GET-RAHS/2022-2024_Sockeye/Solar Car 2022-2024/New Suspension/Rear Suspension/PerformanceLog.txt

Number of Contacts: 0
Number of contact data: 0
