GET-RAHS/2022-2024_Sockeye/Solar Car 2022-2024/Wheels/Nomura hubs.pdf

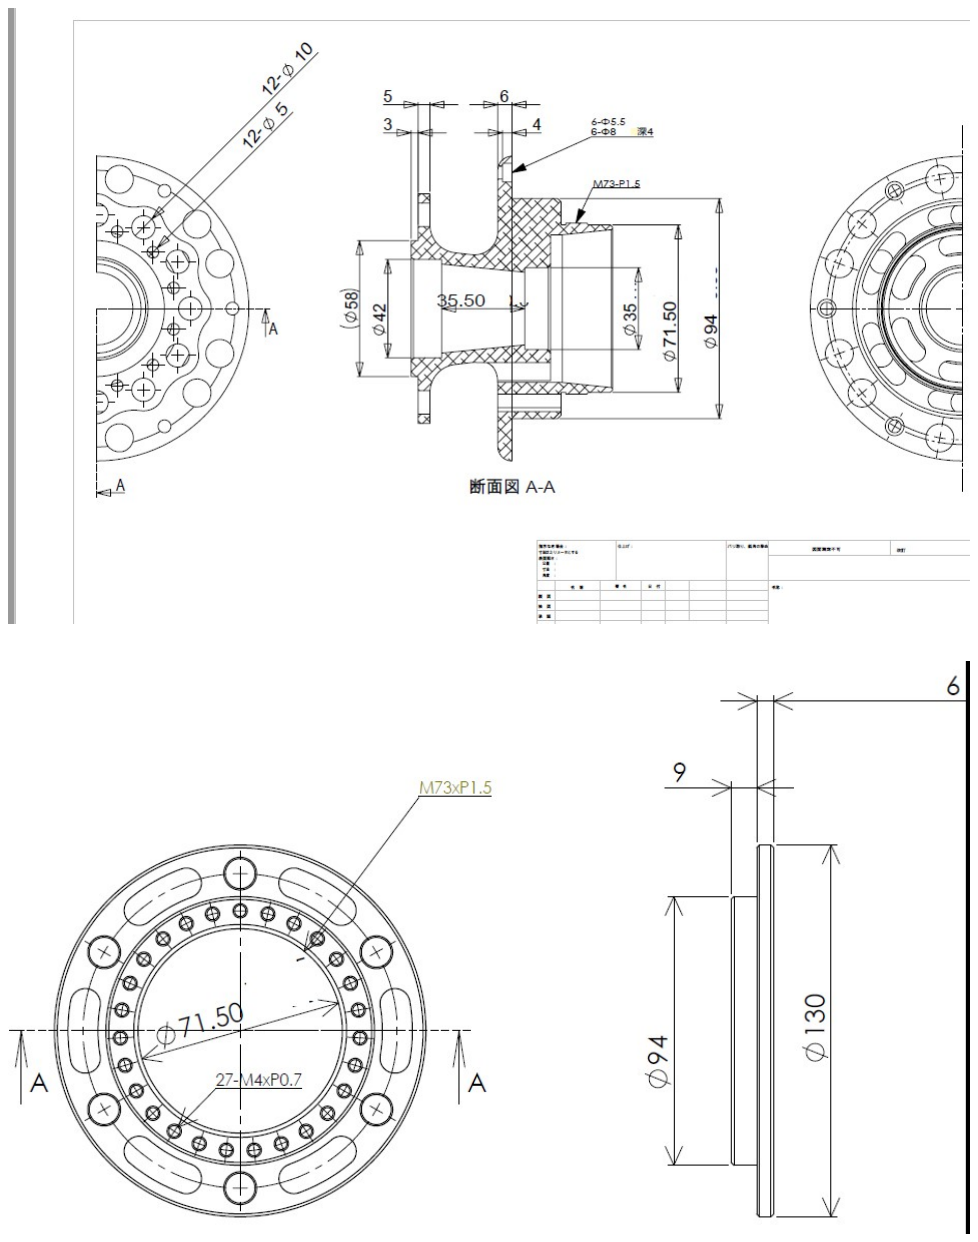
[picture p3: page 1]

standard spindle
Using bearing : outer side is 6003ZZ / inner side is 6004ZZ

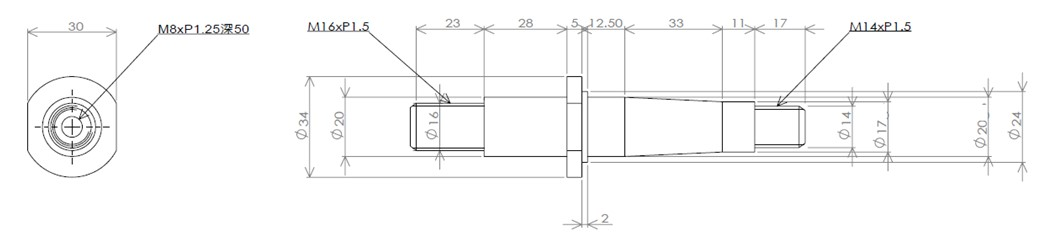
[picture p4: figure]

bigger type spindle
Using bearing : outer side is 6003ZZ / inner side is 6905ZZ

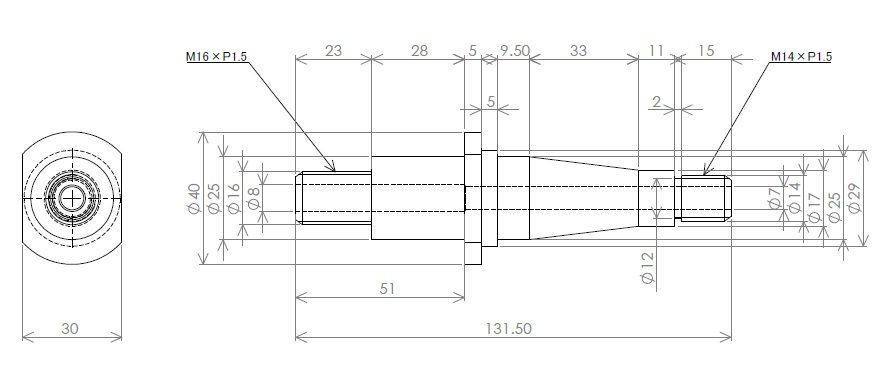
[picture p5: figure]
