GET-RAHS/2022-2024_Sockeye/Solar Car 2022-2024/SolarPanels/tape holes.pdf

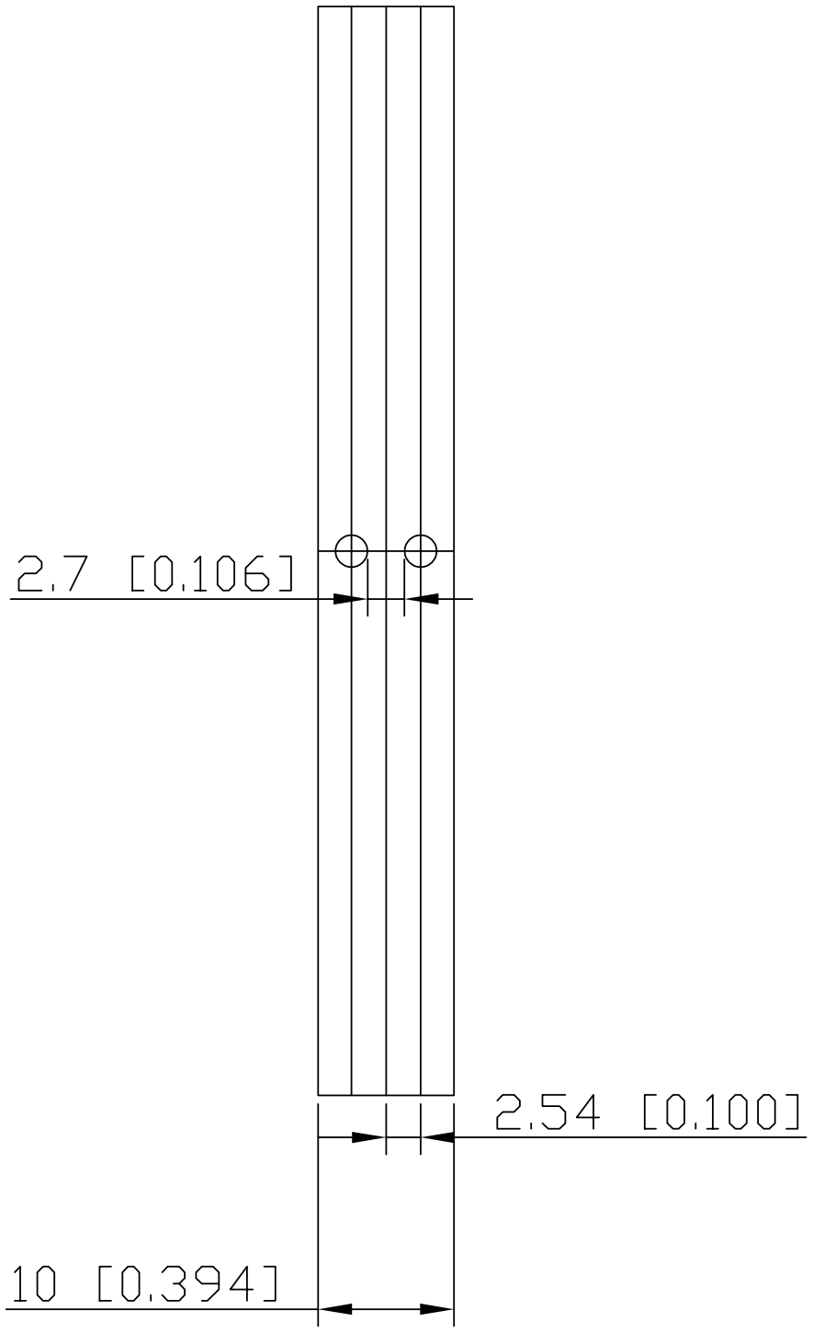
[picture p6: figure]
