GET-RAHS/2022-2024_Sockeye/Solar Car 2022-2024/Frame/carbon angles.pdf

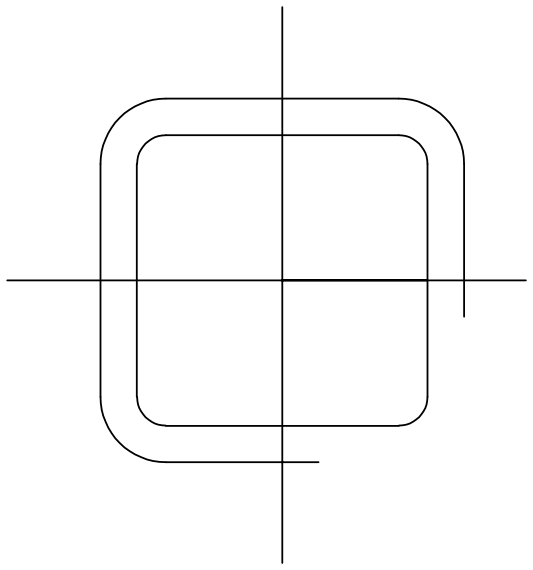
[picture p7: figure]
