GET-RAHS/2022-2024_Sockeye/Solar Car 2022-2024/Stay Hinge/mid.pdf

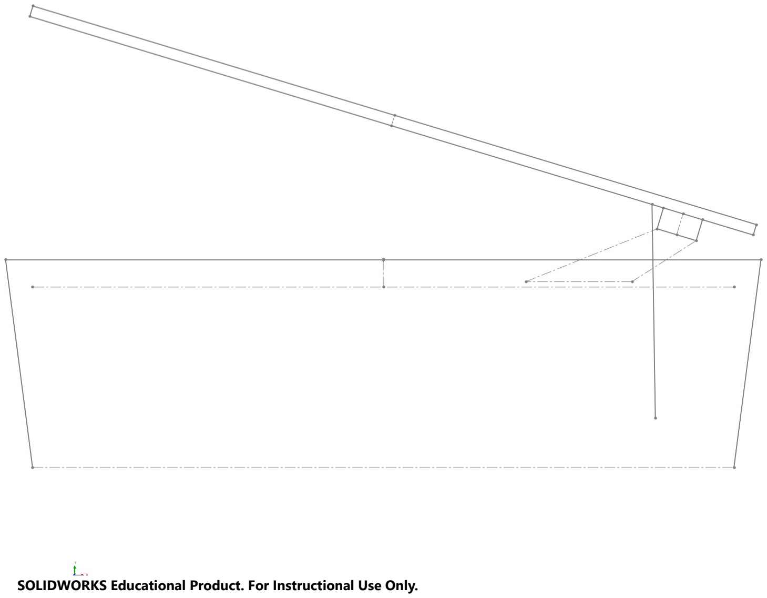
[picture p9: page 1]

SOLIDWORKS Educational Product. For Instructional Use Only.
