GET-RAHS/2022-2024_Sockeye/Solar Car 2022-2024/Stay Hinge/open nd.pdf

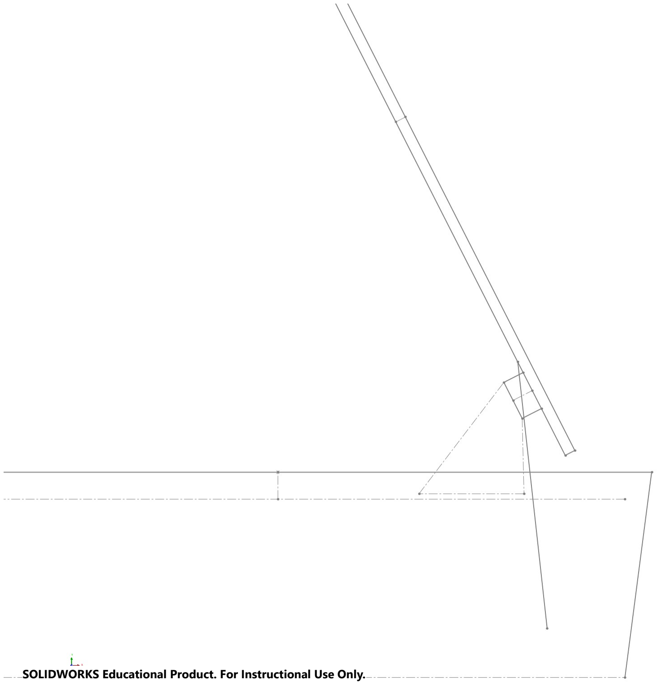
[picture p10: page 1]

SOLIDWORKS Educational Product. For Instructional Use Only.
