GET-RAHS/2022-2024_Sockeye/Solar Car 2022-2024/Wheels/Wheels2023/Rim 13.2 image.pdf

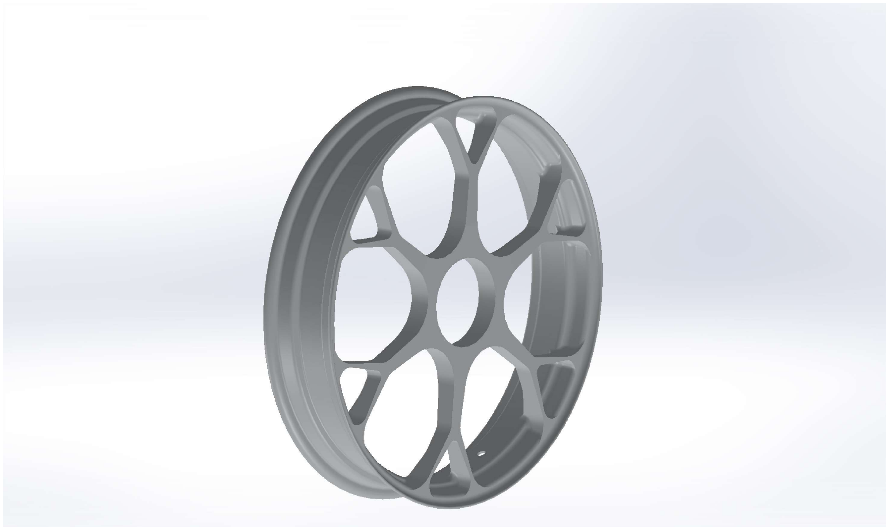
[picture p12: page 1]
