GET-RAHS/2022-2024_Sockeye/Solar Car 2022-2024/New Suspension/Front Suspension/Assy7/Assy dimensions.pdf

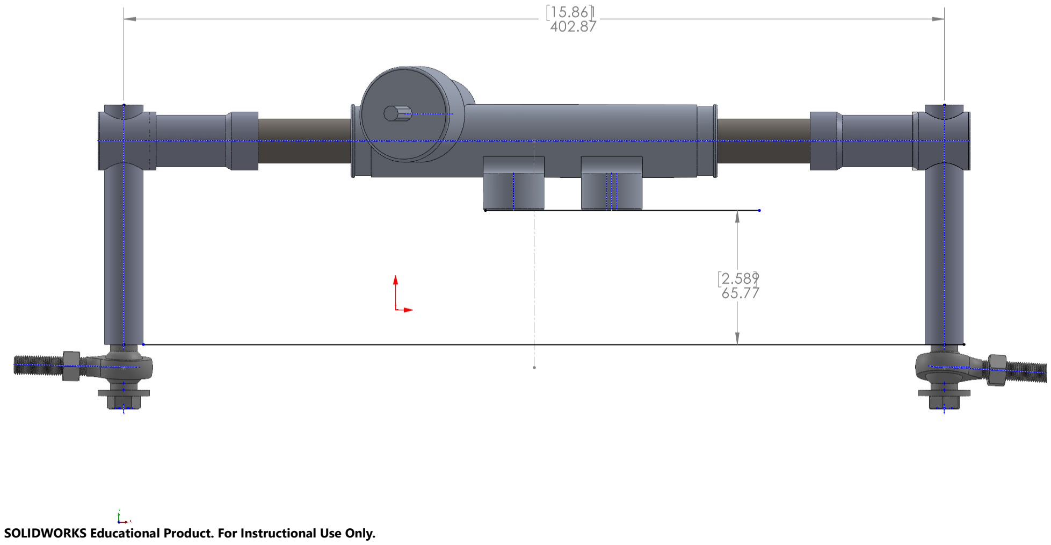
[picture p13: page 1]

SOLIDWORKS Educational Product. For Instructional Use Only.
