GET-RAHS/2022-2024_Sockeye/Solar Car 2022-2024/Pictures/FrontSuspAS1.JPG

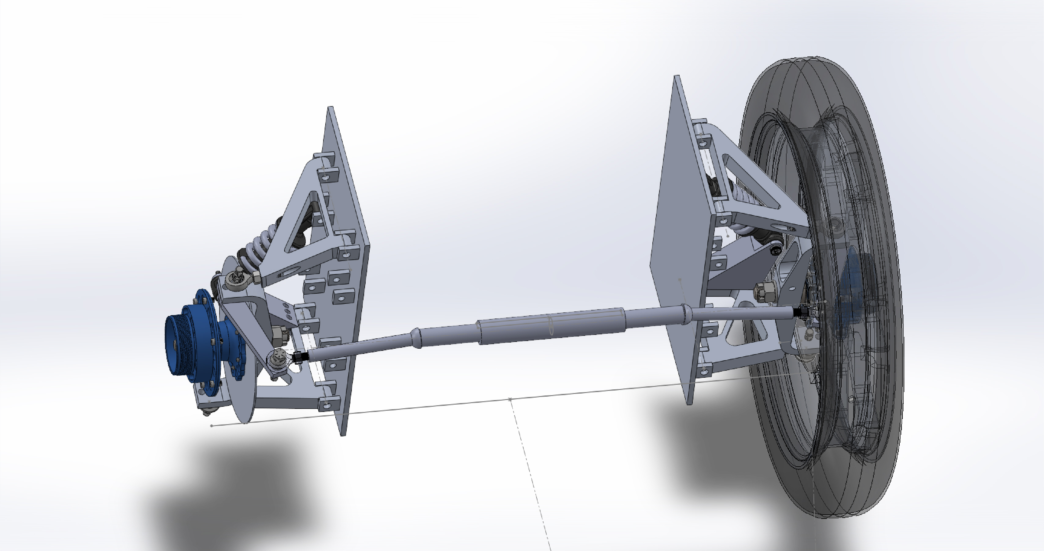
Solar Car 2022-2024/Pictures/FrontSuspAS1.JPG
