GET-RAHS/2022-2024_Sockeye/Solar Car 2022-2024/Pictures/Solar.JPG

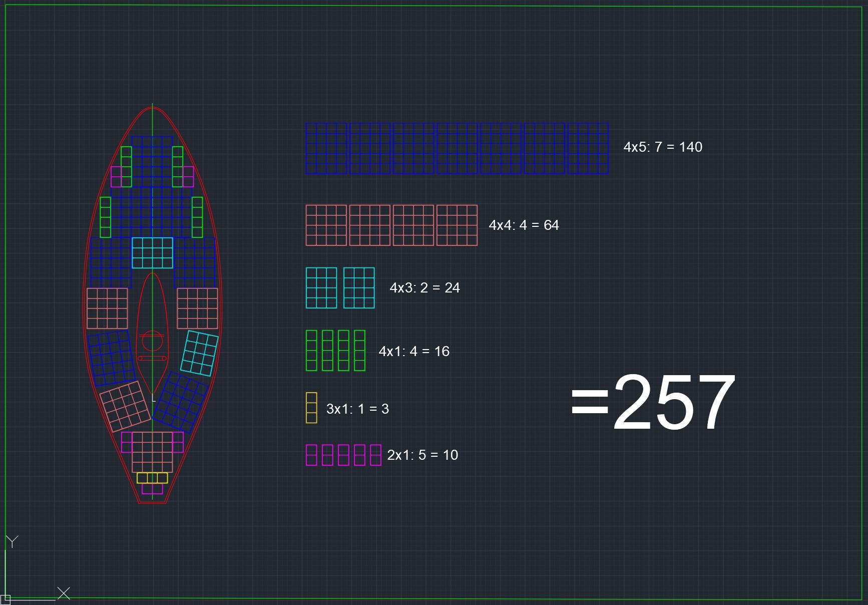
Solar Car 2022-2024/Pictures/Solar.JPG
