GET-RAHS/2022-2024_Sockeye/Solar Car 2022-2024/Progressive steering/Alain Model (Concept)/progressive steering-2/messages_0.jpeg

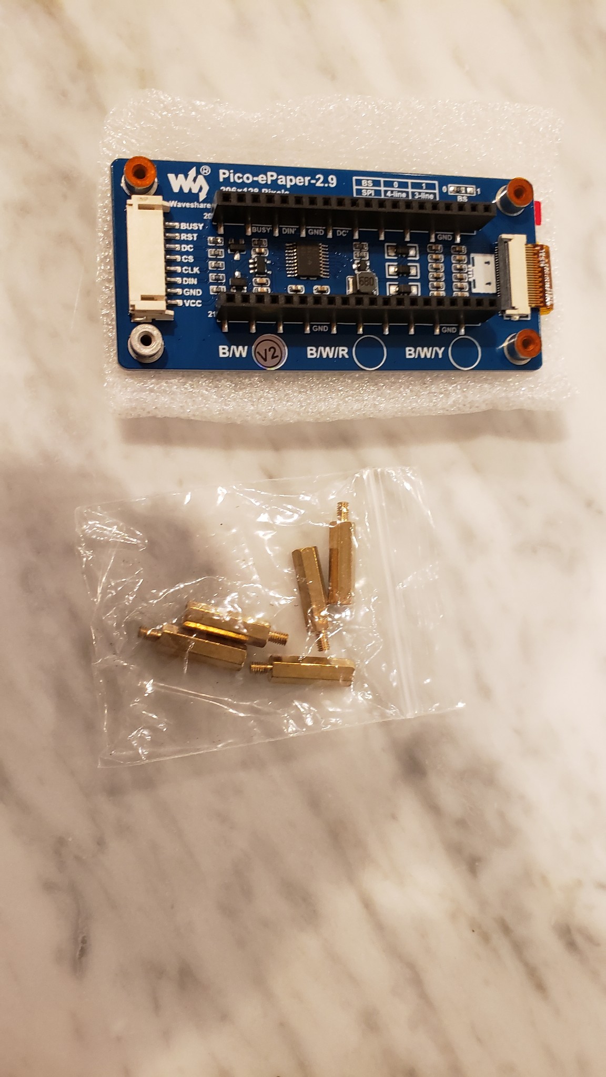
Solar Car 2022-2024/Progressive steering/Alain Model (Concept)/progressive steering-2/messages_0.jpeg
