GET-RAHS/2022-2024_Sockeye/Solar Car 2022-2024/Wheels/mitsuba.jpg

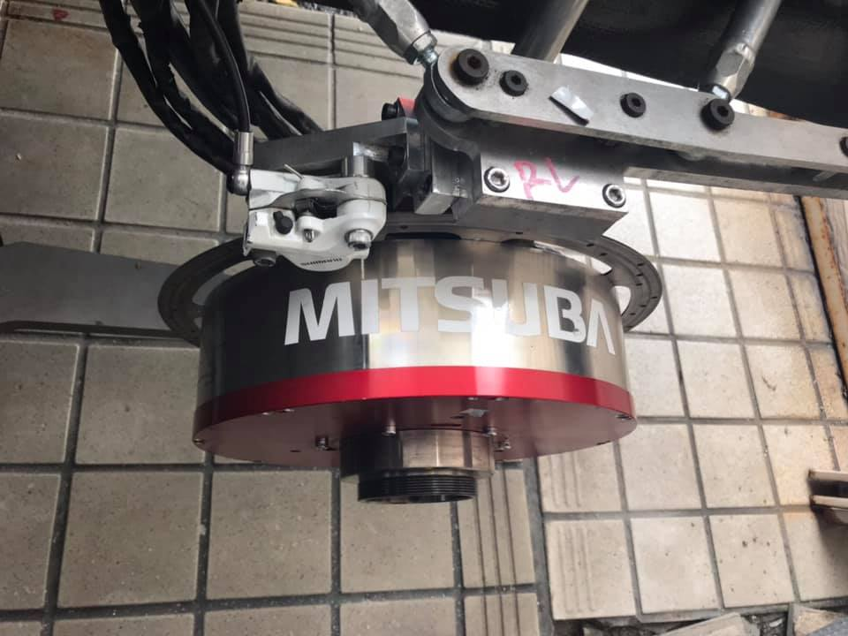
Solar Car 2022-2024/Wheels/mitsuba.jpg
