GET-RAHS/2022-2024_Sockeye/Solar Car 2022-2024/Wheels/Nomura Hubs Replications Hagen/Nomura hubs-images/0002.jpg

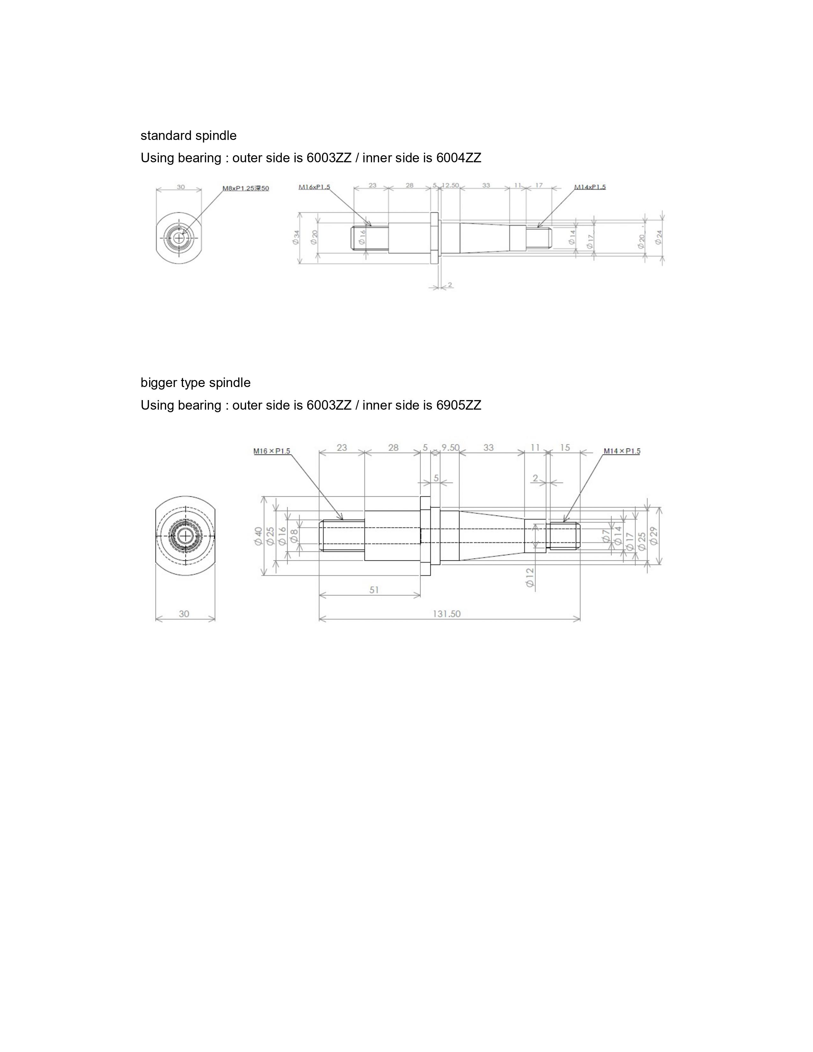
Solar Car 2022-2024/Wheels/Nomura Hubs Replications Hagen/Nomura hubs-images/0002.jpg
