GET-RAHS/2022-2024_Sockeye/Solar Car 2022-2024/Wheels/TwenteWheel.png

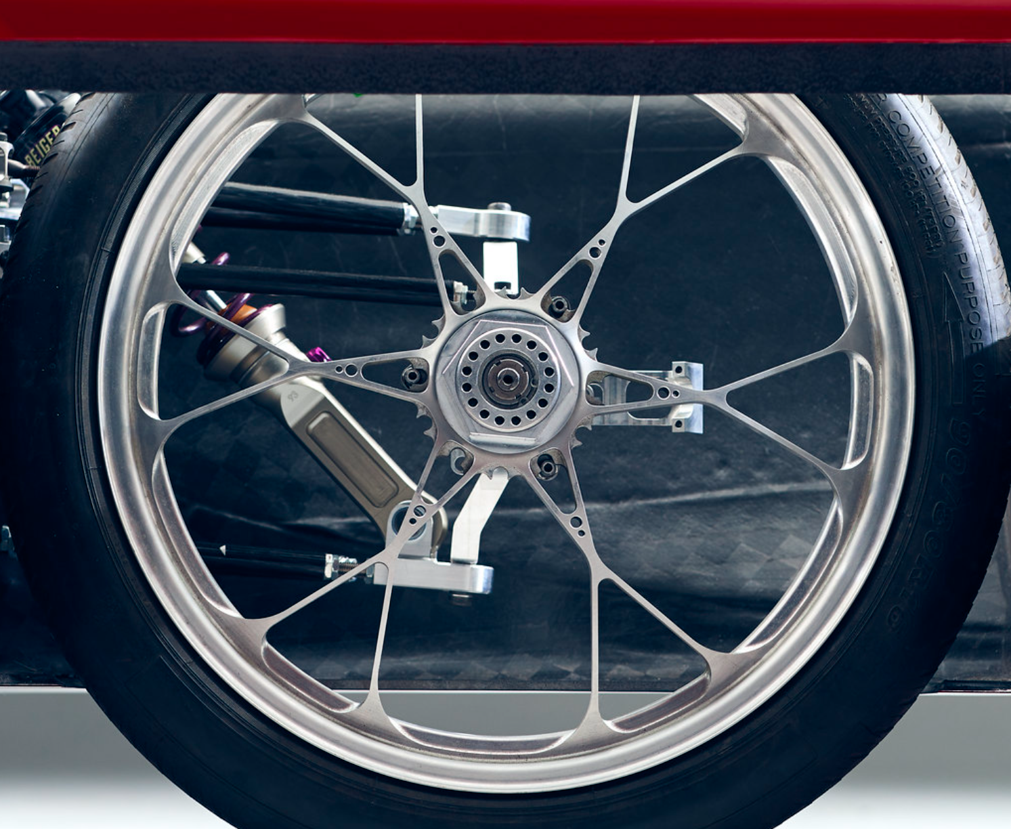
Solar Car 2022-2024/Wheels/TwenteWheel.png
