GET-RAHS/2022-2024_Sockeye/Solar Car 2022-2024/Parts To Be Machined/Order #1/Drawings/topview.pdf

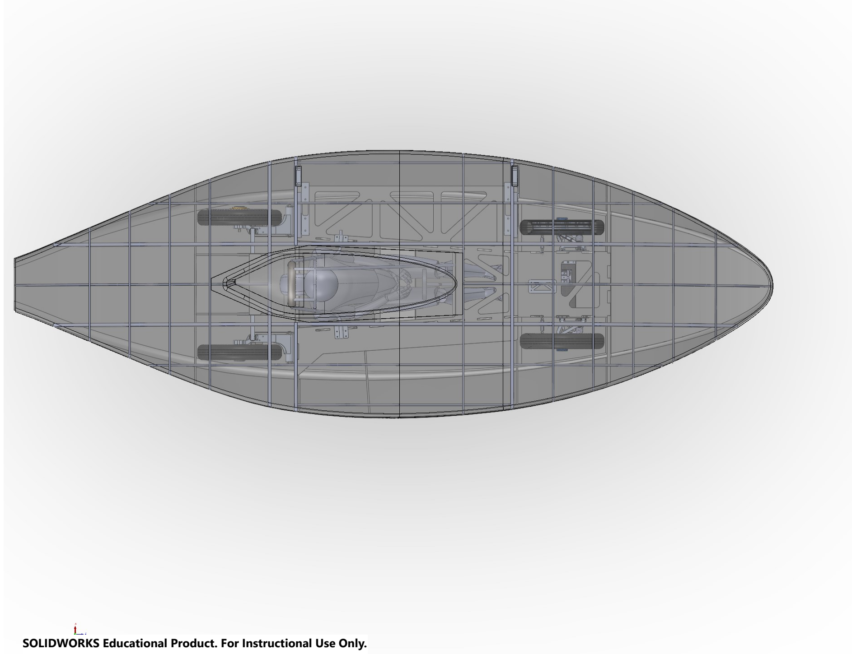
[picture p28: page 1]

SOLIDWORKS Educational Product. For Instructional Use Only.
