GET-RAHS/2022-2024_Sockeye/Solar Car 2022-2024/Parts To Be Machined/Carbon Board Cut/20230208_160809.jpg

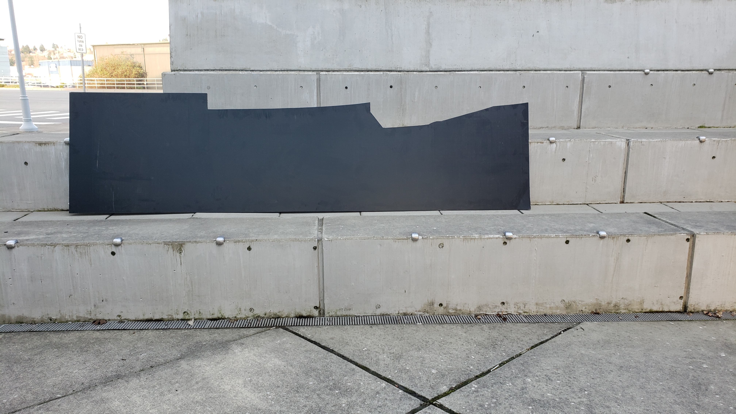
Solar Car 2022-2024/Parts To Be Machined/Carbon Board Cut/20230208_160809.jpg
