GET-RAHS/2022-2024_Sockeye/Solar Car 2022-2024/Parts To Be Machined/Order #1/Drawings/PDF Images/topviewf58c80f2.png

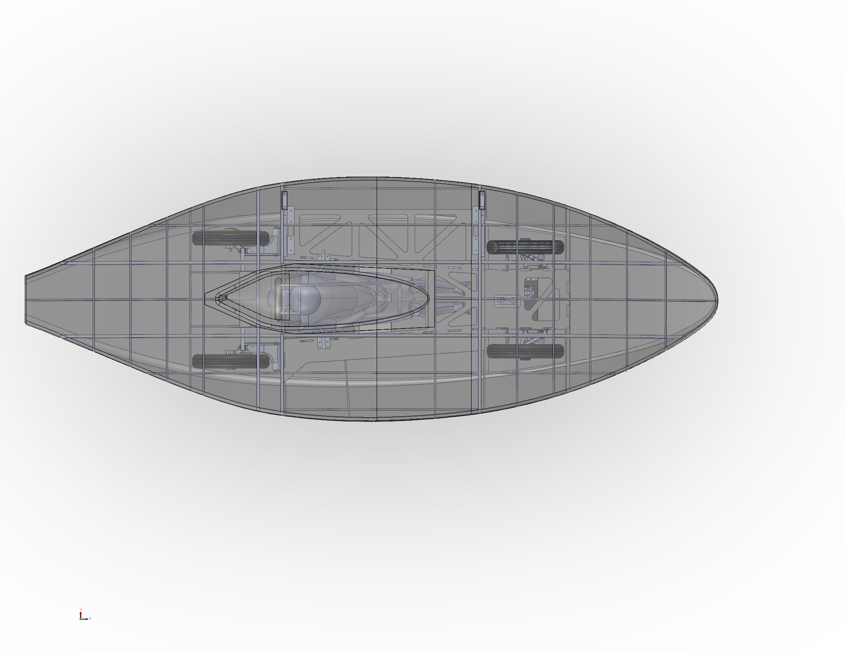
Solar Car 2022-2024/Parts To Be Machined/Order #1/Drawings/PDF Images/topviewf58c80f2.png
