GET-RAHS/2022-2024_Sockeye/Solar Car 2022-2024/Aerodynamic Models/Aero Model Final/ArrayRibsASSY.SLDASM

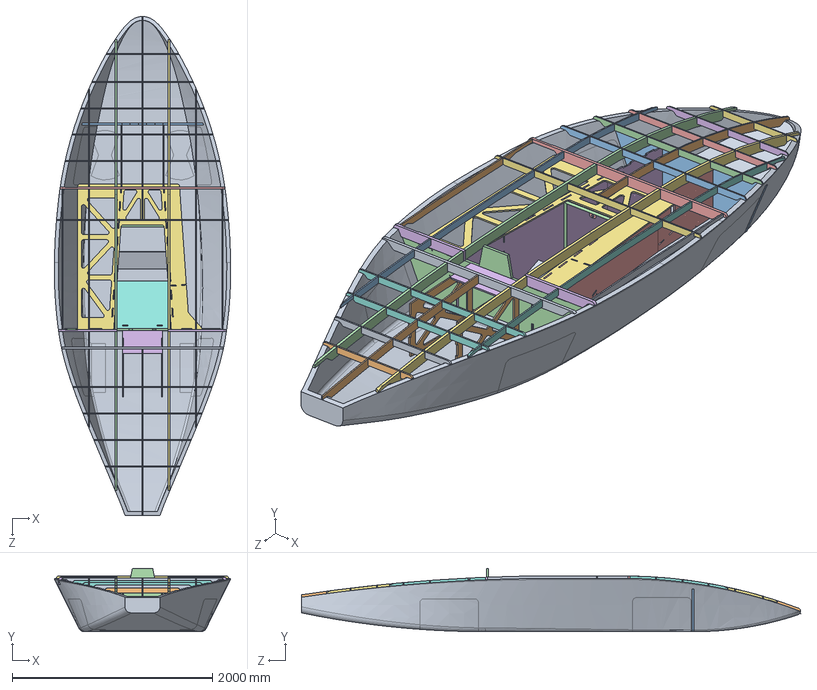
[picture p31: CAD file, 2023-08-19]
Solar Car 2022-2024/Aerodynamic Models/Aero Model Final/ArrayRibsASSY.SLDASM
1764.1 x 634.3 x 4989.8 mm
V4 Bottom Mold Array Layup
Floor Panel
Front Bulkhead
Rearward Bulkhead
MirrorPart11
Battery Side Holder x 2
Battery Tray
Part5^Interior Frame
Part6^Interior Frame
Part1^Interior Frame
Part2^Array Layout
Part3^Array Layout
Part4^Array Layout
MirrorPart4^Array Layout
MirrorPart3^Array Layout
MirrorPart2^Array Layout
Part9^Array Layout
Part10^Array Layout
Part11^Array Layout
Part12^Array Layout
Part5^Array Layout
Part1^Array Layout
Part6^Array Layout
Part7^Array Layout
Part8^Array Layout
Part13^Array Layout
Part14^Array Layout
Part15^Array Layout
Part16^Array Layout
Part17^Array Layout
