GET-RAHS/2022-2024_Sockeye/Solar Car 2022-2024/Array Components/Array Locking Mechanism/OutsideHandle/arrayunlockhandle.SLDASM

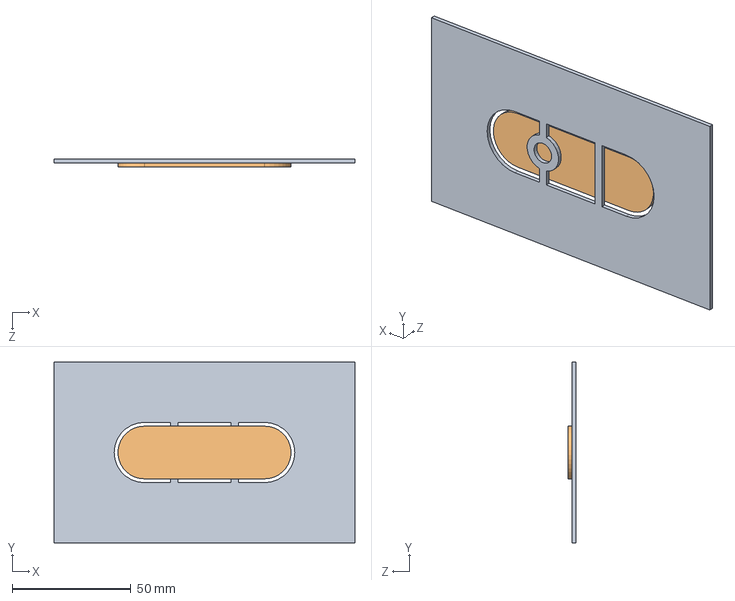
[picture p32: CAD file, 2023-08-19]
Solar Car 2022-2024/Array Components/Array Locking Mechanism/OutsideHandle/arrayunlockhandle.SLDASM
127.0 x 76.2 x 3.17 mm
InnerPlate
OuterPlate
