GET-RAHS/2022-2024_Sockeye/Solar Car 2022-2024/BallDrive/WTF1530_3ZZ_90LC7T_000.sldasm

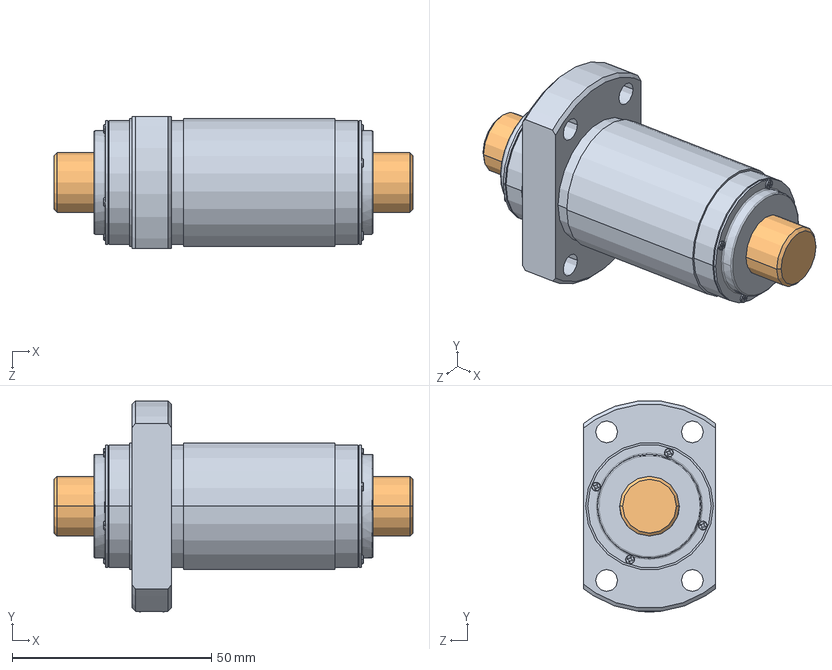
[picture p33: CAD file, 2023-08-19]
Solar Car 2022-2024/BallDrive/WTF1530_3ZZ_90LC7T_000.sldasm
90.0 x 52.8 x 33.0 mm
WTF1530_3ZZ_90LC7T_000_3
WTF1530_3ZZ_90LC7T_000_5
