GET-RAHS/2022-2024_Sockeye/Solar Car 2022-2024/dashboard/Dashboard.SLDASM

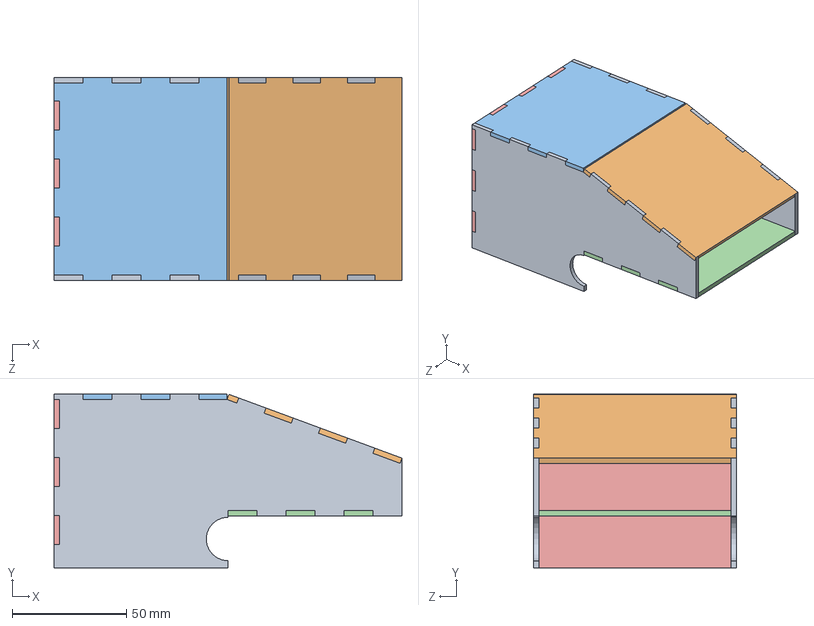
[picture p34: CAD file, 2023-08-19]
Solar Car 2022-2024/dashboard/Dashboard.SLDASM
152.4 x 76.2 x 88.9 mm
side x 2
Part3^Dashboard
Part4^Dashboard
Part5^Dashboard
Part6^Dashboard
