GET-RAHS/2022-2024_Sockeye/Solar Car 2022-2024/Destructive Testing/Supported Pullthrough Test/Supported Pullthrough Test.SLDASM

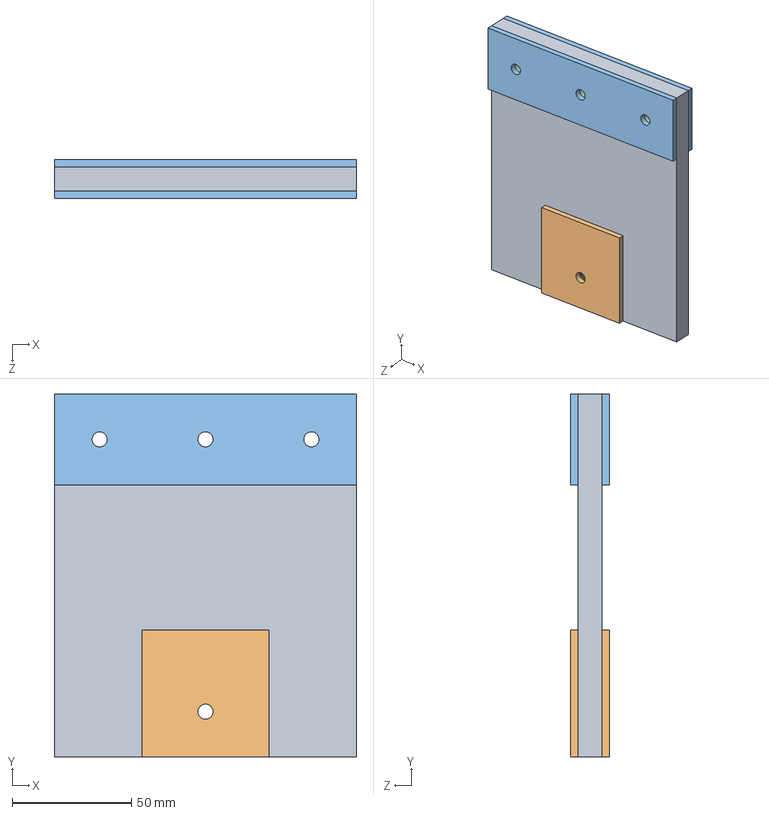
[picture p35: CAD file, 2023-08-19]
Solar Car 2022-2024/Destructive Testing/Supported Pullthrough Test/Supported Pullthrough Test.SLDASM
127.0 x 152.4 x 16.5 mm
Carbon Coupon
Part20^Supported Pullthrough Test x 2
Tie down Bracket x 2
Insert x 4
