GET-RAHS/2022-2024_Sockeye/Solar Car 2022-2024/Destructive Testing/Unsupported Pullthrough Test/Unsupported Pullthrough Test.SLDASM

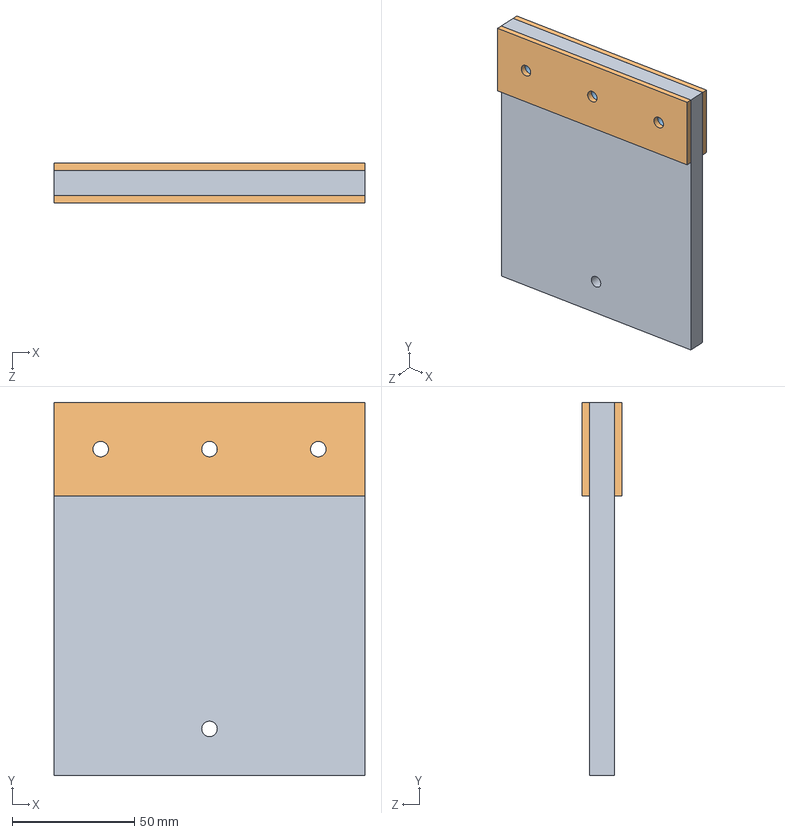
[picture p36: CAD file, 2023-08-19]
Solar Car 2022-2024/Destructive Testing/Unsupported Pullthrough Test/Unsupported Pullthrough Test.SLDASM
127.0 x 152.4 x 16.5 mm
Carbon Coupon
Part21^Unsupported Pullthrough Test x 2
Insert x 3
