GET-RAHS/2022-2024_Sockeye/Solar Car 2022-2024/Mock Parts/Gas Pedal/Gas Pedal Assembly.SLDASM

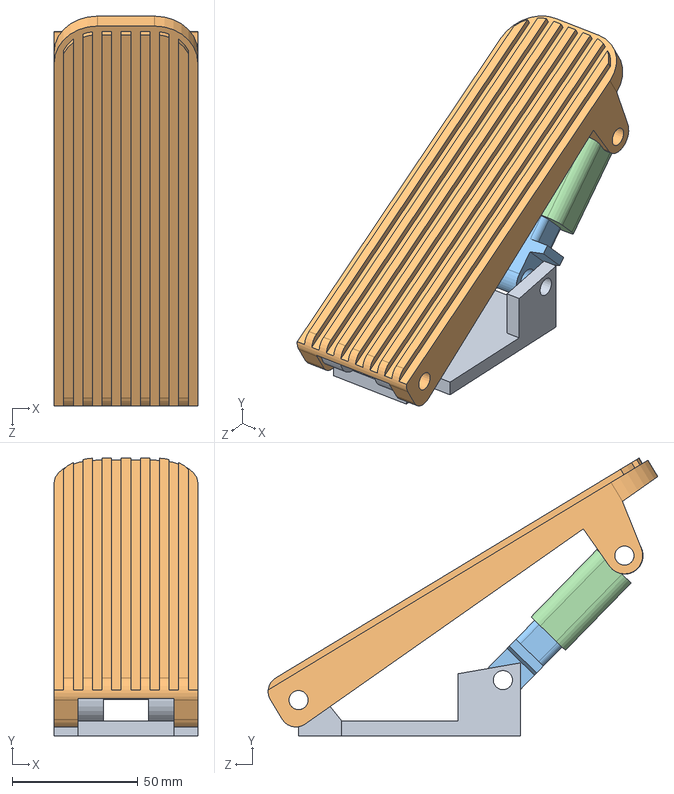
[picture p37: CAD file, 2023-08-19]
Solar Car 2022-2024/Mock Parts/Gas Pedal/Gas Pedal Assembly.SLDASM
57.1 x 110.6 x 155.0 mm
Pedal Mount Bracket
Pedal Face
Sensor Bottm
Sensor Top
