GET-RAHS/2022-2024_Sockeye/Solar Car 2022-2024/New Suspension/Brakes/Caliper Assembly.SLDASM

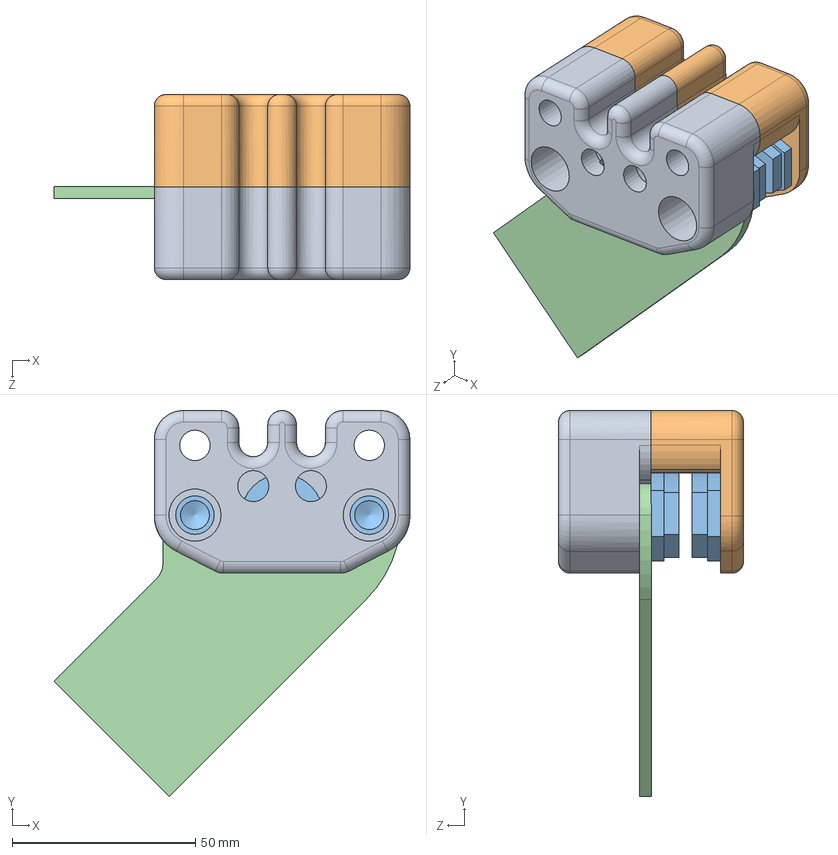
[picture p38: CAD file, 2023-08-19]
Solar Car 2022-2024/New Suspension/Brakes/Caliper Assembly.SLDASM
97.2 x 105.5 x 50.5 mm
Caliper A v2.ipt
Caliper B v9.ipt
MCP 554 Pads v5.ipt x 2
MCP FWB caliper mounting bracket v1.ipt
