GET-RAHS/2022-2024_Sockeye/Solar Car 2022-2024/New Suspension/Front Suspension/Assembly1/Shock.SLDASM

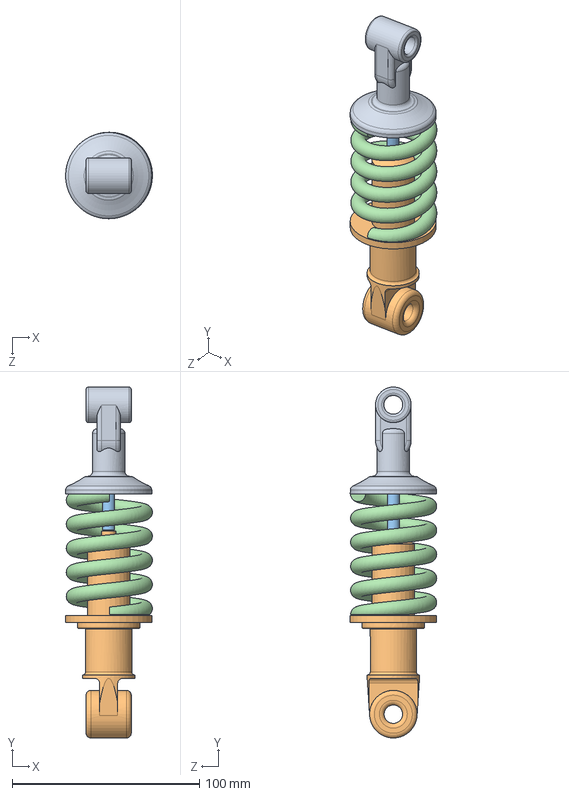
[picture p39: CAD file, 2023-08-19]
Solar Car 2022-2024/New Suspension/Front Suspension/Assembly1/Shock.SLDASM
46.3 x 187.2 x 46.2 mm
Shock Anchor_11
Shock Tube 1_11
Shock Absorber Rod_11
Shock Spring_11
