GET-RAHS/2022-2024_Sockeye/Solar Car 2022-2024/New Suspension/Rear Suspension/Rear Tube Round Suspension/Assembly/Rear Round Tube Assembly.SLDASM

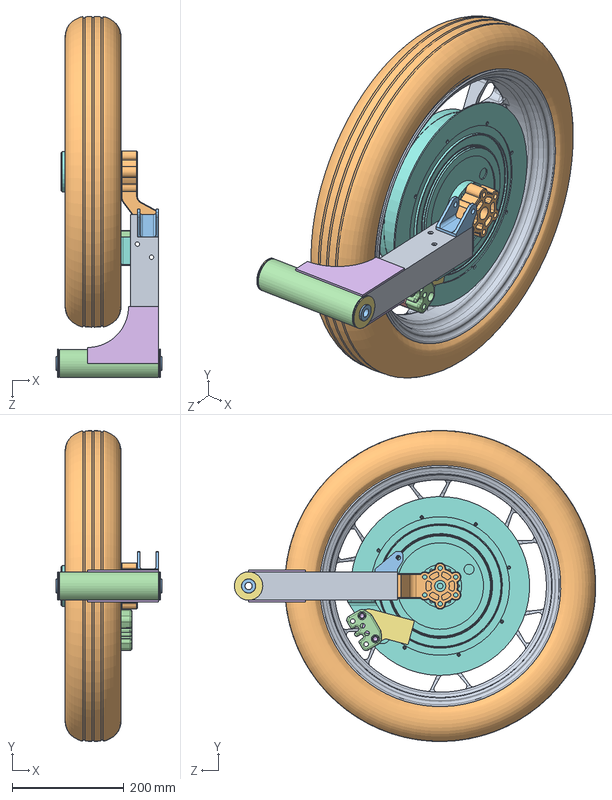
[picture p40: CAD file, 2023-08-19]
Solar Car 2022-2024/New Suspension/Rear Suspension/Rear Tube Round Suspension/Assembly/Rear Round Tube Assembly.SLDASM
190.5 x 556.5 x 646.4 mm
Rear Torque Tube
Rear Cap insert
Rear Brake Bracket
Rear Round Tube
Half Moon Bracket
Rear Gusset x 2
Rear End Cap x 2
Motor Mitsuba M2096 D-III
6338K423_Oil-Embedded Flanged Sleeve Bearing (1) x 2
Caliper A v2.ipt
Caliper B v9.ipt
MCP 554 Pads v5.ipt x 2
Right Rear Brake Bracket
