GET-RAHS/2022-2024_Sockeye/Solar Car 2022-2024/New Suspension/Rear Suspension/Rear Tube Round Suspension/Parts/SKF_6004-2Z.stp.SLDASM

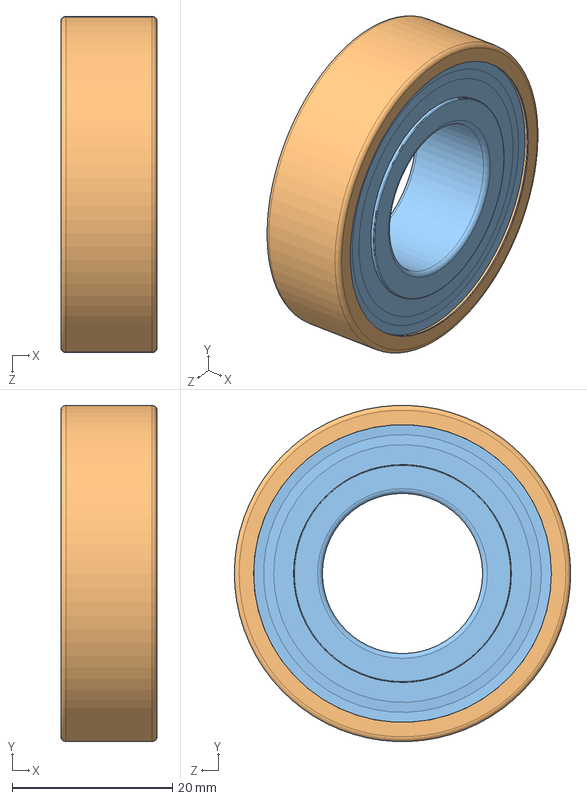
[picture p41: CAD file, 2023-08-19]
Solar Car 2022-2024/New Suspension/Rear Suspension/Rear Tube Round Suspension/Parts/SKF_6004-2Z.stp.SLDASM
12.0 x 42.0 x 42.0 mm
SKF_6004-2Z_PART3.stp x 9
SKF_6004-2Z_PART2.stp
SKF_6004-2Z_PART1.stp
