GET-RAHS/2022-2024_Sockeye/Solar Car 2022-2024/New Suspension/Rear Suspension/Rear Tube Suspension/Assembly/Rear Motor Arm Assembly.SLDASM

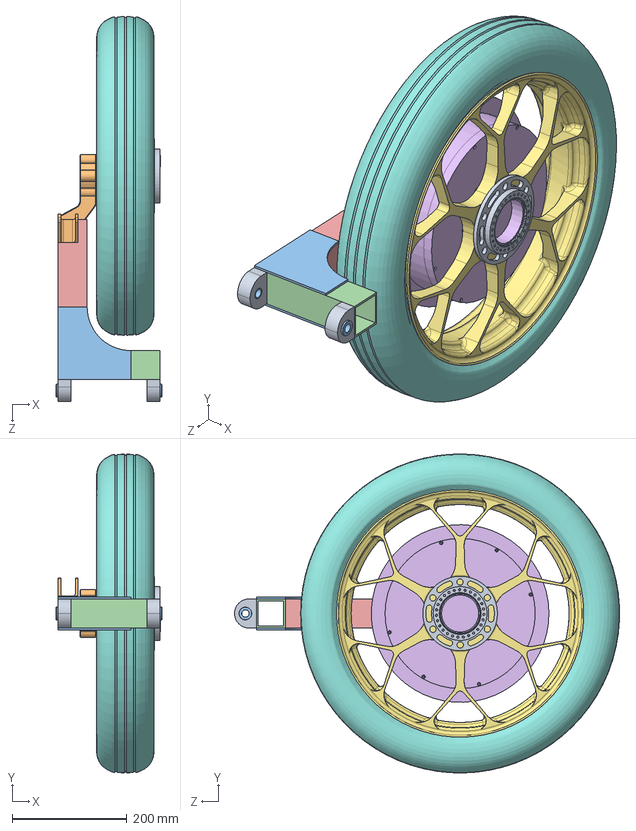
[picture p42: CAD file, 2023-08-19]
Solar Car 2022-2024/New Suspension/Rear Suspension/Rear Tube Suspension/Assembly/Rear Motor Arm Assembly.SLDASM
184.1 x 556.5 x 671.8 mm
Hinge x 2
Cap insert
Bracket Plate x 2
Rear Tube
Torque Tube
Motor Mitsuba M2096 D-III
rimmachined13
Michelin Tire
Nut
Brake Bracket
6338K421_Oil-Embedded Flanged Sleeve Bearing x 2
