GET-RAHS/2022-2024_Sockeye/Solar Car 2022-2024/New Suspension/Rear Suspension/rigid axle/rearsusptest.SLDASM

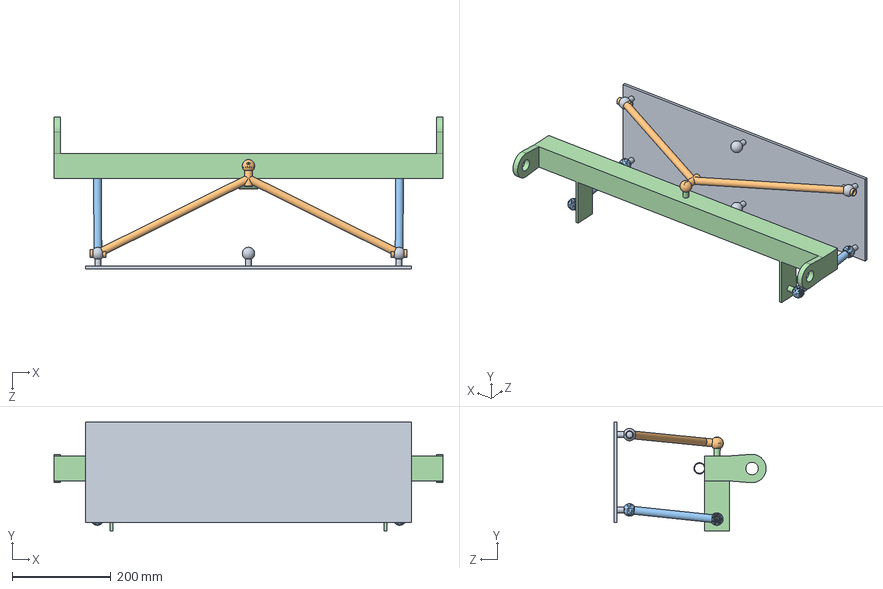
[picture p43: CAD file, 2023-08-19]
Solar Car 2022-2024/New Suspension/Rear Suspension/rigid axle/rearsusptest.SLDASM
787.4 x 220.3 x 308.3 mm
rearsuspplate
rearsusptriangle
rearsusplink x 2
rearsuspbar
