GET-RAHS/2022-2024_Sockeye/Solar Car 2022-2024/Progressive steering/3d printed model, curved rack/progressive steering.SLDASM

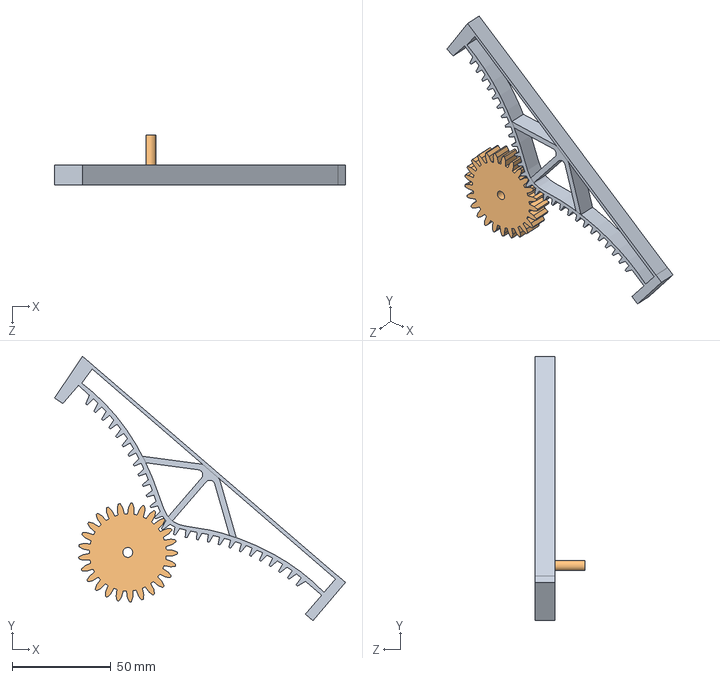
[picture p44: CAD file, 2023-08-19]
Solar Car 2022-2024/Progressive steering/3d printed model, curved rack/progressive steering.SLDASM
147.1 x 133.7 x 25.2 mm
progressive steering rack
elipsed gear
