GET-RAHS/2022-2024_Sockeye/Solar Car 2022-2024/Progressive steering/normal rack model/v2/ProgressiveSteering.SLDASM

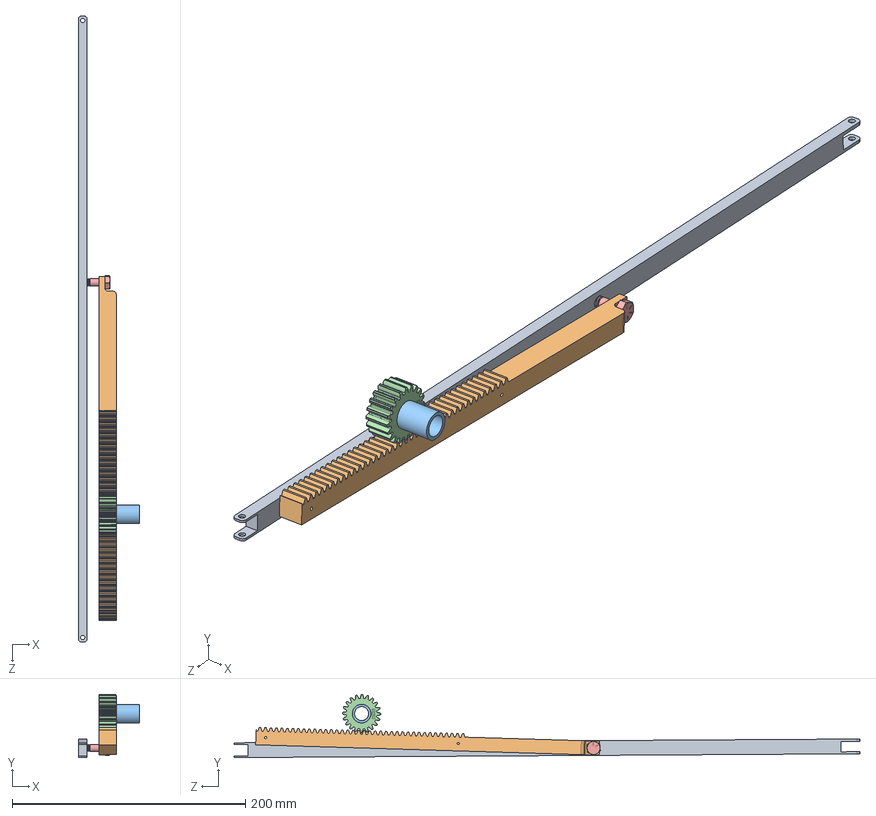
[picture p45: CAD file, 2023-08-19]
Solar Car 2022-2024/Progressive steering/normal rack model/v2/ProgressiveSteering.SLDASM
52.6 x 54.3 x 537.3 mm
steering bar
KHK-US_SRAF1_5-1000.stp
6995N126_Iron-Copper High-Load Oil-Embedded Sleeve Bearing
KHK-US_SSA1_5-20J12.stp
92620A540_Zinc Yellow-Chromate Plated Hex Head Screw
