GET-RAHS/2022-2024_Sockeye/Solar Car 2022-2024/Solar/eggcrate.SLDASM

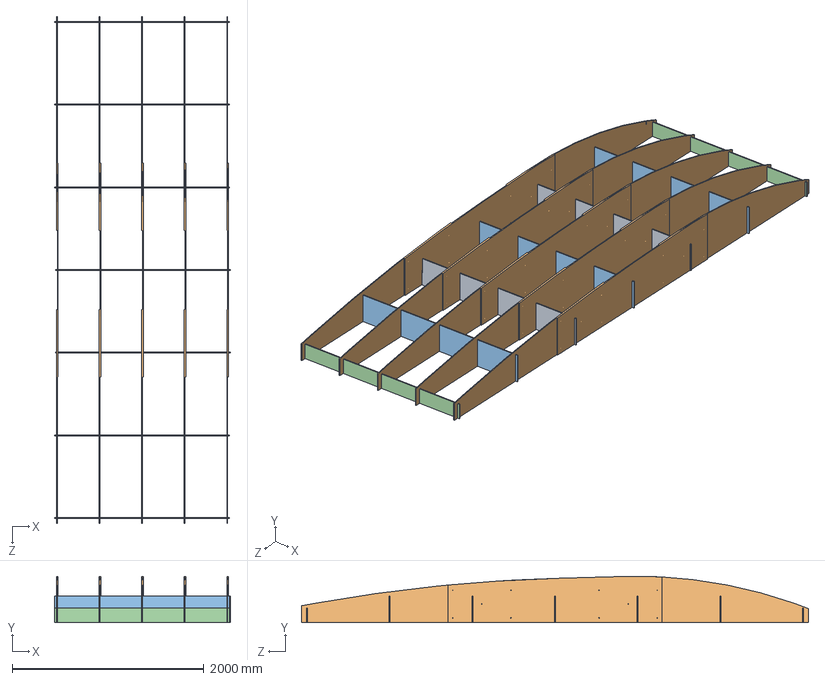
[picture p46: CAD file, 2023-08-19]
Solar Car 2022-2024/Solar/eggcrate.SLDASM
1838.2 x 483.6 x 5291.3 mm
11indouble x 2
thetop(lid x 5
11inrib x 3
3inrib x 2
