GET-RAHS/2022-2024_Sockeye/Solar Car 2022-2024/Wheels/Dismissed/mitsubastanford.SLDASM

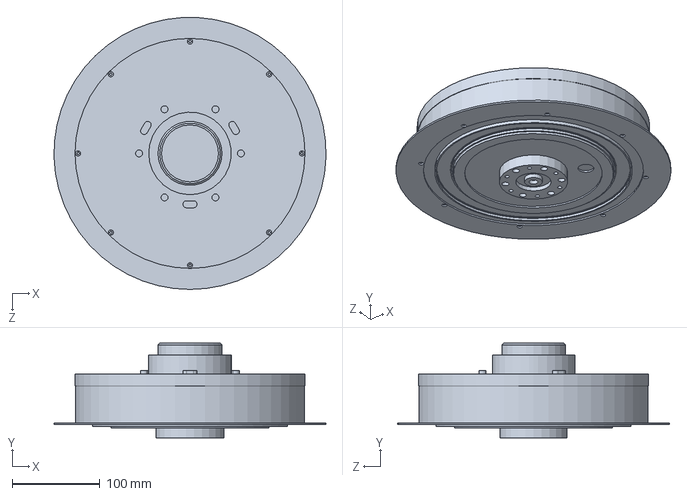
[picture p47: CAD file, 2023-08-19]
Solar Car 2022-2024/Wheels/Dismissed/mitsubastanford.SLDASM
309.9 x 108.0 x 309.7 mm
