GET-RAHS/2022-2024_Sockeye/Solar Car 2022-2024/Pedals/full pedal setup/UpdatedPedalAssembly.SLDASM

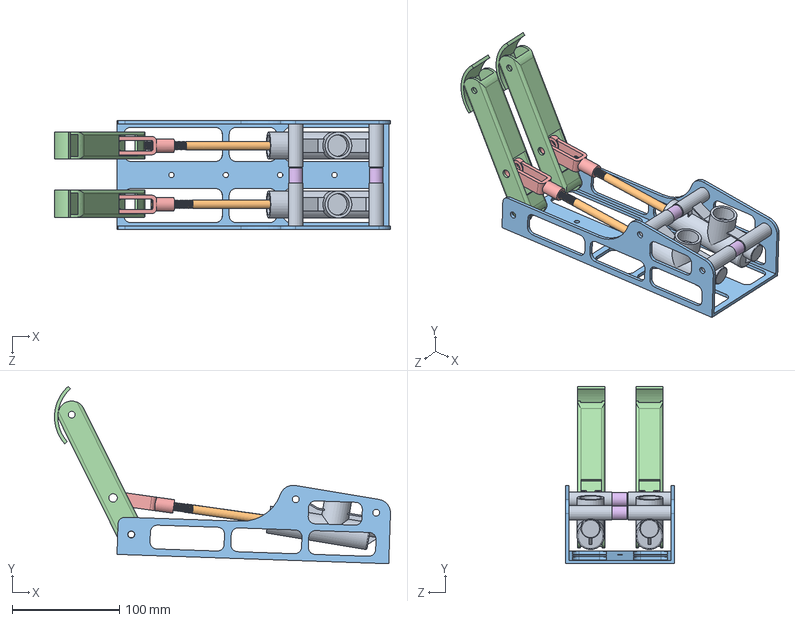
[picture p48: CAD file, 2023-08-19]
Solar Car 2022-2024/Pedals/full pedal setup/UpdatedPedalAssembly.SLDASM
313.8 x 165.7 x 101.6 mm
NewWilwoodMasterCylinder x 2
MCpushrod x 2
Pedal Attatchment Member
brake pedal arm x 2
1583K13_Carbon Steel Corrosion-Resistant Clevis Rod End x 2
BrakePedalSpacer x 2
