GET-RAHS/2022-2024_Sockeye/Solar Car 2022-2024/Progressive steering/Alain Model (Refined)/Assem1.SLDASM

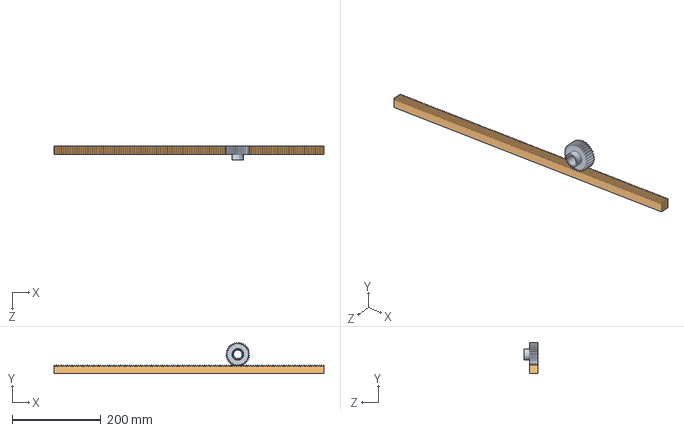
[picture p49: CAD file, 2023-08-19]
Solar Car 2022-2024/Progressive steering/Alain Model (Refined)/Assem1.SLDASM
609.6 x 70.2 x 31.8 mm
5172T23_Metal Gear - 20 Degree Pressure Angle
5174T2_Metal Gear Rack - 20 Degree Pressure Angle
