GET-RAHS/2022-2024_Sockeye/Solar Car 2022-2024/Progressive steering/progressive steering Atticus/v2.1/Assem1.SLDASM

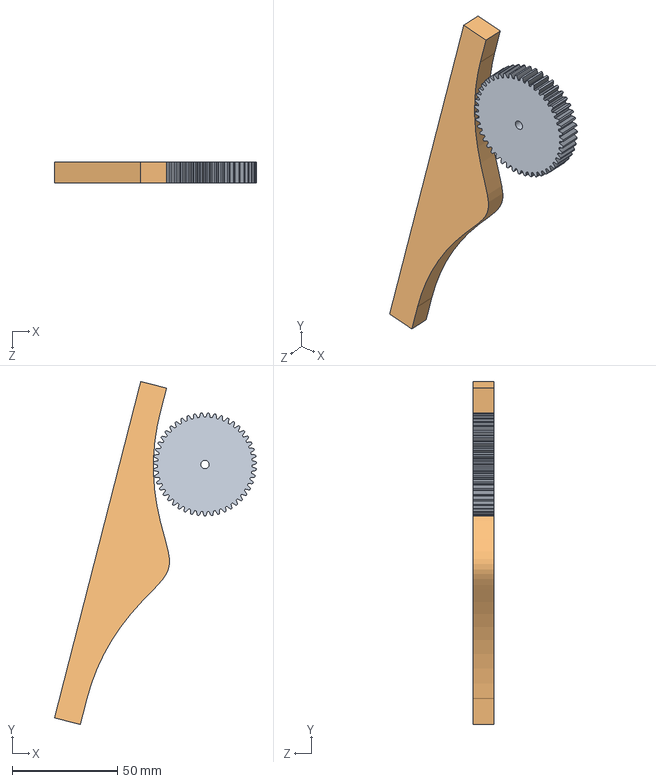
[picture p50: CAD file, 2023-08-19]
Solar Car 2022-2024/Progressive steering/progressive steering Atticus/v2.1/Assem1.SLDASM
96.0 x 163.0 x 10.2 mm
progressive steering gear v2.1
progressive steering rack v2.1
