GET-RAHS/2022-2024_Sockeye/Solar Car 2022-2024/Array Components/Array Locking Mechanism/V4/ArrayLockV4.SLDASM

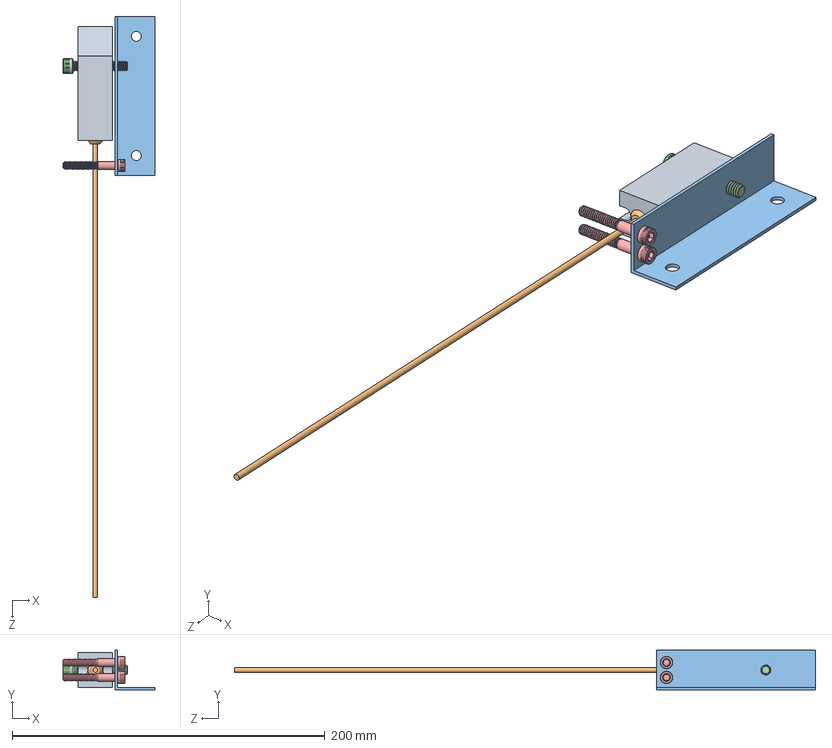
[picture p51: CAD file, 2023-08-19]
Solar Car 2022-2024/Array Components/Array Locking Mechanism/V4/ArrayLockV4.SLDASM
58.7 x 25.4 x 371.4 mm
Delrin
fake string
anglebracket
91251A543_Black-Oxide Alloy Steel Socket Head Screw
91251A250_Black-Oxide Alloy Steel Socket Head Screw x 2
