GET-RAHS/2022-2024_Sockeye/Solar Car 2022-2024/Destructive Testing/Crush Test/Crush Test.SLDASM

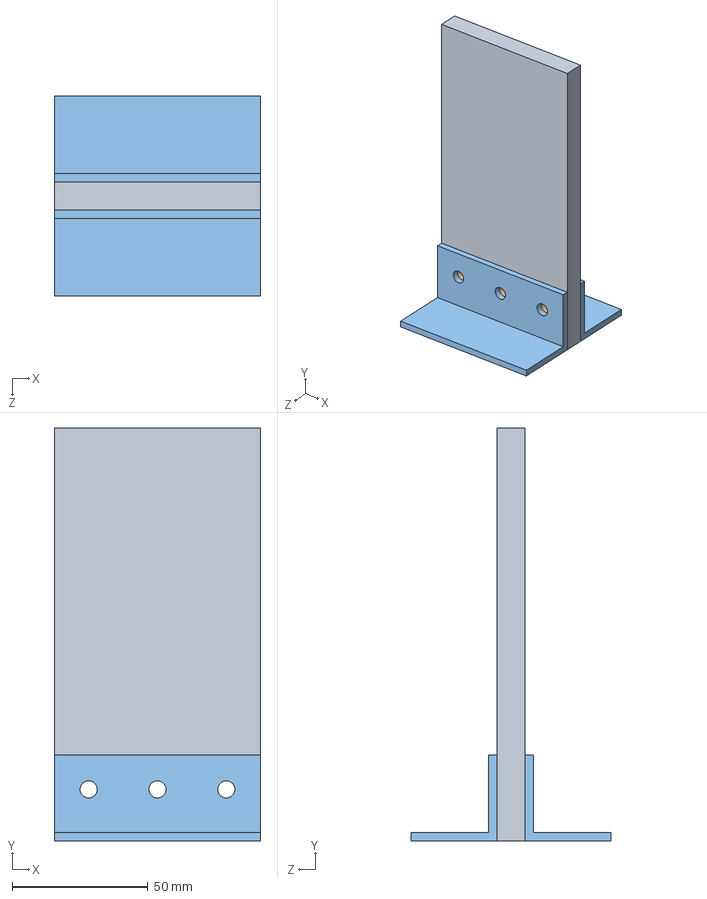
[picture p52: CAD file, 2023-08-19]
Solar Car 2022-2024/Destructive Testing/Crush Test/Crush Test.SLDASM
76.2 x 152.4 x 73.7 mm
Flat Carbon Coupon
Insert x 3
L Bracket x 2
