GET-RAHS/2022-2024_Sockeye/Solar Car 2022-2024/New Suspension/Shock AssemblyMotion.SLDASM

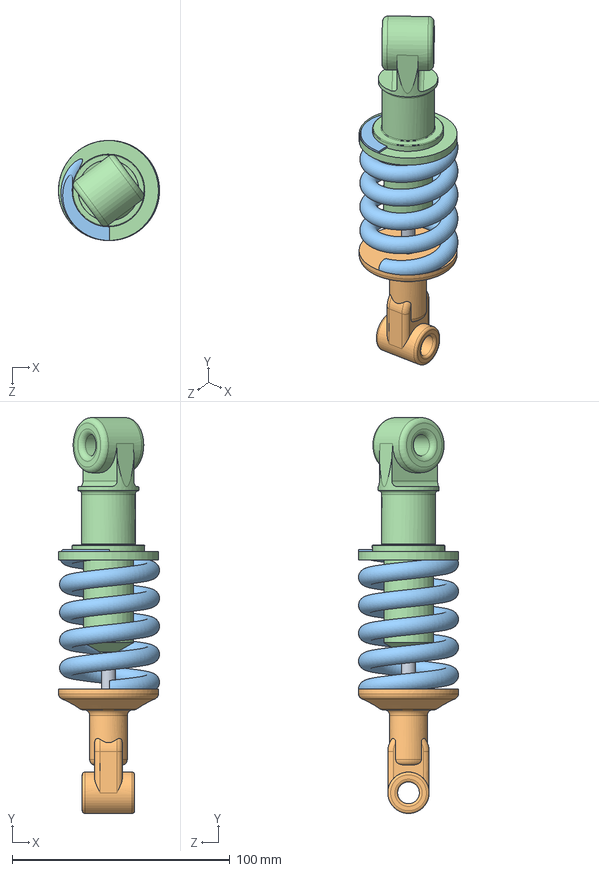
[picture p53: CAD file, 2023-08-19]
Solar Car 2022-2024/New Suspension/Shock AssemblyMotion.SLDASM
46.5 x 182.0 x 46.0 mm
Shock Absorber Rod_11
Shock Anchor_11
Shock Spring_11
Shock Tube 1_11
