GET-RAHS/2022-2024_Sockeye/Solar Car 2022-2024/Pedal Units/Assembly/Full Pedal Assembly.SLDASM

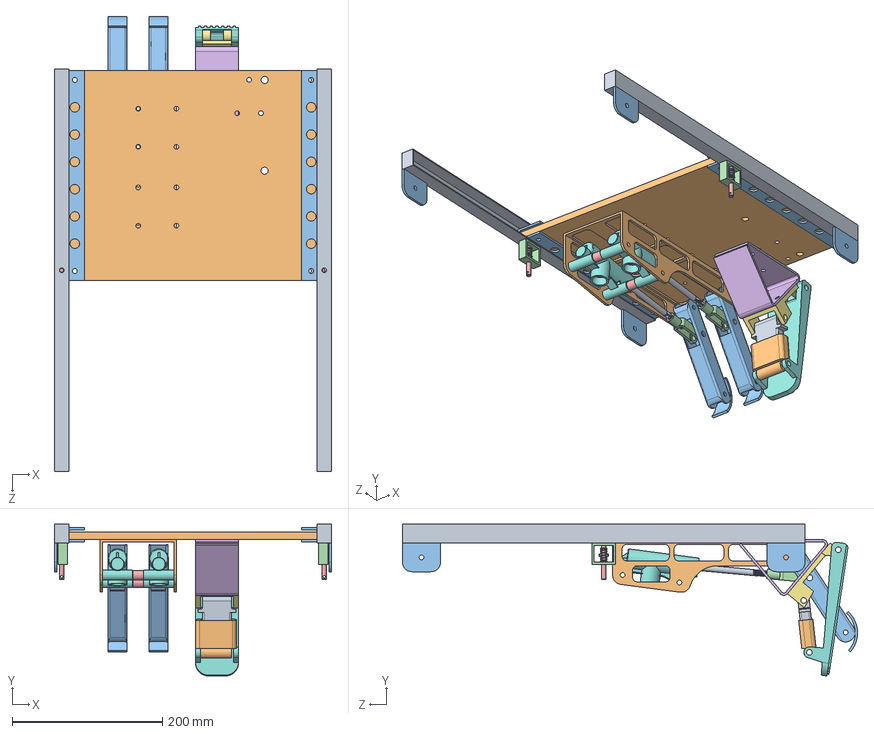
[picture p54: CAD file, 2023-08-19]
Solar Car 2022-2024/Pedal Units/Assembly/Full Pedal Assembly.SLDASM
368.3 x 202.1 x 605.2 mm
Steel Rail x 2
Pedal Holder
Aluminum Support x 2
Spring Capture x 2
Main Pin x 2
Mini Pin x 2
9657K288_Compression Spring x 2
NewWilwoodMasterCylinder x 2
MCpushrod x 2
Pedal Attatchment Member
brake pedal arm x 2
1583K13_Carbon Steel Corrosion-Resistant Clevis Rod End x 2
BrakePedalSpacer x 2
ThrottlePedalMount
Pedal Mount Bracket
Pedal Face
Sensor Bottm
Sensor Top
BrakeSideBracket x 4
