GET-RAHS/2022-2024_Sockeye/Solar Car 2022-2024/Pedal Units/Spring Pin/Pin capture Assembly.SLDASM

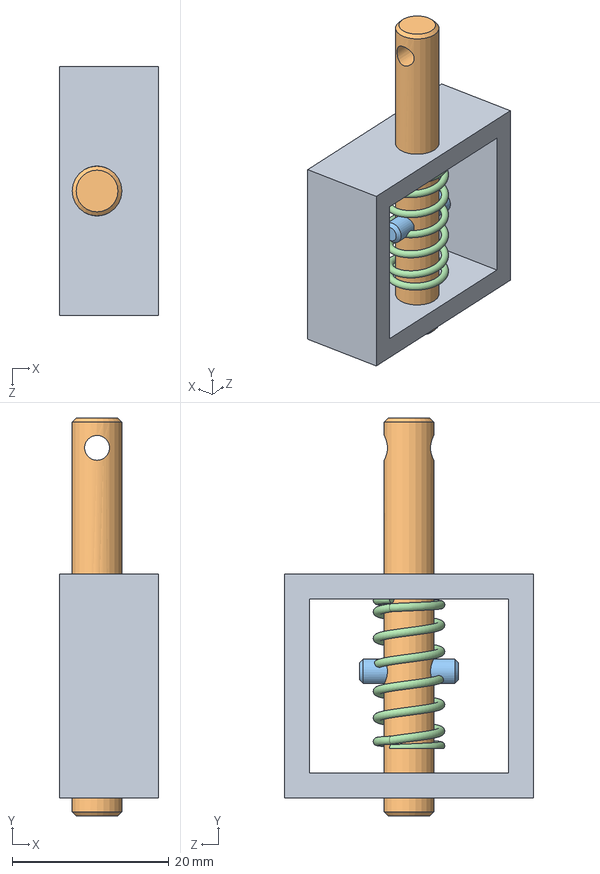
[picture p55: CAD file, 2023-08-19]
Solar Car 2022-2024/Pedal Units/Spring Pin/Pin capture Assembly.SLDASM
12.7 x 50.8 x 31.8 mm
Spring Capture
Main Pin
Mini Pin
9657K288_Compression Spring
