GET-RAHS/2022-2024_Sockeye/Solar Car 2022-2024/Progressive steering/Alain Model (Concept)/progressive steering-2/SKF-NK-5-15/SKF_NK_5_12_TN.sldasm

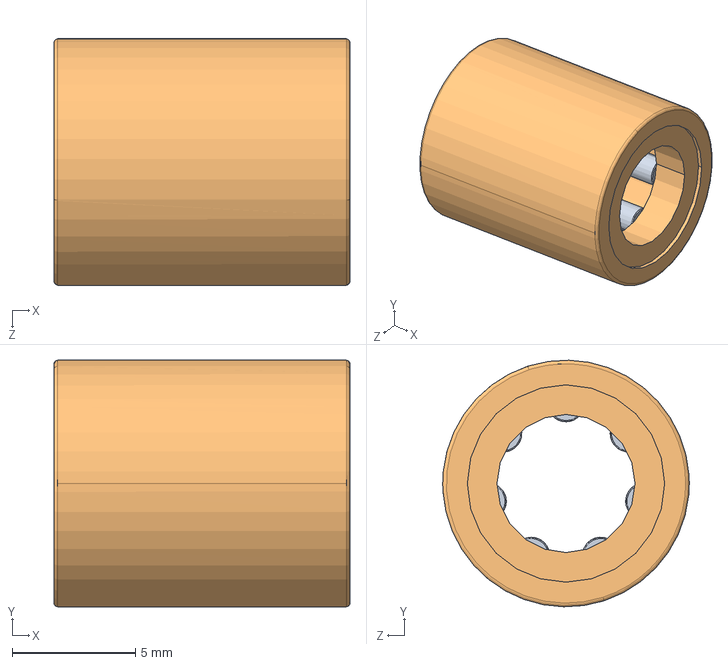
[picture p56: CAD file, 2023-08-19]
Solar Car 2022-2024/Progressive steering/Alain Model (Concept)/progressive steering-2/SKF-NK-5-15/SKF_NK_5_12_TN.sldasm
12.0 x 10.00 x 10.0 mm
SKF_NK_5_12_TN_11 x 7
SKF_NK_5_12_TN_19
