GET-RAHS/2022-2024_Sockeye/Solar Car 2022-2024/Wheels/Dismissed/Spun1+2.SLDASM

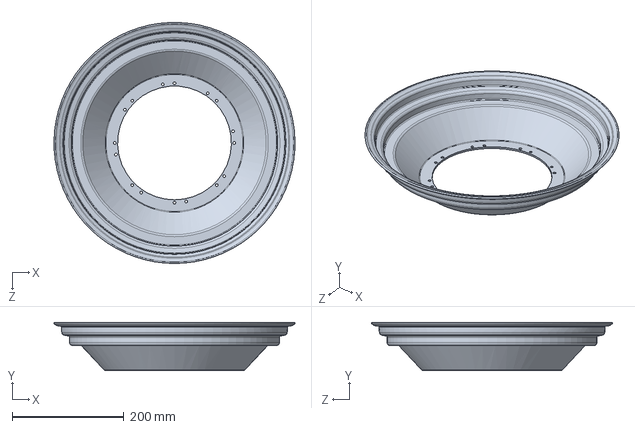
[picture p57: CAD file, 2023-08-19]
Solar Car 2022-2024/Wheels/Dismissed/Spun1+2.SLDASM
432.0 x 86.6 x 431.9 mm
