GET-RAHS/2022-2024_Sockeye/Solar Car 2022-2024/Battery Box/Battery Box.SLDASM

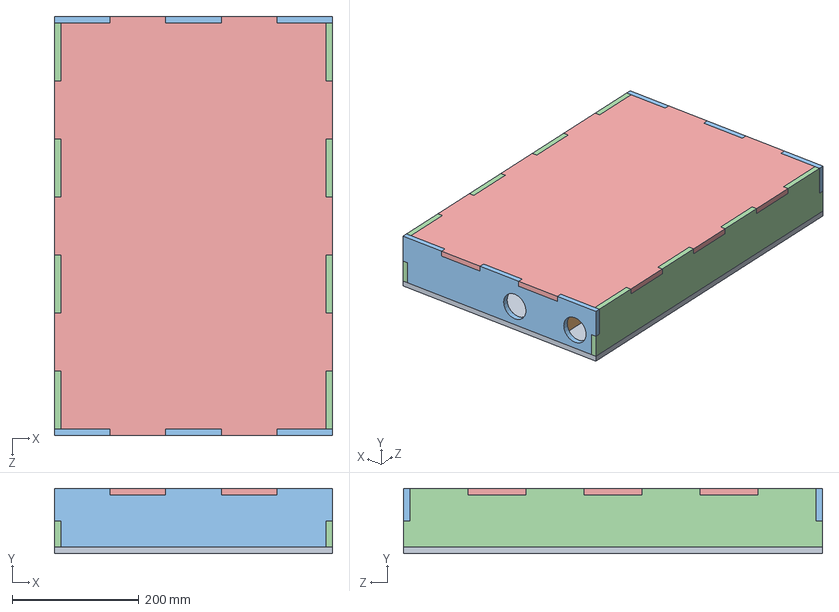
[picture p58: CAD file, 2023-08-19]
Solar Car 2022-2024/Battery Box/Battery Box.SLDASM
438.1 x 102.9 x 660.4 mm
Battery Box Bottom
Part4^Battery Box
Battery Box End Cap x 2
Battery Box Wall x 2
Part10^Battery Box
