GET-RAHS/2022-2024_Sockeye/Solar Car 2022-2024/Canopy/Assem9.SLDASM

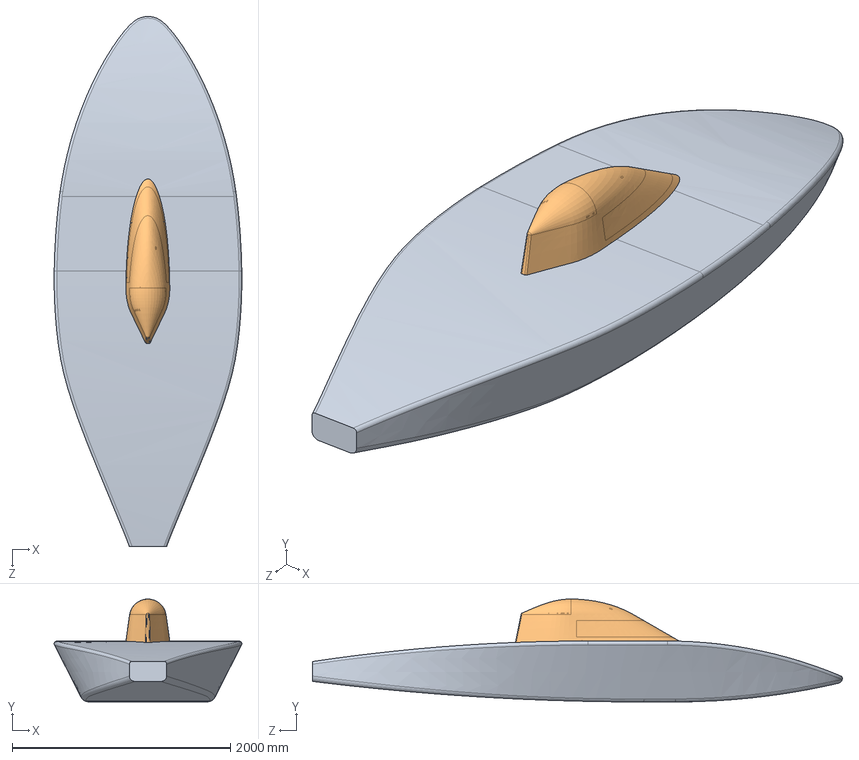
[picture p59: CAD file, 2023-08-19]
Solar Car 2022-2024/Canopy/Assem9.SLDASM
1720.8 x 943.6 x 4858.4 mm
Alain Wide Body (Double Naca Low nose)
windshileld4
