GET-RAHS/2022-2024_Sockeye/Solar Car 2022-2024/New Suspension/Front Suspension/rack and pinion assembly/prebuilt rack and pinion/steering assembly0.SLDASM

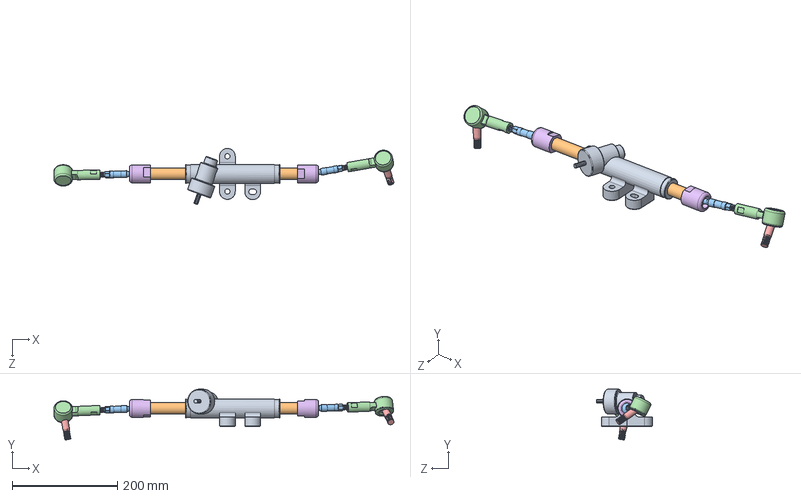
[picture p60: CAD file, 2023-08-19]
Solar Car 2022-2024/New Suspension/Front Suspension/rack and pinion assembly/prebuilt rack and pinion/steering assembly0.SLDASM
646.6 x 96.3 x 106.9 mm
prebuilt housing
prebuilt rack
prebuilt ball joint x 2
prebuilt ball joint end x 2
ball end joint conection piece x 2
rackBallEnd x 2
