GET-RAHS/2022-2024_Sockeye/Solar Car 2022-2024/New Suspension/Lovie-Rear/Rear Suspension/Suspension set 2.SLDASM

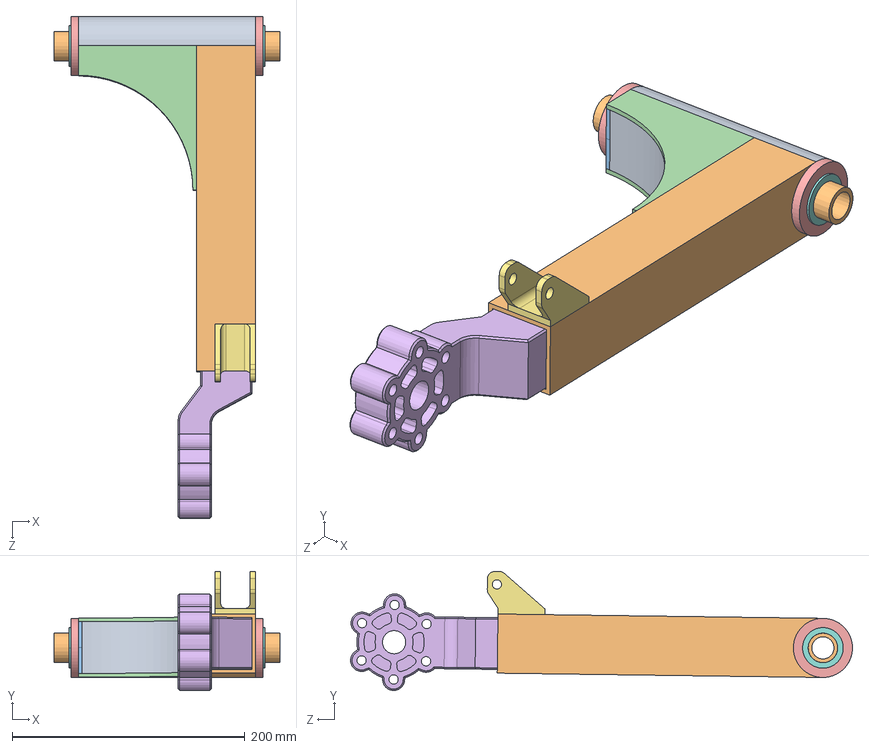
[picture p61: CAD file, 2023-08-19]
Solar Car 2022-2024/New Suspension/Lovie-Rear/Rear Suspension/Suspension set 2.SLDASM
193.7 x 102.3 x 431.1 mm
SR 1 (2 inch)
SR (square tube)
Part3^Suspension set 2
Gusset Rear Suspension set 2 x 2
SR (Cap) x 2
Cap insert
Brake Bracket
JFI-1618-12 x 2
Part5^Suspension set 2
SR (axel)
