GET-RAHS/2022-2024_Sockeye/Solar Car 2022-2024/New Suspension/Rear Suspension/Rear Tube Suspension/Rear Suspension Assembly.SLDASM

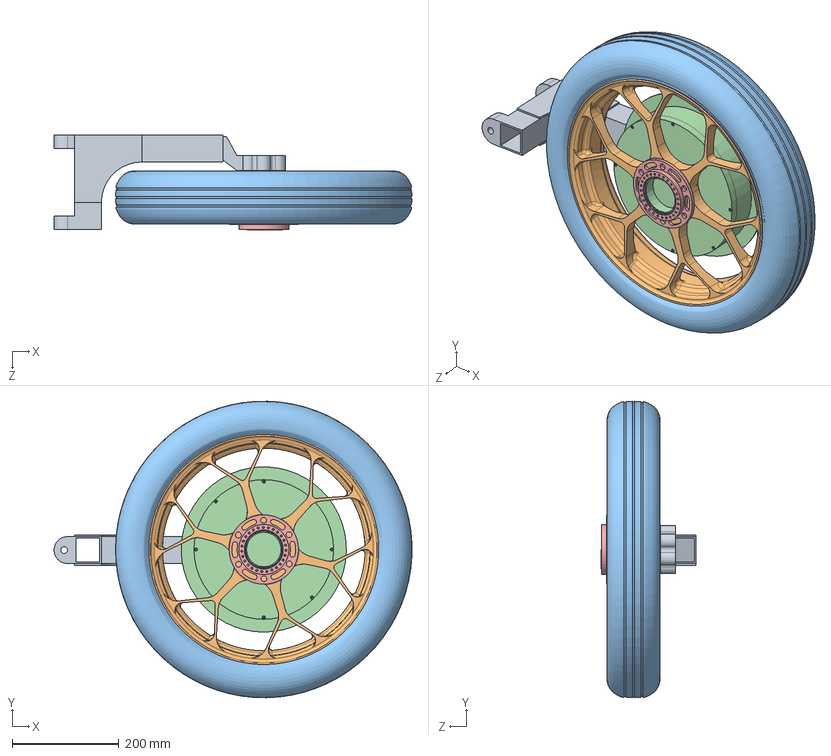
[picture p62: CAD file, 2023-08-19]
Solar Car 2022-2024/New Suspension/Rear Suspension/Rear Tube Suspension/Rear Suspension Assembly.SLDASM
671.8 x 556.5 x 178.6 mm
Rear Fork V2
rimmachined13
Michelin Tire
Motor Mitsuba M2096 D-III
Nut
