GET-RAHS/2022-2024_Sockeye/Solar Car 2022-2024/Pedals/full pedal setup/braking system/full braking system.SLDASM

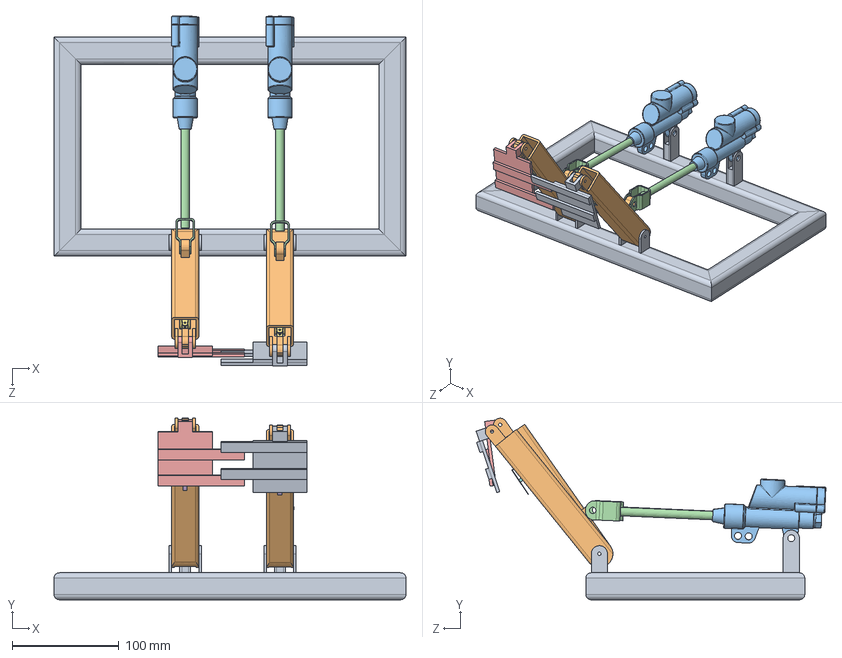
[picture p63: CAD file, 2023-08-19]
Solar Car 2022-2024/Pedals/full pedal setup/braking system/full braking system.SLDASM
330.2 x 170.4 x 328.2 mm
brake system base
brake pedal arm x 2
brake cylinder body x 2
brake cylinder arm x 2
foot pedal
palanca switch x 2
switch x 2
boton x 2
foot pedal 2
