GET-RAHS/2022-2024_Sockeye/Solar Car 2022-2024/Stay Hinge/Array Panel Support.SLDASM

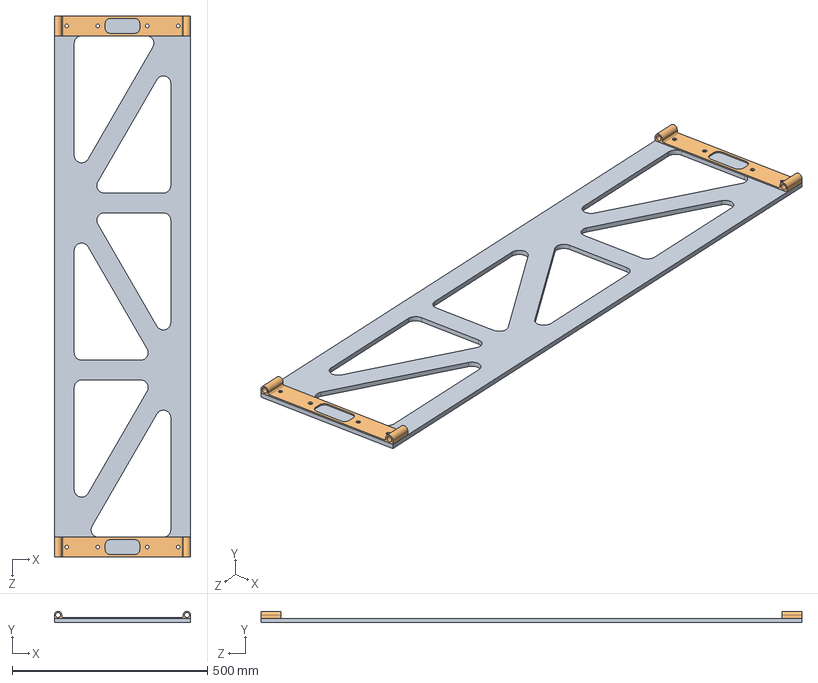
[picture p64: CAD file, 2023-08-19]
Solar Car 2022-2024/Stay Hinge/Array Panel Support.SLDASM
349.2 x 29.2 x 1386.9 mm
Solar Support
Pin Attatchment Bracket x 2
