GET-RAHS/2022-2024_Sockeye/Solar Car 2022-2024/Steering wheel/SteeringWheelAssem.SLDASM

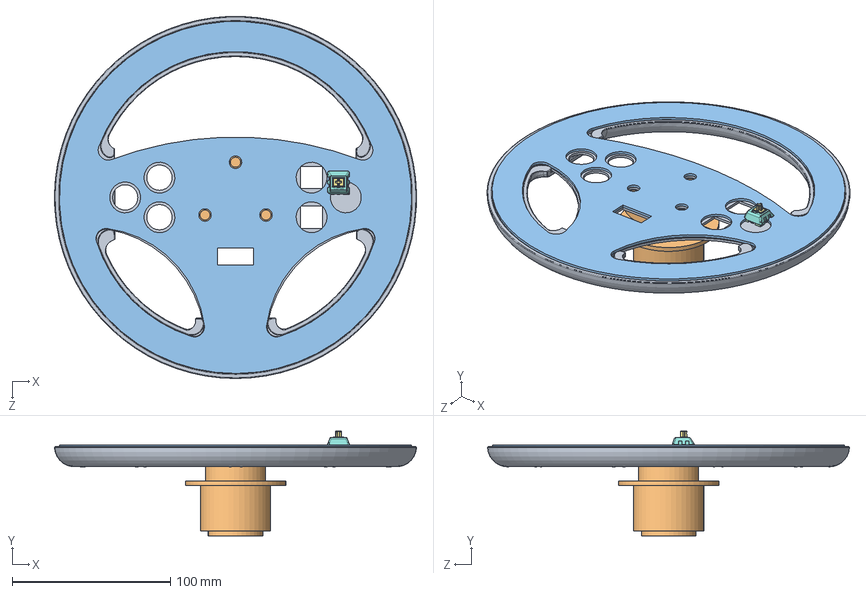
[picture p65: CAD file, 2023-08-19]
Solar Car 2022-2024/Steering wheel/SteeringWheelAssem.SLDASM
228.5 x 66.2 x 228.5 mm
CF1
Quick Release (Non-Functional)
CF2
BackTPU
