GET-RAHS/2022-2024_Sockeye/Solar Car 2022-2024/Wheels/Dismissed/buck-spun.SLDASM

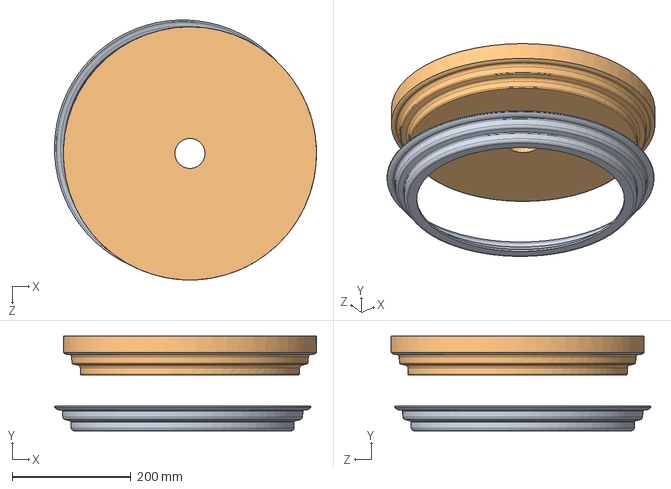
[picture p66: CAD file, 2023-08-19]
Solar Car 2022-2024/Wheels/Dismissed/buck-spun.SLDASM
441.5 x 159.6 x 437.8 mm
spun wheel125-2
buck Main^buck-spun
