GET-RAHS/2022-2024_Sockeye/Solar Car 2022-2024/Array Components/Array Locking Mechanism/ArrayLock.SLDASM

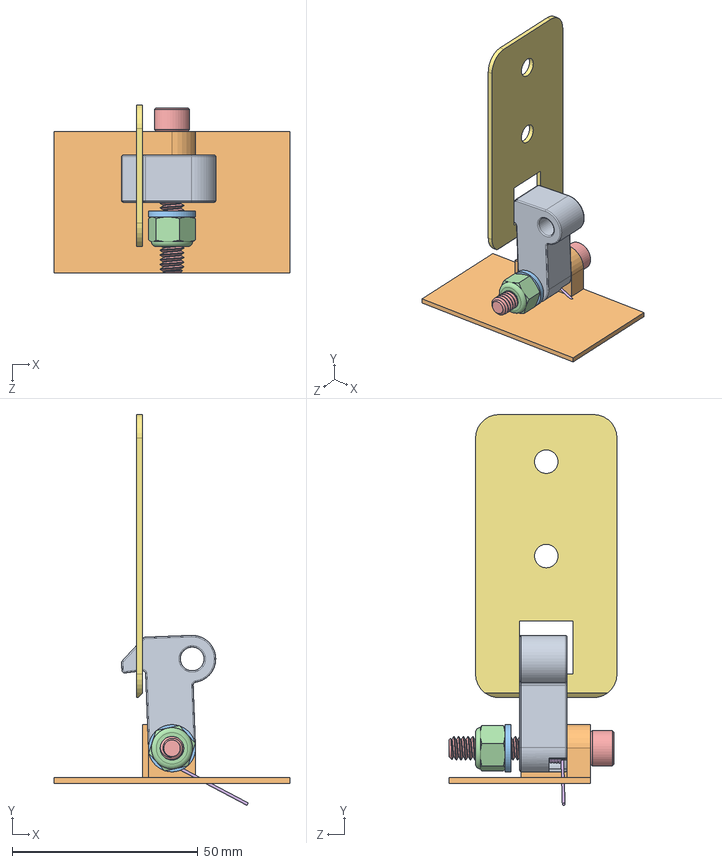
[picture p67: CAD file, 2023-08-19]
Solar Car 2022-2024/Array Components/Array Locking Mechanism/ArrayLock.SLDASM
63.5 x 105.2 x 45.2 mm
ArrayPin(V1)
pinstand
pt25xpt5washer
90630A110_High-Strength Steel Nylon-Insert Locknut
90128A251_Zinc-Plated Alloy Steel Socket Head Screw
9271K274_Torsion Spring
Snapmount
