GET-RAHS/2022-2024_Sockeye/Solar Car 2022-2024/New Suspension/Front Suspension/ASSY4-5III/steering assembly.SLDASM

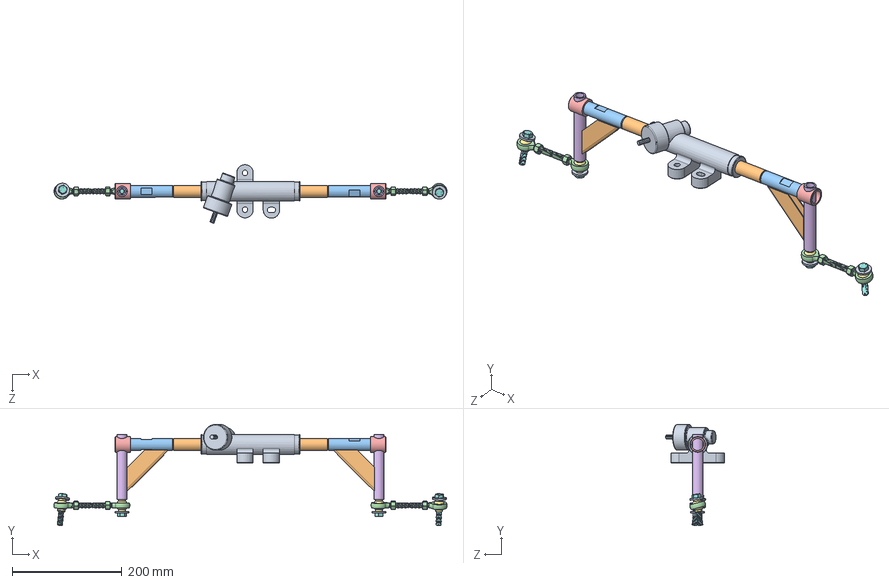
[picture p68: CAD file, 2023-08-19]
Solar Car 2022-2024/New Suspension/Front Suspension/ASSY4-5III/steering assembly.SLDASM
715.4 x 184.4 x 106.9 mm
prebuilt housing
prebuilt rack
extender x 2
3-8-24 swivel x 4
RackVertAdapt x 2
Rackvertical x 2
BallSuper-Swivel Joint Rod End6960T231_ x 4
91257A659_Zinc Yellow-Chromate Plated Hex Head Screw x 4
3-8 98029A046_Black-Oxide Steel Oversized Washer x 4
GussetSteering x 2
