GET-RAHS/2022-2024_Sockeye/Solar Car 2022-2024/New Suspension/Rear Suspension/Rear Tube Suspension/Parts/rear suspension mount separated/full rear suspention mount.SLDASM

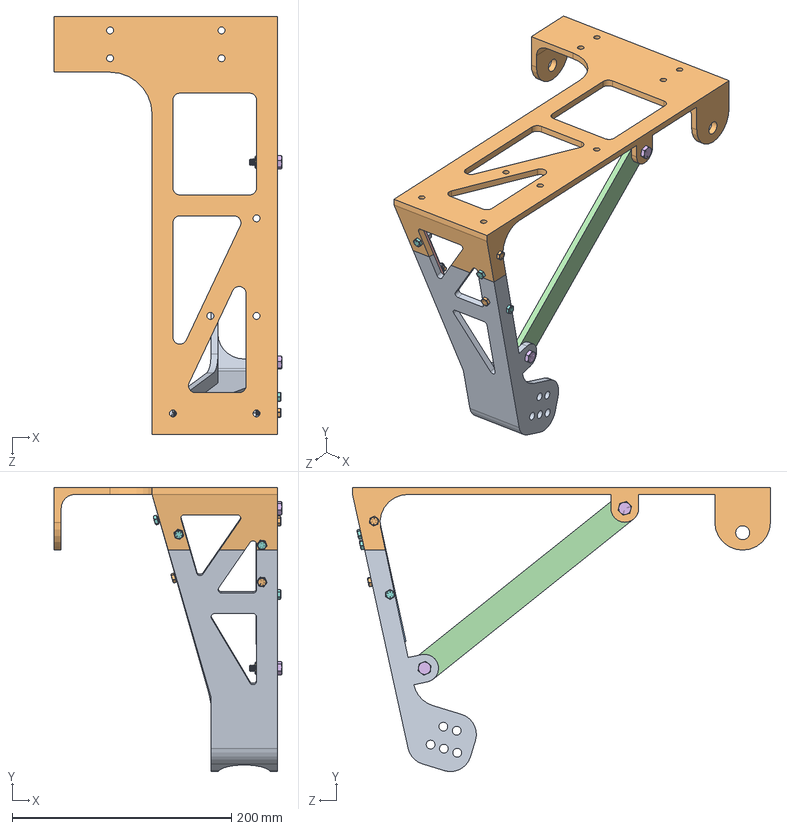
[picture p69: CAD file, 2023-08-19]
Solar Car 2022-2024/New Suspension/Rear Suspension/Rear Tube Suspension/Parts/rear suspension mount separated/full rear suspention mount.SLDASM
207.4 x 259.0 x 381.0 mm
Rear Suspension Mount part 2
Rear Suspension Mount part 1
brace
strut
brace 2
99894A105_Mil. Spec. Medium-Strength Steel Hex Head Screw x 2
95615A120_Medium-Strength Steel Nylon-Insert Locknut x 2
92620A417_Zinc Yellow-Chromate Plated Hex Head Screw(1) x 4
95856A235_Aluminum Nylon-Insert Locknut x 7
92620A417_Zinc Yellow-Chromate Plated Hex Head Screw x 3
