GET-RAHS/2022-2024_Sockeye/Solar Car 2022-2024/Pedal Units/Spring Pin/Main Pin.SLDPRT

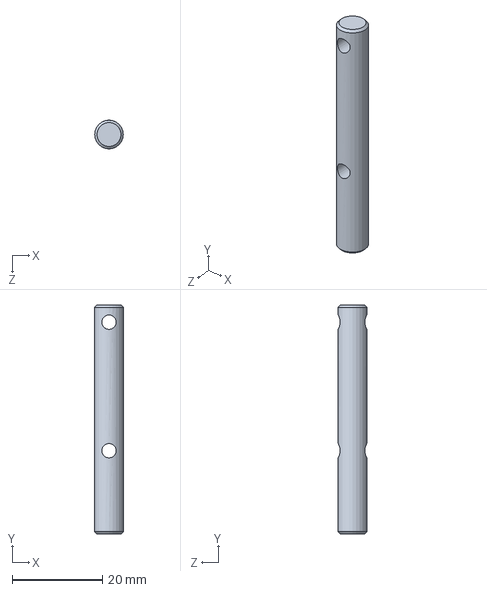
[picture p70: CAD file, 2023-08-19]
Solar Car 2022-2024/Pedal Units/Spring Pin/Main Pin.SLDPRT
6.35 x 50.8 x 6.35 mm
