GET-RAHS/2022-2024_Sockeye/Solar Car 2022-2024/Pedals/full pedal setup/braking system/micro switch.SLDASM

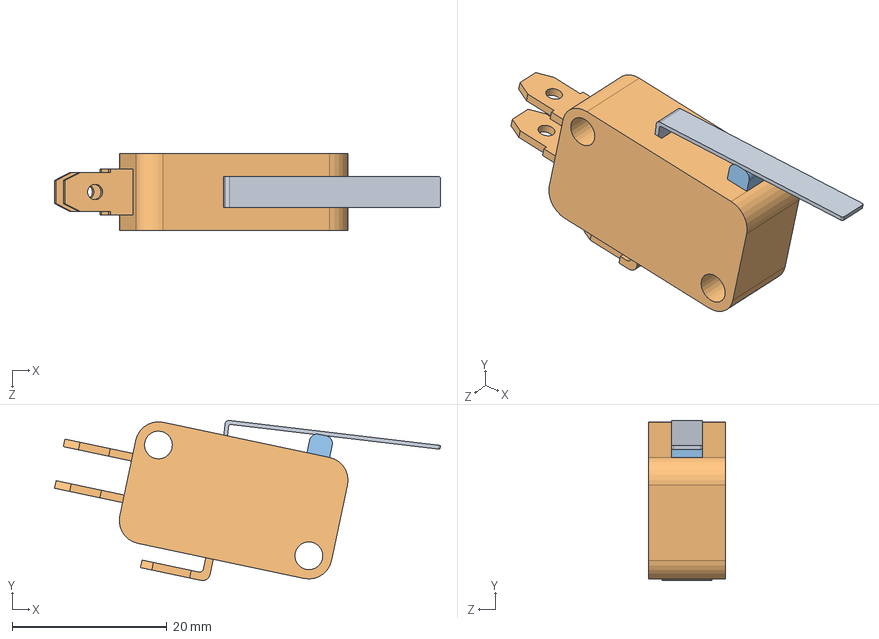
[picture p71: CAD file, 2023-08-19]
Solar Car 2022-2024/Pedals/full pedal setup/braking system/micro switch.SLDASM
49.9 x 20.7 x 10.0 mm
palanca switch
switch
boton
