GET-RAHS/2022-2024_Sockeye/Solar Car 2022-2024/Progressive steering/3D printed concept model/ProgressiveSteering.SLDASM

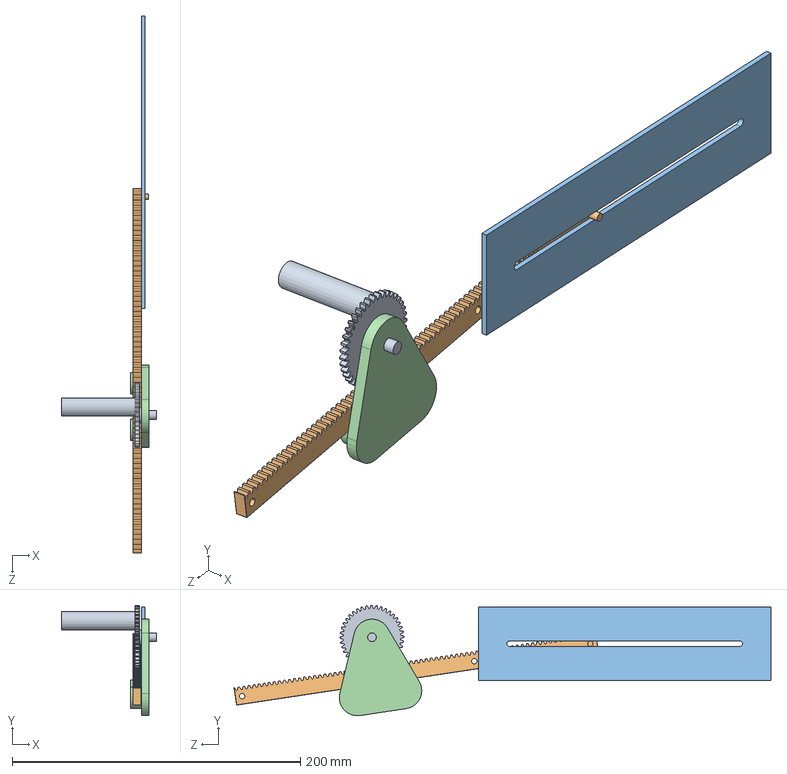
[picture p72: CAD file, 2023-08-19]
Solar Car 2022-2024/Progressive steering/3D printed concept model/ProgressiveSteering.SLDASM
65.8 x 76.7 x 372.9 mm
SI_sdpsi_s1268z-024s040
SI_sdpsi_s1811y-rc-1a
slot
Part1^ProgressiveSteering
