GET-RAHS/2022-2024_Sockeye/Solar Car 2022-2024/Progressive steering/Alain Model (Refined)/v2/Assem1.SLDASM

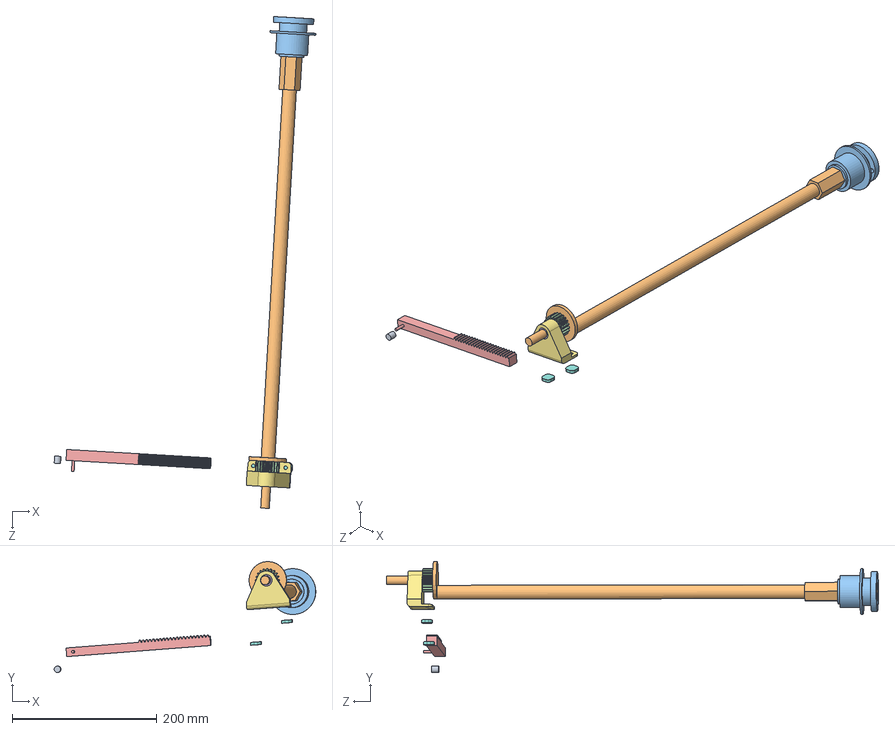
[picture p73: CAD file, 2023-08-19]
Solar Car 2022-2024/Progressive steering/Alain Model (Refined)/v2/Assem1.SLDASM
361.9 x 153.6 x 680.4 mm
Part2^Assem1
adapterplate(unfinished)
Quick Release (Non-Functional)
KHK-US_SSA1_5-20J12.stp
KHK-US_SRAF1_5-1000.stp
6995N126_Iron-Copper High-Load Oil-Embedded Sleeve Bearing
slider
delrinshim x 2
