GET-RAHS/2022-2024_Sockeye/Solar Car 2022-2024/Steering wheel/Folding Steering Wheel/Folding Steering Wheel.SLDASM

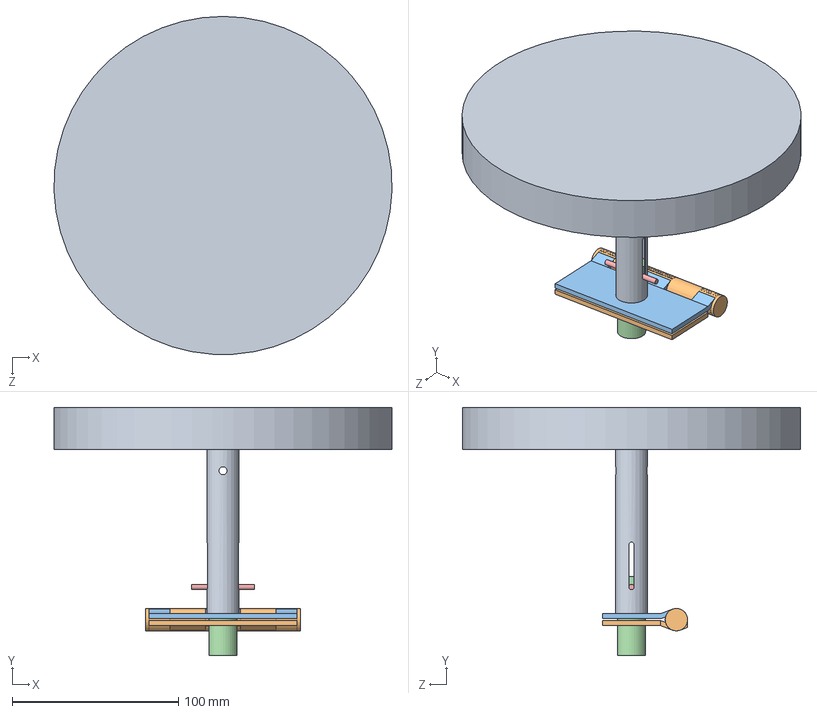
[picture p74: CAD file, 2023-08-19]
Solar Car 2022-2024/Steering wheel/Folding Steering Wheel/Folding Steering Wheel.SLDASM
203.1 x 149.2 x 203.2 mm
Mock Steering Wheel
Door Hinge (2)
Opposite Hinge
Dowel
Pull Pin
