GET-RAHS/2022-2024_Sockeye/Solar Car 2022-2024/Steering wheel/V3/Steering Wheel V3.SLDASM

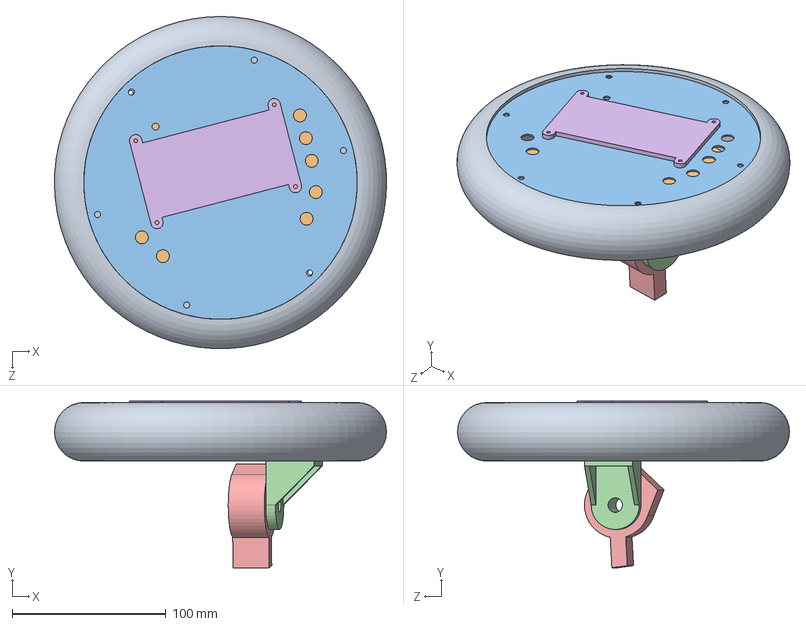
[picture p75: CAD file, 2023-08-19]
Solar Car 2022-2024/Steering wheel/V3/Steering Wheel V3.SLDASM
215.9 x 108.3 x 215.8 mm
Ring
BackPlate
FrontPlate
AnalogueBrakeMountingRod
MockAnalogueBrake
Acrylic Screen Cover
