GET-RAHS/2022-2024_Sockeye/Solar Car 2022-2024/BallDrive/WTF2550_2ZZ_499LC7T_42000.sldasm

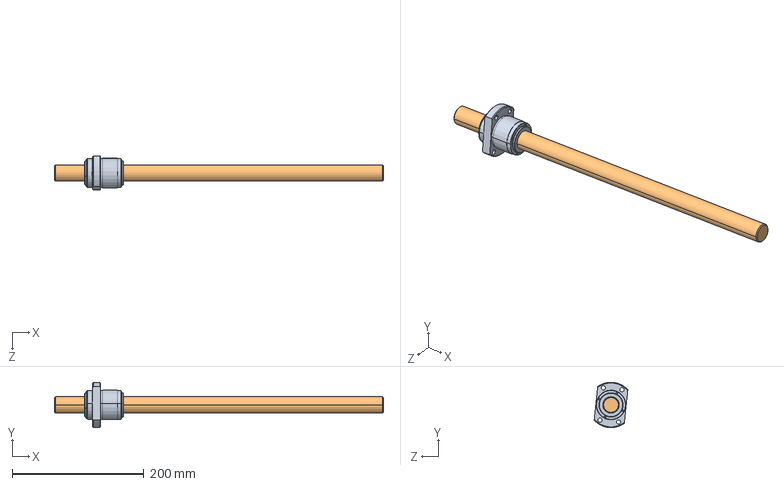
[picture p76: CAD file, 2023-08-19]
Solar Car 2022-2024/BallDrive/WTF2550_2ZZ_499LC7T_42000.sldasm
499.0 x 68.8 x 51.1 mm
WTF2550_2ZZ_499LC7T_42000_3
WTF2550_2ZZ_499LC7T_42000_5
