GET-RAHS/2022-2024_Sockeye/Solar Car 2022-2024/New Suspension/Caliper Assembly.SLDASM

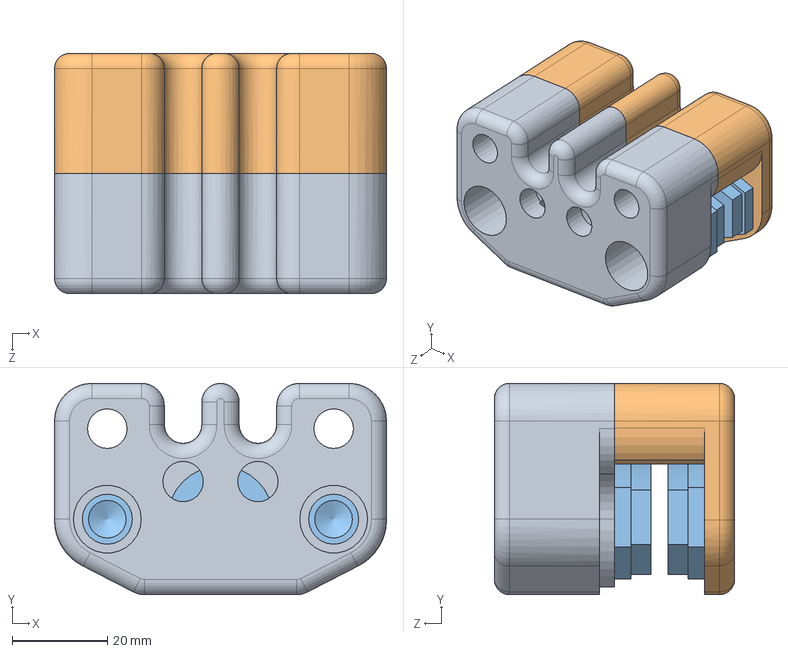
[picture p77: CAD file, 2023-08-19]
Solar Car 2022-2024/New Suspension/Caliper Assembly.SLDASM
69.8 x 44.5 x 50.5 mm
Caliper A v2.ipt
Caliper B v9.ipt
MCP 554 Pads v5.ipt x 2
