GET-RAHS/2022-2024_Sockeye/Solar Car 2022-2024/Pedals/full pedal setup/Custom pedal/Custom pedal/Pedalassem.SLDASM

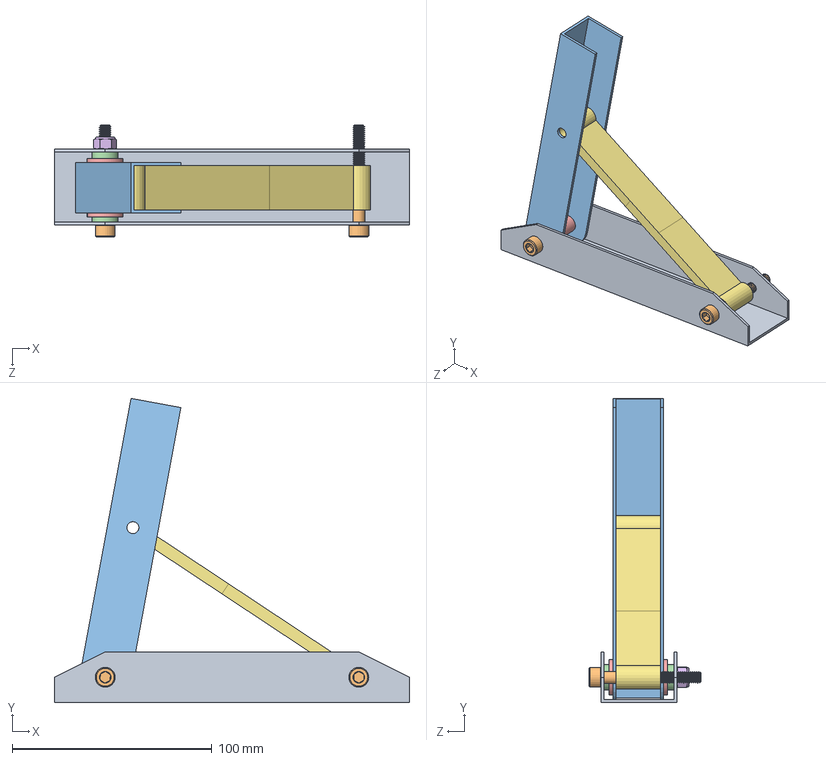
[picture p78: CAD file, 2023-08-19]
Solar Car 2022-2024/Pedals/full pedal setup/Custom pedal/Custom pedal/Pedalassem.SLDASM
177.8 x 152.4 x 56.0 mm
PedalBase
91292A144_18-8 Stainless Steel Socket Head Screw x 2
PedalShaft
92871A198_18-8 Stainless Steel Unthreaded Spacer x 2
Nylonbearing x 2
90576A115_Medium-Strength Steel Nylon-Insert Locknut
demo x 2
