GET-RAHS/2022-2024_Sockeye/Solar Car 2022-2024/Wheels/Misubaand Disk.SLDASM

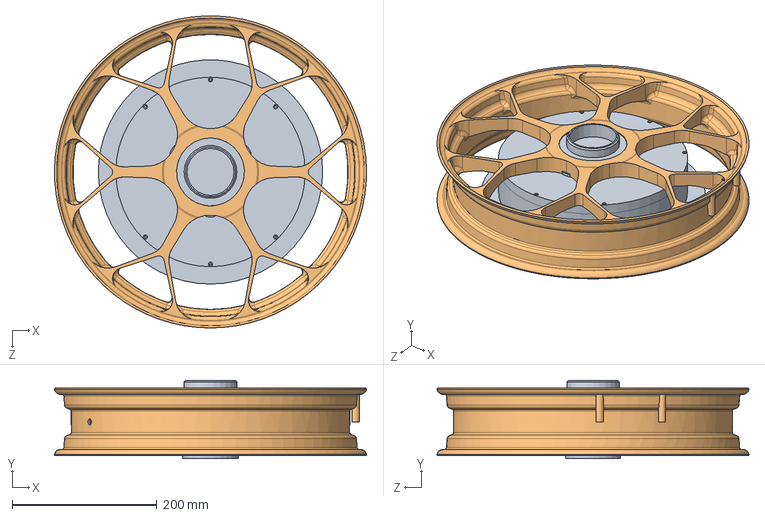
[picture p79: CAD file, 2023-08-19]
Solar Car 2022-2024/Wheels/Misubaand Disk.SLDASM
431.5 x 108.0 x 431.4 mm
Motor Mitsuba M2096 D-III
rimmachined13
