GET-RAHS/2022-2024_Sockeye/Solar Car 2022-2024/Frame/Hagen Body/Hagen Body.SLDASM

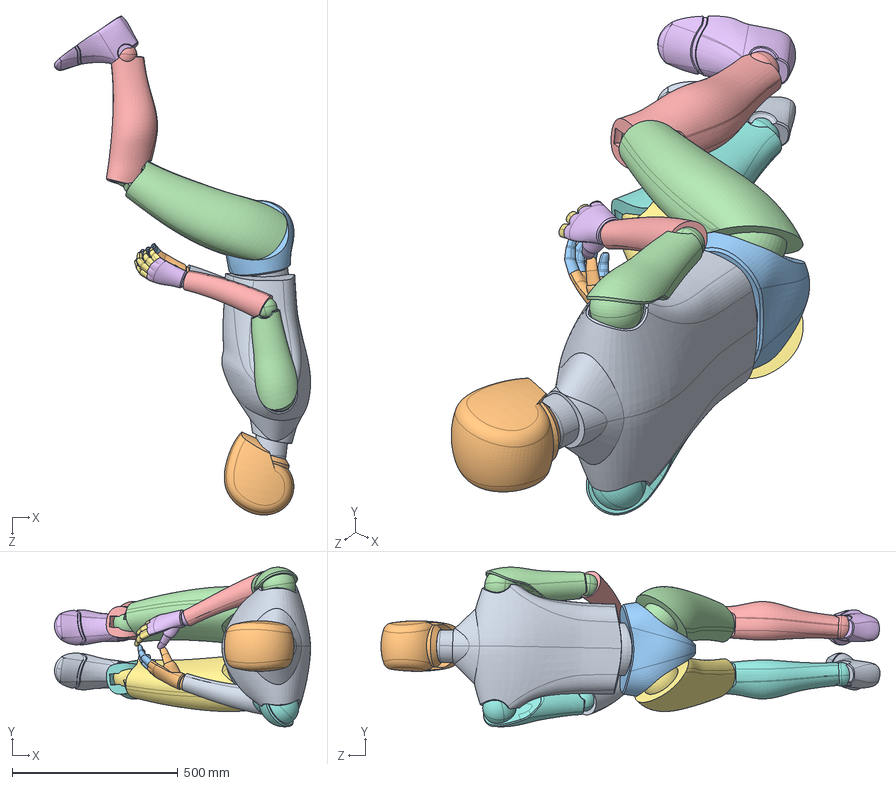
[picture p80: CAD file, 2023-08-19]
Solar Car 2022-2024/Frame/Hagen Body/Hagen Body.SLDASM
772.7 x 481.7 x 1505.5 mm
Torso
Head
Pelvis
UpperArm_R
LowerArm_R
Hand_R
Fingers_R
UpperArm_L
LowerArm_L
Hand_L
Fingers_L
UpperLeg_R
LowerLeg_R
Foot_R
UpperLeg_L
LowerLeg_L
Foot_L
