GET-RAHS/2022-2024_Sockeye/Solar Car 2022-2024/New Suspension/Front Suspension/Assembly1/lower wishbone.SLDASM

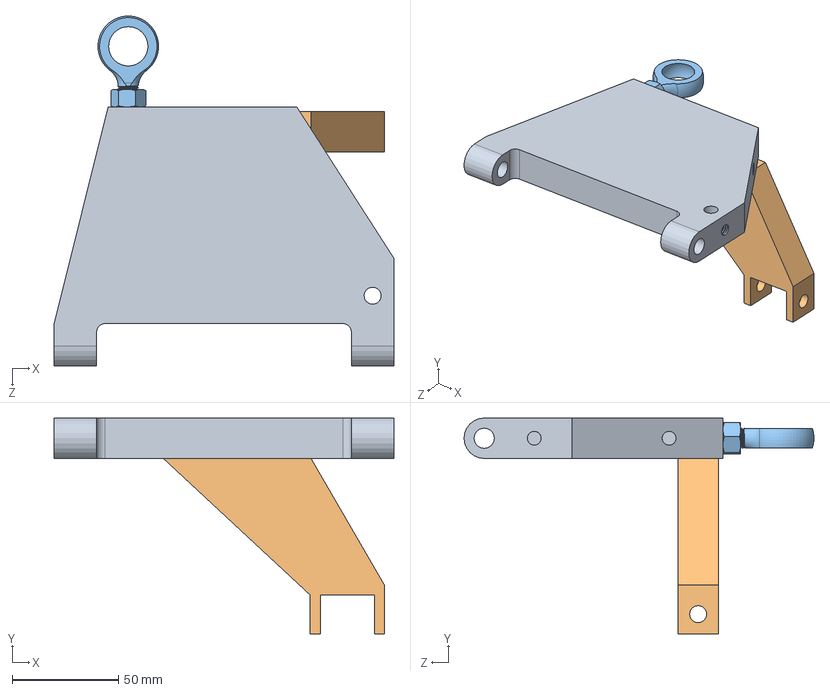
[picture p81: CAD file, 2023-08-19]
Solar Car 2022-2024/New Suspension/Front Suspension/Assembly1/lower wishbone.SLDASM
160.0 x 101.7 x 164.9 mm
BottomWishbone
BottomShock mount
3-8-24 swivel
