GET-RAHS/2022-2024_Sockeye/Solar Car 2022-2024/Wheels/Nomura Hubs Replications Hagen/nomurahubcomplete (1).SLDASM

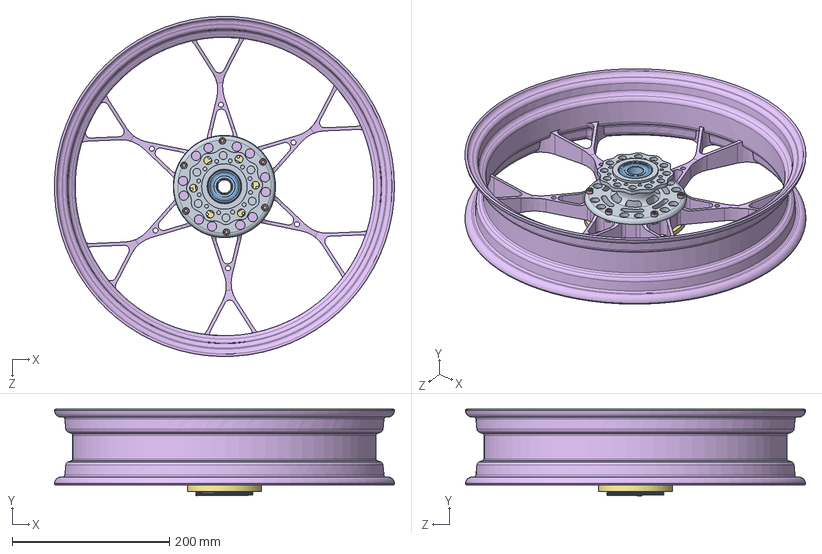
[picture p82: CAD file, 2023-08-19]
Solar Car 2022-2024/Wheels/Nomura Hubs Replications Hagen/nomurahubcomplete (1).SLDASM
432.0 x 110.0 x 432.1 mm
Hub
SKF_6003-2Z.stp
SKF_6004-2Z.stp
Standoff 8mm M5 x 6
91292A124_18-8 Stainless Steel Socket Head Screw x 6
rimmachined3
Nut
