GET-RAHS/2022-2024_Sockeye/Solar Car 2022-2024/Pedal Units/braking system/full braking system.SLDASM

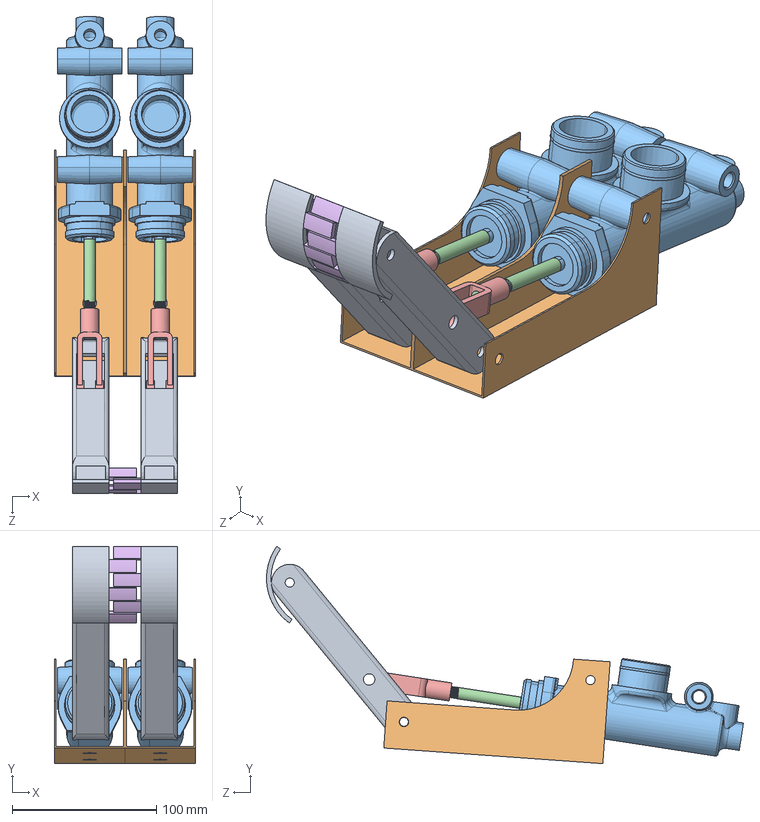
[picture p85: CAD file, 2023-08-19]
Solar Car 2022-2024/Pedal Units/braking system/full braking system.SLDASM
98.0 x 150.7 x 330.9 mm
brake pedal arm x 2
Pedal Attatchment Member x 2
Wilwood MC 260-XXXX.stp x 2
Part2^Wilwood Master Cylinder x 2
1583K13_Carbon Steel Corrosion-Resistant Clevis Rod End x 2
Part4^full braking system
