GET-RAHS/2022-2024_Sockeye/Solar Car 2022-2024/Pedals/full pedal setup/full pedals.SLDASM

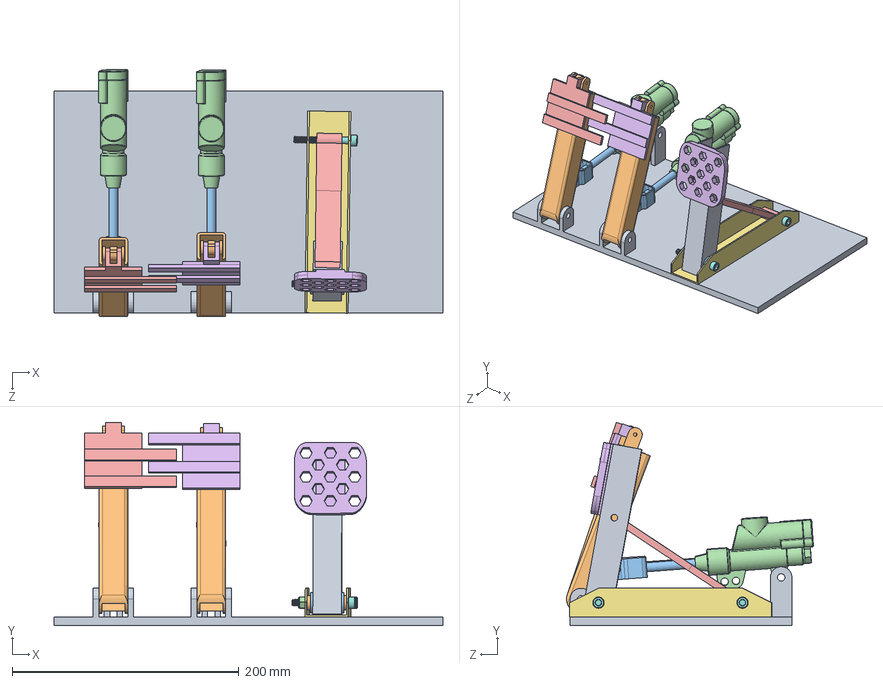
[picture p86: CAD file, 2023-08-19]
Solar Car 2022-2024/Pedals/full pedal setup/full pedals.SLDASM
342.9 x 179.3 x 217.7 mm
pedal test base
brake pedal arm x 2
brake cylinder arm x 2
brake cylinder body x 2
foot pedal
foot pedal 2
PedalBase
91292A144_18-8 Stainless Steel Socket Head Screw x 2
PedalShaft
92871A198_18-8 Stainless Steel Unthreaded Spacer x 2
Nylonbearing x 2
90576A115_Medium-Strength Steel Nylon-Insert Locknut
demo x 2
g29 pedal
