GET-RAHS/2022-2024_Sockeye/Solar Car 2022-2024/Progressive steering/Alain Model (Concept)/ProgressiveSteering0_5.SLDASM

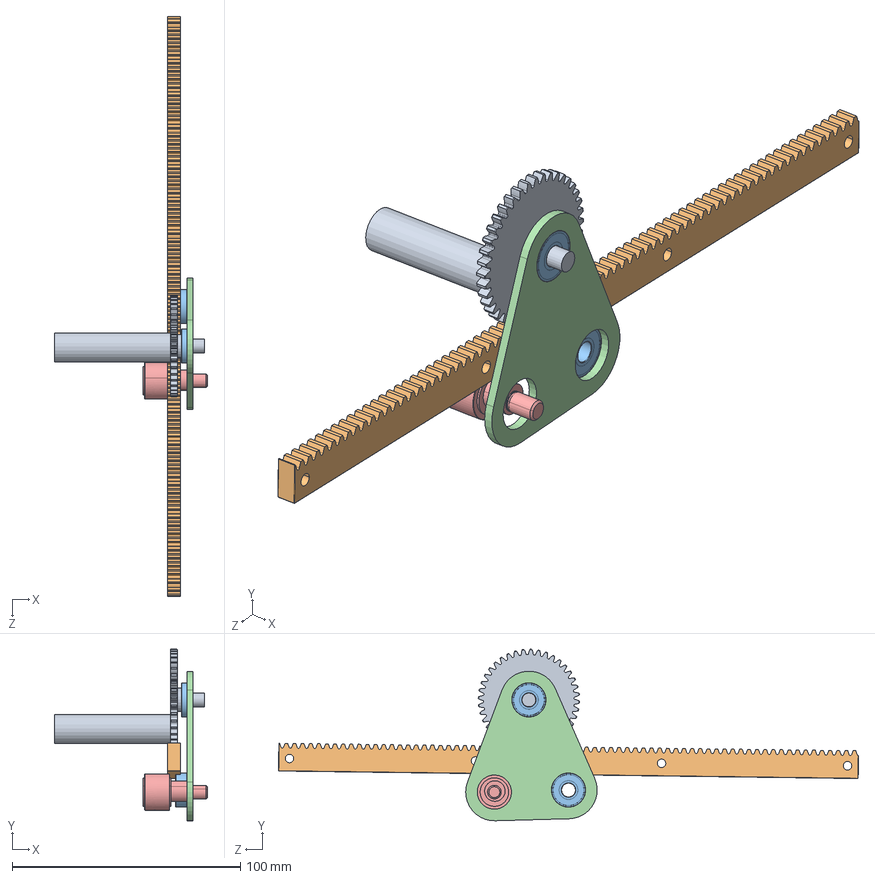
[picture p87: CAD file, 2023-08-19]
Solar Car 2022-2024/Progressive steering/Alain Model (Concept)/ProgressiveSteering0_5.SLDASM
67.1 x 75.2 x 254.1 mm
SI_sdpsi_s1268z-024s040
SI_sdpsi_s1811y-rc-1a
4668K121_Permanently Lubricated Stainless Steel Ball Bearing x 2
Part1^ProgressiveSteering
SKF_KRE_16_PP
