GET-RAHS/2022-2024_Sockeye/Solar Car 2022-2024/Steering wheel/V3/OuterRingPlywoodPieces/2.4mm ply/WoodPlatesAssem.SLDASM

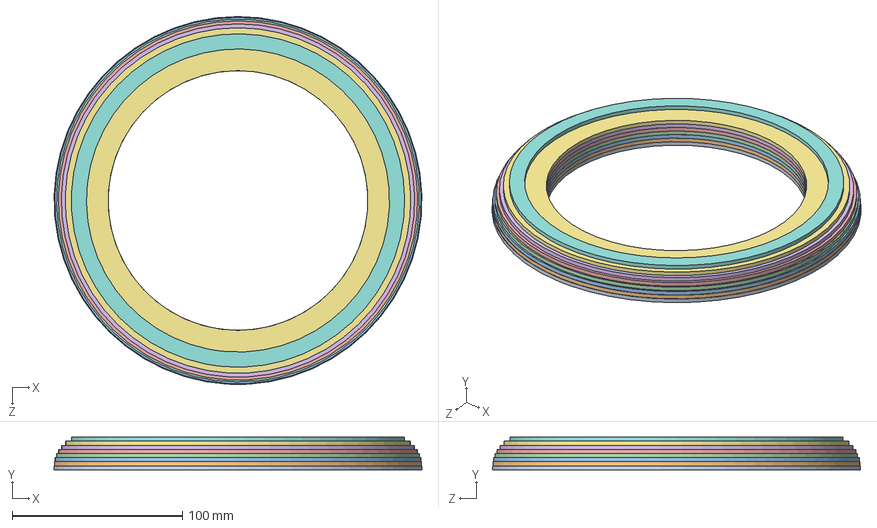
[picture p88: CAD file, 2023-08-19]
Solar Car 2022-2024/Steering wheel/V3/OuterRingPlywoodPieces/2.4mm ply/WoodPlatesAssem.SLDASM
215.8 x 19.2 x 215.9 mm
Ring1
Ring2
Ring3
Ring4
Ring5
Ring6
Ring7
Ring8
