GET-RAHS/2022-2024_Sockeye/Solar Car 2022-2024/New Suspension/Front Suspension/ASSY4-5II/Shock.SLDASM

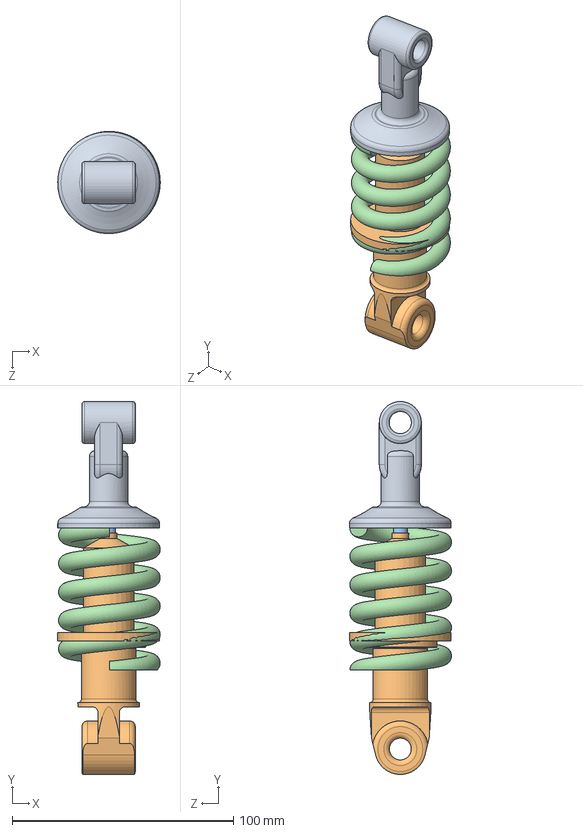
[picture p89: CAD file, 2023-08-19]
Solar Car 2022-2024/New Suspension/Front Suspension/ASSY4-5II/Shock.SLDASM
46.3 x 168.5 x 46.2 mm
Shock Anchor_11
Shock Tube 1_11
Shock Absorber Rod_11
Shock Spring_11
