GET-RAHS/2022-2024_Sockeye/Solar Car 2022-2024/Canopy/Assem14.SLDASM

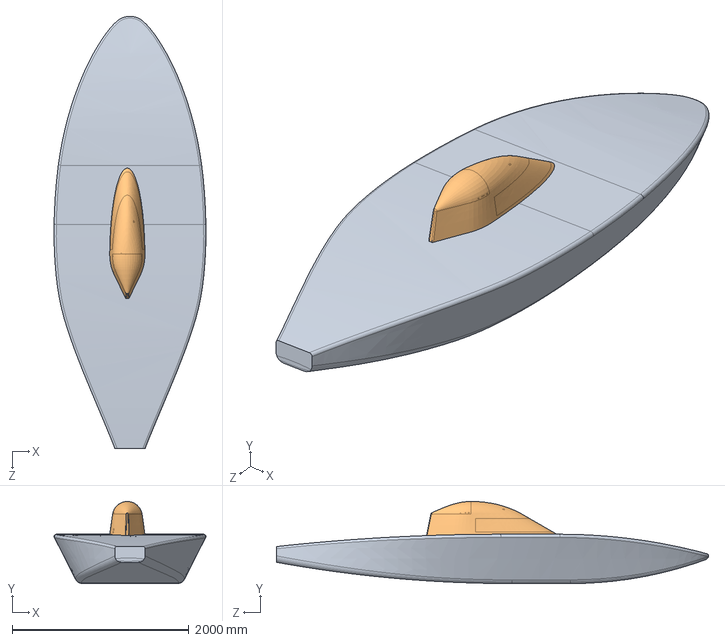
[picture p90: CAD file, 2023-08-19]
Solar Car 2022-2024/Canopy/Assem14.SLDASM
1721.1 x 930.1 x 4893.8 mm
Alain Wide Body (Double Naca, 5 inch high, high nose)
windshileld4
