GET-RAHS/2022-2024_Sockeye/Solar Car 2022-2024/New Suspension/Front Suspension/Assy7/steering assembly.SLDASM

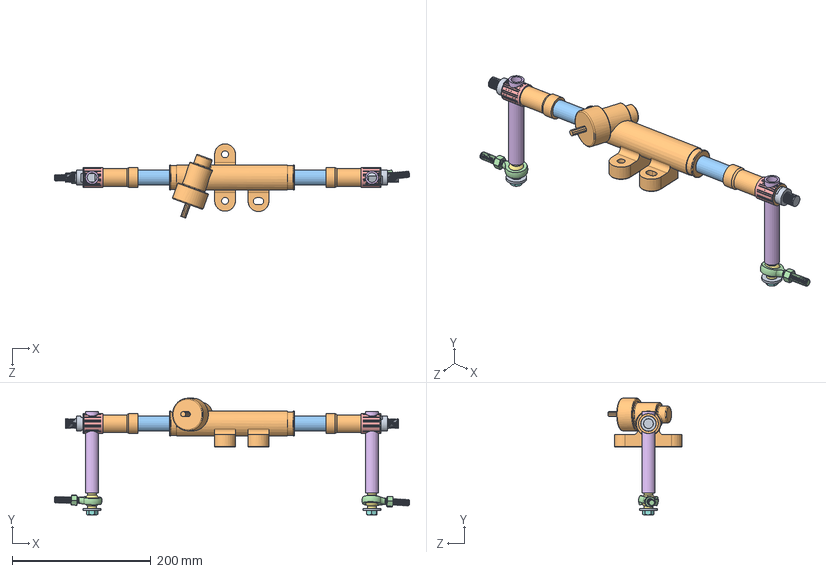
[picture p91: CAD file, 2023-08-19]
Solar Car 2022-2024/New Suspension/Front Suspension/Assy7/steering assembly.SLDASM
511.0 x 167.9 x 106.9 mm
prebuilt housing
prebuilt rack
extender x 2
3-8-24 swivel x 2
RackVertAdapt x 2
Rackvertical x 2
BallSuper-Swivel Joint Rod End6960T231_ x 2
91257A659_Zinc Yellow-Chromate Plated Hex Head Screw x 2
3-8 98029A046_Black-Oxide Steel Oversized Washer x 2
extender2 x 2
