GET-RAHS/2022-2024_Sockeye/Solar Car 2022-2024/Wheels/Dismissed/front hub spun.SLDASM

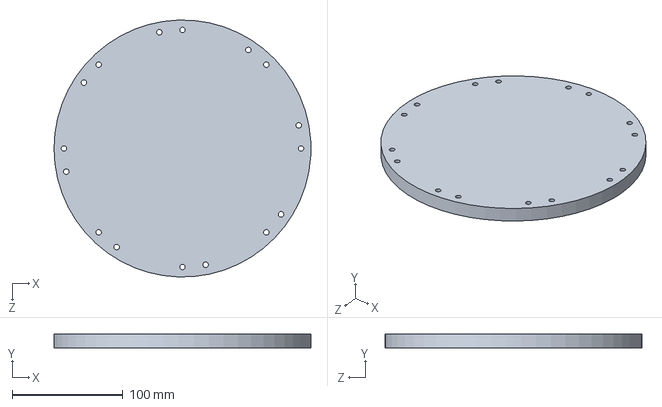
[picture p92: CAD file, 2023-08-19]
Solar Car 2022-2024/Wheels/Dismissed/front hub spun.SLDASM
232.0 x 12.7 x 231.9 mm
