GET-RAHS/2022-2024_Sockeye/Solar Car 2022-2024/Pedal Units/braking system/SideMountWilwoodMC.SLDASM

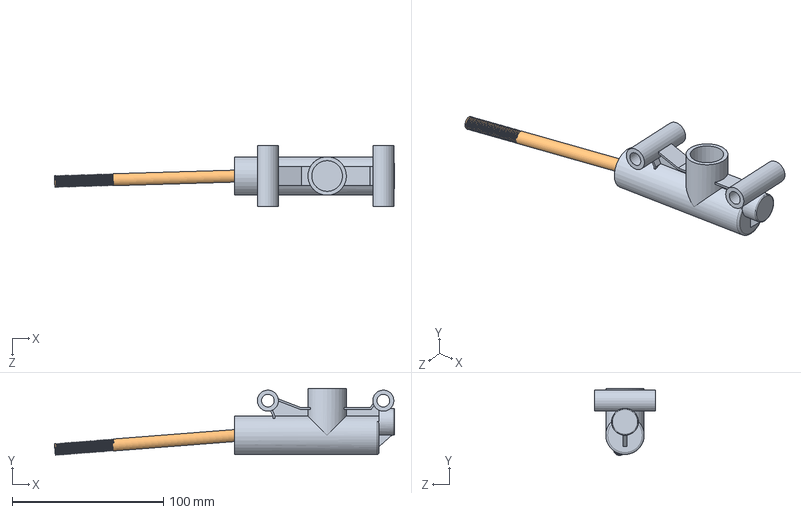
[picture p93: CAD file, 2023-08-19]
Solar Car 2022-2024/Pedal Units/braking system/SideMountWilwoodMC.SLDASM
224.4 x 44.2 x 40.3 mm
NewWilwoodMasterCylinder
MCpushrod
