GET-RAHS/2022-2024_Sockeye/Solar Car 2022-2024/Pedals/full pedal setup/Wilwood Master Cylinder.SLDASM

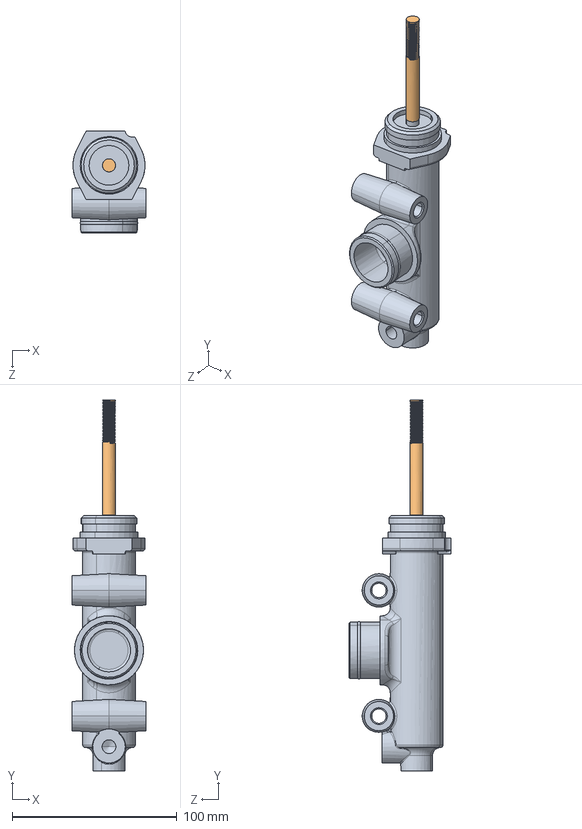
[picture p94: CAD file, 2023-08-19]
Solar Car 2022-2024/Pedals/full pedal setup/Wilwood Master Cylinder.SLDASM
45.0 x 224.9 x 62.1 mm
Wilwood MC 260-XXXX.stp
Part2^Wilwood Master Cylinder
