GET-RAHS/2022-2024_Sockeye/Solar Car 2022-2024/Progressive steering/Alain Model (Concept)/progressive steering-2/ProgressiveSteering-2.SLDASM

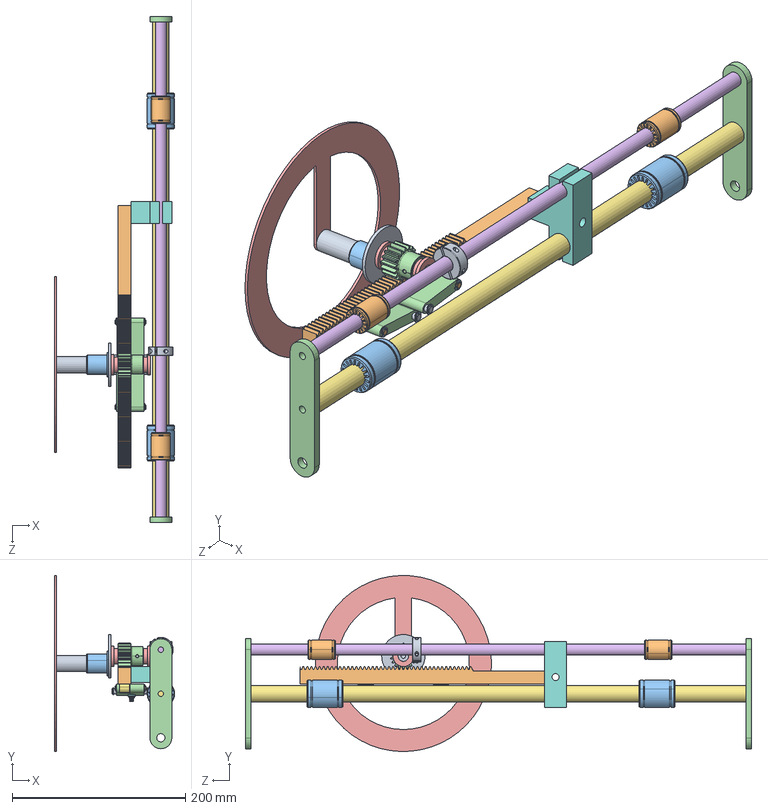
[picture p95: CAD file, 2023-08-19]
Solar Car 2022-2024/Progressive steering/Alain Model (Concept)/progressive steering-2/ProgressiveSteering-2.SLDASM
138.8 x 203.1 x 584.2 mm
eccentricAxle
SR1_5_300_On
igus-75
SSG1_5_18J12_On
2938T773_High-Load Oil-Embedded 863 Bronze Sleeve Bearing x 2
SKF_NK_5_12_TN_11 x 14
SKF_NK_5_12_TN_19 x 2
96439A560_18-8 Stainless Steel Press-Fit Nut for Sheet Metal x 2
6mm x 2
5mm x 2
98543A112_Side-Mount External Retaining Rings x 8
track follower x 2
94355A335_18-8 Stainless Steel Flat-Tip Set Screws x 2
anchor
6436K71_Clamping Two-Piece Shaft Collar
-5linearRJI-01-08 x 2
-75linearRJI-01-12 x 2
ends x 2
SteeringWheel
