GET-RAHS/2022-2024_Sockeye/Solar Car 2022-2024/Canopy/Canopy4and4-2.SLDASM

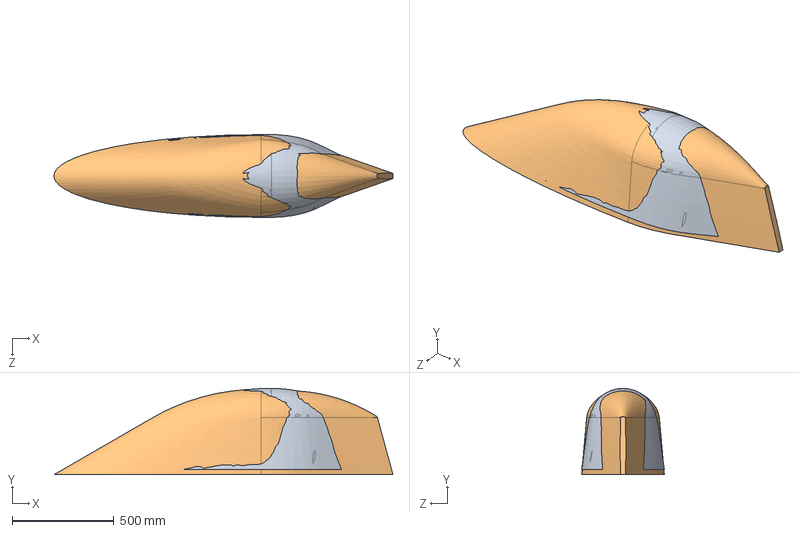
[picture p96: CAD file, 2023-08-19]
Solar Car 2022-2024/Canopy/Canopy4and4-2.SLDASM
1663.6 x 423.5 x 406.4 mm
windshileld4
windshileld4-2
