GET-RAHS/2022-2024_Sockeye/Solar Car 2022-2024/Progressive steering/Alain Model (Concept)/ProgressiveSteering-1.SLDASM

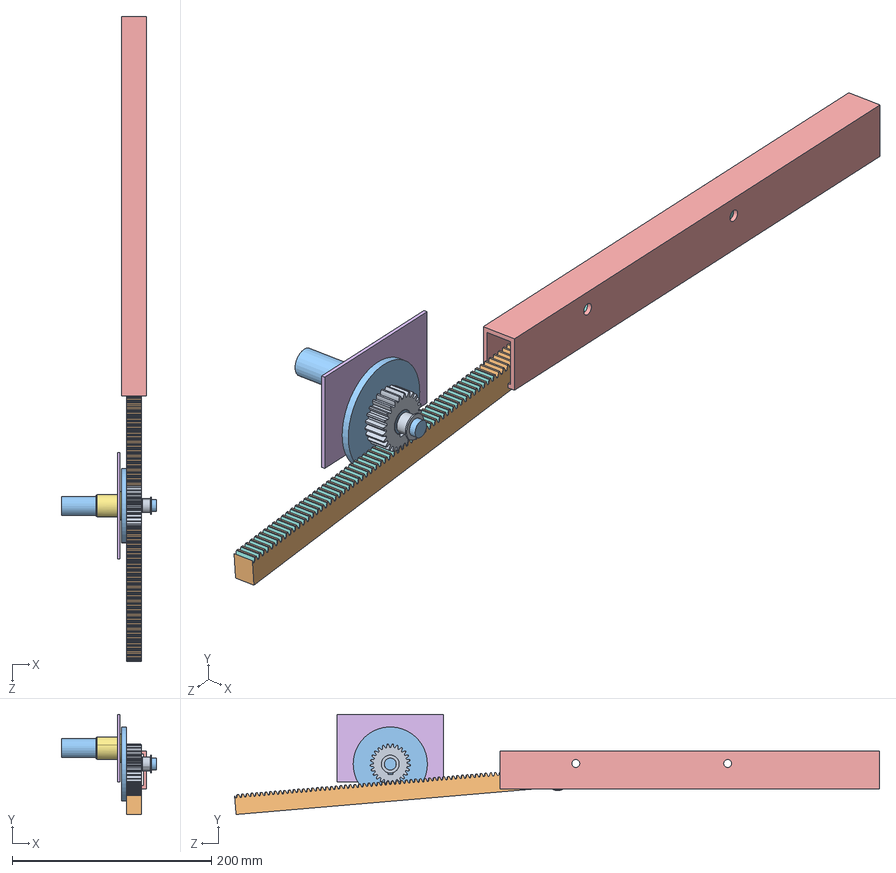
[picture p97: CAD file, 2023-08-19]
Solar Car 2022-2024/Progressive steering/Alain Model (Concept)/ProgressiveSteering-1.SLDASM
95.0 x 100.4 x 647.4 mm
SSA1_5_25J16_On
SR1_5_300_On
eccentricAxle
60645K131_Ball Joint Rod End
ouputshaft
frontPlate
igus-75
SR1_5_500_On
JFM-121418-10
