GET-RAHS/2022-2024_Sockeye/Solar Car 2022-2024/Frame/Hagen Body/Hand_R.SLDASM

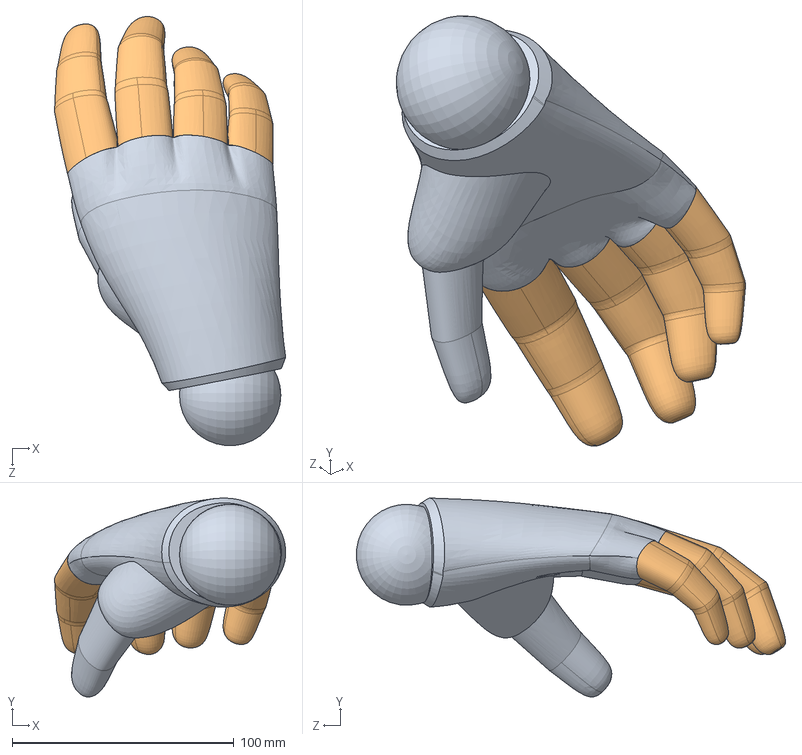
[picture p98: CAD file, 2023-08-19]
Solar Car 2022-2024/Frame/Hagen Body/Hand_R.SLDASM
104.4 x 89.8 x 193.7 mm
Hand_R
Fingers_R
