GET-RAHS/2022-2024_Sockeye/Solar Car 2022-2024/New Suspension/Rear Suspension/Rear Tube Round Suspension/Parts/SKF_6003-2Z.stp.SLDASM

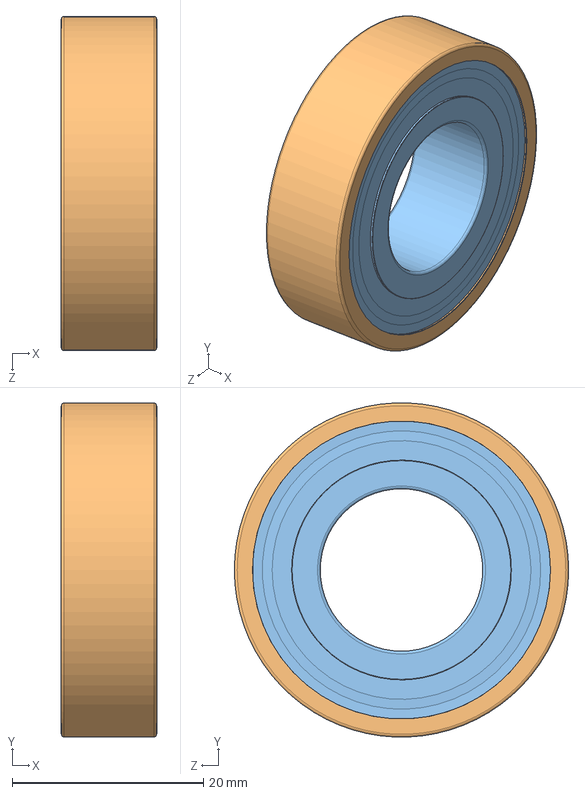
[picture p99: CAD file, 2023-08-19]
Solar Car 2022-2024/New Suspension/Rear Suspension/Rear Tube Round Suspension/Parts/SKF_6003-2Z.stp.SLDASM
10.0 x 35.0 x 35.0 mm
SKF_6003-2Z_PART3.stp x 10
SKF_6003-2Z_PART2.stp
SKF_6003-2Z_PART1.stp
