GET-RAHS/2022-2024_Sockeye/Solar Car 2022-2024/Progressive steering/Alain Model (Concept)/ProgressiveSteering.SLDASM

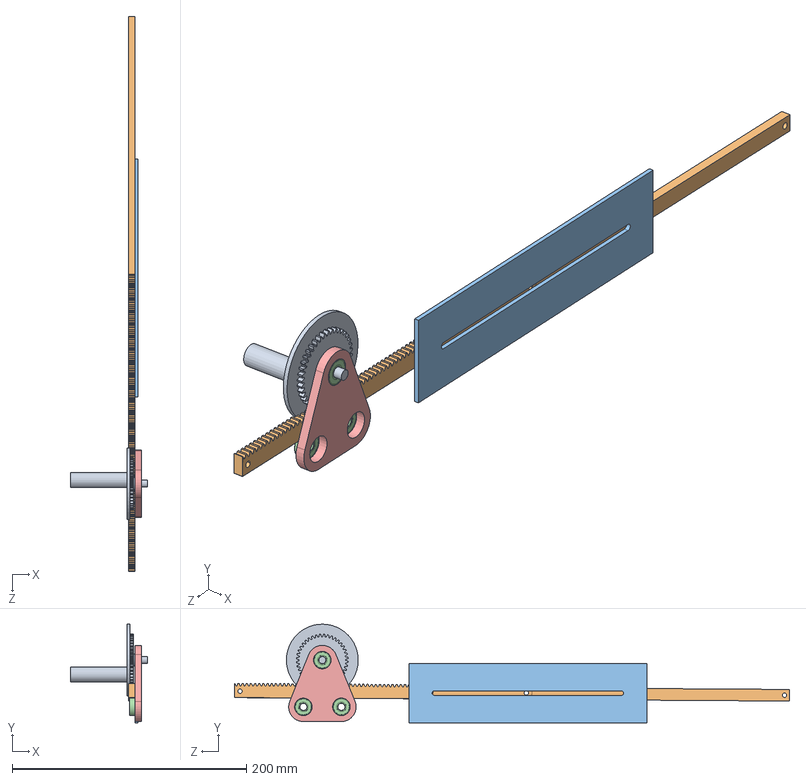
[picture p100: CAD file, 2023-08-19]
Solar Car 2022-2024/Progressive steering/Alain Model (Concept)/ProgressiveSteering.SLDASM
65.8 x 84.3 x 474.1 mm
SI_sdpsi_s1268z-024s040
SI_sdpsi_s1811y-rc-1a
slot
4668K121_Permanently Lubricated Stainless Steel Ball Bearing x 3
Part1^ProgressiveSteering
