GET-RAHS/2022-2024_Sockeye/Solar Car 2022-2024/Wheels/Dismissed/BuckSpunAll.SLDASM

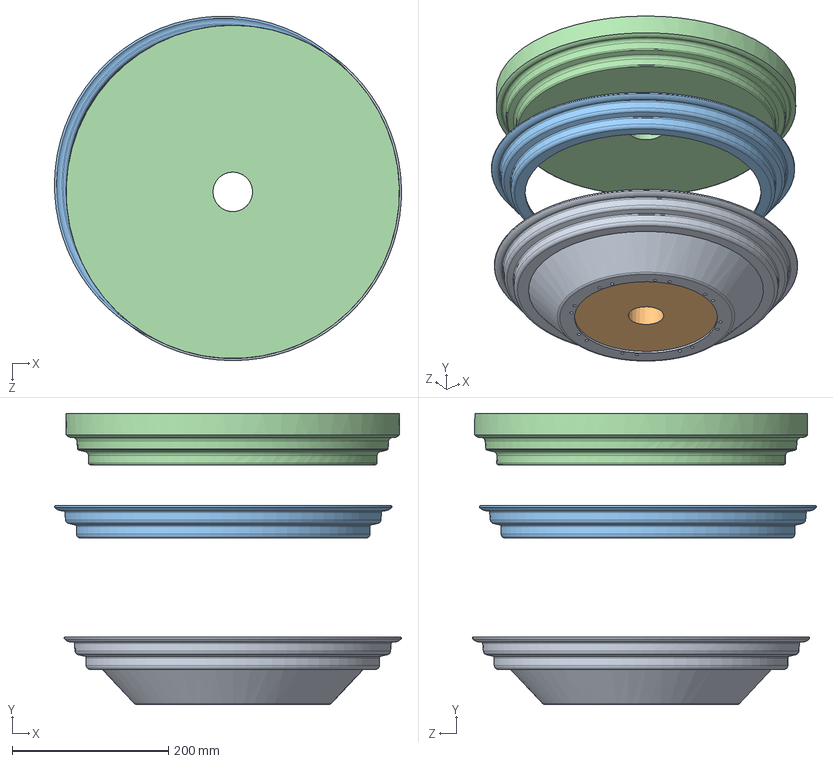
[picture p101: CAD file, 2023-08-19]
Solar Car 2022-2024/Wheels/Dismissed/BuckSpunAll.SLDASM
444.2 x 372.7 x 440.7 mm
spun wheel125-1
buck extension^BuckSpunAll
spun wheel125-2
buck Main^buck-spun
