GET-RAHS/2022-2024_Sockeye/Solar Car 2022-2024/Progressive steering/Alain Model (Concept)/progressive steering-2/SKF_NK_6_12_TN.sldasm

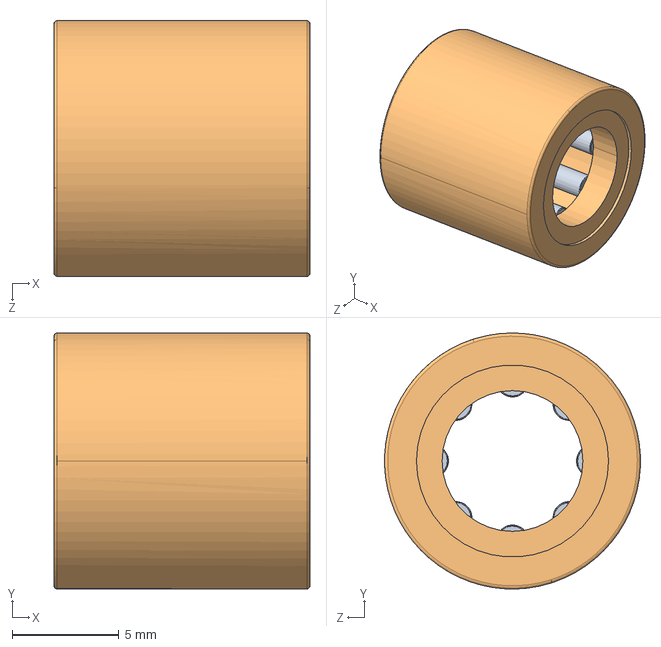
[picture p103: CAD file, 2023-08-19]
Solar Car 2022-2024/Progressive steering/Alain Model (Concept)/progressive steering-2/SKF_NK_6_12_TN.sldasm
12.0 x 12.0 x 12.0 mm
SKF_NK_6_12_TN_12 x 8
SKF_NK_6_12_TN_21
