GET-RAHS/2022-2024_Sockeye/Solar Car 2022-2024/New Suspension/Front Suspension/Assembly1/Sm.SLDASM

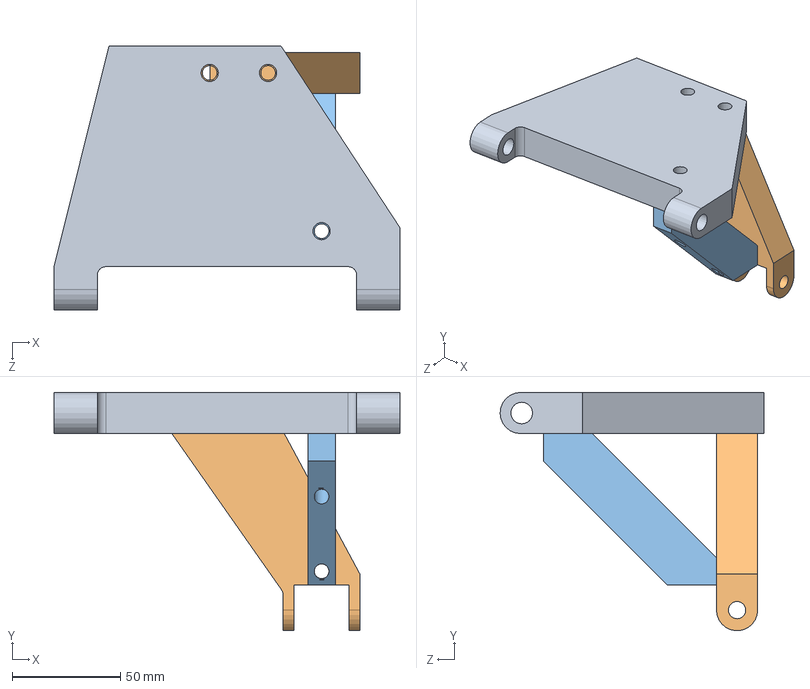
[picture p105: CAD file, 2023-08-19]
Solar Car 2022-2024/New Suspension/Front Suspension/Assembly1/Sm.SLDASM
160.0 x 110.1 x 122.0 mm
BottomWishbone
BottomShock mount
ShockBrace
