GET-RAHS/2022-2024_Sockeye/Solar Car 2022-2024/Wheels/Cup.SLDASM

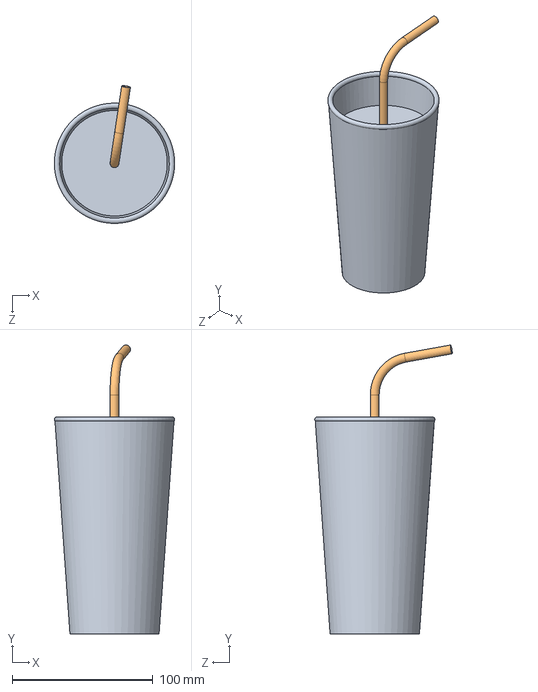
[picture p107: CAD file, 2023-08-19]
Solar Car 2022-2024/Wheels/Cup.SLDASM
85.5 x 205.3 x 97.8 mm
Cup Bottom
Straw
