GET-RAHS/2022-2024_Sockeye/Solar Car 2022-2024/Canopy/Assem1.SLDASM

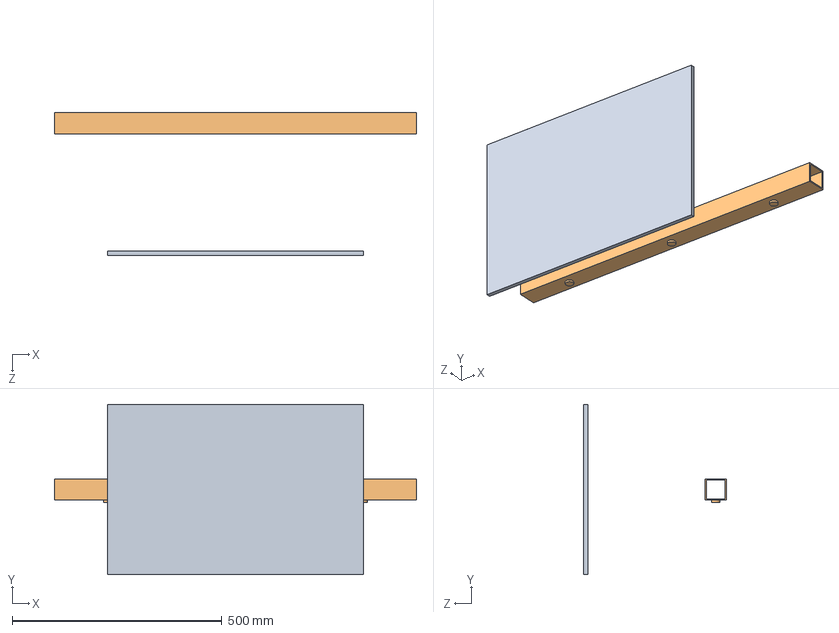
[picture p108: CAD file, 2023-08-19]
Solar Car 2022-2024/Canopy/Assem1.SLDASM
863.6 x 406.4 x 340.4 mm
hinge
Part1^Assem1
