GET-RAHS/2022-2024_Sockeye/Solar Car 2022-2024/New Suspension/Front Suspension/Assembly1/3-8-24 swivel.SLDASM

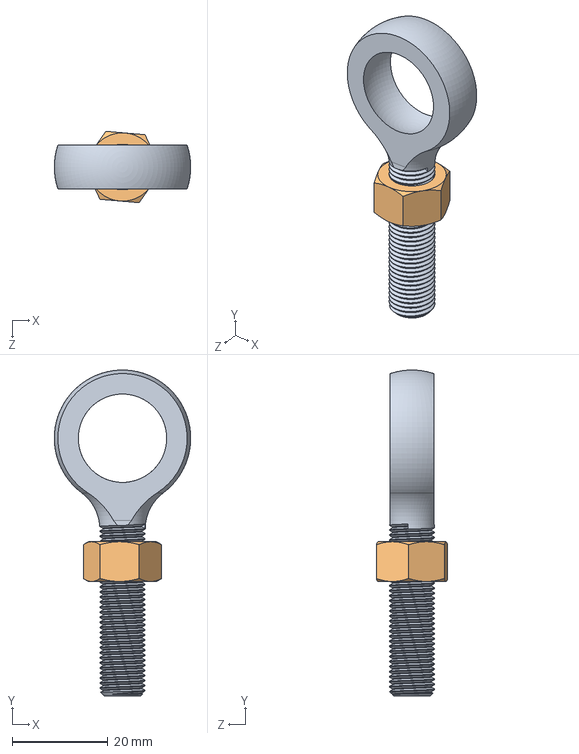
[picture p109: CAD file, 2023-08-19]
Solar Car 2022-2024/New Suspension/Front Suspension/Assembly1/3-8-24 swivel.SLDASM
28.6 x 68.3 x 14.9 mm
3-8-24 6960T231_Super-Swivel Ball Joint Rod End (1)
94895A815_High-Strength Steel Hex Nut
