GET-RAHS/2022-2024_Sockeye/Solar Car 2022-2023/misc/Estop mount-hat v2.STL

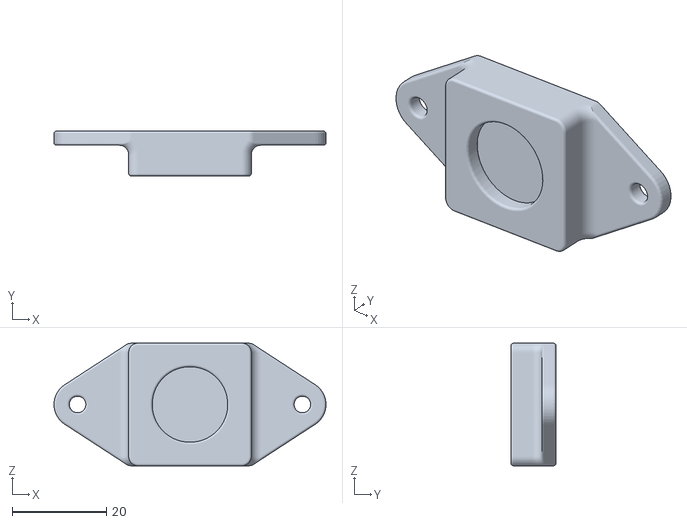
[picture p110: CAD file, 2024-01-16]
Solar Car 2022-2023/misc/Estop mount-hat v2.STL
57.7 x 9.50 x 26.0
