GET-RAHS/2022-2024_Sockeye/Solar Car 2022-2024/Aerodynamic Models/Aero Model Final/Iteration 2/Array Frame.SLDPRT

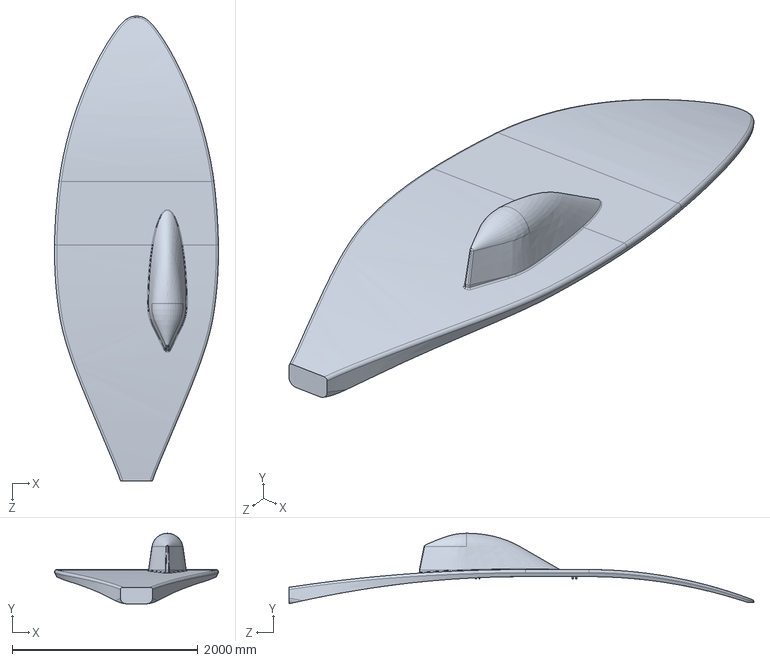
[picture p111: CAD file, 2023-08-19]
Solar Car 2022-2024/Aerodynamic Models/Aero Model Final/Iteration 2/Array Frame.SLDPRT
1763.6 x 759.2 x 4999.8 mm
