GET-RAHS/2022-2024_Sockeye/Solar Car 2022-2024/Aerodynamic Models/Aero Model Final/Iteration 3 Mid Canopy/BatteryAS.SLDPRT

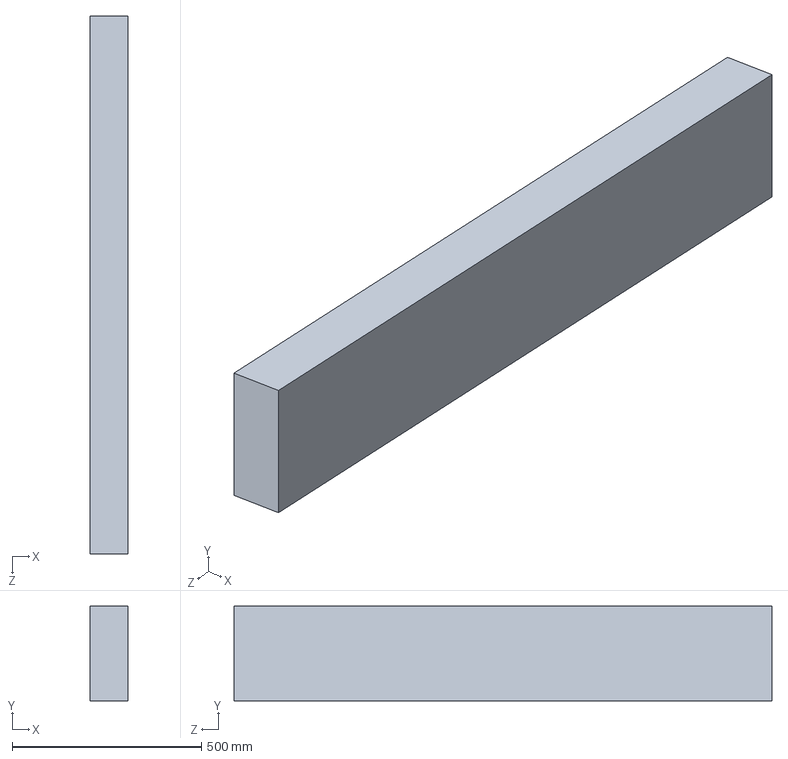
[picture p112: CAD file, 2023-08-19]
Solar Car 2022-2024/Aerodynamic Models/Aero Model Final/Iteration 3 Mid Canopy/BatteryAS.SLDPRT
100.0 x 250.0 x 1420.0 mm
