GET-RAHS/2022-2024_Sockeye/Solar Car 2022-2024/Aerodynamic Models/Aero Model Final/Mold V4/MoldTopFlange.SLDPRT

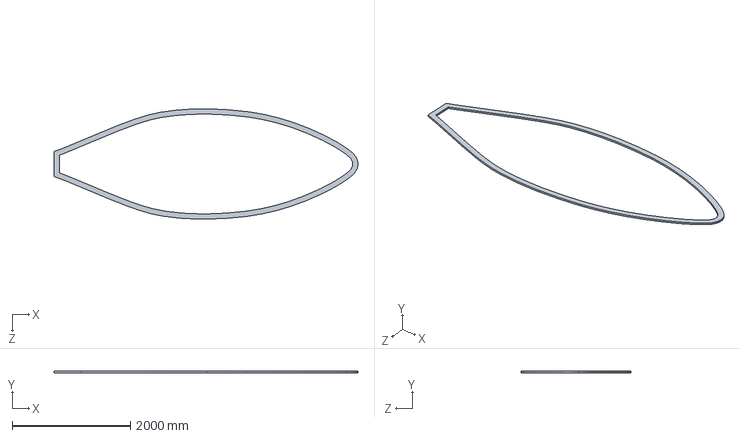
[picture p113: CAD file, 2023-08-19]
Solar Car 2022-2024/Aerodynamic Models/Aero Model Final/Mold V4/MoldTopFlange.SLDPRT
5140.4 x 25.4 x 1865.6 mm
