GET-RAHS/2022-2024_Sockeye/Solar Car 2022-2024/Aerodynamic Models/Aero Model Final/Mold/Left Top.SLDPRT

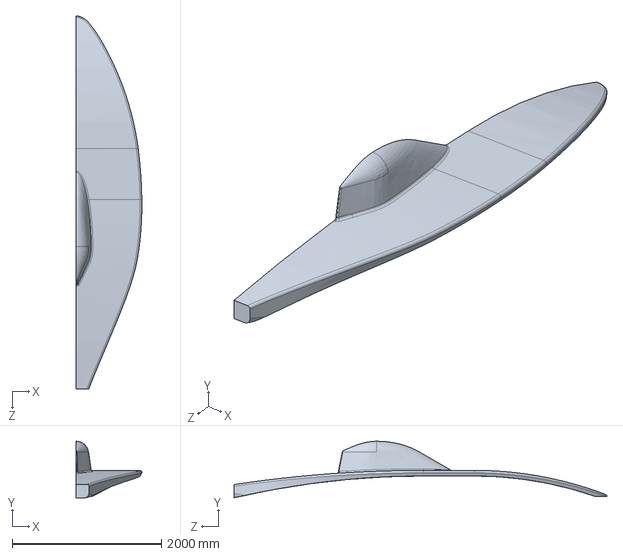
[picture p114: CAD file, 2023-08-19]
Solar Car 2022-2024/Aerodynamic Models/Aero Model Final/Mold/Left Top.SLDPRT
881.8 x 759.2 x 5000.0 mm
