GET-RAHS/2022-2024_Sockeye/Solar Car 2022-2024/Aerodynamic Models/Road.SLDPRT

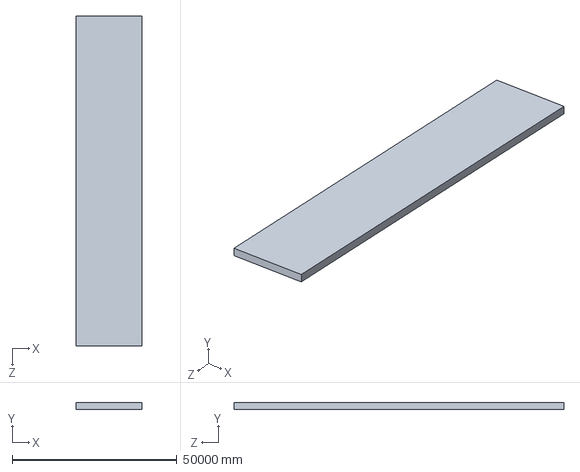
[picture p115: CAD file, 2023-08-19]
Solar Car 2022-2024/Aerodynamic Models/Road.SLDPRT
20000.0 x 2000.0 x 100000.0 mm
