GET-RAHS/2022-2024_Sockeye/Solar Car 2022-2024/Array Components/Array Frame/Top Mold.SLDPRT

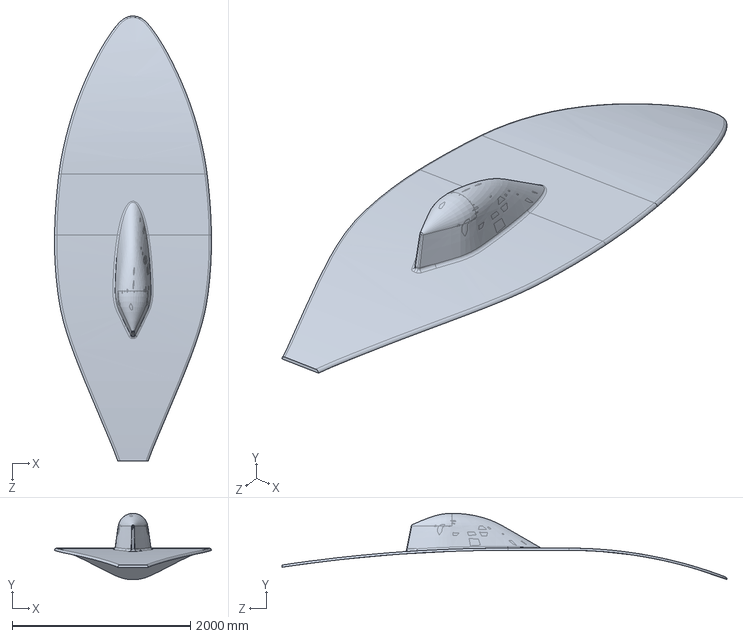
[picture p116: CAD file, 2023-08-19]
Solar Car 2022-2024/Array Components/Array Frame/Top Mold.SLDPRT
1764.1 x 746.4 x 5000.0 mm
