GET-RAHS/2022-2024_Sockeye/Solar Car 2022-2024/Array Components/Array Locking Mechanism/V4/Delrin.SLDPRT

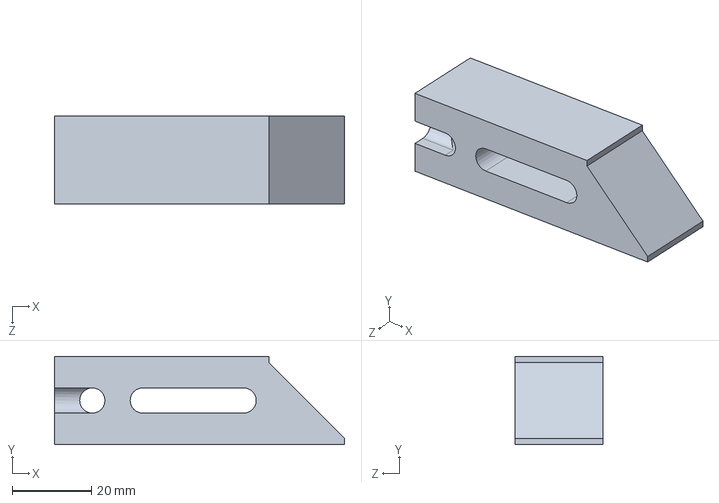
[picture p117: CAD file, 2023-08-19]
Solar Car 2022-2024/Array Components/Array Locking Mechanism/V4/Delrin.SLDPRT
73.0 x 22.2 x 22.2 mm
