GET-RAHS/2022-2024_Sockeye/Solar Car 2022-2024/Battery Box/Battery Box Lid.SLDPRT

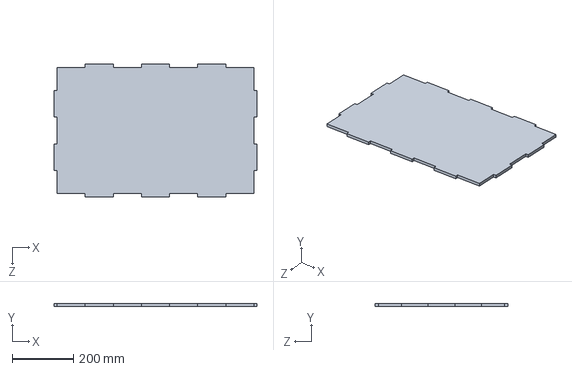
[picture p118: CAD file, 2023-08-19]
Solar Car 2022-2024/Battery Box/Battery Box Lid.SLDPRT
660.4 x 10.2 x 431.8 mm
