GET-RAHS/2022-2024_Sockeye/Solar Car 2022-2024/Canopy/Final Canopy/Windshield.step

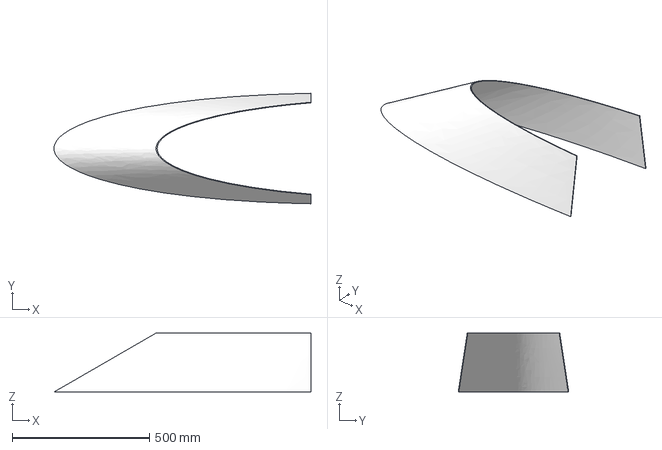
[picture p119: CAD file, 2024-01-16]
Solar Car 2022-2024/Canopy/Final Canopy/Windshield.step
936.6 x 402.9 x 214.8 mm
