GET-RAHS/2022-2024_Sockeye/Solar Car 2022-2024/Canopy/windshileld3.SLDPRT

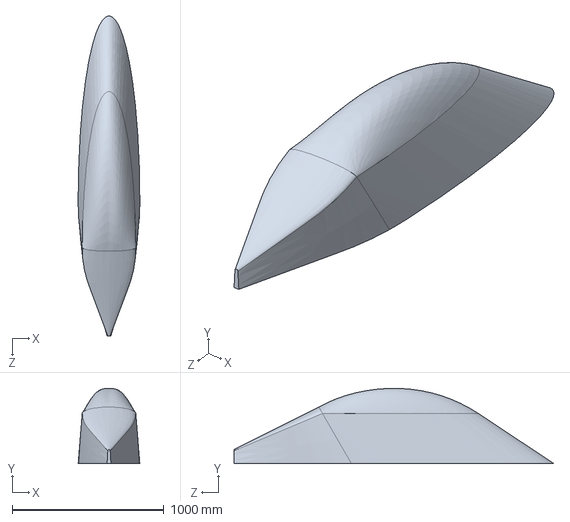
[picture p120: CAD file, 2023-08-19]
Solar Car 2022-2024/Canopy/windshileld3.SLDPRT
406.4 x 495.8 x 2108.2 mm
