GET-RAHS/2022-2024_Sockeye/Solar Car 2022-2024/dashboard/v2/dash.SLDPRT

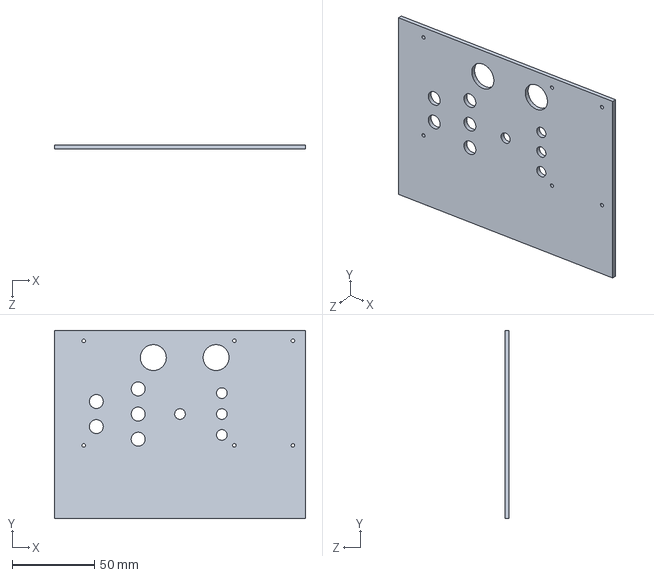
[picture p121: CAD file, 2023-08-19]
Solar Car 2022-2024/dashboard/v2/dash.SLDPRT
152.4 x 114.3 x 2.54 mm
