GET-RAHS/2022-2024_Sockeye/Solar Car 2022-2024/Destructive Testing/Crush Test/Flat Carbon Coupon.SLDPRT

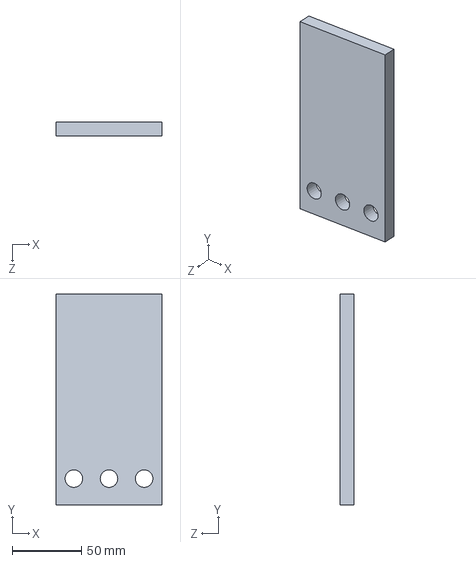
[picture p122: CAD file, 2023-08-19]
Solar Car 2022-2024/Destructive Testing/Crush Test/Flat Carbon Coupon.SLDPRT
76.2 x 152.4 x 10.2 mm
