GET-RAHS/2022-2024_Sockeye/Solar Car 2022-2024/Frame/Four Wheel Single Body Frame.SLDPRT

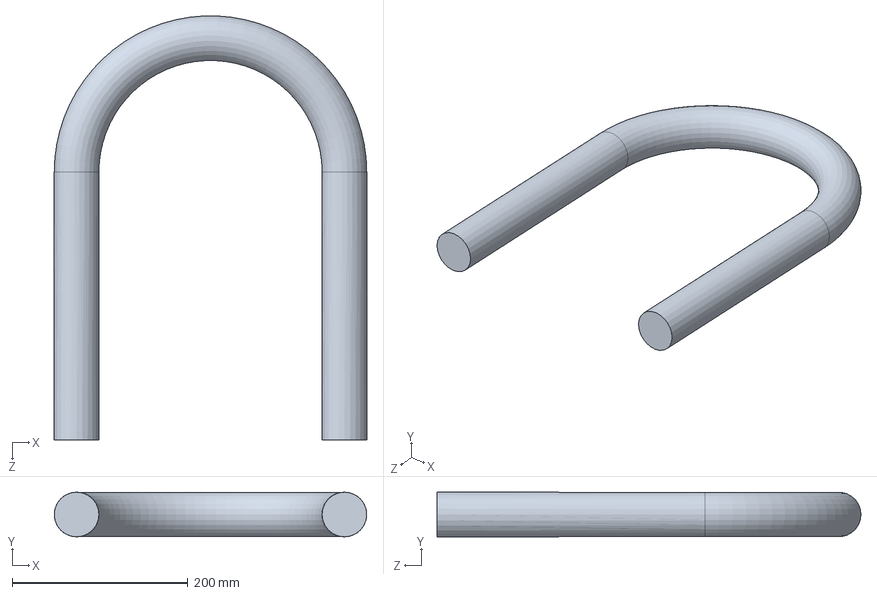
[picture p123: CAD file, 2023-08-19]
Solar Car 2022-2024/Frame/Four Wheel Single Body Frame.SLDPRT
355.6 x 50.8 x 482.4 mm
