GET-RAHS/2022-2024_Sockeye/Solar Car 2022-2024/Frame/Hagen Body/UpperArm_L.SLDPRT

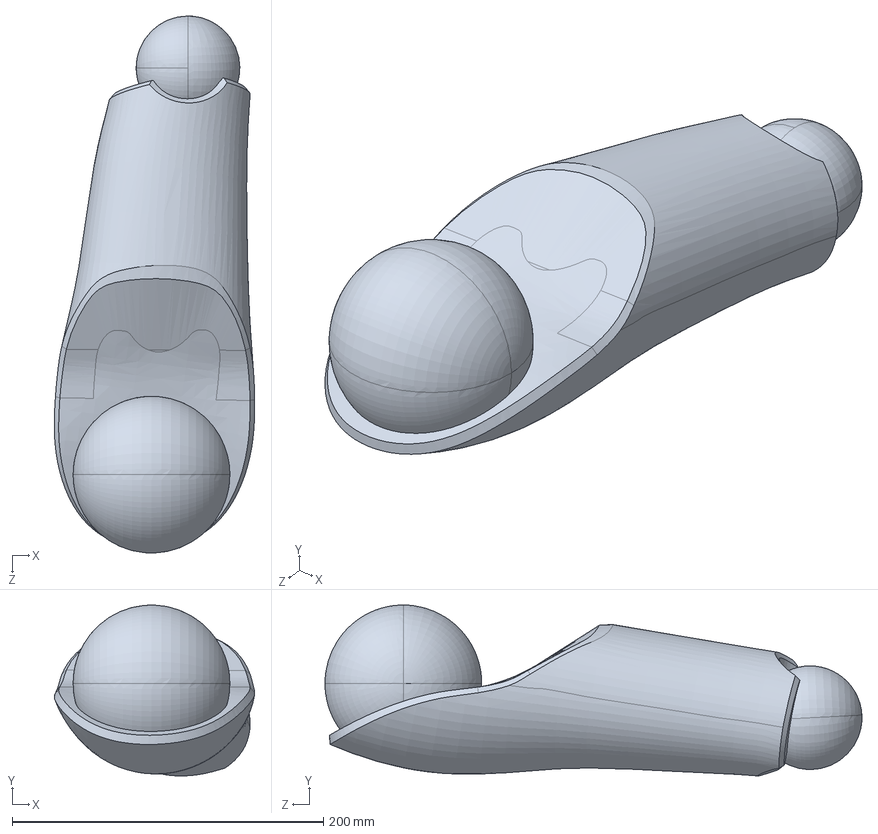
[picture p124: CAD file, 2023-08-19]
Solar Car 2022-2024/Frame/Hagen Body/UpperArm_L.SLDPRT
128.8 x 109.9 x 345.2 mm
