GET-RAHS/2022-2024_Sockeye/Solar Car 2022-2024/Insert/0.25 Insert.SLDPRT

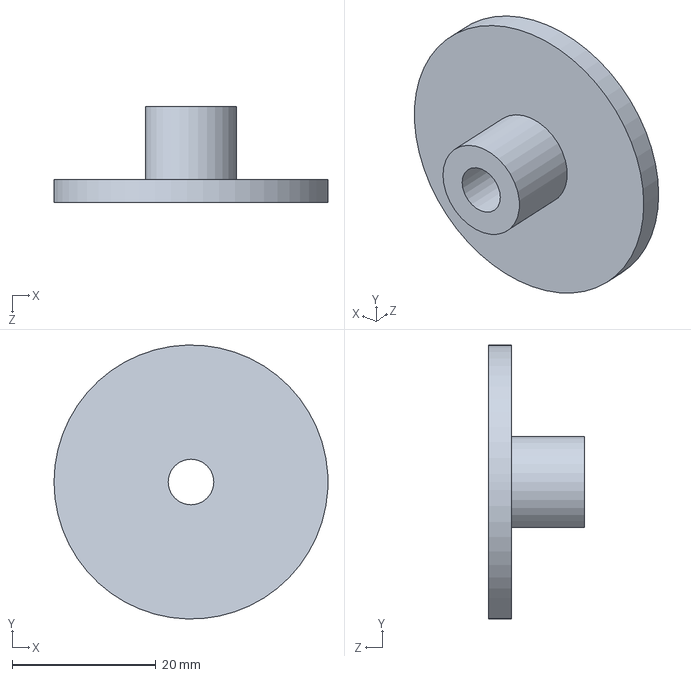
[picture p125: CAD file, 2023-08-19]
Solar Car 2022-2024/Insert/0.25 Insert.SLDPRT
38.1 x 38.1 x 13.3 mm
