GET-RAHS/2022-2024_Sockeye/Solar Car 2022-2024/Mock Battery/New Battery (Model).SLDPRT

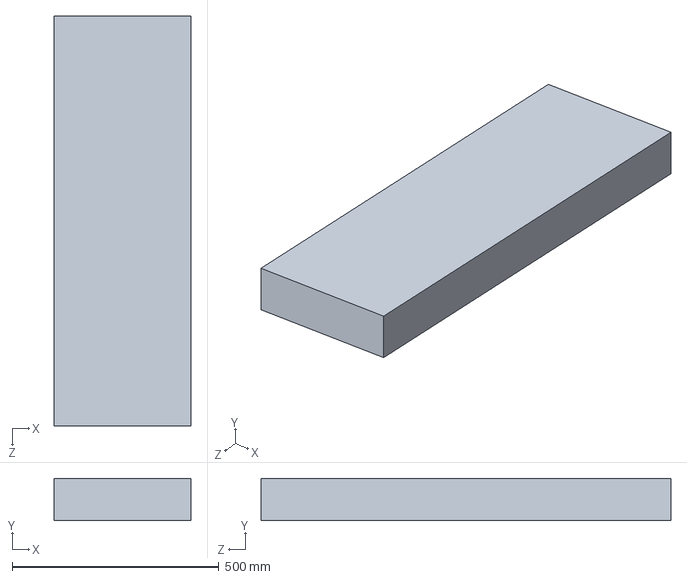
[picture p126: CAD file, 2023-08-19]
Solar Car 2022-2024/Mock Battery/New Battery (Model).SLDPRT
330.2 x 101.6 x 990.6 mm
