GET-RAHS/2022-2024_Sockeye/Solar Car 2022-2024/Mock Parts/Mockpit/Mockpit Laser Cut.dxf

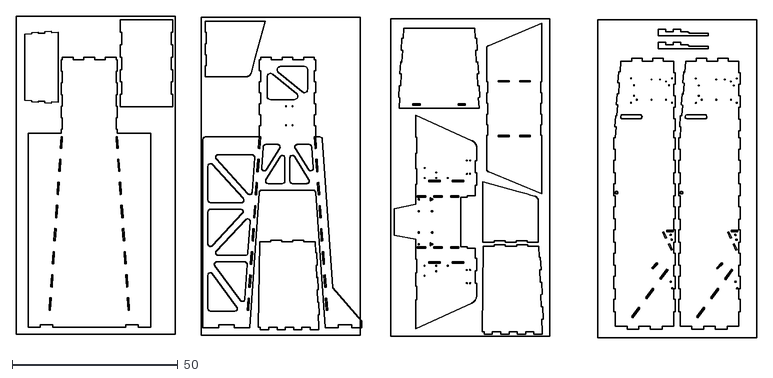
[picture p127: CAD file, 2023-08-19]
Solar Car 2022-2024/Mock Parts/Mockpit/Mockpit Laser Cut.dxf
223.4 x 97.0
