GET-RAHS/2022-2024_Sockeye/Solar Car 2022-2024/Mock Parts/Mockpit/New DXF/Seat Back.DXF

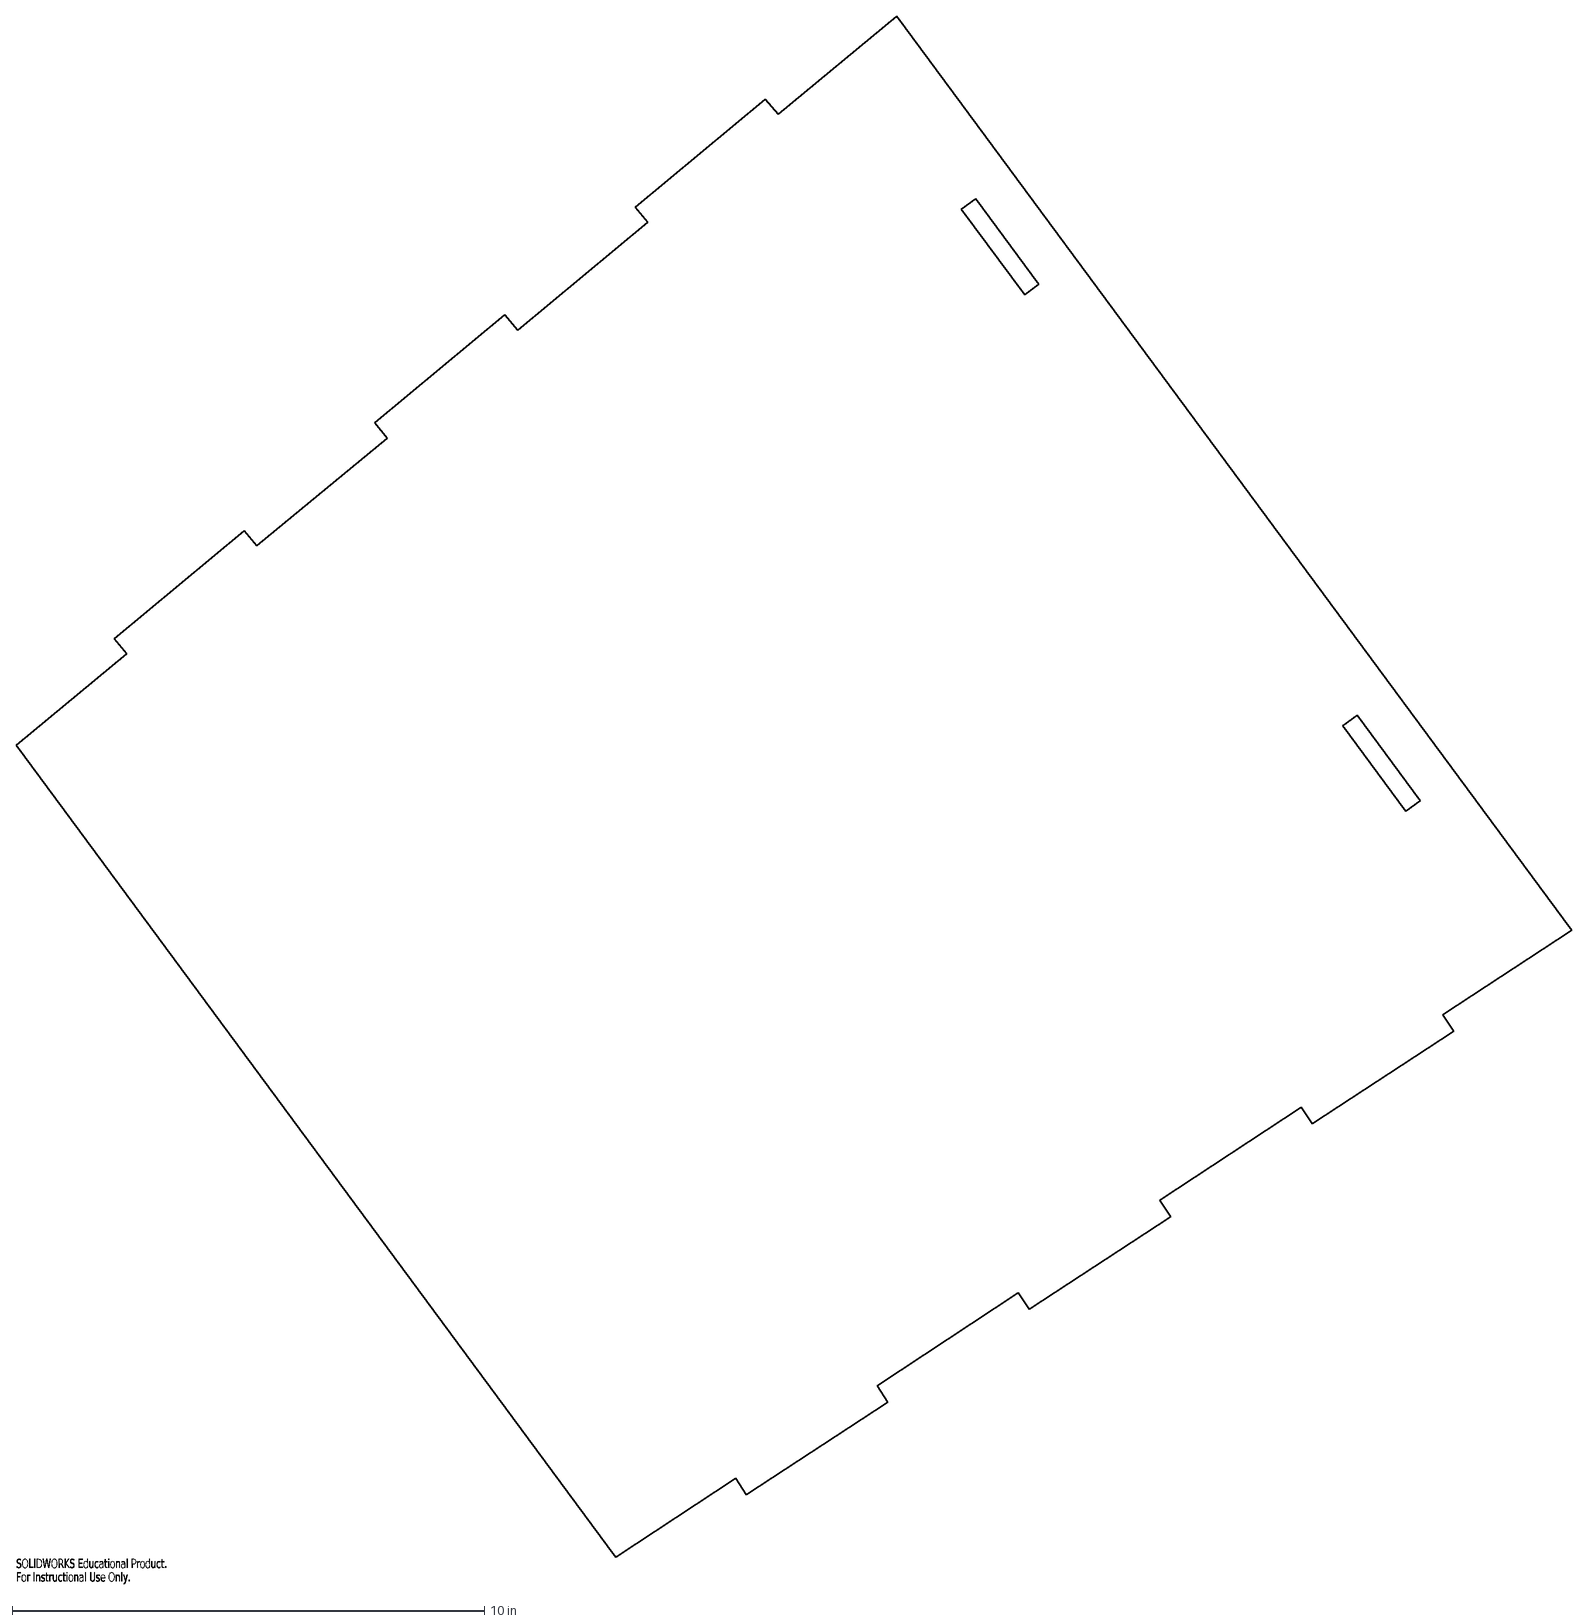
[picture p128: CAD file, 2023-08-19]
Solar Car 2022-2024/Mock Parts/Mockpit/New DXF/Seat Back.DXF
SOLIDWORKS Educational Product.
For Instructional Use Only.
