GET-RAHS/2022-2024_Sockeye/Solar Car 2022-2024/Mock Parts/RearHaloMount.SLDPRT

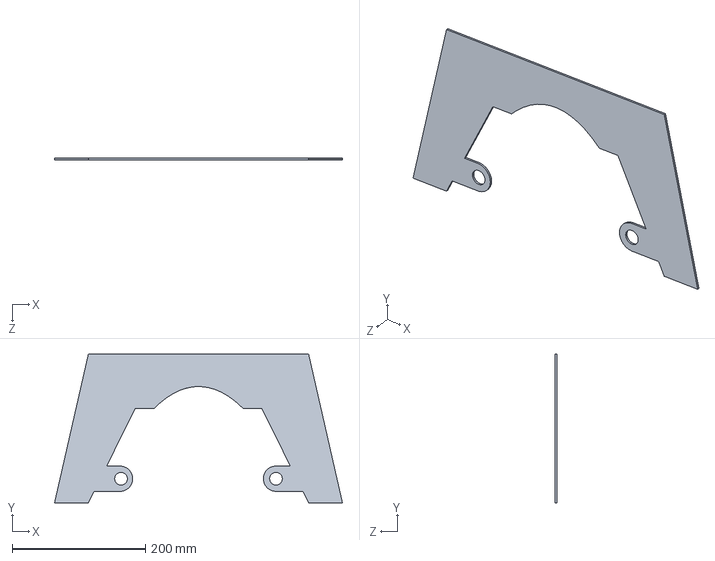
[picture p129: CAD file, 2023-08-19]
Solar Car 2022-2024/Mock Parts/RearHaloMount.SLDPRT
431.9 x 223.2 x 2.54 mm
