GET-RAHS/2022-2024_Sockeye/Solar Car 2022-2024/New Suspension/Front Suspension/Assembly0/0extender.SLDPRT

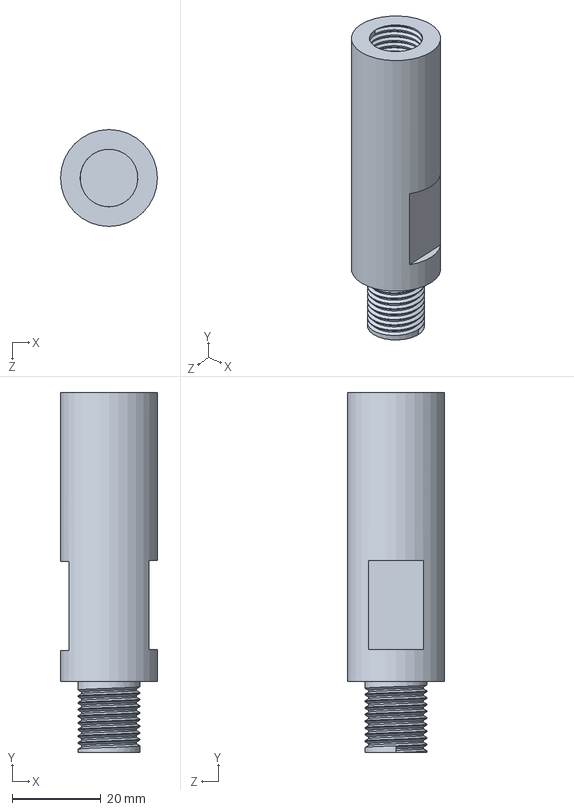
[picture p130: CAD file, 2023-08-19]
Solar Car 2022-2024/New Suspension/Front Suspension/Assembly0/0extender.SLDPRT
21.8 x 81.0 x 21.8 mm
