GET-RAHS/2022-2024_Sockeye/Solar Car 2022-2024/New Suspension/Front Suspension/Assembly4-5/BasicBrakeDisc.SLDPRT

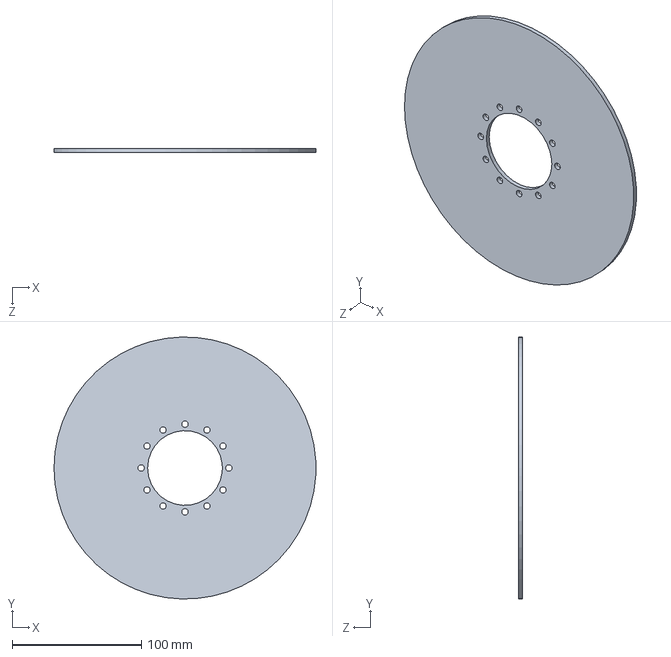
[picture p131: CAD file, 2023-08-19]
Solar Car 2022-2024/New Suspension/Front Suspension/Assembly4-5/BasicBrakeDisc.SLDPRT
203.0 x 202.9 x 3.17 mm
