GET-RAHS/2022-2024_Sockeye/Solar Car 2022-2024/New Suspension/Front Suspension/ASSY4-5II/BottomWishbone.SLDPRT

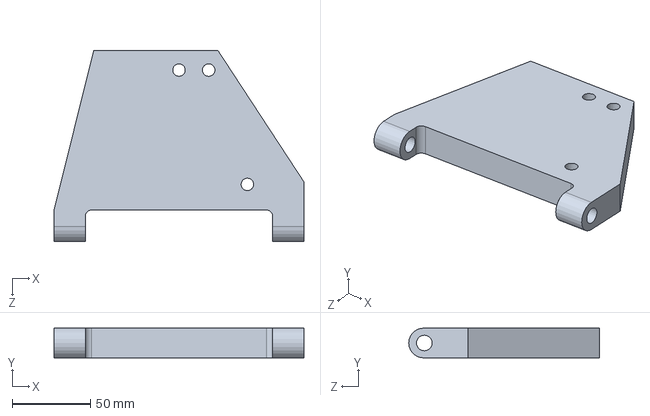
[picture p132: CAD file, 2023-08-19]
Solar Car 2022-2024/New Suspension/Front Suspension/ASSY4-5II/BottomWishbone.SLDPRT
160.0 x 19.1 x 122.0 mm
