GET-RAHS/2022-2024_Sockeye/Solar Car 2022-2024/New Suspension/Front Suspension/ASSY4-5III/Shock Anchor_11.SLDPRT

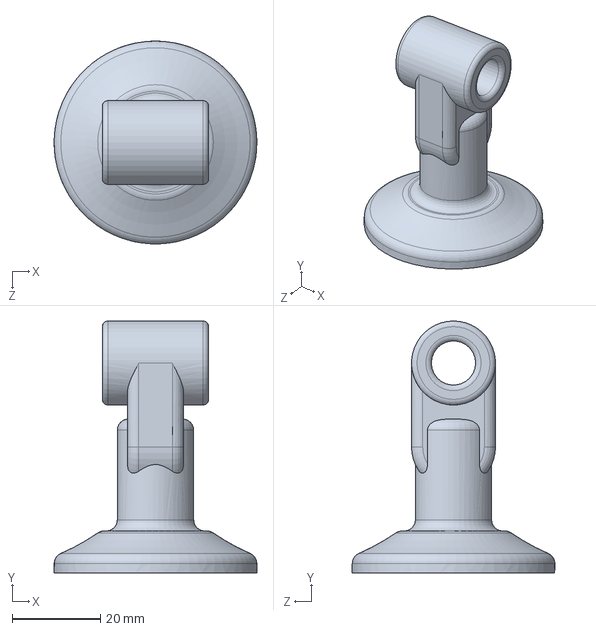
[picture p133: CAD file, 2023-08-19]
Solar Car 2022-2024/New Suspension/Front Suspension/ASSY4-5III/Shock Anchor_11.SLDPRT
46.0 x 57.2 x 46.0 mm
