GET-RAHS/2022-2024_Sockeye/Solar Car 2022-2024/New Suspension/Front Suspension/Assy5/Shock Absorber Rod_11.SLDPRT

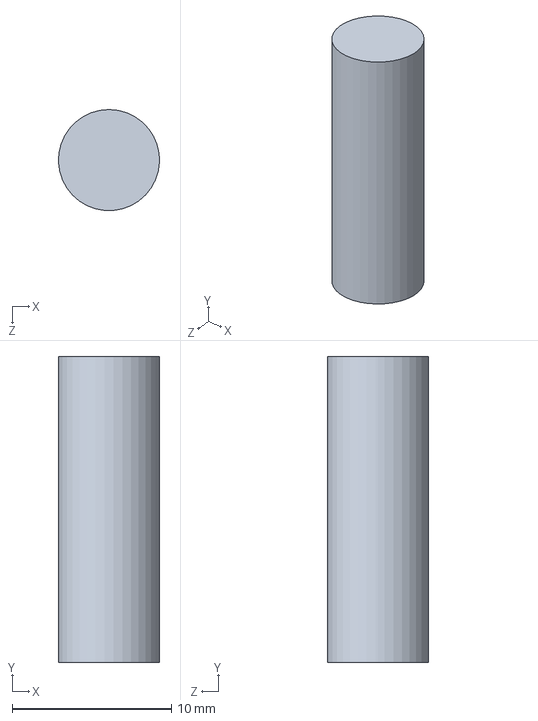
[picture p134: CAD file, 2023-08-19]
Solar Car 2022-2024/New Suspension/Front Suspension/Assy5/Shock Absorber Rod_11.SLDPRT
6.35 x 19.2 x 6.34 mm
