GET-RAHS/2022-2024_Sockeye/Solar Car 2022-2024/New Suspension/Front Suspension/Assy6/TopSteerimgArm17.SLDPRT

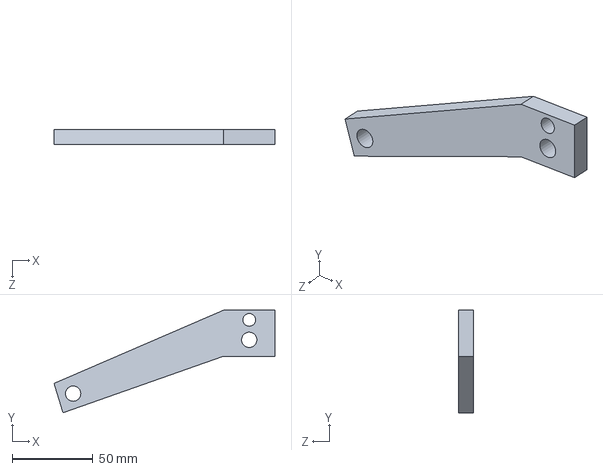
[picture p135: CAD file, 2023-08-19]
Solar Car 2022-2024/New Suspension/Front Suspension/Assy6/TopSteerimgArm17.SLDPRT
137.2 x 63.7 x 9.53 mm
