GET-RAHS/2022-2024_Sockeye/Solar Car 2022-2024/New Suspension/Front Suspension/SteeringArmMount.SLDPRT

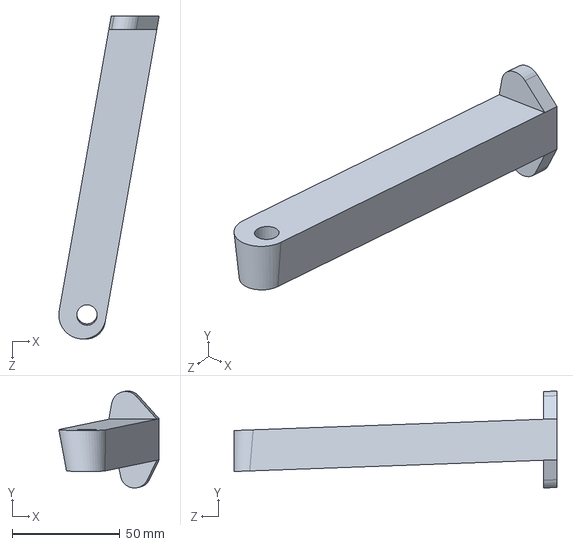
[picture p136: CAD file, 2023-08-19]
Solar Car 2022-2024/New Suspension/Front Suspension/SteeringArmMount.SLDPRT
46.6 x 45.0 x 150.0 mm
