GET-RAHS/2022-2024_Sockeye/Solar Car 2022-2024/New Suspension/Front Suspension/SteeringAssy/GussetSteering.SLDPRT

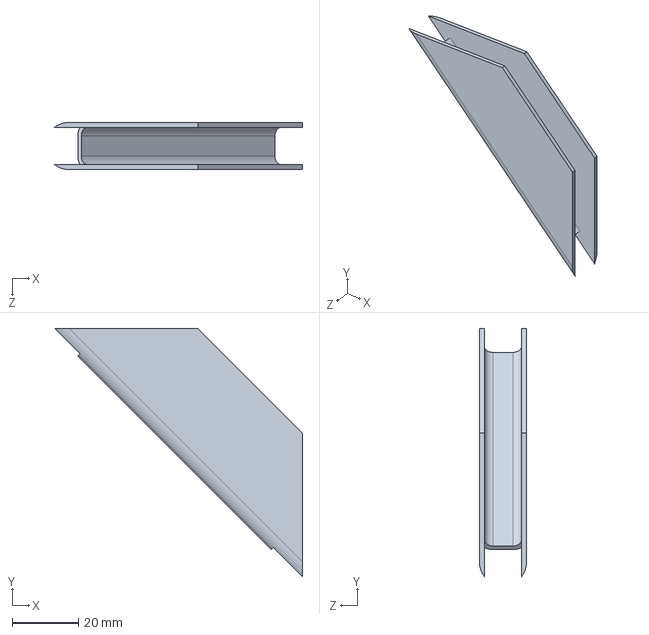
[picture p137: CAD file, 2023-08-19]
Solar Car 2022-2024/New Suspension/Front Suspension/SteeringAssy/GussetSteering.SLDPRT
74.8 x 74.8 x 14.2 mm
