GET-RAHS/2022-2024_Sockeye/Solar Car 2022-2024/New Suspension/Lovie-Rear/Rear Suspension/SR (axel).SLDPRT

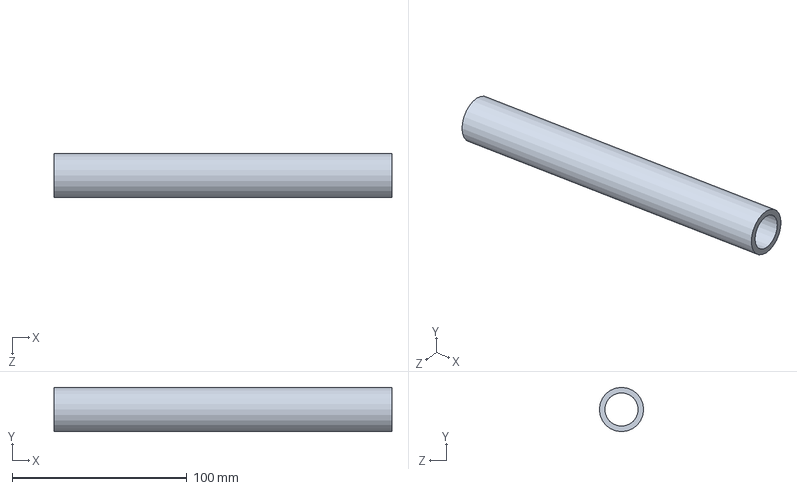
[picture p138: CAD file, 2023-08-19]
Solar Car 2022-2024/New Suspension/Lovie-Rear/Rear Suspension/SR (axel).SLDPRT
193.7 x 25.4 x 25.4 mm
