GET-RAHS/2022-2024_Sockeye/Solar Car 2022-2024/New Suspension/Rear Suspension/Rear Free Spinning Wheel/Brake Standoff.SLDPRT

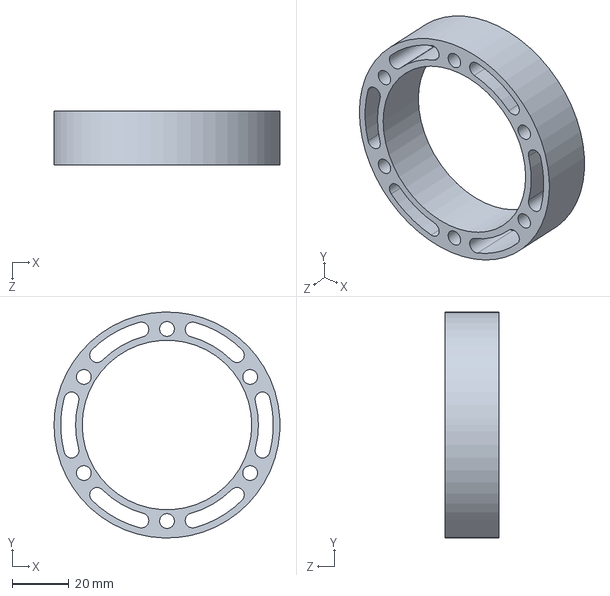
[picture p139: CAD file, 2023-08-19]
Solar Car 2022-2024/New Suspension/Rear Suspension/Rear Free Spinning Wheel/Brake Standoff.SLDPRT
80.0 x 80.0 x 19.0 mm
