GET-RAHS/2022-2024_Sockeye/Solar Car 2022-2024/New Suspension/Rear Suspension/Rear Tube Suspension/Parts/Rear Suspension Mount V2/Rear Suspension Low Mount V2.SLDPRT

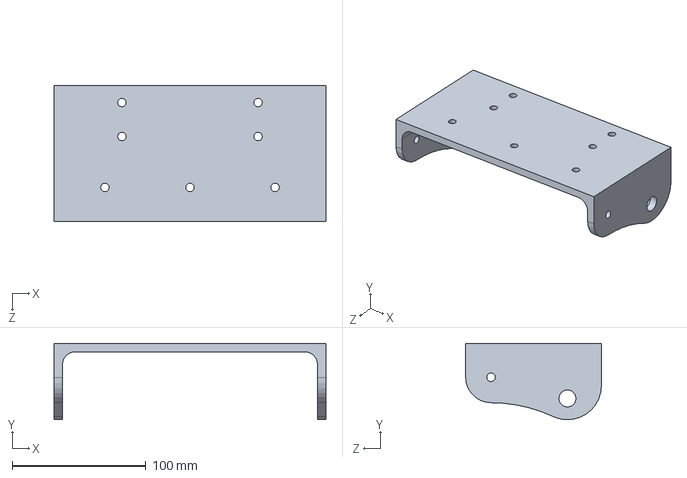
[picture p140: CAD file, 2023-08-19]
Solar Car 2022-2024/New Suspension/Rear Suspension/Rear Tube Suspension/Parts/Rear Suspension Mount V2/Rear Suspension Low Mount V2.SLDPRT
203.5 x 57.1 x 101.6 mm
