GET-RAHS/2022-2024_Sockeye/Solar Car 2022-2024/New Suspension/Rear Suspension/Strut Suspension/Rear Suspension Mount.SLDPRT

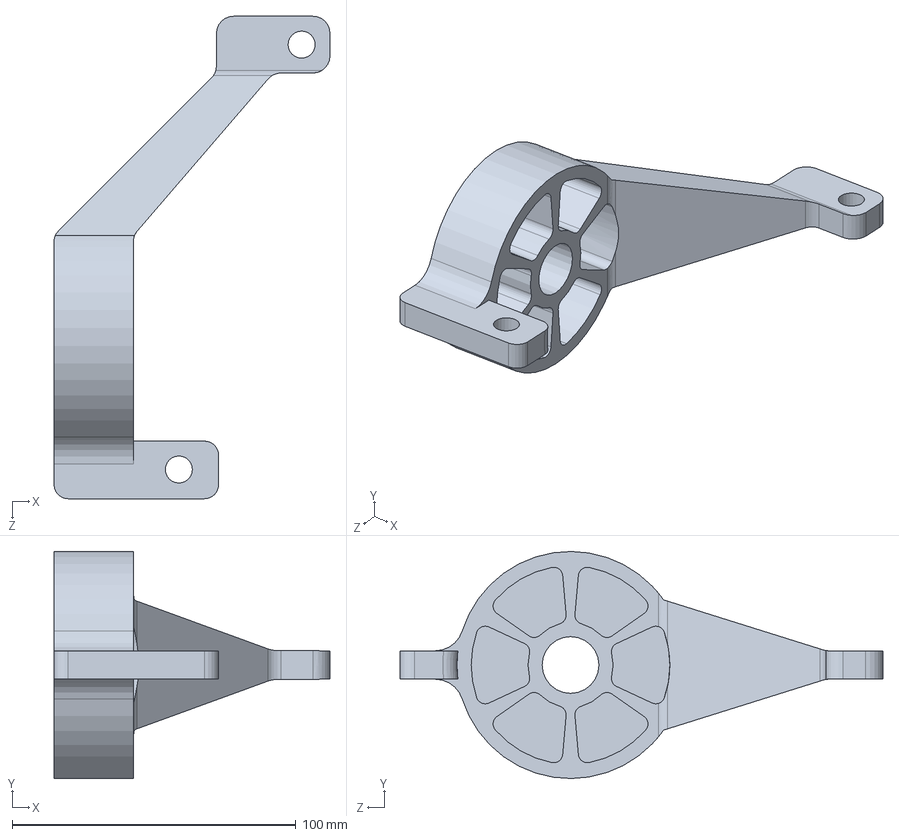
[picture p141: CAD file, 2023-08-19]
Solar Car 2022-2024/New Suspension/Rear Suspension/Strut Suspension/Rear Suspension Mount.SLDPRT
97.2 x 80.0 x 170.0 mm
