GET-RAHS/2022-2024_Sockeye/Solar Car 2022-2024/New Suspension/Front Suspension/Assembly0/0Shock.SLDASM

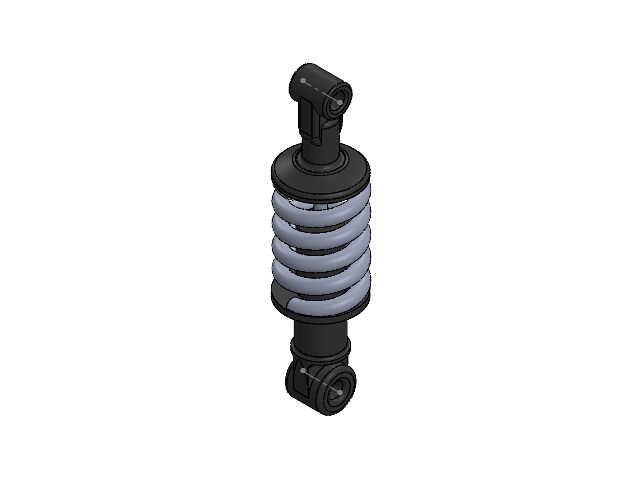
[picture p142: CAD file, 2023-08-19]
Solar Car 2022-2024/New Suspension/Front Suspension/Assembly0/0Shock.SLDASM
0Shock Anchor_11
0Shock Tube 1_11
0Shock Absorber Rod_11
0Shock Spring_11
