GET-RAHS/2022-2024_Sockeye/Solar Car 2022-2024/New Suspension/Front Suspension/Assembly0/0steering assembly.SLDASM

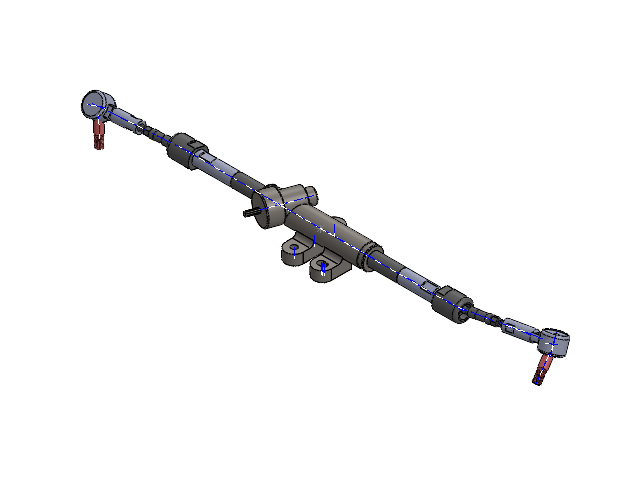
[picture p143: CAD file, 2023-08-19]
Solar Car 2022-2024/New Suspension/Front Suspension/Assembly0/0steering assembly.SLDASM
0prebuilt housing
0prebuilt rack
0prebuilt ball joint x 2
0prebuilt ball joint end x 2
0ball end joint conection piece x 2
0rackBallEnd x 2
