GET-RAHS/2022-2024_Sockeye/(list of files, cad)

Other CAD files:
Solar Car 2022-2024/Frame/Hagen Body/Unit/Articulated_Dummy.SLDASM
Solar Car 2022-2024/New Suspension/Rear Suspension/Rear Tube Suspension/MirrorRear Suspension Assembly.SLDASM
Solar Car 2022-2024/Steering wheel/Kailh Polia_1.step.SLDASM
Solar Car 2022-2024/New Suspension/Rear Suspension/Rear Tube Suspension/Assembly/MirrorRear Motor Arm Assembly.SLDASM
Solar Car 2022-2024/Roll Bar/Main Roll Bar.SLDPRT
Solar Car 2022-2024/New Suspension/Rear Suspension/Rear Tube Suspension/MirrorRear Suspension Assembly1.SLDASM
Solar Car 2022-2024/Parts To Be Machined/Carbon Fabric Cut/Full Carbon Fabric Cut.dwg
Solar Car 2022-2024/Wheels/SKF_CAD_MODEL_SKF_6003-2Z/SOLIDWORKS/SKF_6003_2Z.sldasm
Solar Car 2022-2024/New Suspension/Front Suspension/Assy5/Shock.SLDASM
Solar Car 2022-2024/New Suspension/Front Suspension/Assy6/Shock.SLDASM
Solar Car 2022-2024/Wheels/MisubaDiskWheel.SLDASM
Solar Car 2022-2024/New Suspension/Front Suspension/ASSY4-5III/Shock.SLDASM
Solar Car 2022-2024/New Suspension/Front Suspension/SteeringAssy/steering assembly.SLDASM
Solar Car 2022-2024/New Suspension/Front Suspension/ASSY4-5II/steering assembly.SLDASM
Solar Car 2022-2024/New Suspension/Rear Suspension/Rear Tube Round Suspension/Parts/Shock Assembly.stp
Solar Car 2022-2024/Wheels/Nomura Hubs Replications Hagen/nomurahub.SLDASM
Solar Car 2022-2024/Pedal Units/braking system/micro switch.SLDASM
Solar Car 2022-2024/New Suspension/Front Suspension/Assy7/Shock.SLDASM
Solar Car 2022-2024/Frame/Hagen Body/Hand_L.SLDASM
Solar Car 2022-2024/New Suspension/Rear Suspension/Rear Tube Suspension/Parts/Shock Assembly.stp
Solar Car 2022-2024/Canopy/Assem13.SLDASM
Solar Car 2022-2024/New Suspension/Front Suspension/MirrorNewShockWheeland Suspension.SLDASM
Solar Car 2022-2024/New Suspension/Front Suspension/Assembly4-5/Shock.SLDASM
Solar Car 2022-2024/New Suspension/Front Suspension/Assembly4-5/steering assembly.SLDASM
Solar Car 2022-2024/New Suspension/Front Suspension/Shock.SLDASM
Solar Car 2022-2024/New Suspension/Front Suspension/MirrorWheel and Suspension1.SLDASM
Solar Car 2022-2024/New Suspension/Front Suspension/MirrorWheel and Suspension.SLDASM
Solar Car 2022-2024/New Suspension/Front Suspension/ShockFlip.SLDASM
Solar Car 2022-2024/New Suspension/Front Suspension/MirrorNewShockWheeland Suspension1.SLDASM
Solar Car 2022-2024/New Suspension/Front Suspension/3-8-24 swivel.SLDASM
Solar Car 2022-2024/Electrical/Interconnecting Board Layout.dwg
Solar Car 2022-2024/Master Diagram 2022-23.dwg
Solar Car 2022-2024/Mock Parts/Mockpit/DWG/Top Cover.dwg
Solar Car 2022-2024/New Suspension/Front Suspension/rack and pinion assembly/prebuilt rack and pinion/extender.SLDPRT
Solar Car 2022-2024/New Suspension/Rear Suspension/Rear Suspension Fork/MirrorRear Fork V2.SLDPRT
Solar Car 2022-2024/New Suspension/Rear Suspension/Rear Tube Suspension/Parts/MirrorBrake Bracket.SLDPRT
Solar Car 2022-2023/misc/Estop mount-hat.SLDPRT
Solar Car 2022-2023/misc/Estop mount-hat.STL
Solar Car 2022-2023/misc/air filter mount.SLDPRT
Solar Car 2022-2023/misc/magnet mountn for wheel covers.SLDPRT
Solar Car 2022-2023/misc/magnet mountn for wheel covers.STL
Solar Car 2022-2024/Aerodynamic Models/Aero Model Final/Iteration 1 Mid Canopy/Car Body.SLDPRT
Solar Car 2022-2024/Aerodynamic Models/Aero Model Final/Iteration 1 Mid Canopy/Panel Body.SLDPRT
Solar Car 2022-2024/Aerodynamic Models/Aero Model Final/Iteration 1/2022 - 2023 Aero-Shell.SLDPRT
Solar Car 2022-2024/Aerodynamic Models/Aero Model Final/Iteration 1/2022 - 2023 Aero.SLDPRT
Solar Car 2022-2024/Aerodynamic Models/Aero Model Final/Iteration 1/Array Structure.SLDPRT
Solar Car 2022-2024/Aerodynamic Models/Aero Model Final/Iteration 1/Car Body.SLDPRT
Solar Car 2022-2024/Aerodynamic Models/Aero Model Final/Iteration 2 Mid Canopy/Body Frame.SLDPRT
Solar Car 2022-2024/Aerodynamic Models/Aero Model Final/Iteration 2 Mid Canopy/Canopy.SLDPRT
Solar Car 2022-2024/Aerodynamic Models/Aero Model Final/Iteration 2 Mid Canopy/Interior Frame V2/Array Support Backing Plate.SLDPRT
Solar Car 2022-2024/Aerodynamic Models/Aero Model Final/Iteration 2 Mid Canopy/Interior Frame V2/Battery Side Holder.SLDPRT
Solar Car 2022-2024/Aerodynamic Models/Aero Model Final/Iteration 2 Mid Canopy/Interior Frame V2/Battery Tray.SLDPRT
Solar Car 2022-2024/Aerodynamic Models/Aero Model Final/Iteration 2 Mid Canopy/Interior Frame V2/Bottom Seatbelt Holder.SLDPRT
Solar Car 2022-2024/Aerodynamic Models/Aero Model Final/Iteration 2 Mid Canopy/Interior Frame V2/Floor Panel.SLDPRT
Solar Car 2022-2024/Aerodynamic Models/Aero Model Final/Iteration 2 Mid Canopy/Interior Frame V2/Front Bulkhead.DXF
Solar Car 2022-2024/Aerodynamic Models/Aero Model Final/Iteration 2 Mid Canopy/Interior Frame V2/Front Bulkhead.SLDPRT
Solar Car 2022-2024/Aerodynamic Models/Aero Model Final/Iteration 2 Mid Canopy/Interior Frame V2/Interior Frame.SLDASM
Solar Car 2022-2024/Aerodynamic Models/Aero Model Final/Iteration 2 Mid Canopy/Interior Frame V2/MirrorPart11.SLDPRT
Solar Car 2022-2024/Aerodynamic Models/Aero Model Final/Iteration 2 Mid Canopy/Interior Frame V2/Part11.SLDPRT
Solar Car 2022-2024/Aerodynamic Models/Aero Model Final/Iteration 2 Mid Canopy/Interior Frame V2/Part12.SLDPRT
Solar Car 2022-2024/Aerodynamic Models/Aero Model Final/Iteration 2 Mid Canopy/Interior Frame V2/Part13.SLDPRT
Solar Car 2022-2024/Aerodynamic Models/Aero Model Final/Iteration 2 Mid Canopy/Interior Frame V2/Part14.SLDPRT
Solar Car 2022-2024/Aerodynamic Models/Aero Model Final/Iteration 2 Mid Canopy/Interior Frame V2/Part15.SLDPRT
Solar Car 2022-2024/Aerodynamic Models/Aero Model Final/Iteration 2 Mid Canopy/Interior Frame V2/Part19.SLDPRT
Solar Car 2022-2024/Aerodynamic Models/Aero Model Final/Iteration 2 Mid Canopy/Interior Frame V2/Rear Suspension Lower Backing Plate.SLDPRT
Solar Car 2022-2024/Aerodynamic Models/Aero Model Final/Iteration 2 Mid Canopy/Interior Frame V2/Rear Wing.SLDPRT
Solar Car 2022-2024/Aerodynamic Models/Aero Model Final/Iteration 2 Mid Canopy/Interior Frame V2/RearSuspensionBracketInside.SLDPRT
Solar Car 2022-2024/Aerodynamic Models/Aero Model Final/Iteration 2 Mid Canopy/Interior Frame V2/RearSuspensionBracketOutside.SLDPRT
Solar Car 2022-2024/Aerodynamic Models/Aero Model Final/Iteration 2 Mid Canopy/Interior Frame V2/Rearward Bulkhead.SLDPRT
Solar Car 2022-2024/Aerodynamic Models/Aero Model Final/Iteration 2 Mid Canopy/Interior Frame V2/RollBarBackingPlate.SLDPRT
Solar Car 2022-2024/Aerodynamic Models/Aero Model Final/Iteration 2 Mid Canopy/Interior Frame V2/Shock Side Holder.SLDPRT
Solar Car 2022-2024/Aerodynamic Models/Aero Model Final/Iteration 2 Mid Canopy/Interior Frame V2/SteeringMountBracket.SLDPRT
Solar Car 2022-2024/Aerodynamic Models/Aero Model Final/Iteration 2 Mid Canopy/Interior Frame V2/Waist Seatbelt Bracket Inside.SLDPRT
Solar Car 2022-2024/Aerodynamic Models/Aero Model Final/Iteration 2 Mid Canopy/Interior Frame V2/Waist Seatbelt Bracket Outside.SLDPRT
Solar Car 2022-2024/Aerodynamic Models/Aero Model Final/Iteration 2 Mid Canopy/Interior Frame/Interior Frame Assembly.SLDASM
Solar Car 2022-2024/Aerodynamic Models/Aero Model Final/Iteration 2 Mid Canopy/Interior Frame/MirrorSide Wall Right.SLDPRT
Solar Car 2022-2024/Aerodynamic Models/Aero Model Final/Iteration 2 Mid Canopy/Interior Frame/Part6.SLDPRT
Solar Car 2022-2024/Aerodynamic Models/Aero Model Final/Iteration 2 Mid Canopy/Interior Frame/Rear Bulkhead.SLDPRT
Solar Car 2022-2024/Aerodynamic Models/Aero Model Final/Iteration 2 Mid Canopy/Interior Frame/Roll Cage Floor Panel.SLDPRT
Solar Car 2022-2024/Aerodynamic Models/Aero Model Final/Iteration 2 Mid Canopy/Interior Frame/Side Wall Left.SLDPRT
Solar Car 2022-2024/Aerodynamic Models/Aero Model Final/Iteration 2 Mid Canopy/Interior Frame/Side Wall Right.DXF
Solar Car 2022-2024/Aerodynamic Models/Aero Model Final/Iteration 2 Mid Canopy/Interior Frame/Side Wall Right.SLDPRT
Solar Car 2022-2024/Aerodynamic Models/Aero Model Final/Iteration 2 Mid Canopy/Interior Frame/Side Wall Right.dwg
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
