GET-RAHS/2022-2024_Sockeye/Solar Car 2022-2024/New Suspension/Front Suspension/Assembly4-25/FrontSuspAS4-25.JPG

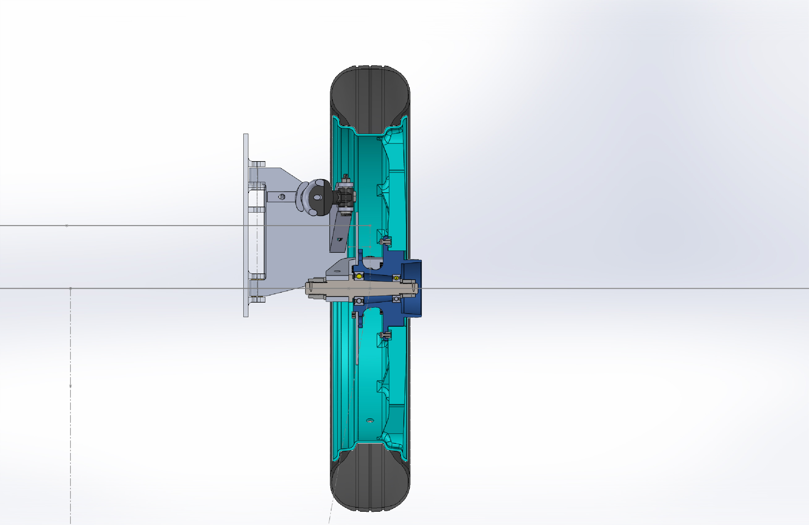
Solar Car 2022-2024/New Suspension/Front Suspension/Assembly4-25/FrontSuspAS4-25.JPG
