GET-RAHS/2022-2024_Sockeye/Solar Car 2022-2024/New Suspension/Front Suspension/Assy6/steering assembly.JPG

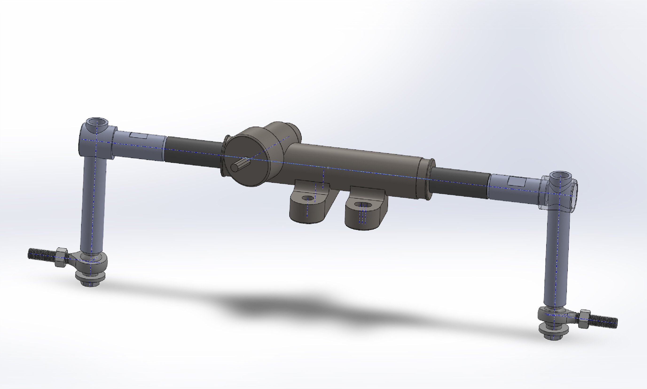
Solar Car 2022-2024/New Suspension/Front Suspension/Assy6/steering assembly.JPG
