GET-RAHS/2022-2024_Sockeye/Solar Car 2022-2024/Pictures/Full Car Assembly1.JPG

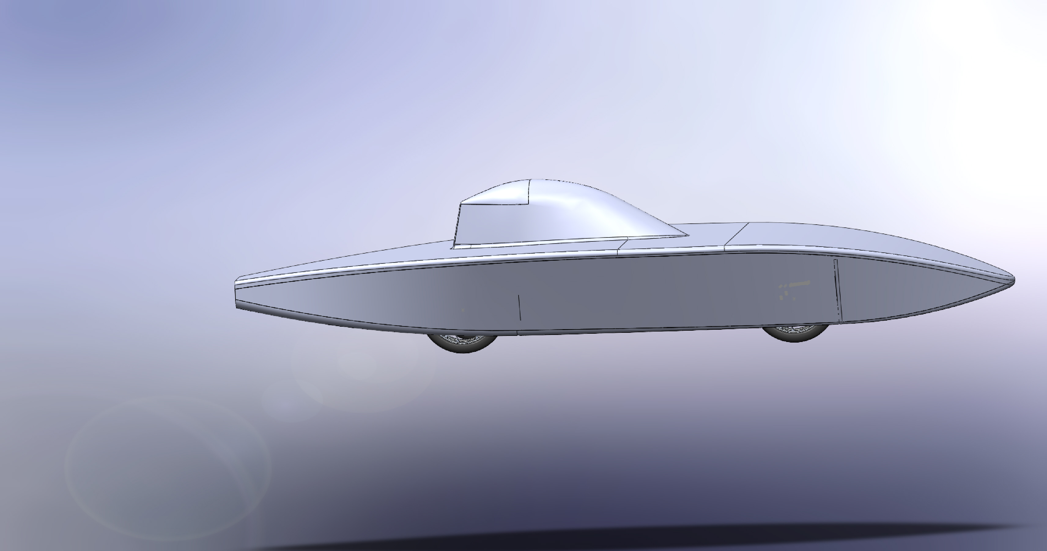
Solar Car 2022-2024/Pictures/Full Car Assembly1.JPG
