GET-RAHS/2022-2024_Sockeye/Solar Car 2022-2024/Pictures/New Car Assembly.JPG

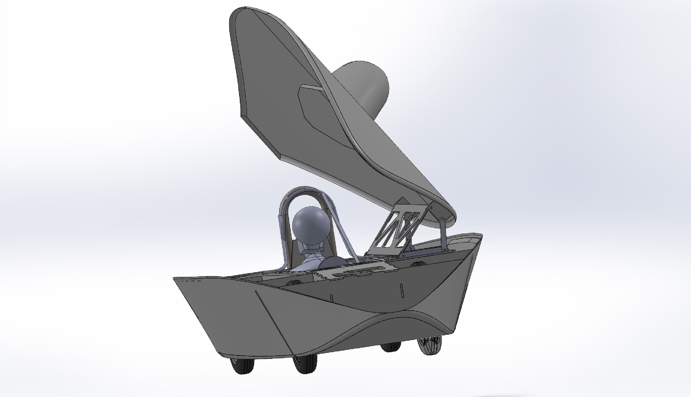
Solar Car 2022-2024/Pictures/New Car Assembly.JPG
