GET-RAHS/2022-2024_Sockeye/Solar Car 2022-2024/New Suspension/Rear Suspension/Rear Tube Suspension/Assembly/PerformanceLog.txt

Number of Contacts: 28
Number of contact data: 2549
