GET-RAHS/2022-2024_Sockeye/(threads)

Thread 1 (2023-10-10):

Finish and Submit Destructive Testing and Waivers

HagenRankin, 2023-10-10:
- [x] #32
- [x] Finish Destructive testing analysis document
- [x] Submit
- [ ] Edit Rule Waivers
- [x] Check when accepted

HagenRankin, 2024-01-26:
We may need to do some type of crush test. we also may want to add triangular crush zones at the front, and maybe back, of the car. Sides seem fine to me. We also need to discuss with Kurt, and have him ultimately write the defense. The wording would be something like, "Though I cannot say that this car will be safe, the design and construction of this car will likely protect the driver in the event of a collision, based on both the design of the car and the destructive tests the team ran."

HagenRankin, 2024-06-13:
Submitted, accepted. Attached are all important documents.
[Gmail - RAHS Green Energy Team Composite Destruct
[Kurt Gustafson Cover Letter.pdf](https://github.com/user-attachments/files/15822377/Kurt.Gustafson.Cover.Letter.pdf)
[Kurt Gustafson Cover Letter.pdf](https://github.com/user-attachments/files/15822377/Kurt.Gustafson.Cover.Letter.pdf)
[Kurt Gustafson Cover Letter.pdf](https://github.com/user-attachments/files/15822377/Kurt.Gustafson.Cover.Letter.pdf)
ive Testing.pdf](https://github.com/user-attachments/files/15822372/Gmail.-.RAHS.Green.Energy.Team.Composite.Destructive.Testing.pdf)
[Gmail - RAHS Green Energy Team Composite Destructive Testing.pdf](https://github.com/user-attachments/files/15822372/Gmail.-.RAHS.Green.Energy.Team.Composite.Destructive.Testing.pdf)
[Gmail - RAHS Green Energy Team Composite Destructive Testing.pdf](https://github.com/user-attachments/files/15822372/Gmail.-.RAHS.Green.Energy.Team.Composite.Destructive.Testing.pdf)
[GET_RAHS_Destructive_Testing_And_Analysis_1_5 (2).pdf](https://github.com/user-attachments/files/15822373/GET_RAHS_Destructive_Testing_And_Analysis_1_5.2.pdf)
[GET_RAHS_Destructive_Testing_And_Analysis_1_5 (2).pdf](https://github.com/user-attachments/files/15822373/GET_RAHS_Destructive_Testing_And_Analysis_1_5.2.pdf)
[GET_RAHS_Destructive_Testing_And_Analysis_1_5 (2).pdf](https://github.com/user-attachments/files/15822373/GET_RAHS_Destructive_Testing_And_Analysis_1_5.2.pdf)

Closed 2024-06-13.

Thread 2 (2023-10-10):

Add Backup Camera

HagenRankin, 2023-10-10:
- [x] Write Code
- [x] Design Camera Mount
- [x] Design Screen Mount
- [x] Install Camera/Screen

Jdaleigh, 2024-02-15:
Did you finish the camera mount Marcel?

Orange-Duster, 2024-02-27:
i finished it back in december/january, but i want to improve it. shouldnt take long. screen mount will be done by thursday probably

Closed 2024-03-01.

Thread 3 (2023-10-10):

Fix Motor Controller Issue

HagenRankin, 2023-10-10:
- [ ] Find why the motor is jerking when accelerating
- [ ] add comment to update
- [ ] Fixed

Closed 2024-06-13.

Thread 4 (2023-10-10):

Add lock to the array

HagenRankin, 2023-10-10:
- [ ] Read Rules for SCC, BWSC and ASC
- [ ] Design Locks
- [ ] Design two locking mechanisms
- [ ] Build/purchase components
- [ ] Assemble
- [ ] Test.

HagenRankin, 2024-01-16:
No longer needed

Closed 2024-01-16.

Thread 5 (2023-10-10):

Booster Seats

HagenRankin, 2023-10-10:
- [ ] Find how many booster seats we need and what sizes
- [ ] Design
- [ ] Build
- [ ] Test

MatthewF0ng, 2023-11-27:
1. Booster seats should be made with some form of rigid foam
2. Headspace must comply with head bar
3. Needs to allow the driver to laydown

MatthewF0ng, 2023-11-28:
5.2.1	Safety Cell – All solar cars must be equipped with a safety cell that provides rigid protection encompassing the entire driver’s head, torso, legs, and feet. The purpose of the safety cell is to provide a solid structure that protects the driver and prevents intrusion of objects into the driver compartment.  The safety cell shall be a fixed, integral part of the solar car structure. The protection provided for the driver in a collision must be documented in the team's mechanical drawings. In addition to providing collision and rollover protection, the safety cell must be designed so as to deflect body/array panels of the car away from the driver in the event of an accident.
5.2.1.1	Minimum Dimensions – The safety cell tubing must have a minimum outside diameter of 1.9 cm.  There must be at least 5 cm of clearance in all directions between the safety cell and the driver seated in the normal driving position.  Teams must demonstrate at scrutineering that each driver complies with the 5 cm clearance.
5.2.1.2	Coverage – If the safety cell was to be wrapped in an elastic fabric, no part of the driver should touch the fabric. The arms may extend out of the safety cell when holding the steering wheel.
5.2.1.3	Padding – The safety cell, including the roll bar, must be padded with a high density padding wherever a driver may likely contact it in a collision (e.g. heads, knees, elbows).
5.2.2	Roll Bar – The roll bar is a distinct structural member that is a key part of the safety cell. The roll bar extends above the driver’s head, protecting the driver in the event of a roll-over.  The roll bar must consist of one continuous piece of metal.  The bottom of the roll bar must extend at least 5 cm vertically from the top of the driver’s head or helmet.

MatthewF0ng, 2023-12-01:
Made the Small Booster seat, I need more foam and velcro

MatthewF0ng, 2024-01-10:
Layering it with softer foam, need to add fabric to prevent erosion and find a better way to connect the velcro

MatthewF0ng, 2024-01-16:
Add a bottom wooden piece or cut to the exact angle of the seat for tightening and security.

Closed 2024-03-20.

Thread 17 (2023-10-25):

Replace throttle pedal with better one

Hampsterkeed, 2023-10-25:
hall sensors keep breaking, current one sucks

Thread 18 (2023-10-25):

Canopy stiffening

Hampsterkeed, 2023-10-25:
canopy flops around when lifted, fix.

MatthewF0ng, 2024-01-12:
One would need to add metal bars inside the canopy. Also, the locking mechanism is a bit difficult to push down on and doesn't make the canopy flush with the body. The hinges can be tightened for better alignment.

MatthewF0ng, 2024-01-22:
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
Small gap not optimal
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
Both sections of the lock are not aligned properly
https://mail.google.com/mail/u/1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
Alignment pieces stopping the canopy from locking

MatthewF0ng, 2024-01-22:
It would be nice if someone else could help.

Thread 20 (2023-10-25):

Real Modem Mount

Hampsterkeed, 2023-10-25:
Currently duct taped in
create a more sturdy and better looking mount

MatthewF0ng, 2023-12-01:
Drilled holes into the mount, need to secure with bolts.

MatthewF0ng, 2023-12-11:
I think its done now.

Thread 21 (2023-10-26):

Fix steering wheel display

Hampsterkeed, 2023-10-26:
- [ ] Show battery power
- [ ] Show solar power
- [ ] Show currents

Thread 22 (2023-10-26):

Improve fairings

HagenRankin, 2023-10-26:
make easier to install and uninstall for tire changes.

Magnets?

HagenRankin, 2024-01-16:
I am currently working on magnets. Rear left worked well, but I would like to add 1x more magnet at the top. I need to do the rest, or may ask another person to pick up this project. For all future magnets I would like to keep a consistent pole direction, for example, N always faces towards the car.

HagenRankin, 2024-01-25:
Done, installed, tested.

Closed 2024-01-25.

Thread 25 (2023-11-02):

Stop battery air filter from rubbing against wheel

HagenRankin, 2023-11-02:
Front right wheel rubs against the air filter for the battery

We need a better housing, or, at minimum, the tape to stop touching the wheel.

- [x] Model CAD
- [x] Print
- [x] Glue in place

Closed 2023-11-14.

Thread 28 (2023-11-17):

Fix Pedal adjustment lever

HagenRankin, 2023-11-17:
the mounting plate broke off, we need to re-glue and add both a screw and another plate on the inside to reinforce it.

(lever under the seat to the left)

Closed 2023-12-01.

Thread 36 (2024-01-04):

Install external emergency shut off buttons

Plazma52, 2024-01-04:
If we plan to mount the buttons on the rear, we must make sure the buttons do not extend past the length limit of the car stated in the 2023-2024 solar car challenge rules (5.1.1).

HagenRankin, 2024-01-16:
They are installed, just need to be wired

HagenRankin, 2024-01-26:
Wired. needs to be tested once the main board is in

Closed 2024-03-01.

Thread 39 (2024-01-16):

Interconnecting Board PCB

Caden288, 2024-01-16:
Convert Interconnecting Board into a PCB
-Fix current Board
-Get Schematic fixed
-Get footprints
-Layout
-Installation

Closed 2024-03-18.

Thread 41 (2024-01-26):

Low Voltage Supp. Warning Display

mattlayante, 2024-01-26:
there's a bag with the two components that should be mounted somewhere within driver's sight and connected to supplemental battery.

Thread 43 (2024-02-14):

Back left wheel doesn't fit

Jdaleigh, 2024-02-14:
back left wheel doesn't fit on to the car

Closed 2024-02-15.

Thread 44 (2024-02-16):

Documentation

HagenRankin, 2024-02-16:
- [x] Cover letter
- [x] Registration Form
     - [x] Add phone numbers
- [x] Team List
- [x] 01 Mechanical Drawings
- [x] 02 Electrical Schematics
- [x] 03 Team Photo
     - [x] Email photo to lehmanm743@aol.com
- [x] 04 Battery Data Sheets
- [x] 05 Solar Cell Data Sheets
- [x] 06 Etc. Data sheets
     - [x] Motor
     - [x] Motor Controller
     - [x] Main Fuse
     - [x] Disconnect Switches
     - [x] Wheels
     - [x] Front Suspension
     - [x] Rear Suspension
     - [x] Shock Documentation
     - [x] Rack and pinion documentation
     - [x] Master cylinders
     - [x] caliper
- [x] Once all else is done, make combined pdf
- [x] mail
- [x] send PDF to registration@solarcarchallenge.org

Closed 2024-06-13.

Thread 49 (2024-05-31):

Locking Nuts must extend by 2 threads

MatthewF0ng, 2024-05-31:
Make sure are locking nuts extend by 2 threads
Please check all locking nuts and tighten/replace them as

- [ ] Brakes

- [ ] Everything else

Closed 2024-07-03.
