GET-RAHS/2022-2024_Sockeye/Solar Car 2022-2024/ToOrder/Composites One Pass - SAMPE.pdf

# BE OUR GUEST

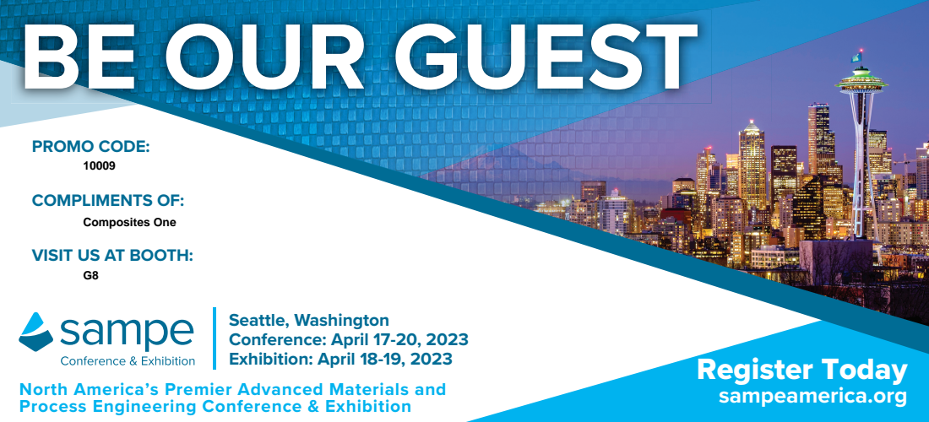
[picture p148: page 1]
PROMO CODE:; COMPLIMENTS OF:; Seattle, Washington Conference: April 17-20, 2023 Exhibition: April 18-19, 2023; Register Today sampeamerica.org

Composites One
VISIT US AT BOOTH:

North America’s Premier Advanced Materials and
Process Engineering Conference & Exhibition
