GET-RAHS/2022-2024_Sockeye/Solar Car 2022-2024/ToOrder/Rear Right Brake Bracket.pdf

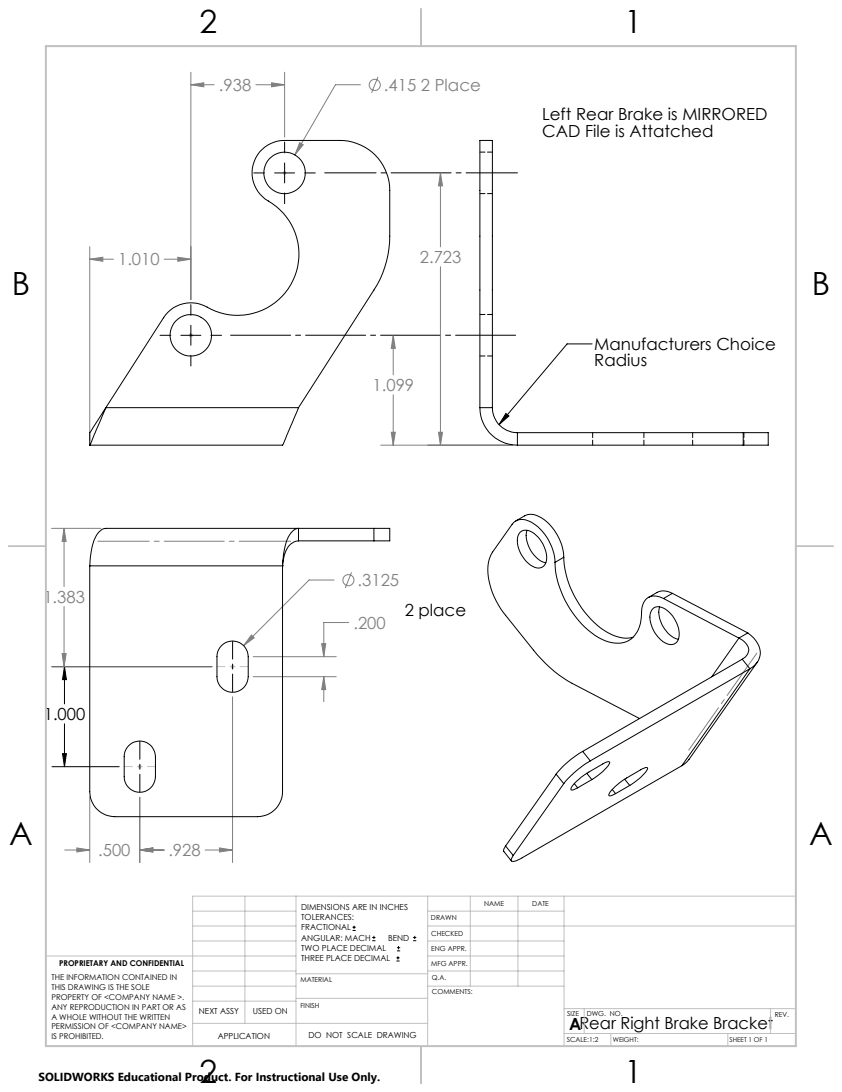
[picture p149: page 1]
.415 2 Place; 2 place; Manufacturers Choice

Left Rear Brake is MIRRORED
CAD File is Attatched

TOLERANCES: FRACTIONAL ANGULAR: MACH BEND TWO PLACE DECIMAL THREE PLACE DECIMAL | | NAME | DATE DIMENSIONS ARE IN INCHES

DRAWN
CHECKED
ENG APPR.

PROPRIETARY AND CONFIDENTIAL THE INFORMATION CONTAINED IN THIS DRAWING IS THE SOLE PROPERTY OF <COMPANY NAME >. ANY REPRODUCTION IN PART OR AS A WHOLE WITHOUT THE WRITTEN PERMISSION OF <COMPANY NAME> IS PROHIBITED. | | | MFG APPR.

MATERIAL | Q.A.

NEXT ASSY | USED ON | FINISH

SIZE A Rear Right Brake Bracket | DWG. NO. | REV.

APPLICATION | | DO NOT SCALE DRAWING

SCALE:1:2 | WEIGHT: | SHEET 1 OF 1

SOLIDWORKS Educational Product. For Instructional Use Only.
