GET-RAHS/2022-2024_Sockeye/Solar Car 2022-2024/Parts To Be Machined/Metal Shop/Rear Right Brake Bracket.pdf

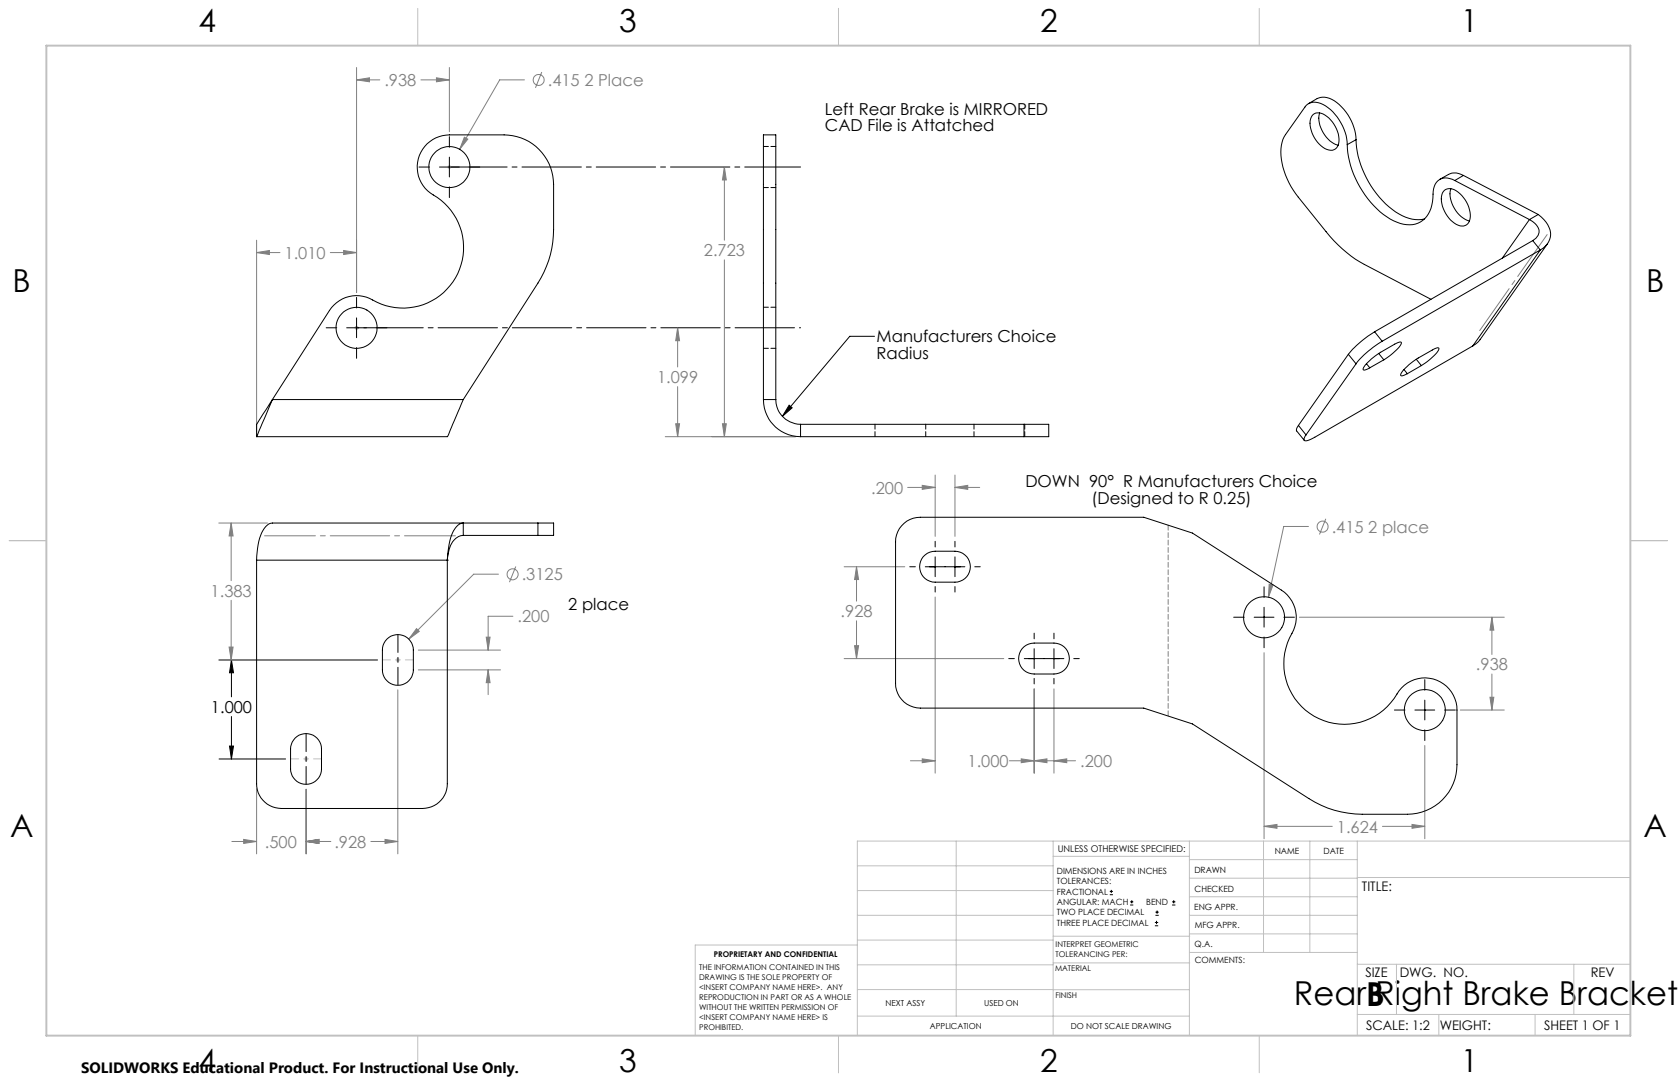
[picture p150: page 1]
.415 2 Place; 2 place; Manufacturers Choice; .415 2 place

Left Rear Brake is MIRRORED
CAD File is Attatched

DOWN 90° R Manufacturers Choice
(Designed to R 0.25)

UNLESS OTHERWISE SPECIFIED: | | NAME | DATE
DIMENSIONS ARE IN INCHES TOLERANCES: FRACTIONAL ANGULAR: MACH BEND TWO PLACE DECIMAL THREE PLACE DECIMAL | DRAWN

CHECKED | | | TITLE:

ENG APPR.
MFG APPR.

INTERPRET GEOMETRIC TOLERANCING PER: | Q.A.
MATERIAL | | SIZE B | DWG. NO. | REV

PROPRIETARY AND CONFIDENTIAL
THE INFORMATION CONTAINED IN THIS
DRAWING IS THE SOLE PROPERTY OF
<INSERT COMPANY NAME HERE>. ANY
REPRODUCTION IN PART OR AS A WHOLE
WITHOUT THE WRITTEN PERMISSION OF
<INSERT COMPANY NAME HERE> IS
PROHIBITED.

COMMENTS:
Rear Right Brake Bracket

NEXT ASSY | USED ON | FINISH

APPLICATION | DO NOT SCALE DRAWING | | SCALE: 1:2 | WEIGHT: | SHEET 1 OF 1

SOLIDWORKS Educational Product. For Instructional Use Only.
