GET-RAHS/2022-2024_Sockeye/Solar Car 2022-2024/Parts To Be Machined/Order #1/RAHS Order List.pdf

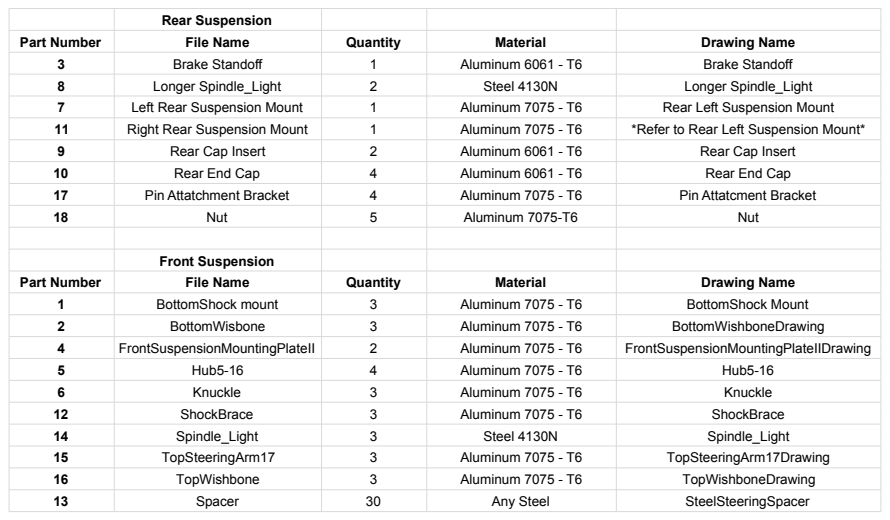
[picture p151: page 1]
Rear Suspension; Part Number; File Name; Quantity; Material; Drawing Name; Brake Standoff; Aluminum 6061 - T6; Longer Spindle_Light; Steel 4130N; Left Rear Suspension Mount; Aluminum 7075 - T6; Rear Left Suspension Mount; Right Rear Suspension Mount; *Refer to Rear Left Suspension Mount*; Rear Cap Insert; Rear End Cap; Pin Attatchment Bracket; Pin Attatcment Bracket; Nut; Aluminum 7075-T6; Front Suspension; BottomShock mount; BottomShock Mount; BottomWisbone; BottomWishboneDrawing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
