GET-RAHS/2022-2024_Sockeye/Solar Car 2022-2024/Parts To Be Machined/Order #2/Array Lower Mount.pdf

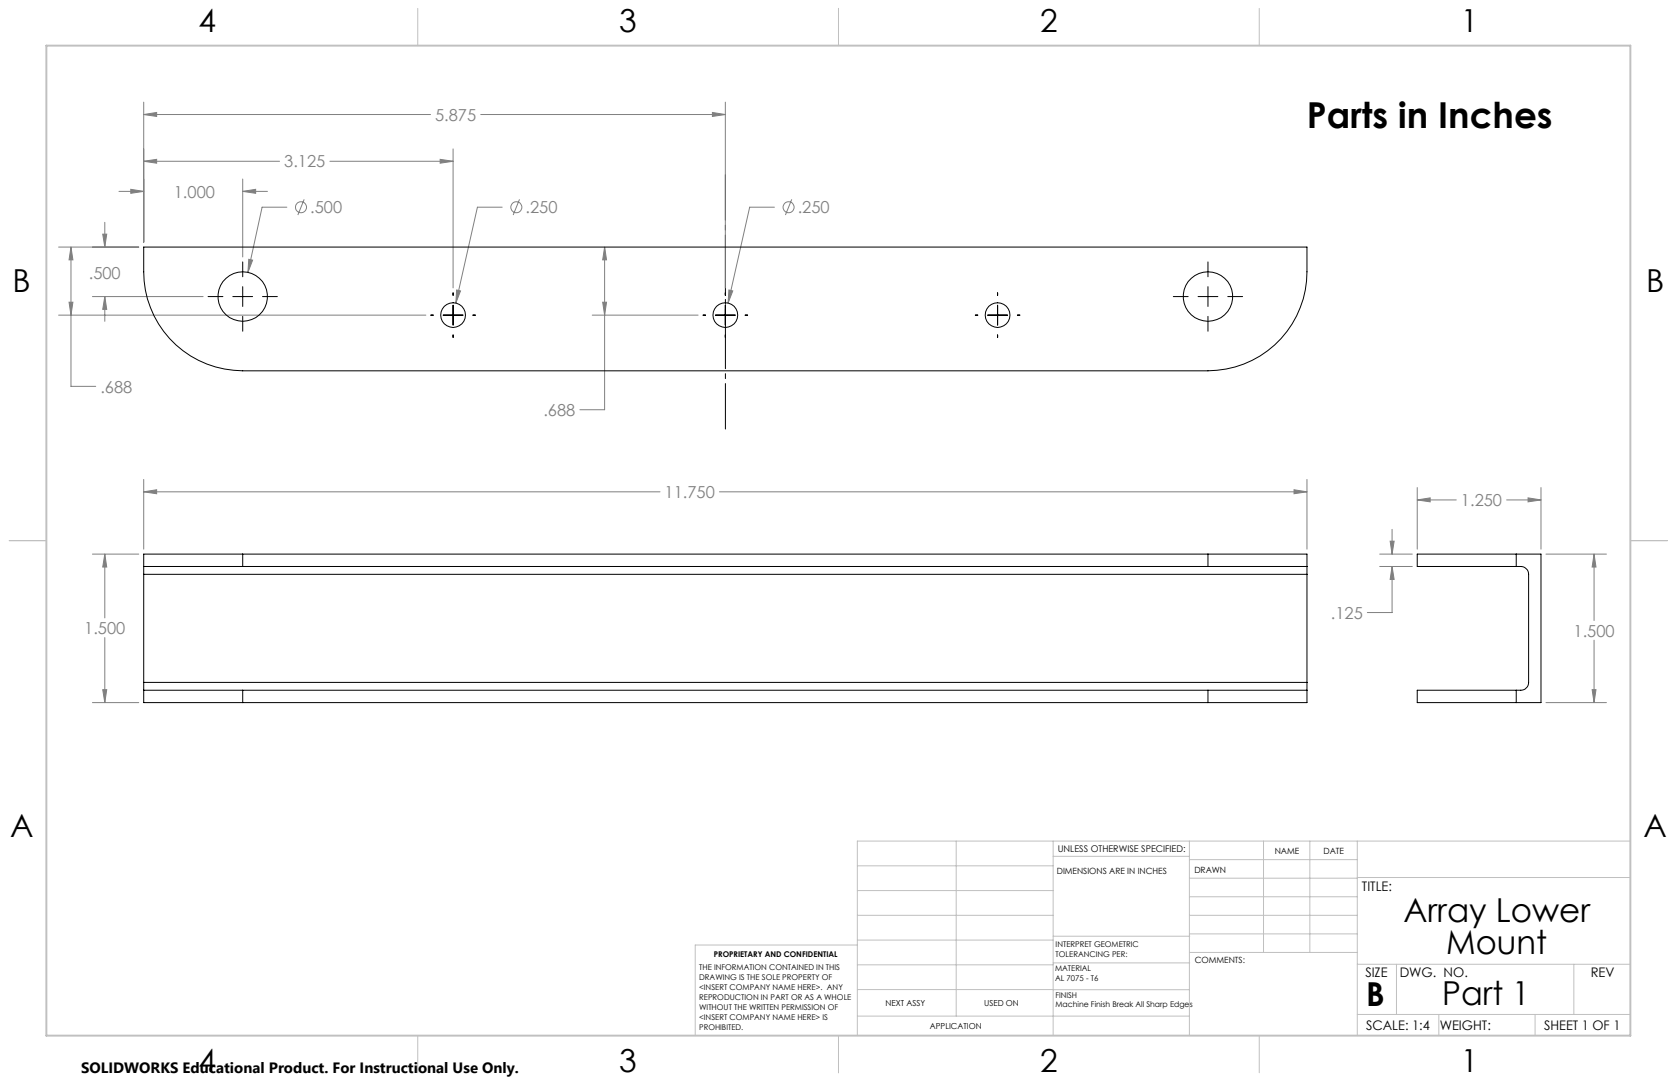
[picture p152: page 1]
Array Lower; INTERPRET GEOMETRIC TOLERANCING PER:

Parts in Inches

UNLESS OTHERWISE SPECIFIED: | | NAME | DATE
DIMENSIONS ARE IN INCHES | DRAWN

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

MATERIAL AL 7075 - T6 | | SIZE B | DWG. NO. Part 1 | REV

NEXT ASSY | USED ON | FINISH Machine Finish Break All Sharp Edges
APPLICATION | | | SCALE: 1:4 | WEIGHT: | SHEET 1 OF 1

SOLIDWORKS Educational Product. For Instructional Use Only.
