GET-RAHS/2022-2024_Sockeye/Solar Car 2022-2024/Parts To Be Machined/Order #2/Array Mounting Chanel.pdf

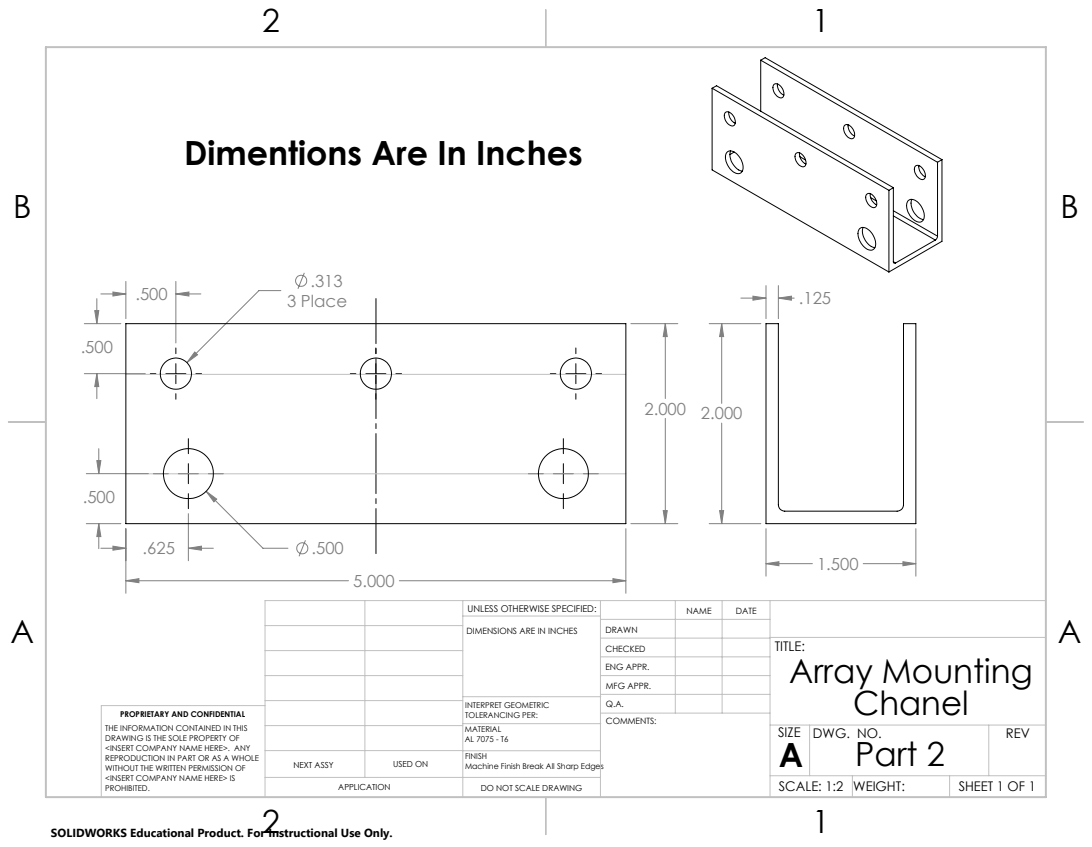
[picture p153: page 1]
3 Place .500

Dimentions Are In Inches

UNLESS OTHERWISE SPECIFIED: | | NAME | DATE
DIMENSIONS ARE IN INCHES | DRAWN

CHECKED | | | TITLE: Array Mounting Chanel

ENG APPR.
MFG APPR.

INTERPRET GEOMETRIC TOLERANCING PER: | Q.A.
MATERIAL AL 7075 - T6 | | SIZE A | DWG. NO. Part 2 | REV

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

NEXT ASSY | USED ON | FINISH Machine Finish Break All Sharp Edges

APPLICATION | DO NOT SCALE DRAWING | | SCALE: 1:2 | WEIGHT: | SHEET 1 OF 1

SOLIDWORKS Educational Product. For Instructional Use Only.
