GET-RAHS/2022-2024_Sockeye/Solar Car 2022-2024/Parts To Be Machined/Order #2/Pin Attatchment Bracket.pdf

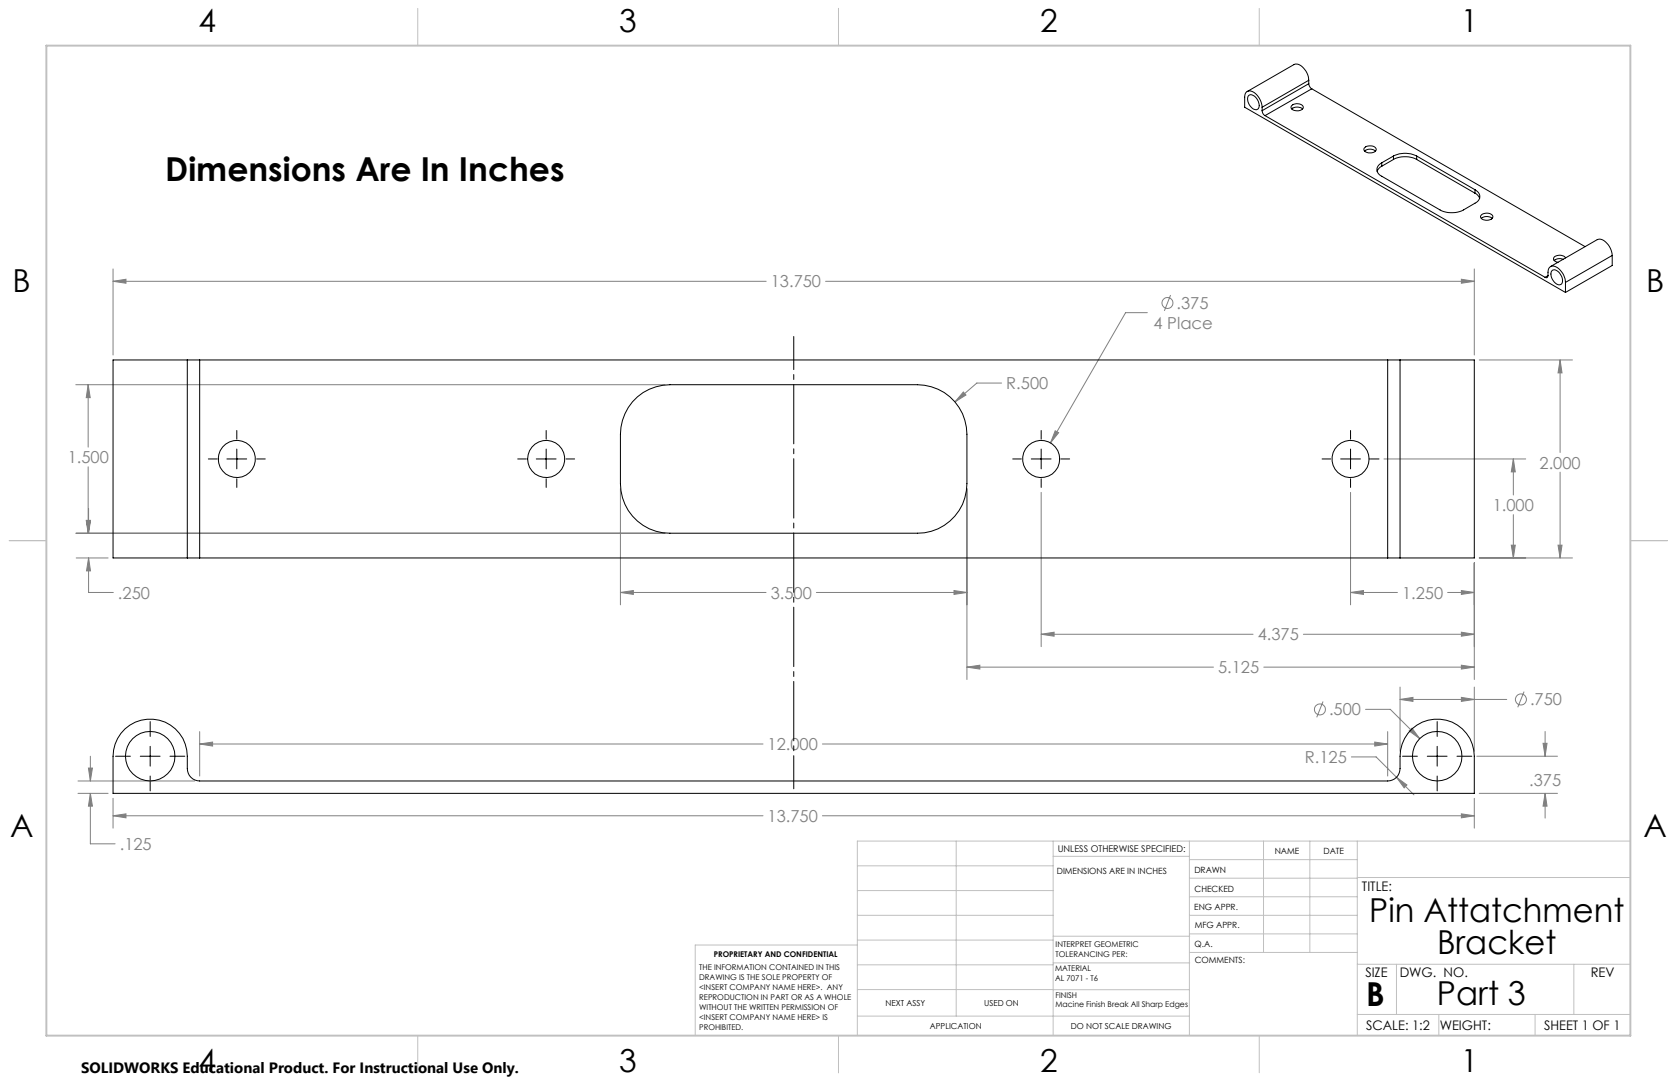
[picture p154: page 1]
4 Place

Dimensions Are In Inches

UNLESS OTHERWISE SPECIFIED: | | NAME | DATE
DIMENSIONS ARE IN INCHES | DRAWN

CHECKED | | | TITLE: Pin Attatchment Bracket

ENG APPR.
MFG APPR.

INTERPRET GEOMETRIC TOLERANCING PER: | Q.A.
MATERIAL AL 7071 - T6 | | SIZE B | DWG. NO. Part 3 | REV

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

NEXT ASSY | USED ON | FINISH Macine Finish Break All Sharp Edges

APPLICATION | DO NOT SCALE DRAWING | | SCALE: 1:2 | WEIGHT: | SHEET 1 OF 1

SOLIDWORKS Educational Product. For Instructional Use Only.
