GET-RAHS/2022-2024_Sockeye/Solar Car 2022-2024/Parts To Be Machined/Seattle Machined/Shock Top Mount.pdf

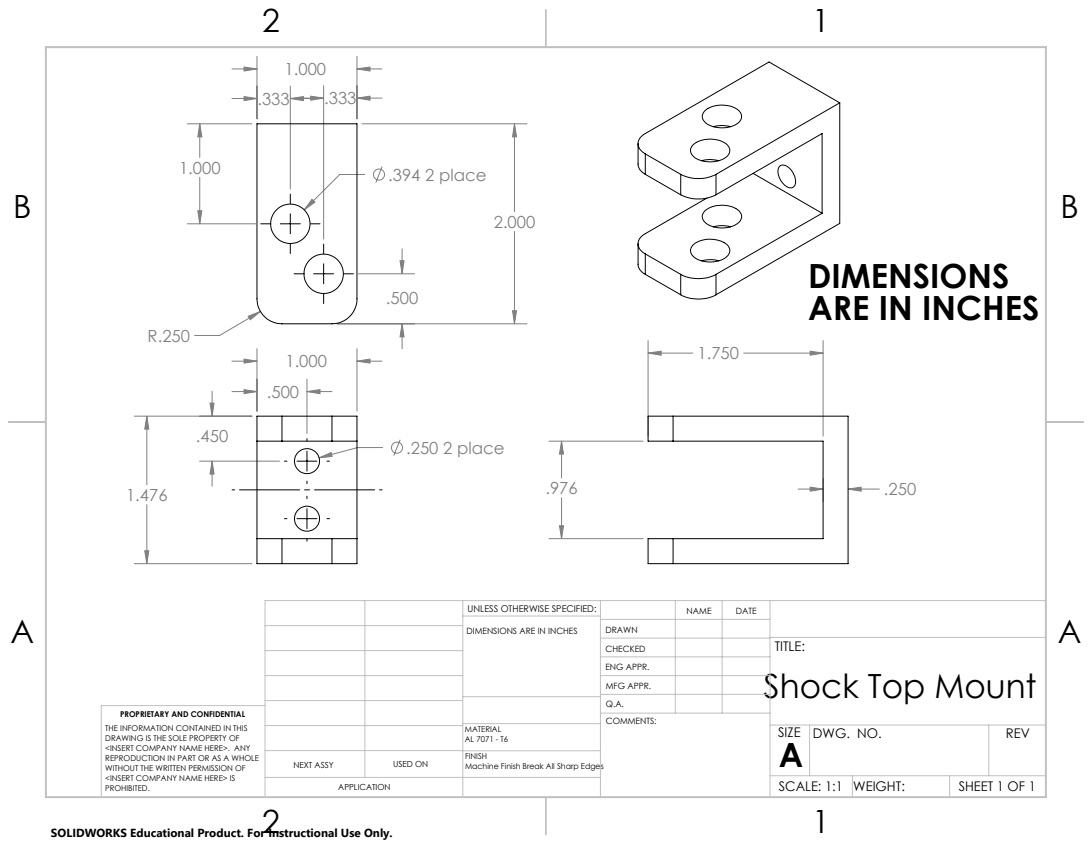
[picture p155: page 1]
.250 2 place; .394 2 place

DIMENSIONS
ARE IN INCHES

UNLESS OTHERWISE SPECIFIED: | | NAME | DATE
DIMENSIONS ARE IN INCHES | DRAWN

CHECKED | | | TITLE:

ENG APPR.
MFG APPR.
Q.A.

Shock Top Mount

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

MATERIAL AL 7071 - T6 | | SIZE A | DWG. NO. | REV

NEXT ASSY | USED ON | FINISH Machine Finish Break All Sharp Edges
APPLICATION | | | SCALE: 1:1 | WEIGHT: | SHEET 1 OF 1

SOLIDWORKS Educational Product. For Instructional Use Only.
