GET-RAHS/2022-2024_Sockeye/Solar Car 2022-2024/Parts To Be Machined/Sheet Metal/Rack and Pinion Mount.pdf

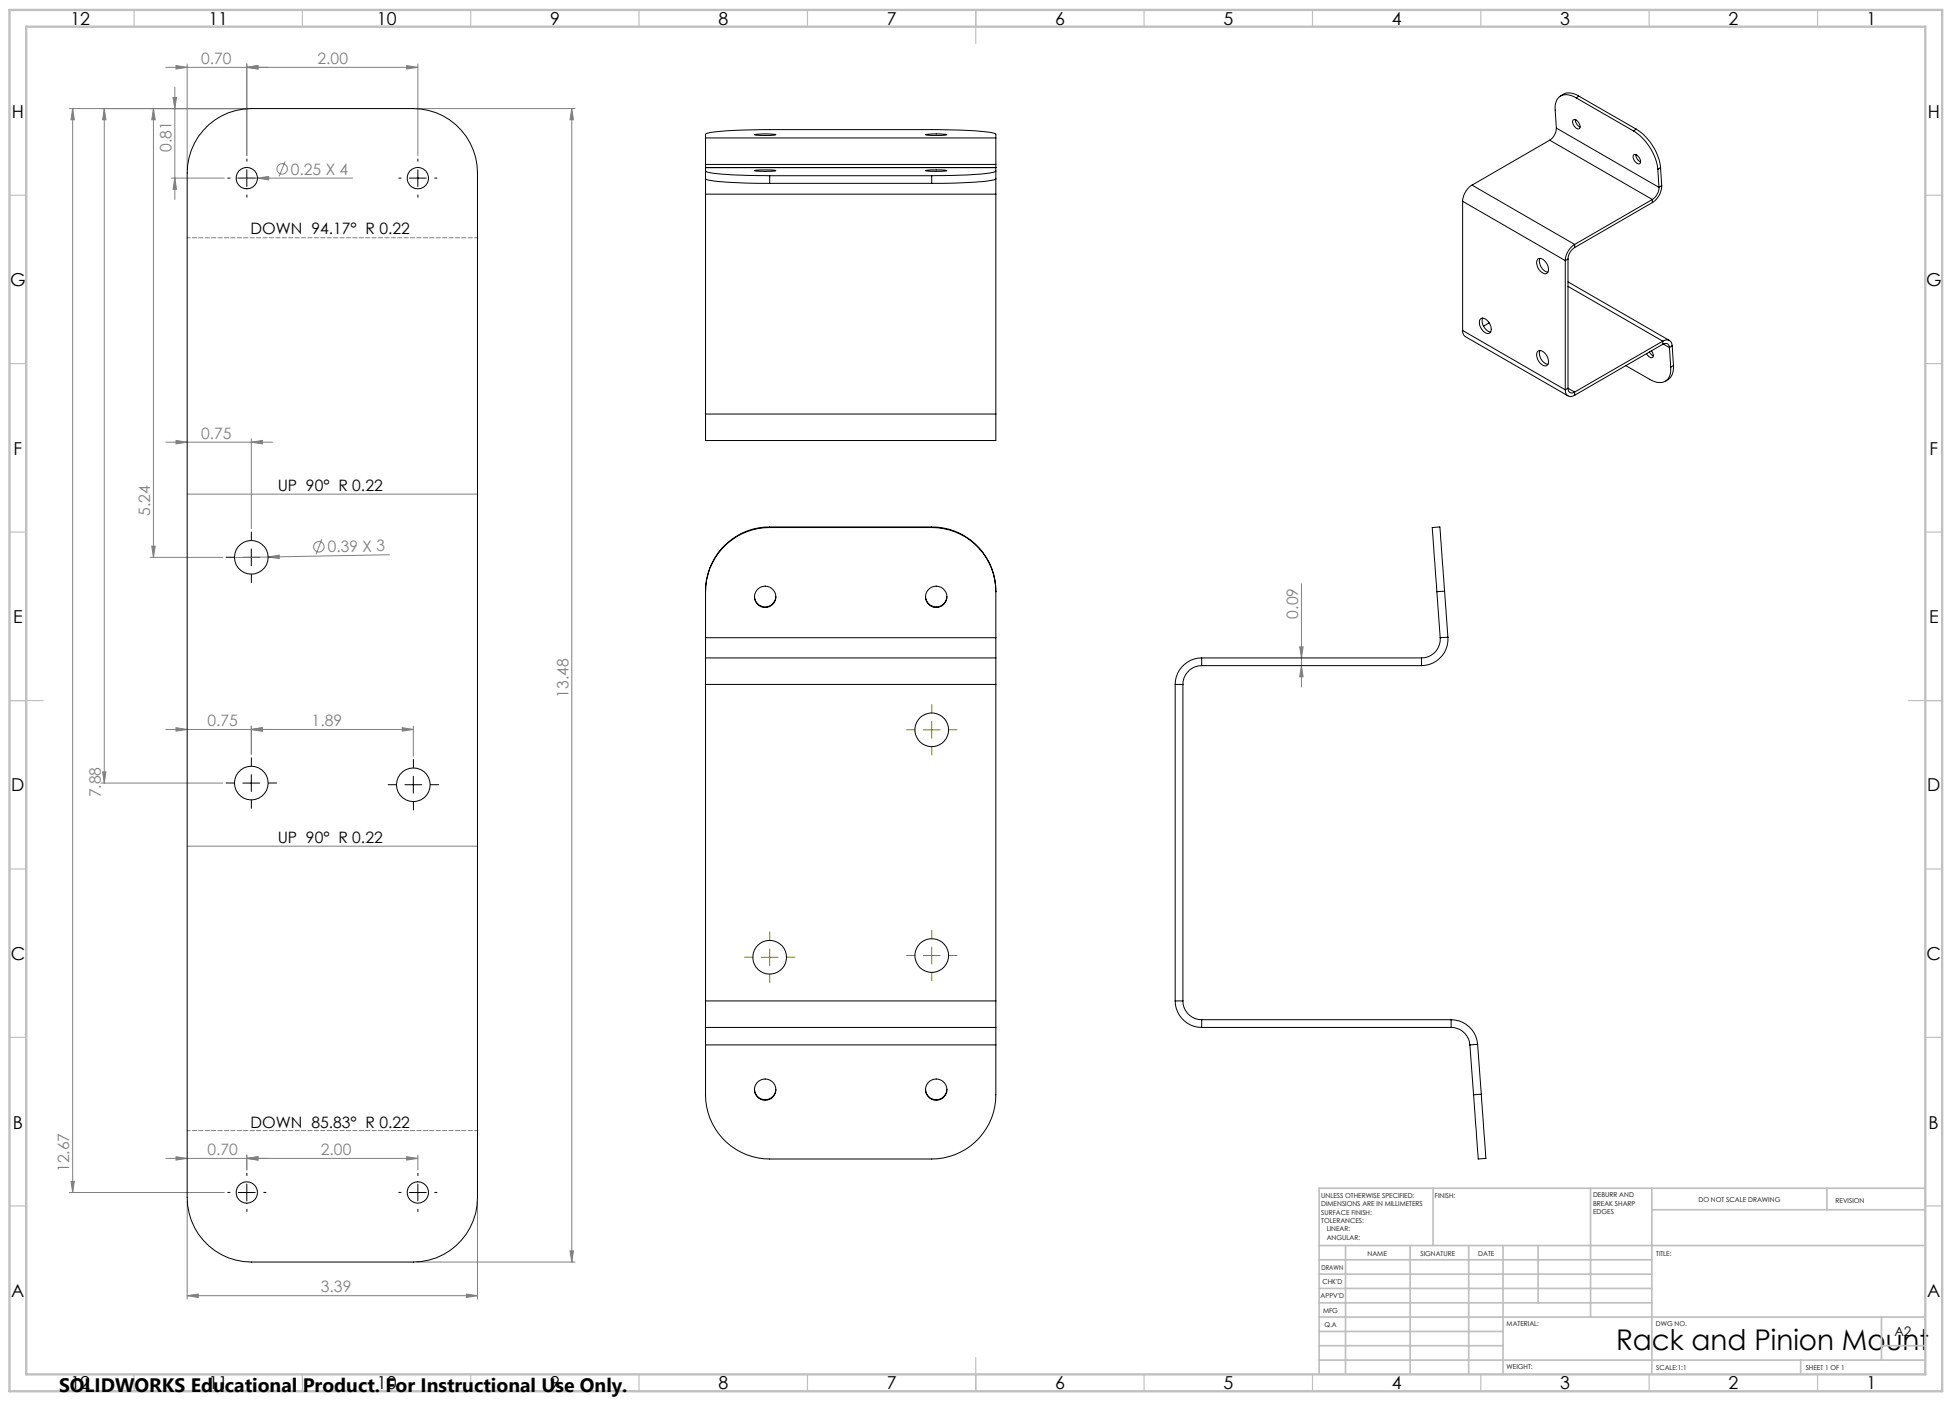
[picture p156: page 1]
DOWN 85.83° R 0.22; DOWN 94.17° R 0.22; FINISH:; DEBURR AND; BREAK SHARP; DO NOT SCALE DRAWING; REVISION; SCALE:1:1; SHEET 1 OF 1

UNLESS OTHERWISE SPECIFIED:
DIMENSIONS ARE IN MILLIMETERS
SURFACE FINISH:
TOLERANCES:
LINEAR:
ANGULAR:

NAME | SIGNATURE | DATE | | | | TITLE:

DRAWN
CHK'D
APPV'D
MFG
Q.A | | | | MATERIAL: Rack and Pinion Mount | DWG NO. | A2

SOLIDWORKS Educational Product. For Instructional Use Only.
