GET-RAHS/2022-2024_Sockeye/Solar Car 2022-2024/Parts To Be Machined/Tubing/U-Bend Tubing.pdf

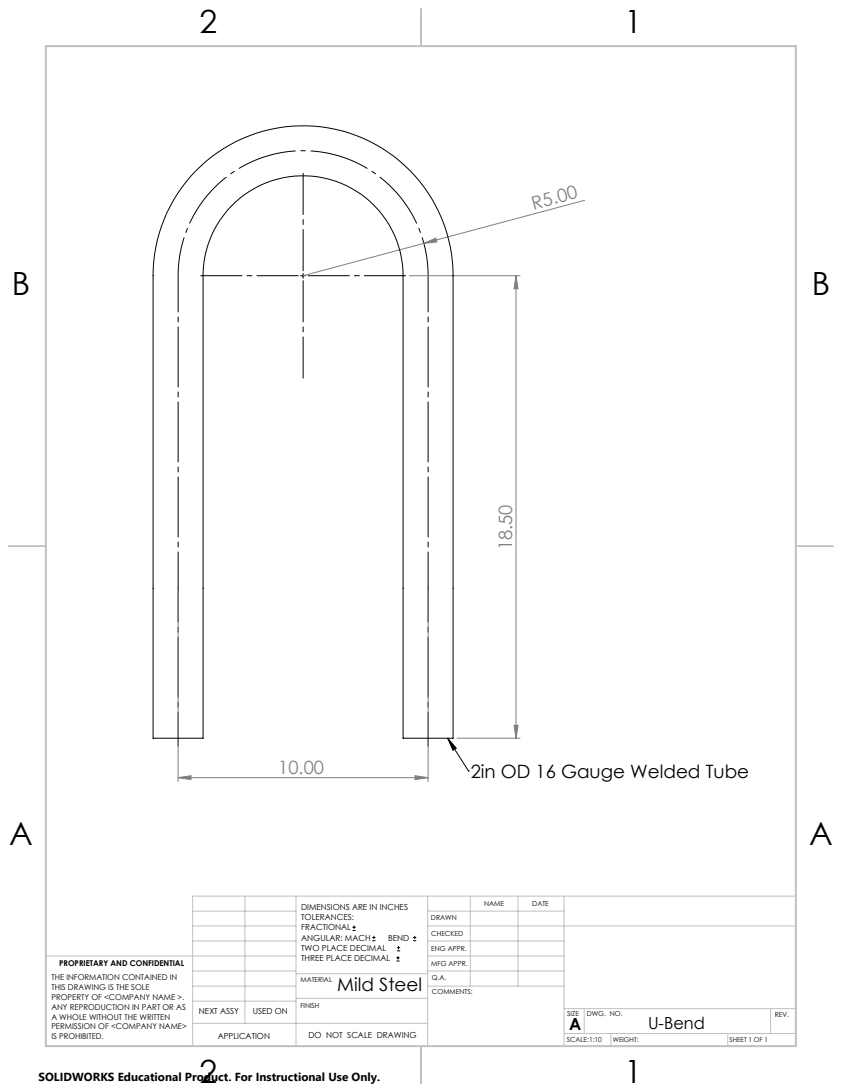
[picture p157: page 1]
2in OD 16 Gauge Welded Tube

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

DRAWN
CHECKED
ENG APPR.

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

Mild Steel MATERIAL | Q.A.

NEXT ASSY | USED ON | FINISH

SIZE A | DWG. NO. U-Bend | REV.

APPLICATION | | DO NOT SCALE DRAWING

SCALE:1:10 | WEIGHT: | SHEET 1 OF 1

SOLIDWORKS Educational Product. For Instructional Use Only.
