GET-RAHS/2022-2024_Sockeye/Solar Car 2022-2024/Parts To Be Machined/Order #1/Drawings/BottomWishboneDrawing.pdf

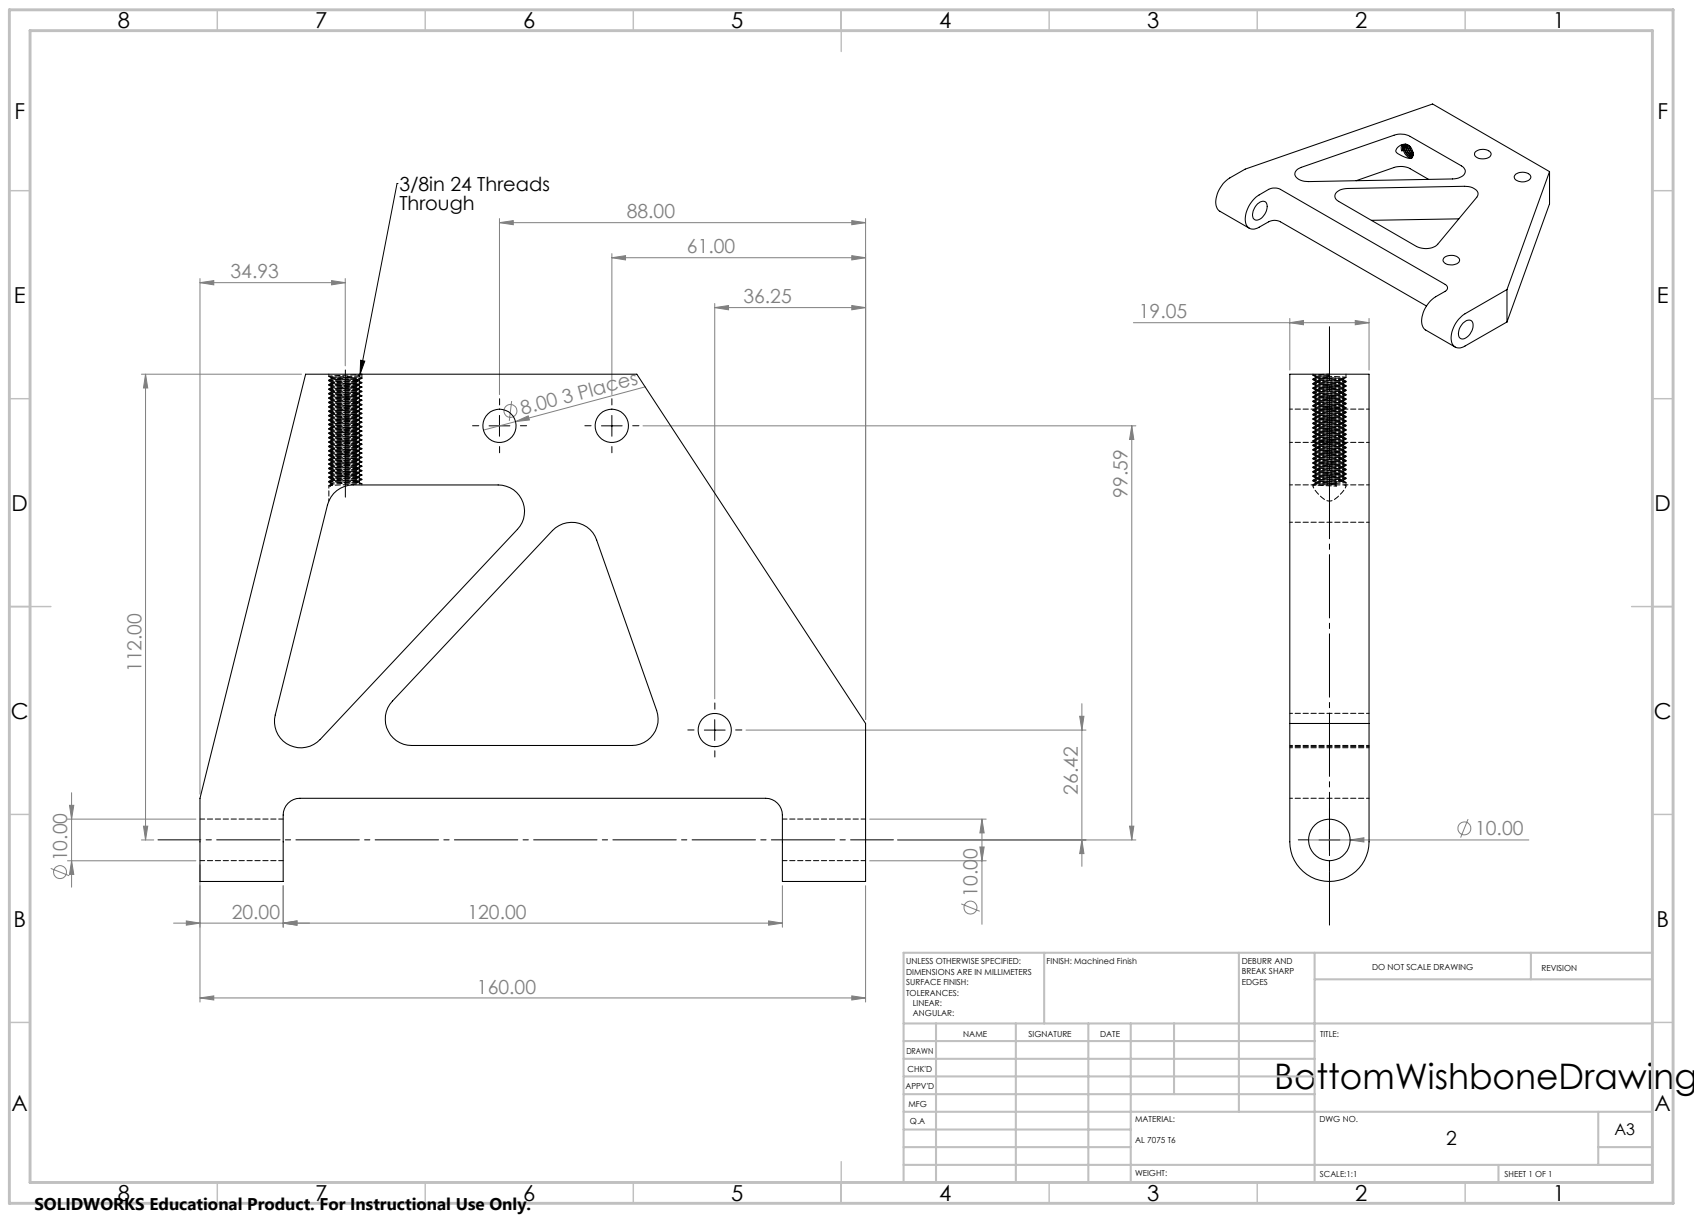
[picture p158: page 1]
8.00 3 Places; 3/8in 24 Threads; FINISH: Machined Finish; DEBURR AND; BREAK SHARP; DO NOT SCALE DRAWING; REVISION; SCALE:1:1; SHEET 1 OF 1

UNLESS OTHERWISE SPECIFIED:
DIMENSIONS ARE IN MILLIMETERS
SURFACE FINISH:
TOLERANCES:
LINEAR:
ANGULAR:

NAME | SIGNATURE | DATE | | | | TITLE:

DRAWN
CHK'D
APPV'D
MFG
Q.A | | | | MATERIAL: AL 7075 T6 | DWG NO. 2 | A3

SOLIDWORKS Educational Product. For Instructional Use Only.
