GET-RAHS/2022-2024_Sockeye/Solar Car 2022-2024/Parts To Be Machined/Order #1/Drawings/Brake Standoff.pdf

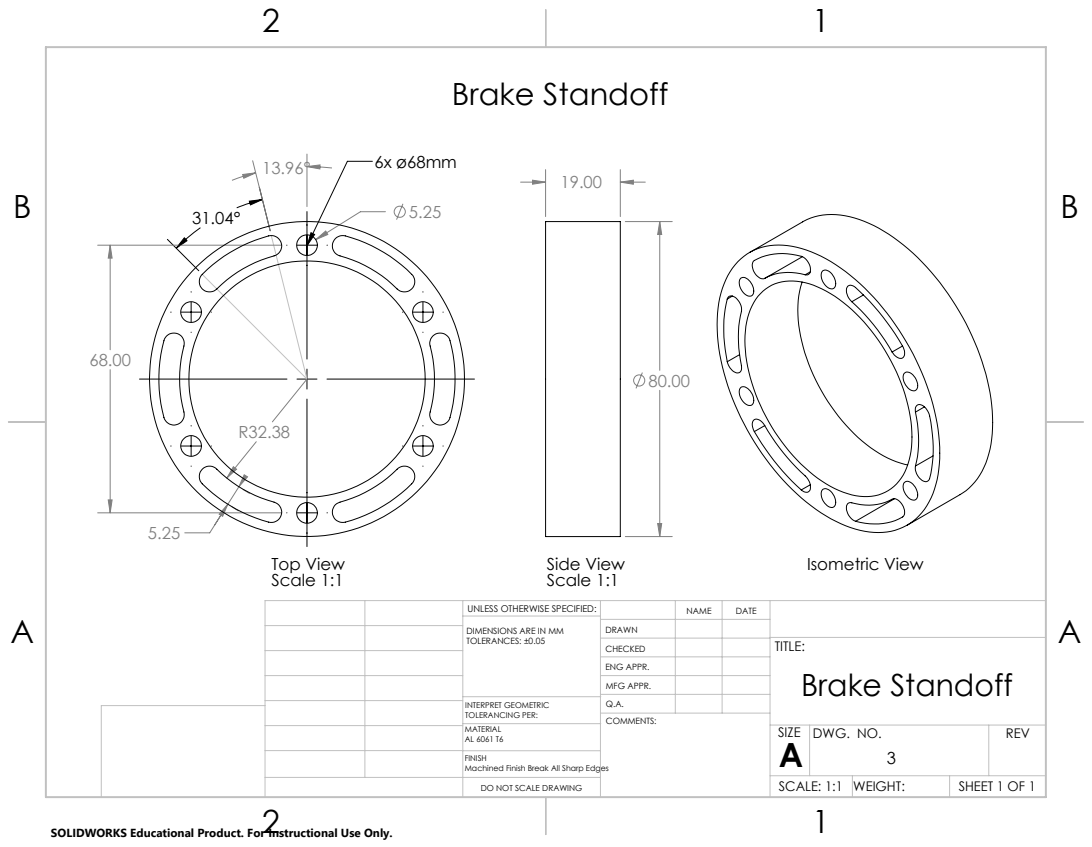
[picture p159: page 1]
Top View Scale 1:1; Side View Scale 1:1; Isometric View; Brake Standoff

UNLESS OTHERWISE SPECIFIED: | | NAME | DATE
DIMENSIONS ARE IN MM TOLERANCES: ±0.05 | DRAWN

CHECKED | | | TITLE: Brake Standoff

ENG APPR.
MFG APPR.

INTERPRET GEOMETRIC TOLERANCING PER: | Q.A.
MATERIAL AL 6061 T6 | | SIZE A | DWG. NO. 3 | REV

FINISH Machined Finish Break All Sharp Edges

DO NOT SCALE DRAWING | | SCALE: 1:1 | WEIGHT: | SHEET 1 OF 1

SOLIDWORKS Educational Product. For Instructional Use Only.
