GET-RAHS/2022-2024_Sockeye/Solar Car 2022-2024/Parts To Be Machined/Order #1/Drawings/Hub5-16.pdf

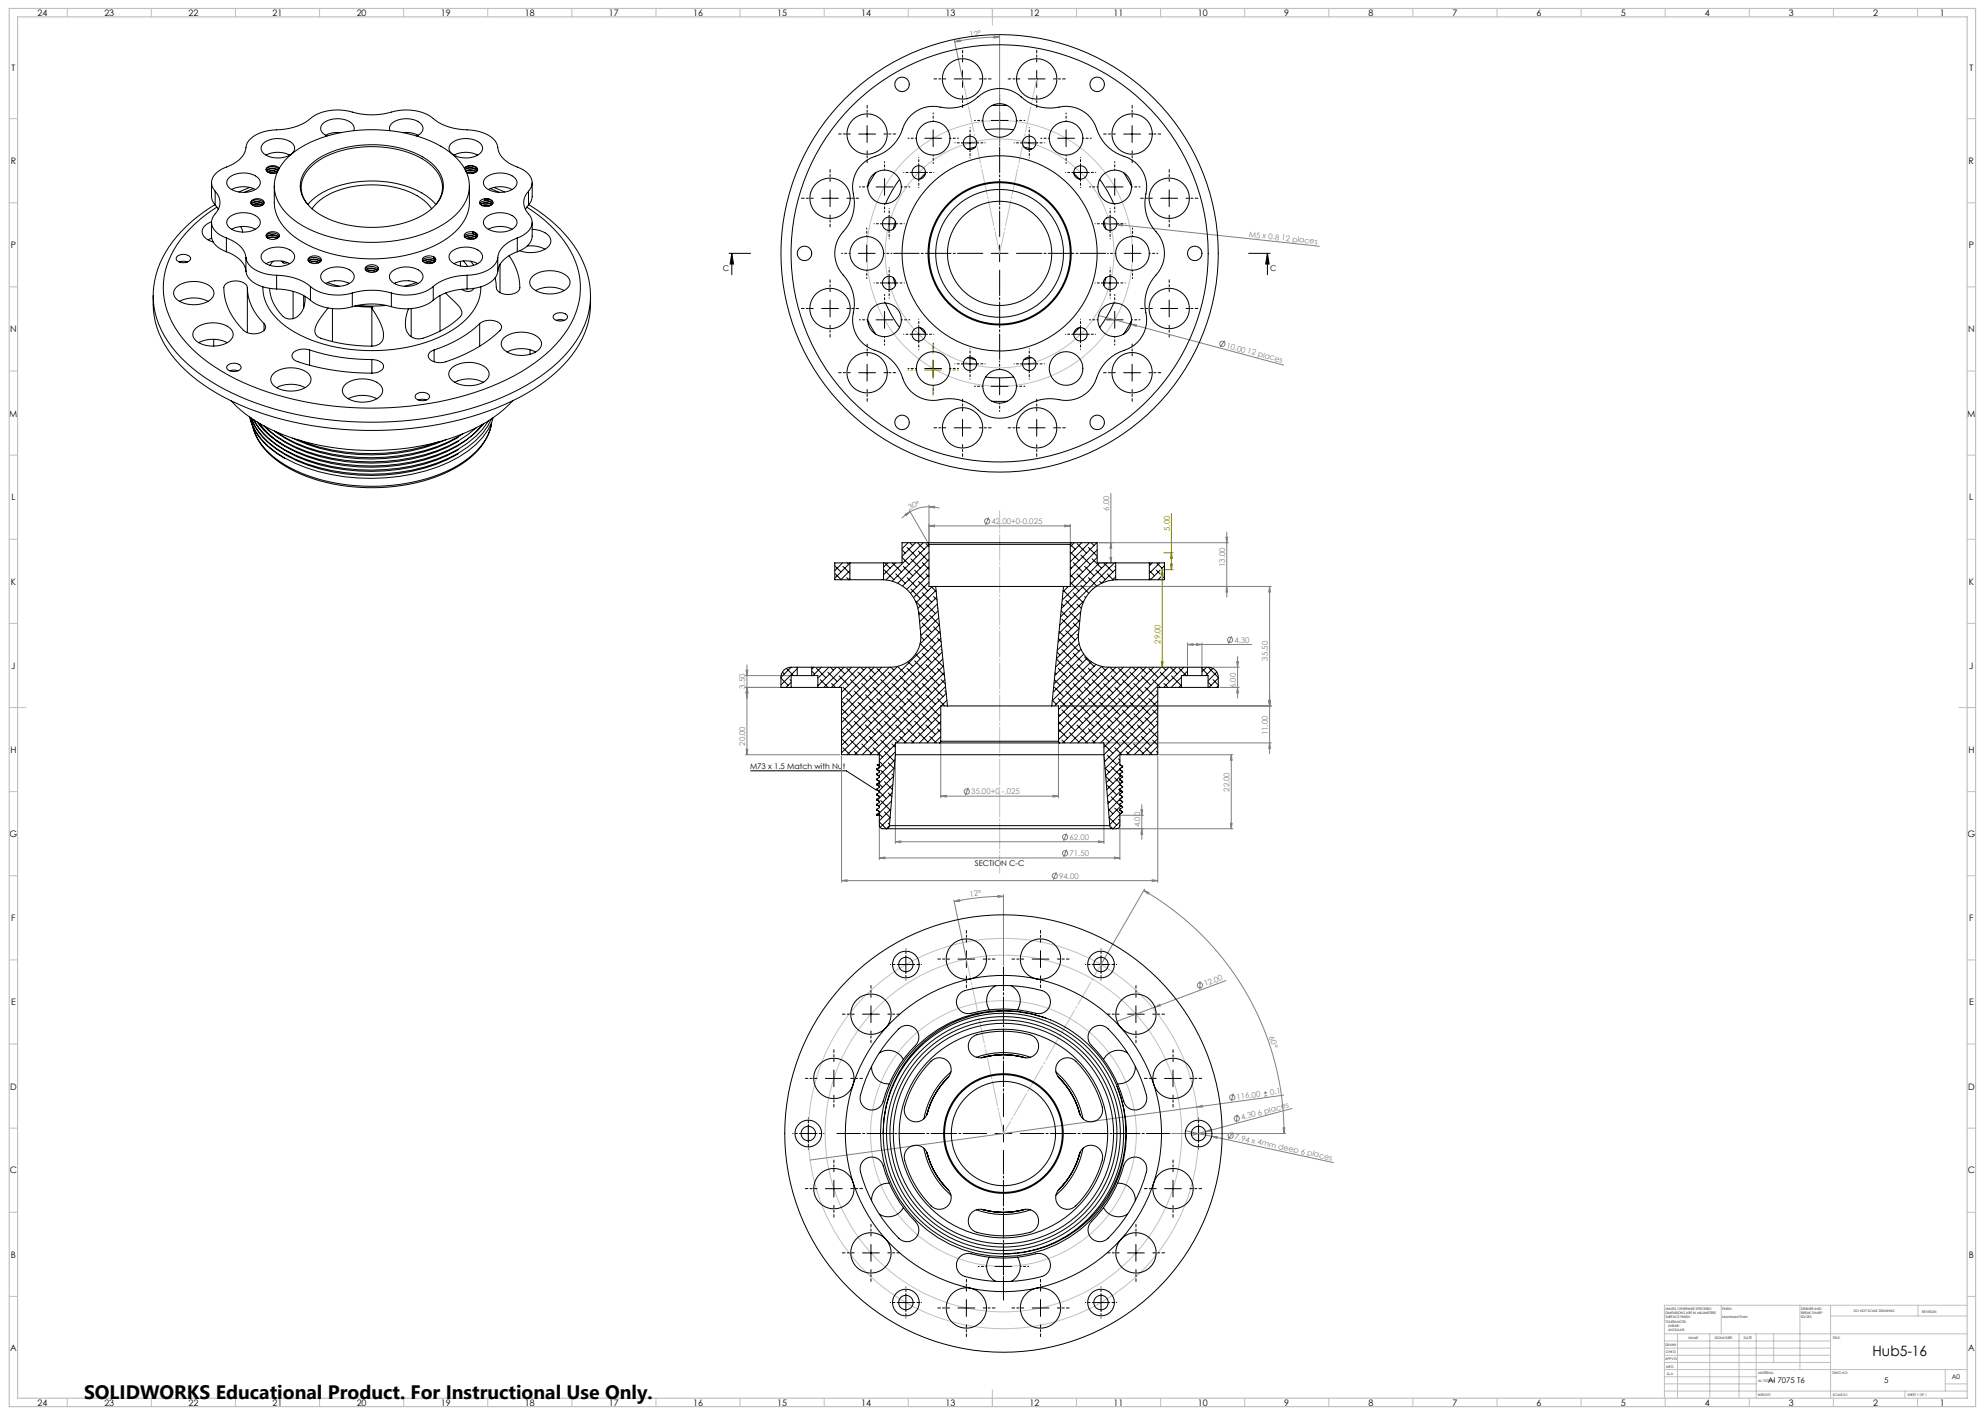
[picture p161: page 1]
4.30 6 places; 7.94 x 4mm deep 6 places; M5 x 0.8 12 places; 10.00 12 places; SECTION C-C; Machined Finish; DEBURR AND BREAK SHARP; DO NOT SCALE DRAWING; REVISION; SCALE:2:1; SHEET 1 OF 1

M73 x 1.5 Match with Nut

UNLESS OTHERWISE SPECIFIED:
DIMENSIONS ARE IN MILLIMETERS
SURFACE FINISH:
TOLERANCES:
LINEAR:
ANGULAR:

NAME | SIGNATURE | DATE | | | | TITLE: Hub5-16

SOLIDWORKS Educational Product. For Instructional Use Only.

DRAWN
CHK'D
APPV'D
MFG
Q.A | | | | MATERIAL: Al 7075 T6 AL 7075-T6 | DWG NO. 5 | A0
