GET-RAHS/2022-2024_Sockeye/Solar Car 2022-2024/Parts To Be Machined/Order #1/Drawings/Knuckle.pdf

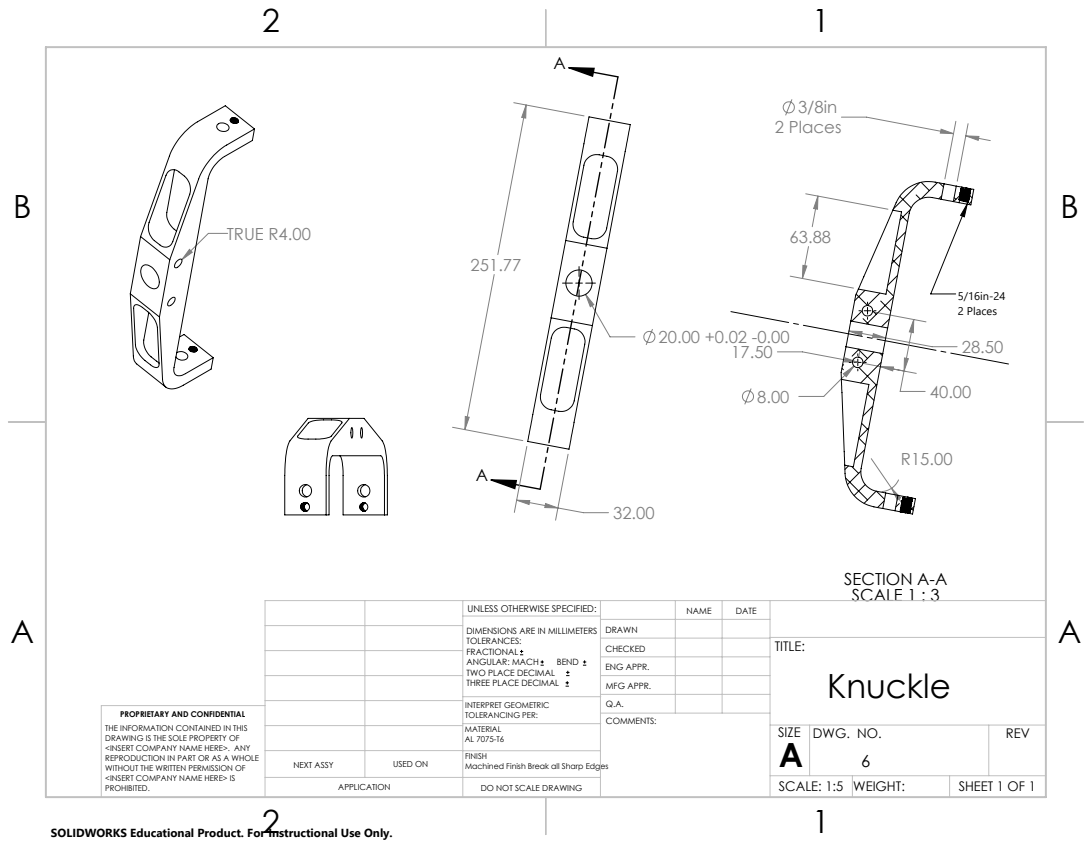
[picture p162: page 1]
TRUE R4.00; 2 Places; SECTION A-A SCALE 1 : 3

UNLESS OTHERWISE SPECIFIED: | | NAME | DATE
DIMENSIONS ARE IN MILLIMETERS TOLERANCES: FRACTIONAL ANGULAR: MACH BEND TWO PLACE DECIMAL THREE PLACE DECIMAL | DRAWN

CHECKED | | | TITLE: Knuckle

ENG APPR.
MFG APPR.

INTERPRET GEOMETRIC TOLERANCING PER: | Q.A.
MATERIAL AL 7075-T6 | | SIZE A | DWG. NO. 6 | REV

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

NEXT ASSY | USED ON | FINISH Machined Finish Break all Sharp Edges

APPLICATION | DO NOT SCALE DRAWING | | SCALE: 1:5 | WEIGHT: | SHEET 1 OF 1

SOLIDWORKS Educational Product. For Instructional Use Only.
