GET-RAHS/2022-2024_Sockeye/Solar Car 2022-2024/Parts To Be Machined/Order #1/Drawings/Longer Spindle_Light.pdf

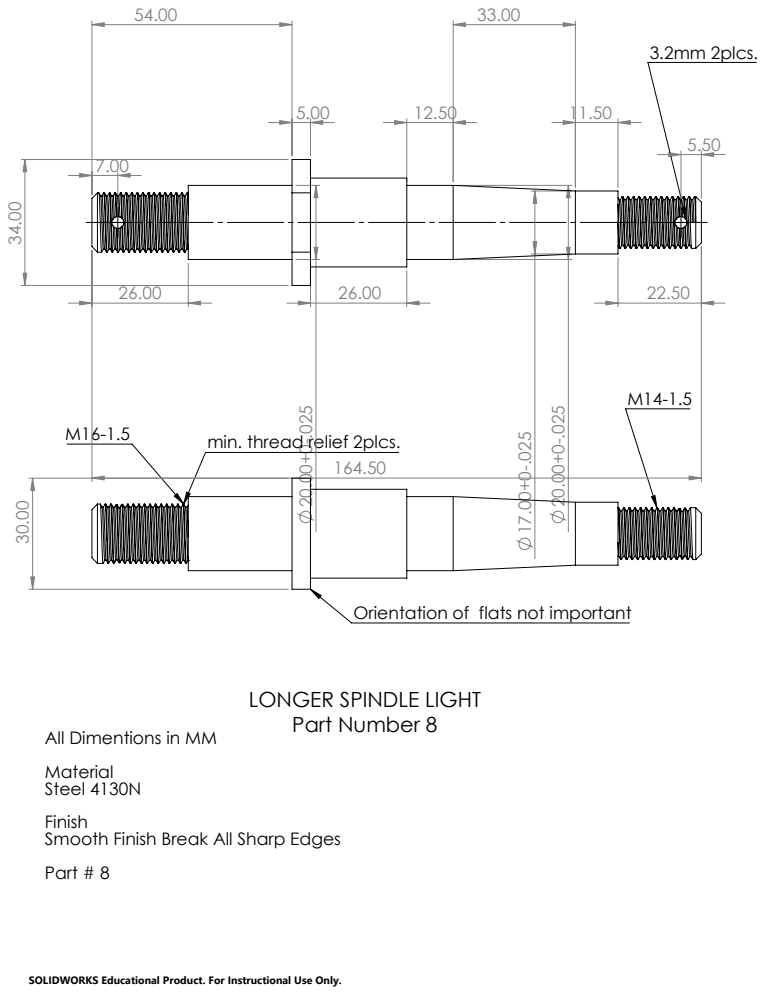
[picture p163: page 1]
3.2mm 2plcs.

min. thread relief 2plcs.

Orientation of flats not important

LONGER SPINDLE LIGHT

Part Number 8 All Dimentions in MM

Material
Steel 4130N
Finish
Smooth Finish Break All Sharp Edges
Part # 8

SOLIDWORKS Educational Product. For Instructional Use Only.
