GET-RAHS/2022-2024_Sockeye/Solar Car 2022-2024/Parts To Be Machined/Order #1/Drawings/Nut.pdf

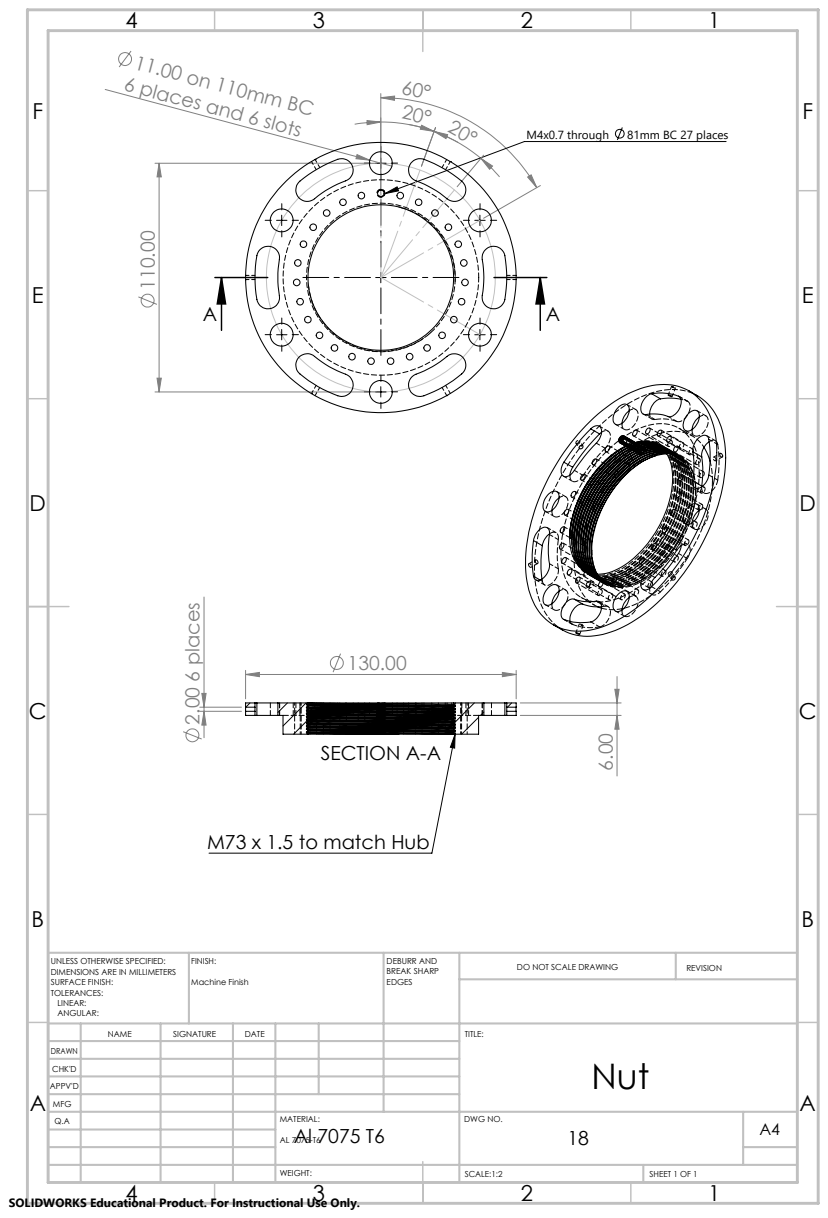
[picture p164: page 1]
2.00 6 places; SECTION A-A; Machine Finish; DEBURR AND BREAK SHARP; DO NOT SCALE DRAWING; REVISION; SCALE:1:2; SHEET 1 OF 1

6 places and 6 slots 110.00

M4x0.7 through 81mm BC 27 places

M73 x 1.5 to match Hub

UNLESS OTHERWISE SPECIFIED:
DIMENSIONS ARE IN MILLIMETERS
SURFACE FINISH:
TOLERANCES:
LINEAR:
ANGULAR:

NAME | SIGNATURE | DATE | | | | TITLE: Nut

DRAWN
CHK'D
APPV'D
MFG
Q.A | | | | MATERIAL: Al 7075 T6 AL 7075-T6 | DWG NO. 18 | A4

SOLIDWORKS Educational Product. For Instructional Use Only.
