GET-RAHS/2022-2024_Sockeye/Solar Car 2022-2024/Parts To Be Machined/Order #1/Drawings/Rear Cap insert.pdf

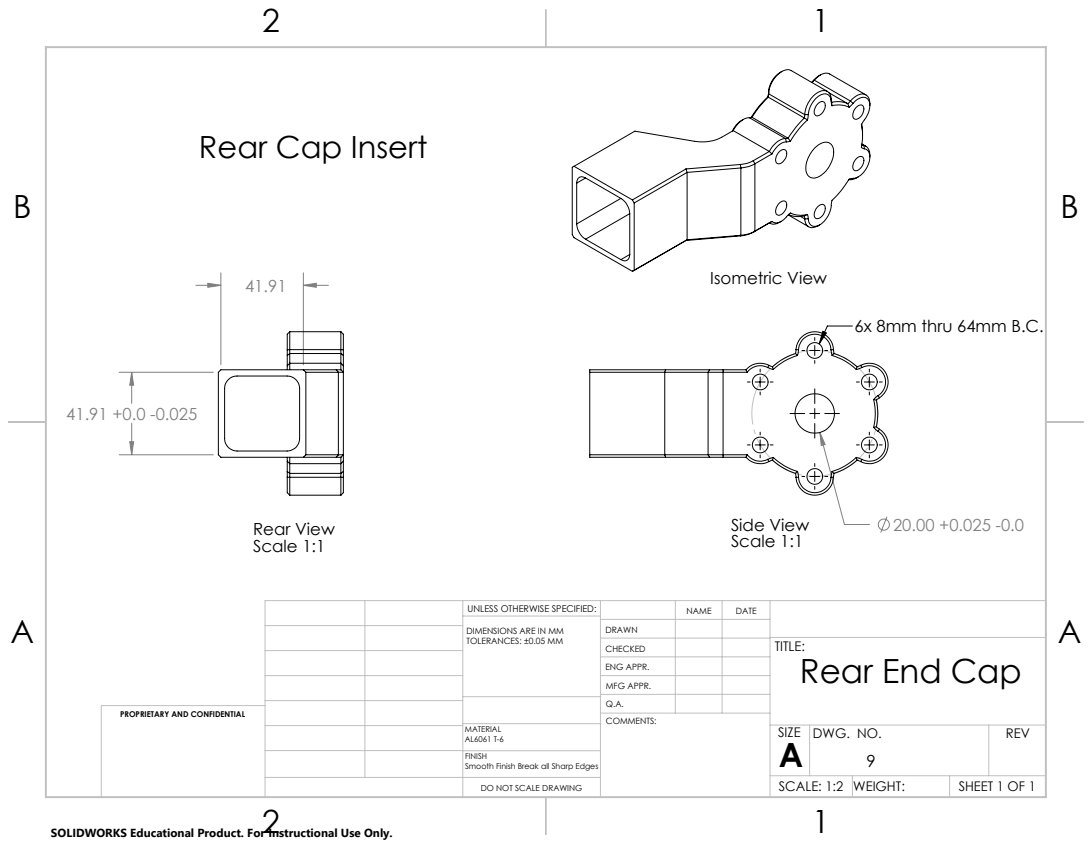
[picture p165: page 1]
Rear View Scale 1:1; 6x 8mm thru 64mm B.C.; Side View Scale 1:1; Isometric View

Rear Cap Insert

UNLESS OTHERWISE SPECIFIED: | | NAME | DATE
DIMENSIONS ARE IN MM TOLERANCES: ±0.05 MM | DRAWN

CHECKED | | | TITLE: Rear End Cap

ENG APPR.
MFG APPR.
Q.A.

PROPRIETARY AND CONFIDENTIAL

MATERIAL AL6061 T-6 | | SIZE A | DWG. NO. 9 | REV

FINISH Smooth Finish Break all Sharp Edges

DO NOT SCALE DRAWING | | SCALE: 1:2 | WEIGHT: | SHEET 1 OF 1

SOLIDWORKS Educational Product. For Instructional Use Only.
