GET-RAHS/2022-2024_Sockeye/Solar Car 2022-2024/Parts To Be Machined/Order #1/Drawings/Rear left Suspension Mount.pdf

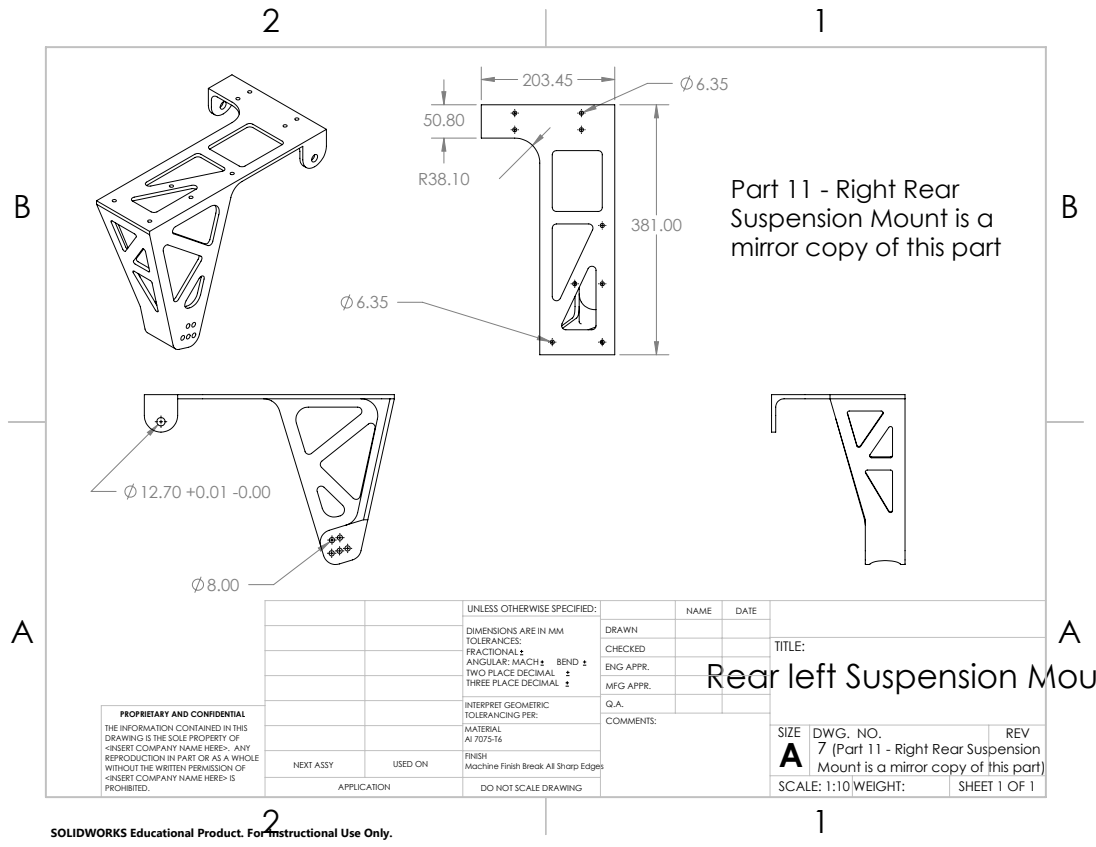
[picture p166: page 1]

Part 11 - Right Rear
Suspension Mount is a
mirror copy of this part

UNLESS OTHERWISE SPECIFIED: | | NAME | DATE
DIMENSIONS ARE IN MM TOLERANCES: FRACTIONAL ANGULAR: MACH BEND TWO PLACE DECIMAL THREE PLACE DECIMAL | DRAWN

CHECKED | | | TITLE:

Rear left Suspension Mount

ENG APPR.
MFG APPR.

INTERPRET GEOMETRIC TOLERANCING PER: | Q.A.
MATERIAL Al 7075-T6 | | SIZE A | DWG. NO. 7 (Part 11 - Right Rear Suspension Mount is a mirror copy of this part) | REV

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

NEXT ASSY | USED ON | FINISH Machine Finish Break All Sharp Edges

APPLICATION | DO NOT SCALE DRAWING | | SCALE: 1:10 WEIGHT: | | SHEET 1 OF 1

SOLIDWORKS Educational Product. For Instructional Use Only.
