GET-RAHS/2022-2024_Sockeye/Solar Car 2022-2024/Parts To Be Machined/Order #1/Drawings/Spindle_Light.pdf

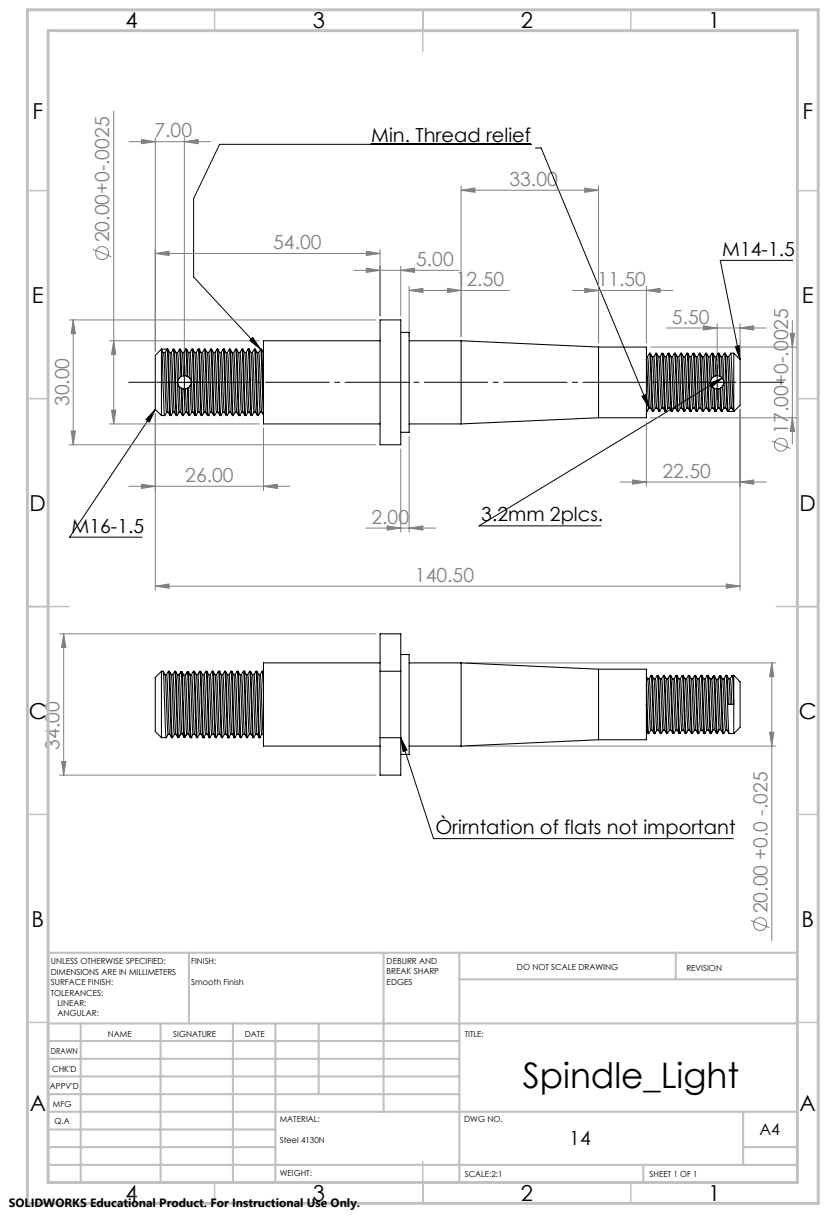
[picture p167: page 1]
3.2mm 2plcs.; Smooth Finish; DEBURR AND BREAK SHARP; DO NOT SCALE DRAWING; REVISION; SCALE:2:1; SHEET 1 OF 1

Min. Thread relief

Òrirntation of flats not important

UNLESS OTHERWISE SPECIFIED:
DIMENSIONS ARE IN MILLIMETERS
SURFACE FINISH:
TOLERANCES:
LINEAR:
ANGULAR:

NAME | SIGNATURE | DATE | | | | TITLE: Spindle_Light

DRAWN
CHK'D
APPV'D
MFG
Q.A | | | | MATERIAL: Steel 4130N | DWG NO. 14 | A4

SOLIDWORKS Educational Product. For Instructional Use Only.
