GET-RAHS/2022-2024_Sockeye/Solar Car 2022-2024/Parts To Be Machined/Order #1/Drawings/Steel Steering Spacer.pdf

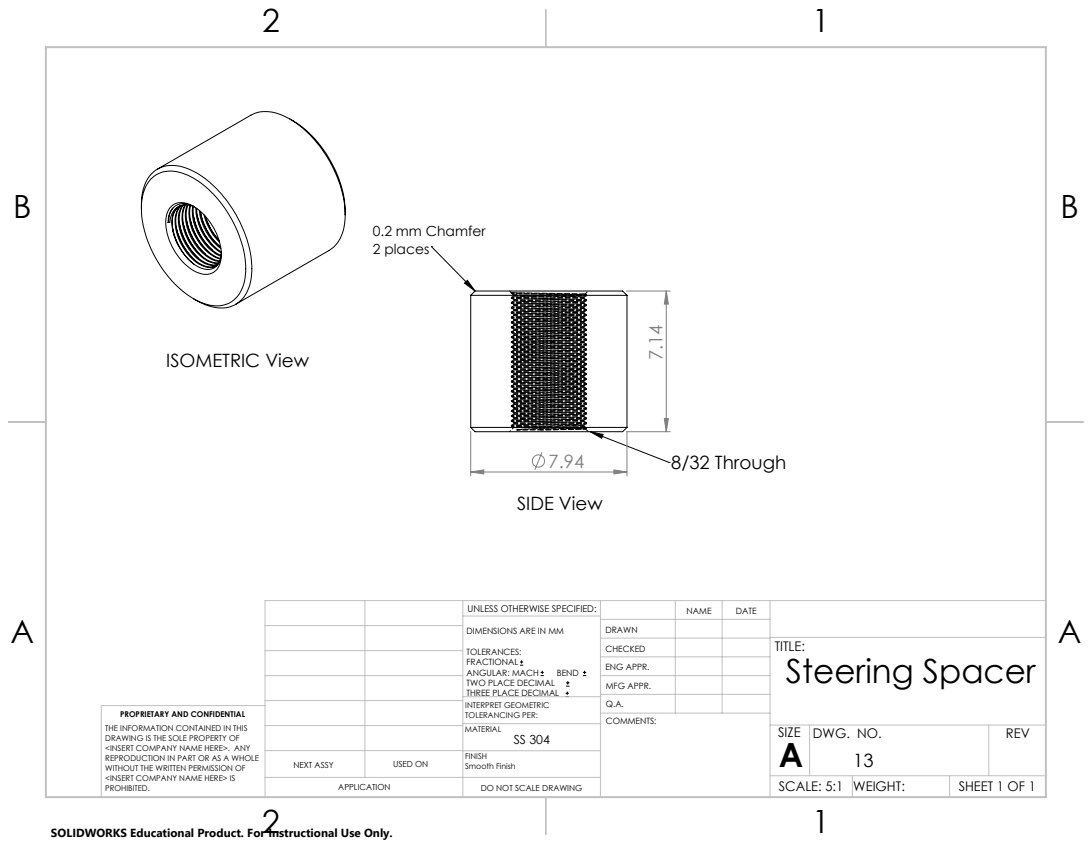
[picture p168: page 1]
ISOMETRIC View; 8/32 Through; 0.2 mm Chamfer 2 places; SIDE View

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

CHECKED | | | TITLE: Steering Spacer

ENG APPR.
MFG APPR.

INTERPRET GEOMETRIC TOLERANCING PER: | Q.A.
MATERIAL SS 304 | | SIZE A | DWG. NO. 13 | REV

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

NEXT ASSY | USED ON | FINISH Smooth Finish

APPLICATION | DO NOT SCALE DRAWING | | SCALE: 5:1 | WEIGHT: | SHEET 1 OF 1

SOLIDWORKS Educational Product. For Instructional Use Only.
