GET-RAHS/2022-2024_Sockeye/Solar Car 2022-2024/Parts To Be Machined/Order #1/Drawings/TopWishboneDrawing.pdf

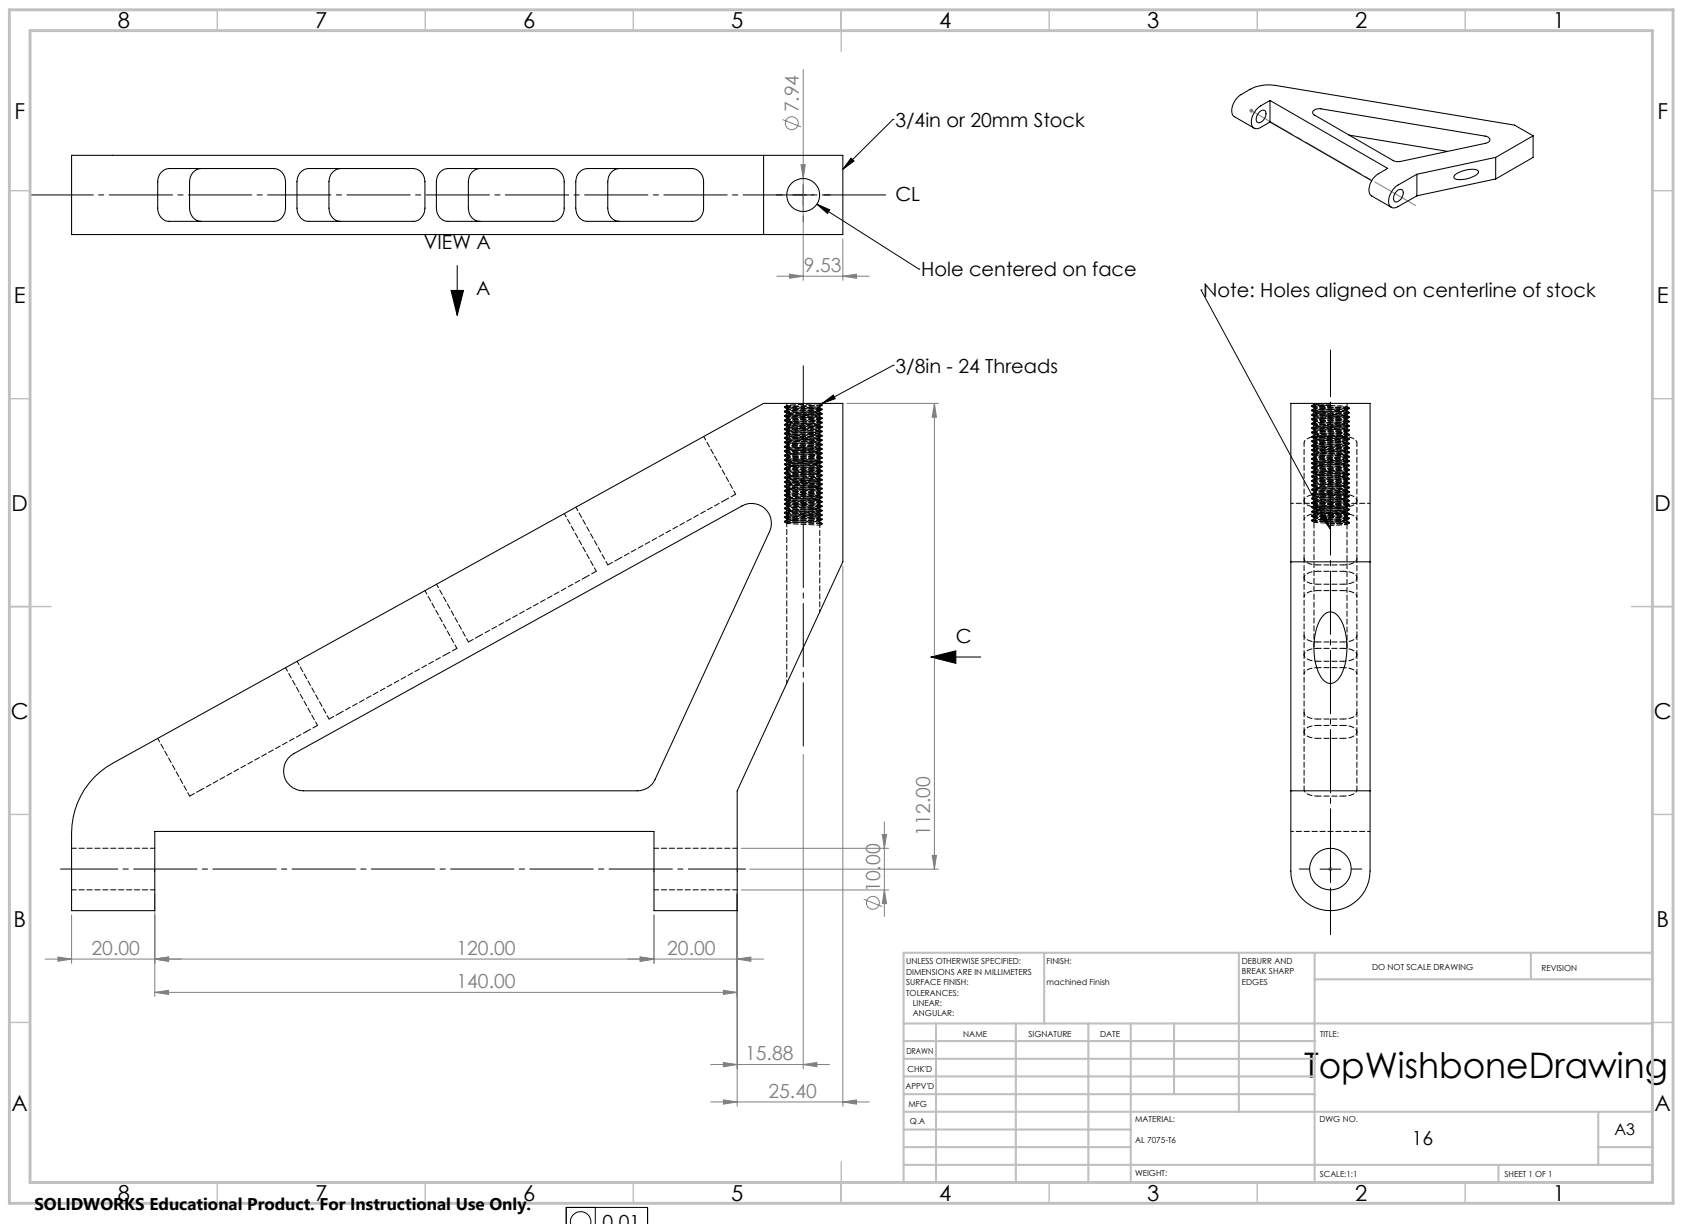
[picture p169: page 1]
3/8in - 24 Threads; VIEW A; 3/4in or 20mm Stock; machined Finish; DEBURR AND BREAK SHARP; DO NOT SCALE DRAWING; REVISION; SCALE:1:1; SHEET 1 OF 1

Hole centered on face

Note: Holes aligned on centerline of stock

UNLESS OTHERWISE SPECIFIED:
DIMENSIONS ARE IN MILLIMETERS
SURFACE FINISH:
TOLERANCES:
LINEAR:
ANGULAR:

NAME | SIGNATURE | DATE | | | TopWishboneDrawing | TITLE:

DRAWN
CHK'D
APPV'D
MFG
Q.A | | | | MATERIAL: AL 7075-T6 | DWG NO. 16 | A3

SOLIDWORKS Educational Product. For Instructional Use Only.
