GET-RAHS/2022-2024_Sockeye/Solar Car 2022-2024/Wheels/GHCraft Wheel.pdf

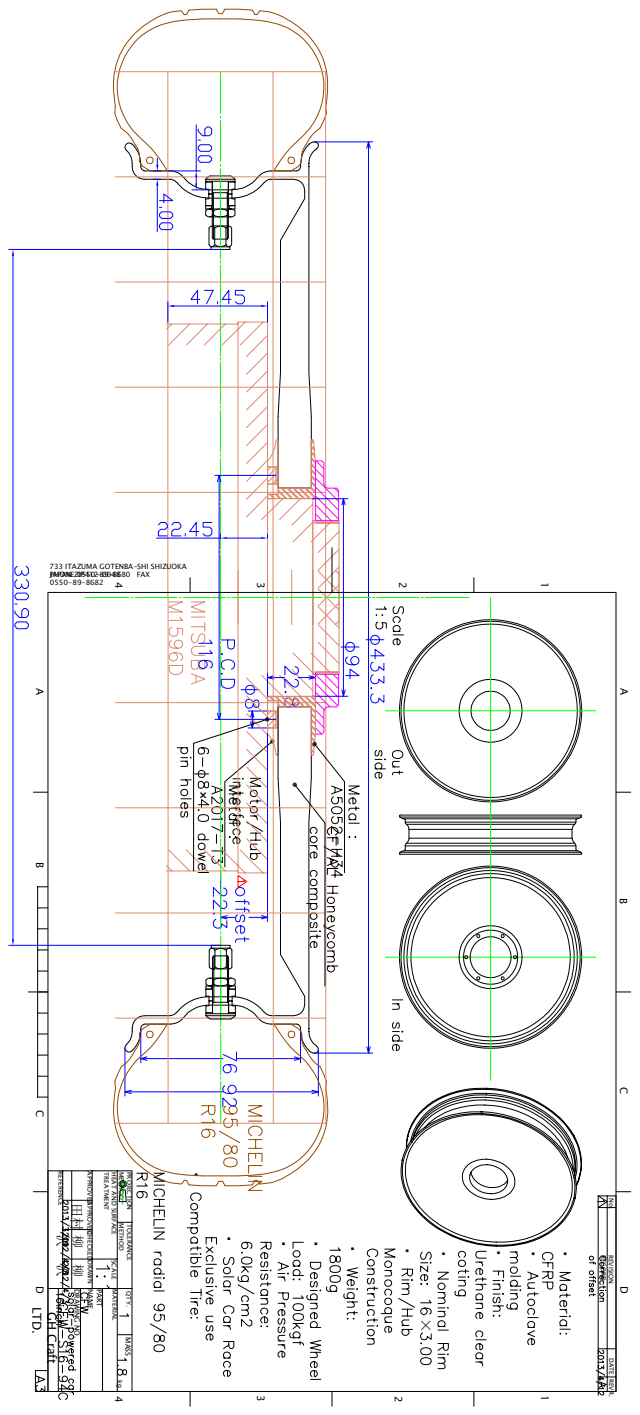
[picture p170: page 1]
JAPAN ZIP412-0048

733 ITAZUMA GOTENBA-SHI SHIZUOKA
PHONE 0550-89-8680 FAX 0550-89-8682

・ 田村 ・・・ ・ ・ ・・ × ・・ 沢柳 沢柳 × RECORD REVISION DATE REVR. No. NAME PART DRAWN METHOD PROJECTION CHECKED REFERENCE APPROVED SCALE QTY. MASS kg LTD. GH Craft METHOD TOLERANCE TREATMENT HEAT AND SURFACE MATERIAL APPROVED DRAWING NO. B 2 D A 321 4 4
