GET-RAHS/2022-2024_Sockeye/Solar Car 2022-2024/Wheels/rimmachined v13.2.pdf

12.69

G G

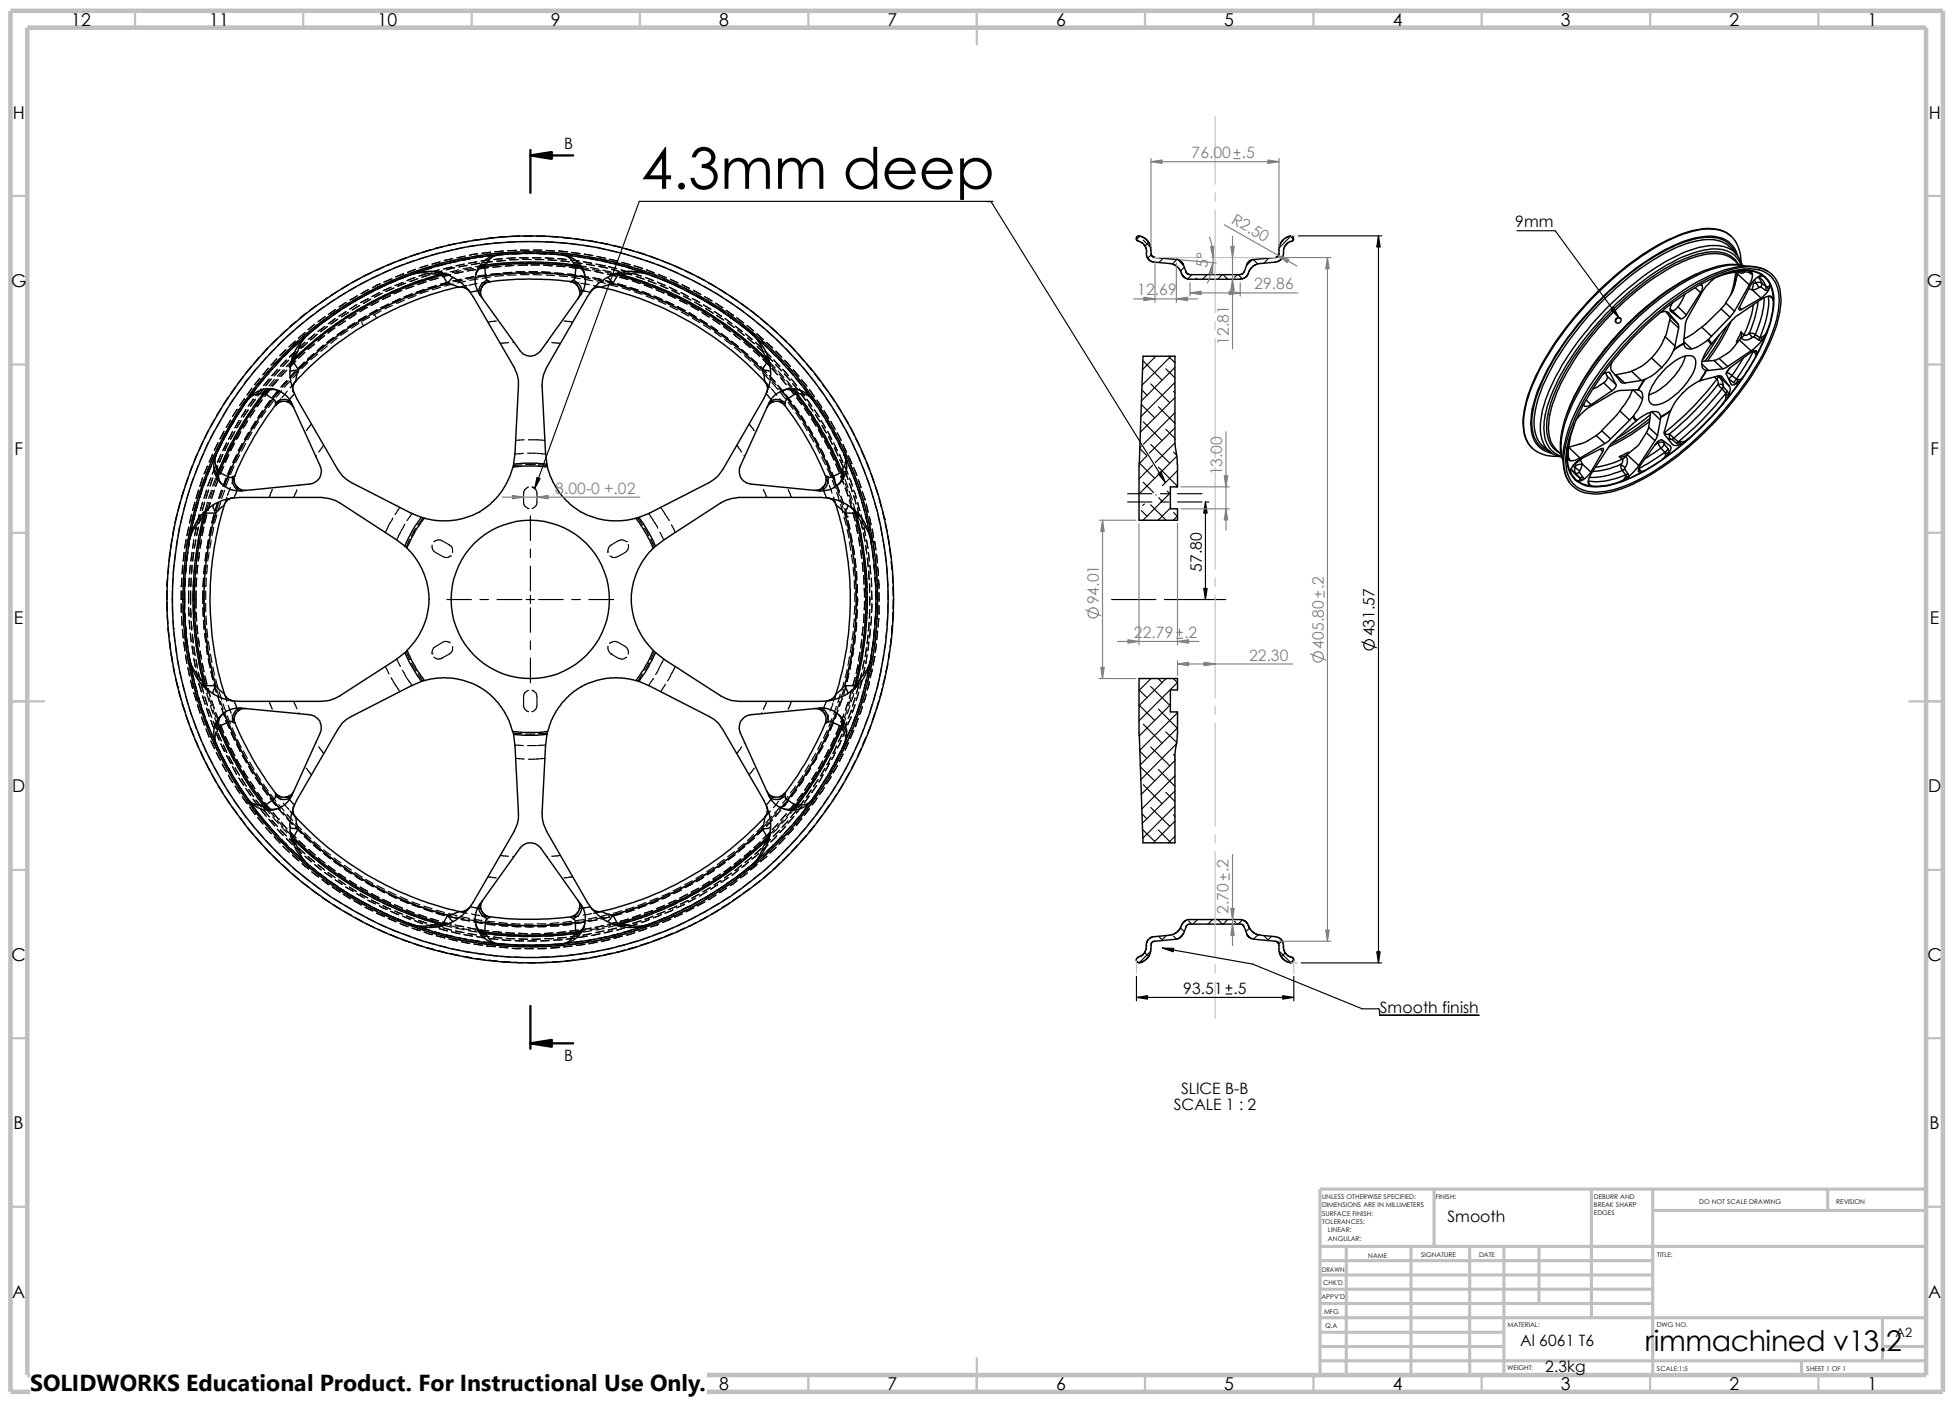
[picture p171: page 1]
REVISION; TITLE:; SHEET 1 OF 1; WEIGHT:; SCALE:1:5; SIGNATURE; DATE DRAWN; FINISH:; EDGES; NAME; DEBURR AND BREAK SHARP; Smooth; Smooth finish; 4.3mm deep; SLICE B-B; SCALE 1 : 2

UNLESS OTHERWISE SPECIFIED:
DIMENSIONS ARE IN MILLIMETERS
SURFACE FINISH:
TOLERANCES:
LINEAR:
ANGULAR:

DO NOT SCALE DRAWING

CHK'D
APPV'D
MFG
Q.A | MATERIAL: rimmachined v13.2 Al 6061 T6 | DWG NO. | A2

SOLIDWORKS Educational Product. For Instructional Use Only.
