GET-RAHS/2022-2024_Sockeye/Solar Car 2022-2024/Wheels/Alligt/PedilioAxleAlligt Achse hinten-2.PDF

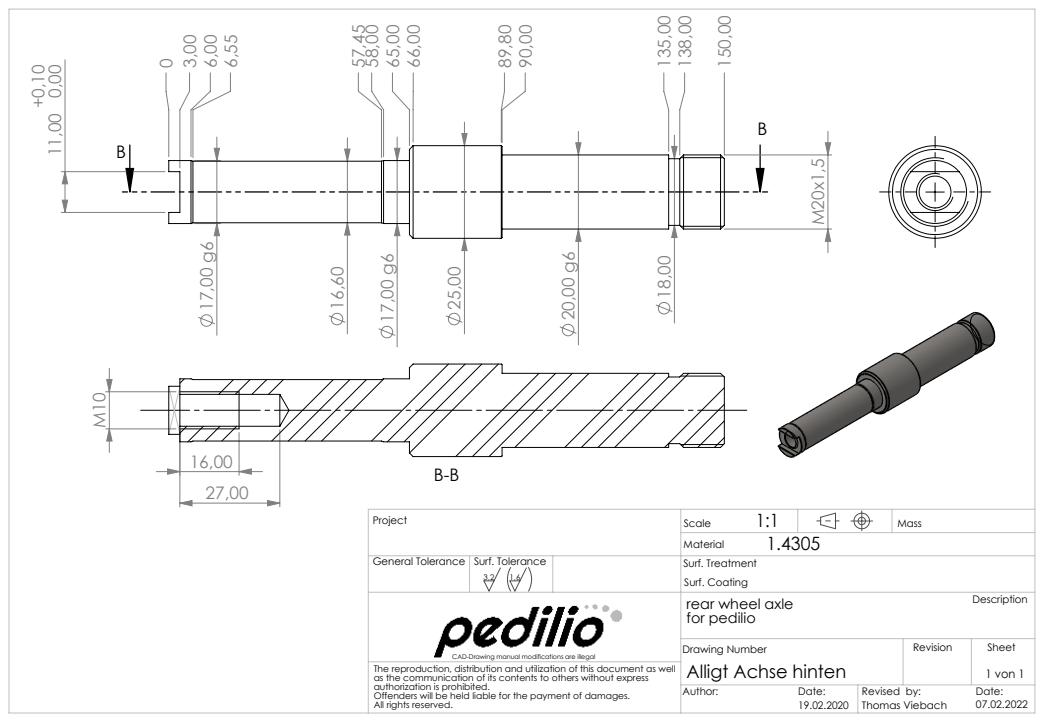
[picture p172: page 1]

General Tolerance | Surf. Tolerance 3,2 1,6 | | Surf. Treatment Surf. Coating

CAD-Drawing manual modifications are illegal | | | Description rear wheel axle for pedilio

Drawing Number Alligt Achse hinten | Revision | Sheet 1 von 1

The reproduction, distribution and utilization of this document as well
as the communication of its contents to others without express
authorization is prohibited.
Offenders will be held liable for the payment of damages.
All rights reserved.

Author: Date: 19.02.2020 | Revised by: Date: Thomas Viebach 07.02.2022
