GET-RAHS/2022-2024_Sockeye/Solar Car 2022-2024/Wheels/Alligt/PedilioWheelNutAlligt Radmutter.PDF

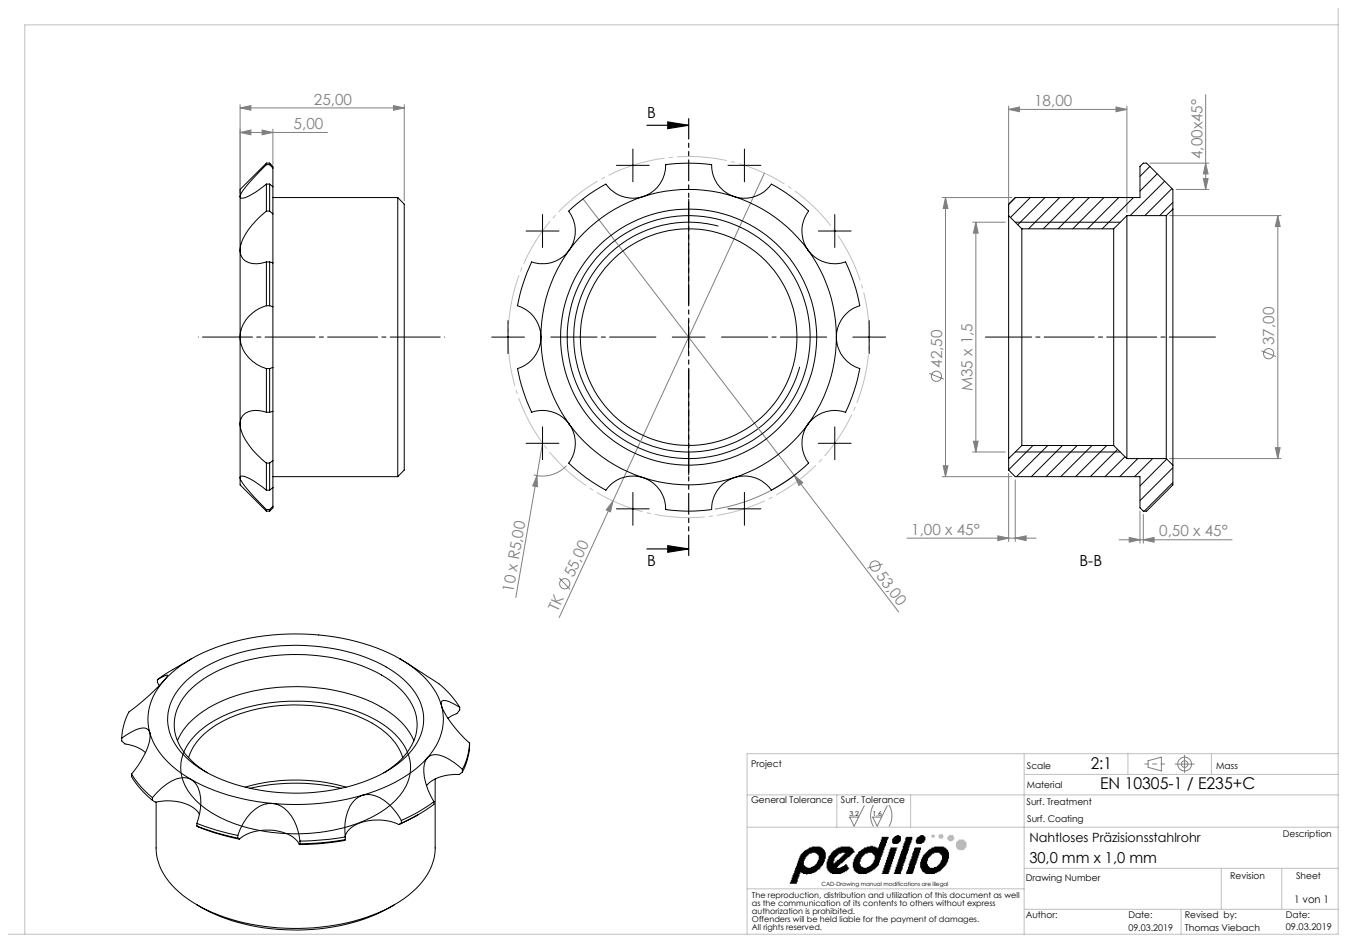
[picture p173: page 1]
Revised by: Thomas Viebach

General Tolerance | Surf. Tolerance 3,2 1,6 | | Surf. Treatment Surf. Coating

CAD-Drawing manual modifications are illegal | | | Description Nahtloses Präzisionsstahlrohr 30,0 mm x 1,0 mm

Drawing Number | Revision | Sheet

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
