GET-RAHS/2022-2024_Sockeye/Solar Car 2022-2024/Wheels/Wheels2023/Rim13.2Drawing.pdf

12.69

G G

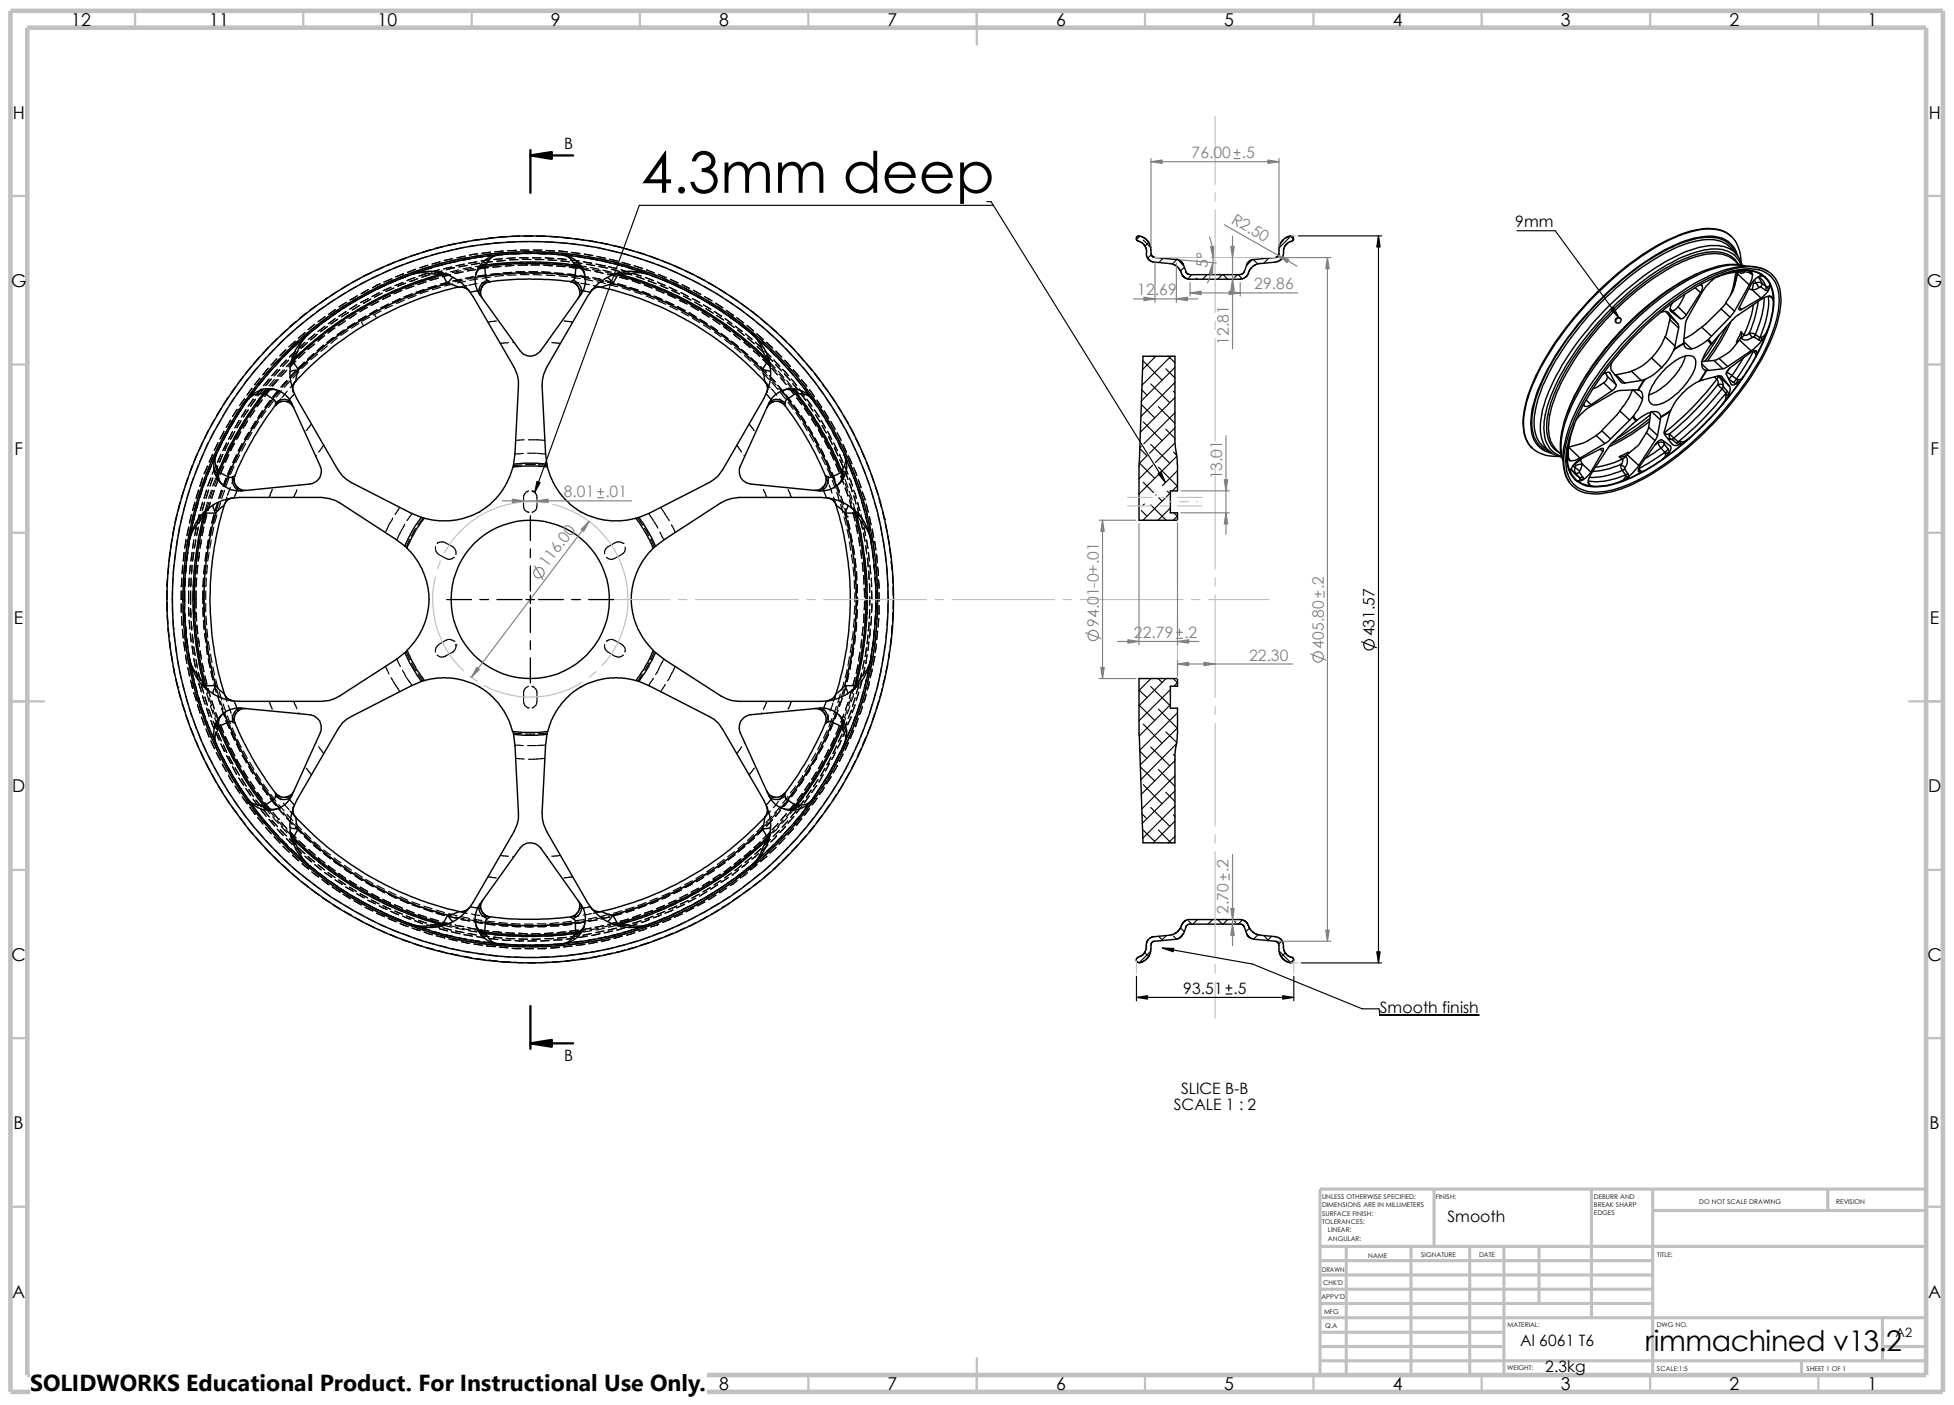
[picture p174: page 1]
WEIGHT:; SCALE:1:5; SHEET 1 OF 1; REVISION; FINISH:; EDGES; DEBURR AND BREAK SHARP; Smooth; Smooth finish; SLICE B-B; SCALE 1 : 2 .2 2.70; 4.3mm deep

DO NOT SCALE DRAWING UNLESS OTHERWISE SPECIFIED:
DIMENSIONS ARE IN MILLIMETERS
SURFACE FINISH:
TOLERANCES:
LINEAR:
ANGULAR:

NAME | SIGNATURE | DATE | | | | TITLE:

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

SOLIDWORKS Educational Product. For Instructional Use Only.
