GET-RAHS/2022-2024_Sockeye/Solar Car 2022-2024/Wheels/Wheels2023/rimmachined v13.2.pdf

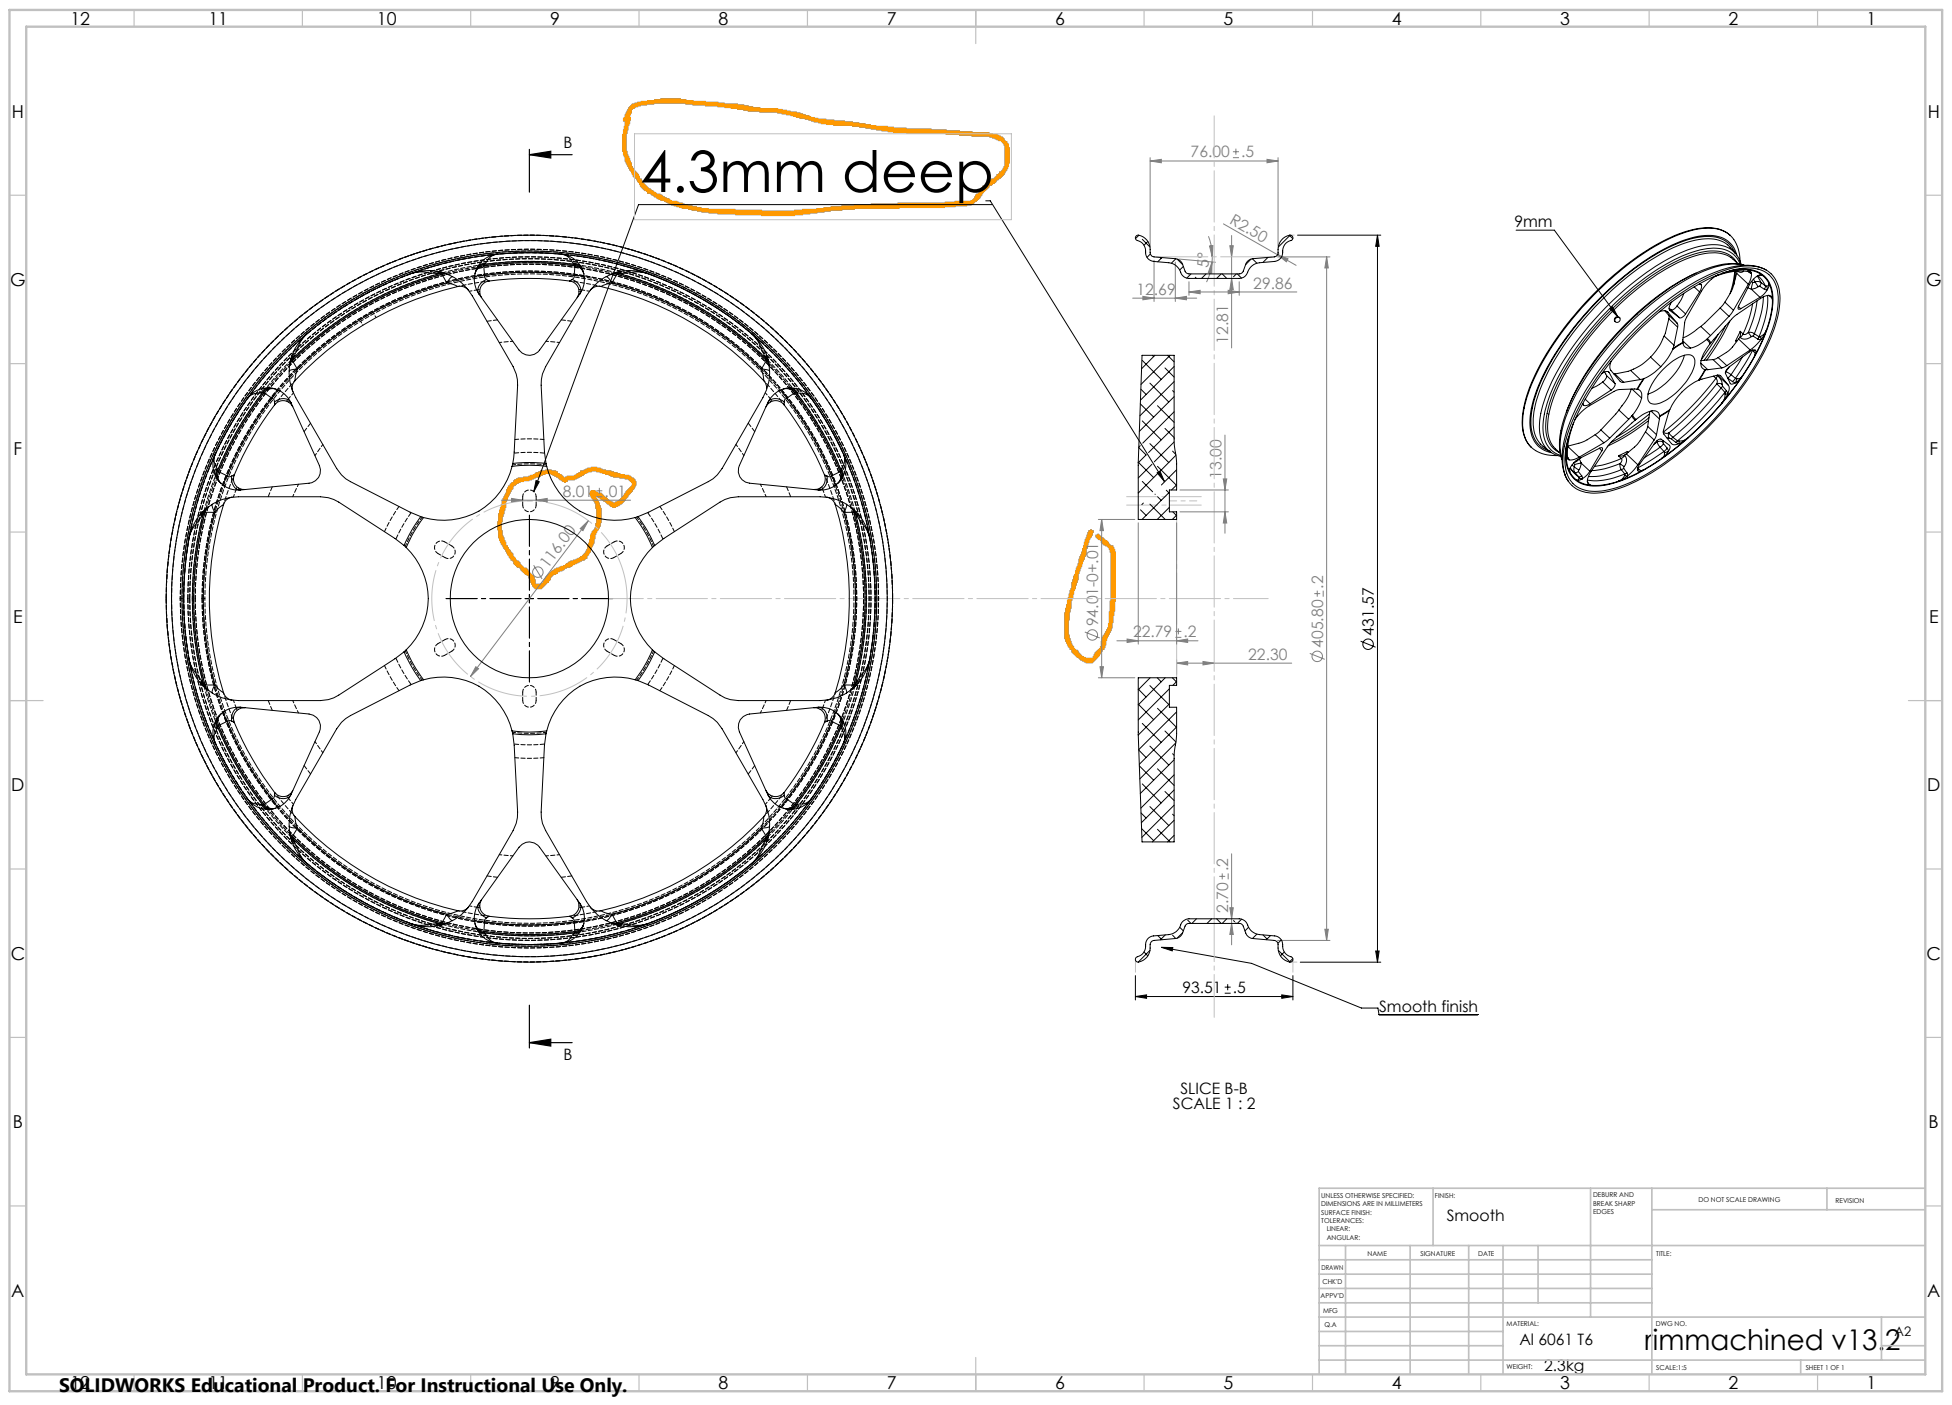
[picture p175: page 1]
4.3mm deep; SLICE B-B SCALE 1 : 2; Smooth finish; SCALE:1:5; SHEET 1 OF 1

UNLESS OTHERWISE SPECIFIED: DIMENSIONS ARE IN MILLIMETERS SURFACE FINISH: TOLERANCES: LINEAR: ANGULAR: | FINISH: Smooth | DEBURR AND BREAK SHARP EDGES | DO NOT SCALE DRAWING | REVISION

NAME | SIGNATURE | DATE | | | | TITLE:

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

SOLIDWORKS Educational Product. For Instructional Use Only.
