GET-RAHS/2022-2024_Sockeye/Solar Car 2022-2024/New Suspension/Front Suspension/Assy7/RackExtention.pdf

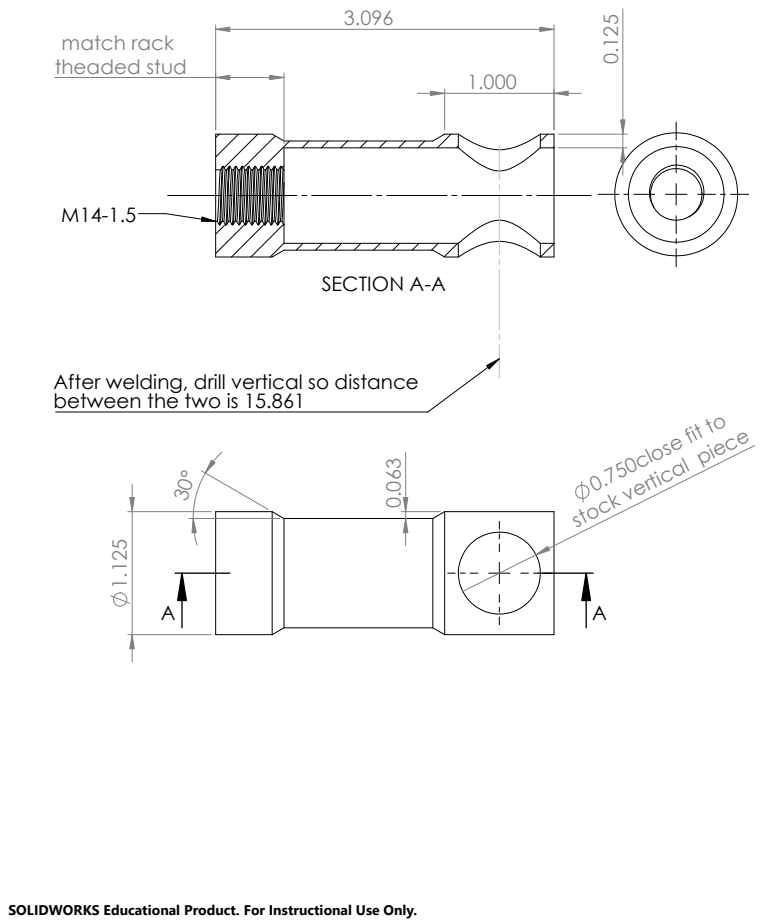
[picture p176: page 1]
0.750close fit to; SECTION A-A; match rack; theaded stud

After welding, drill vertical so distance
between the two is 15.861

stock vertical piece 0.063 1.125

SOLIDWORKS Educational Product. For Instructional Use Only.
