GET-RAHS/2022-2024_Sockeye/Solar Car 2022-2024/Parts To Be Machined/Order #1/Drawings/Rear End Cap.pdf

2

1

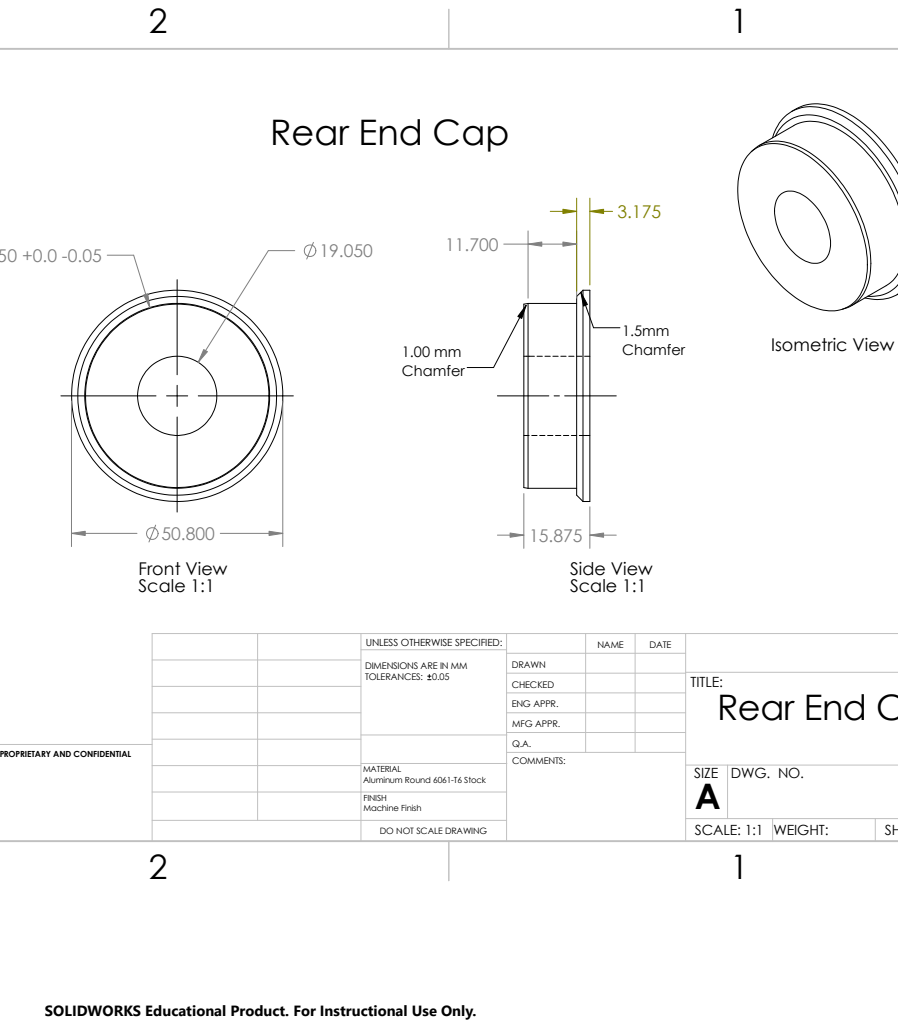
[picture p177: page 1]
DO NOT SCALE DRAWING; SHEET 1 OF 1; SCALE: 1:1; WEIGHT:; DWG. NO.; SIZE; TITLE:; NAME; DATE; COMMENTS:; Front View Scale 1:1; Side View Scale 1:1; Isometric View; Chamfer

Rear End Cap

UNLESS OTHERWISE SPECIFIED:

DIMENSIONS ARE IN MM TOLERANCES: 0.05 | DRAWN

CHECKED
ENG APPR.
MFG APPR.
Q.A.

PROPRIETARY AND CONFIDENTIAL

MATERIAL
Aluminum Round 6061-T6 Stock
FINISH
Machine Finish

SOLIDWORKS Educational Product. For Instructional Use Only.
