GET-RAHS/2022-2024_Sockeye/Solar Car 2022-2024/Frame/carbonSquareTube.pdf

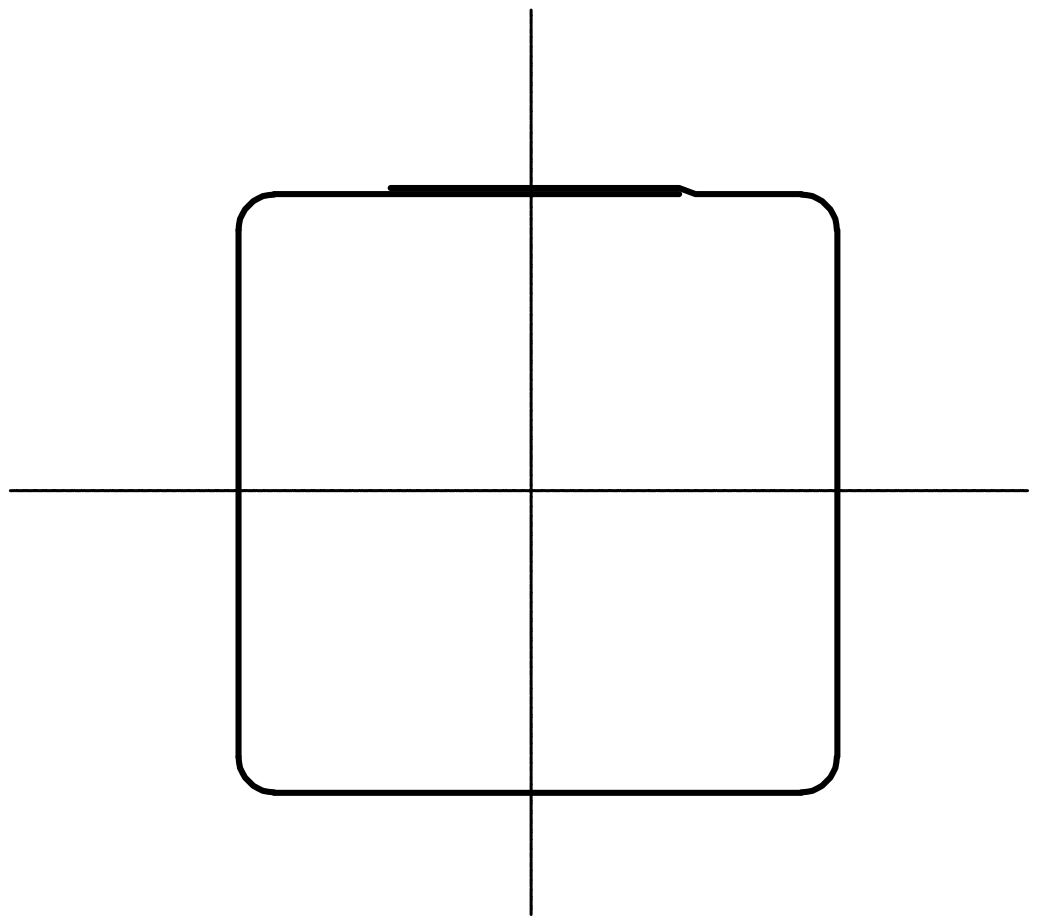
[picture p178: page 1]
