GET-RAHS/2022-2024_Sockeye/Solar Car 2022-2024/Wheels/M2096D_size.pdf

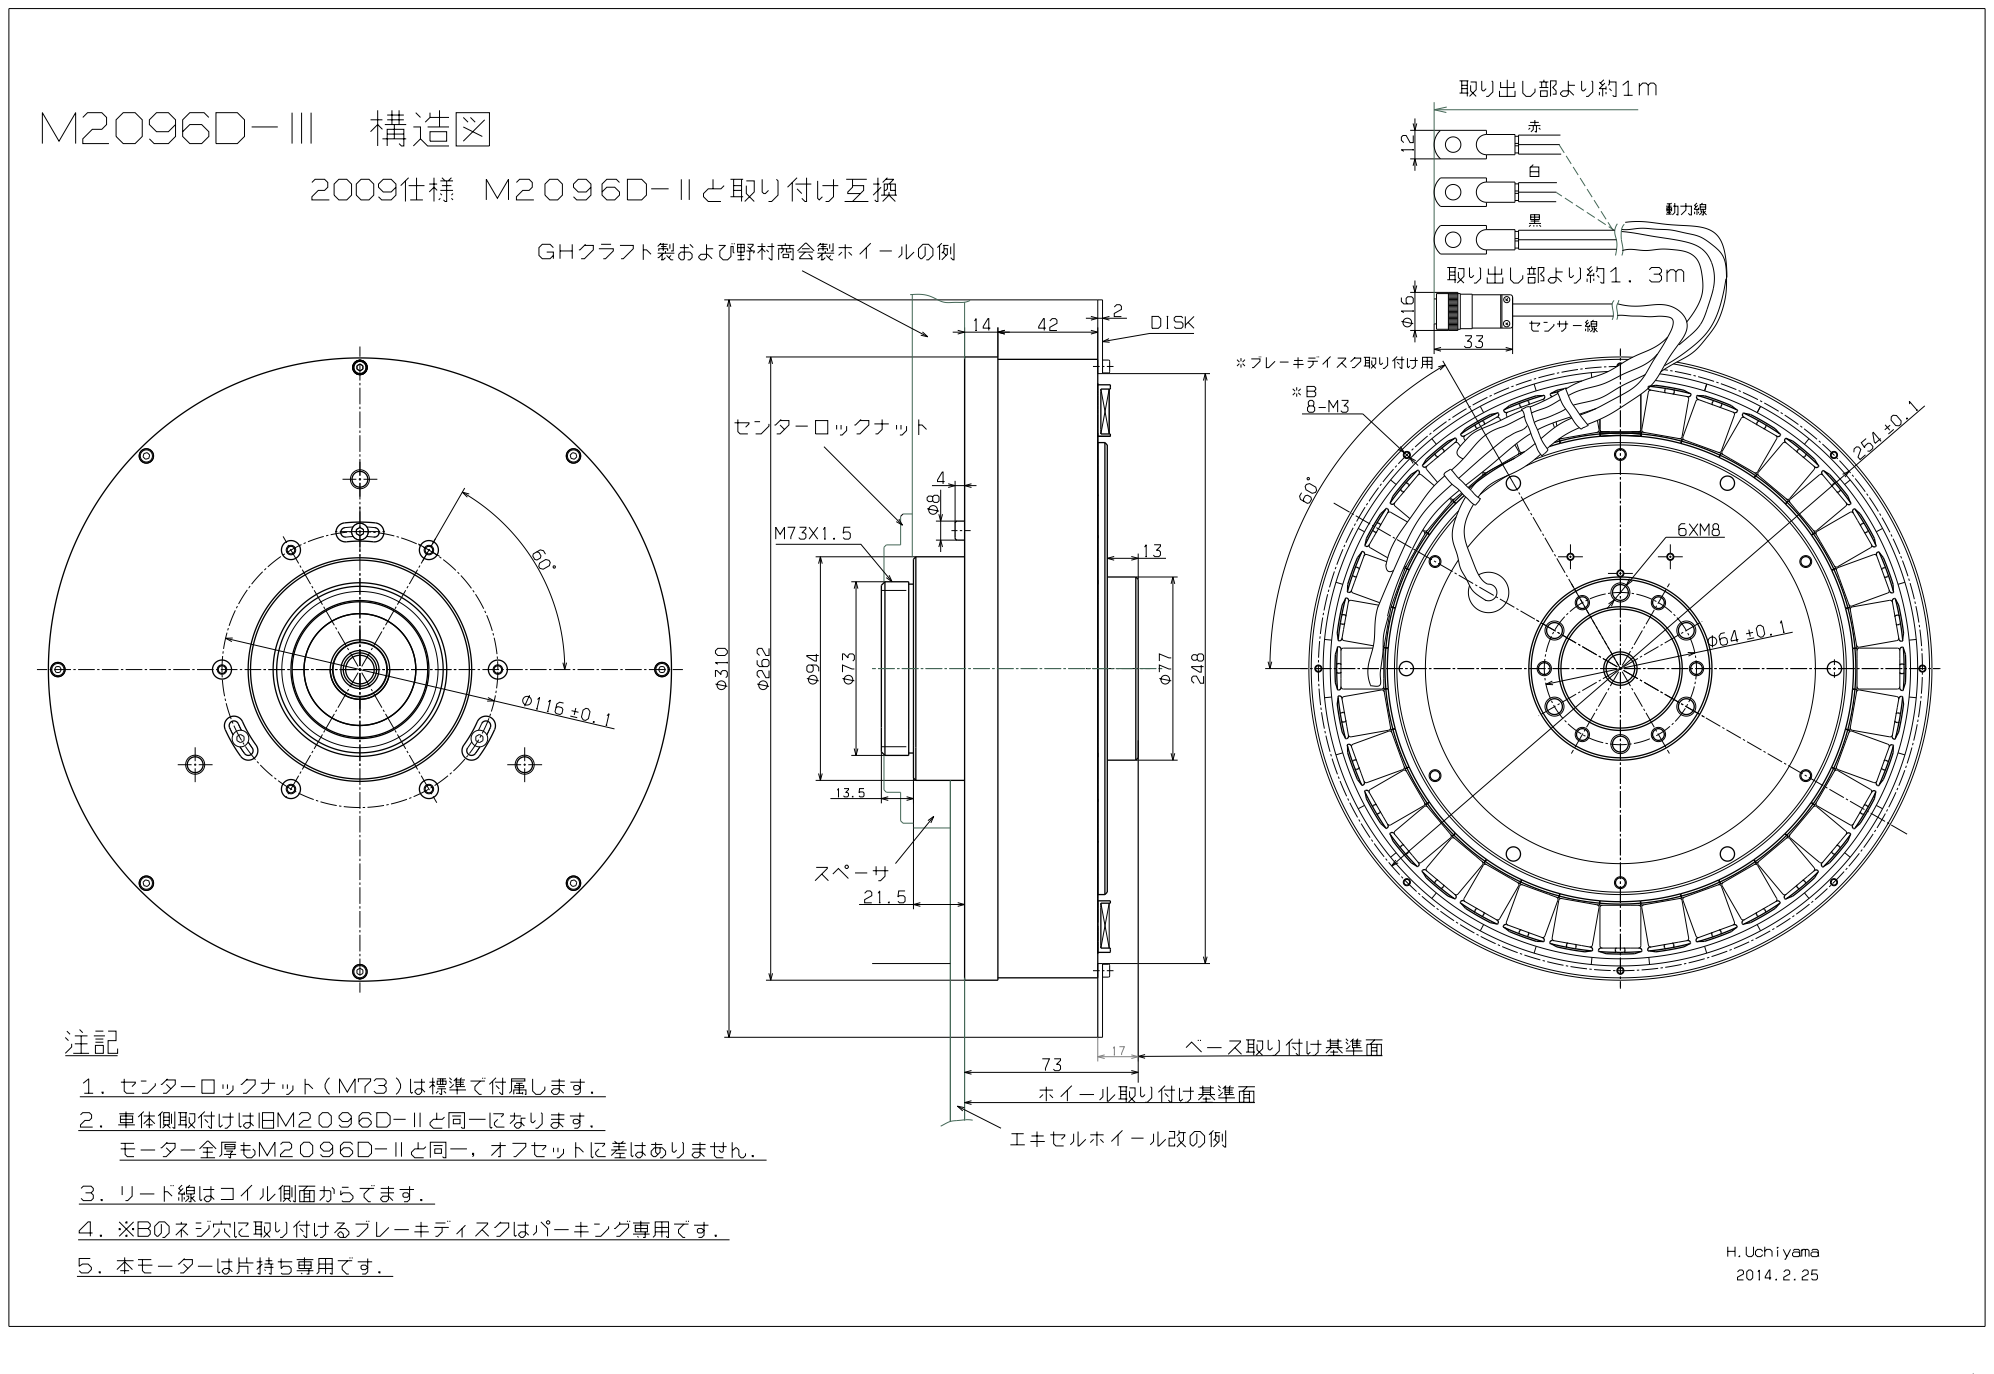
[picture p179: page 1]
