GET-RAHS/2022-2024_Sockeye/Solar Car 2022-2024/Wheels/Alligt/AxleWasherPedilioAlligt Unterlegscheibe Achse.PDF

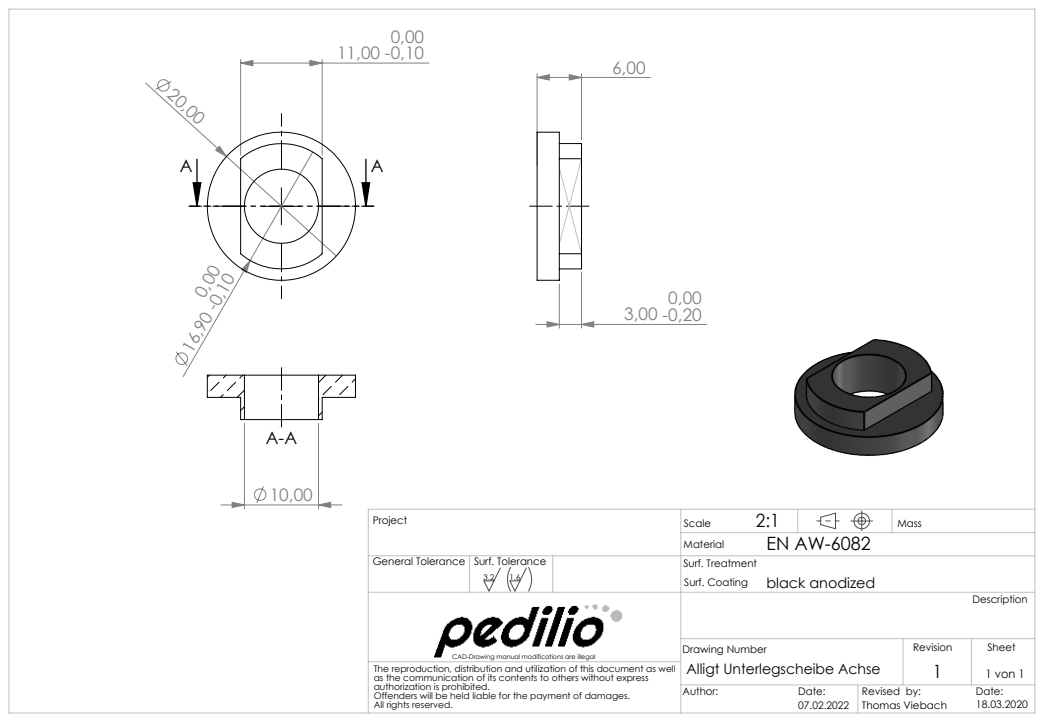
[picture p180: page 1]

General Tolerance | Surf. Tolerance 3,2 1,6 | | Surf. Treatment Surf. Coating black anodized

CAD-Drawing manual modifications are illegal | | | Description

Drawing Number Alligt Unterlegscheibe Achse | Revision 1 | Sheet 1 von 1

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

Author: Date: 07.02.2022 | Revised by: Date: Thomas Viebach 18.03.2020
