GET-RAHS/2022-2024_Sockeye/Solar Car 2022-2024/Wheels/Alligt/HubAxleAssyPedilioBaugruppe Alligt Nabe+Achse.PDF

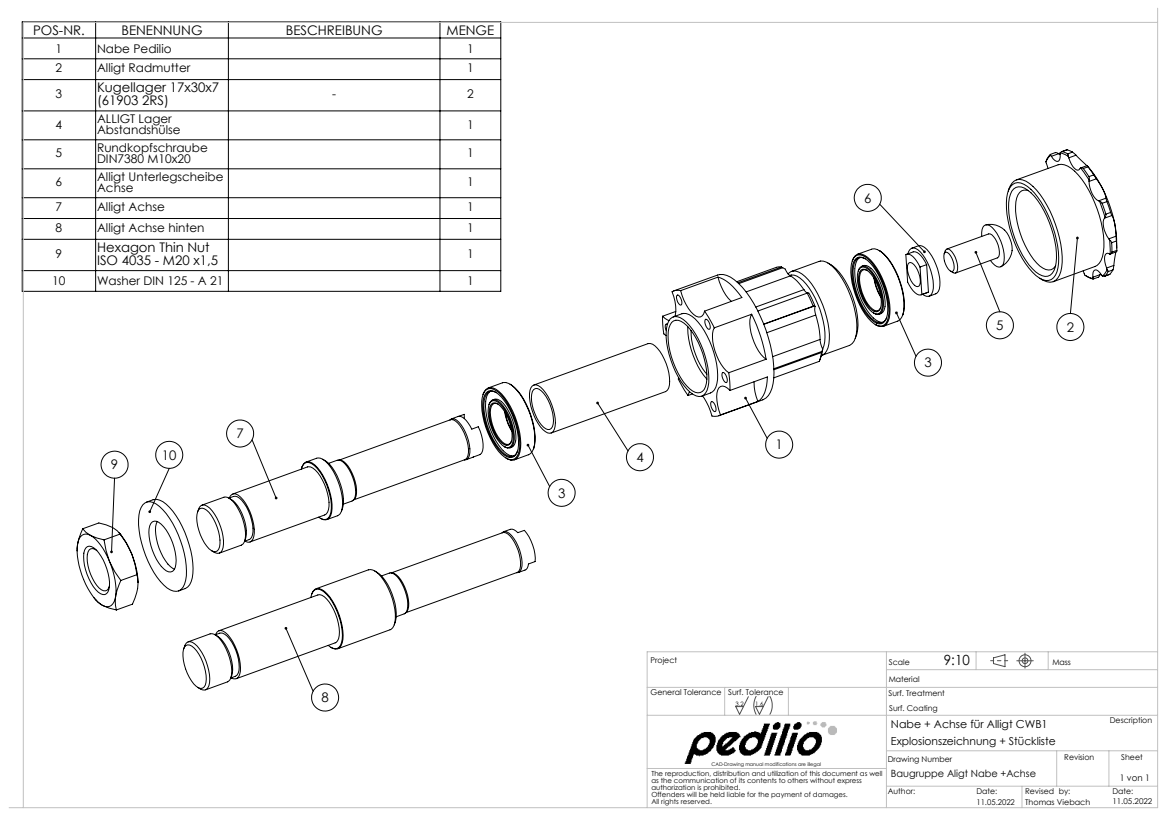
[picture p181: page 1]
Revised by: Thomas Viebach

POS-NR. | BENENNUNG | BESCHREIBUNG | MENGE
1 | Nabe Pedilio | | 1
2 | Alligt Radmutter | | 1
3 | Kugellager 17x30x7 (61903 2RS) | - | 2

4 | ALLIGT Lager Abstandshülse | | 1
5 | Rundkopfschraube DIN7380 M10x20 | | 1
6 | Alligt Unterlegscheibe Achse | | 1
7 | Alligt Achse | | 1
8 | Alligt Achse hinten | | 1
9 | Hexagon Thin Nut ISO 4035 - M20 x1,5 | | 1

10 | Washer DIN 125 - A 21 | | 1

General Tolerance | Surf. Tolerance 3,2 1,6 | | Surf. Treatment Surf. Coating

CAD-Drawing manual modifications are illegal | | | Description Nabe + Achse für Alligt CWB1 Explosionszeichnung + Stückliste

Drawing Number Baugruppe Aligt Nabe +Achse | Revision | Sheet

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
