GET-RAHS/2022-2024_Sockeye/Solar Car 2022-2024/New Suspension/Front Suspension/Assy7/CouplingNut.pdf

2.75

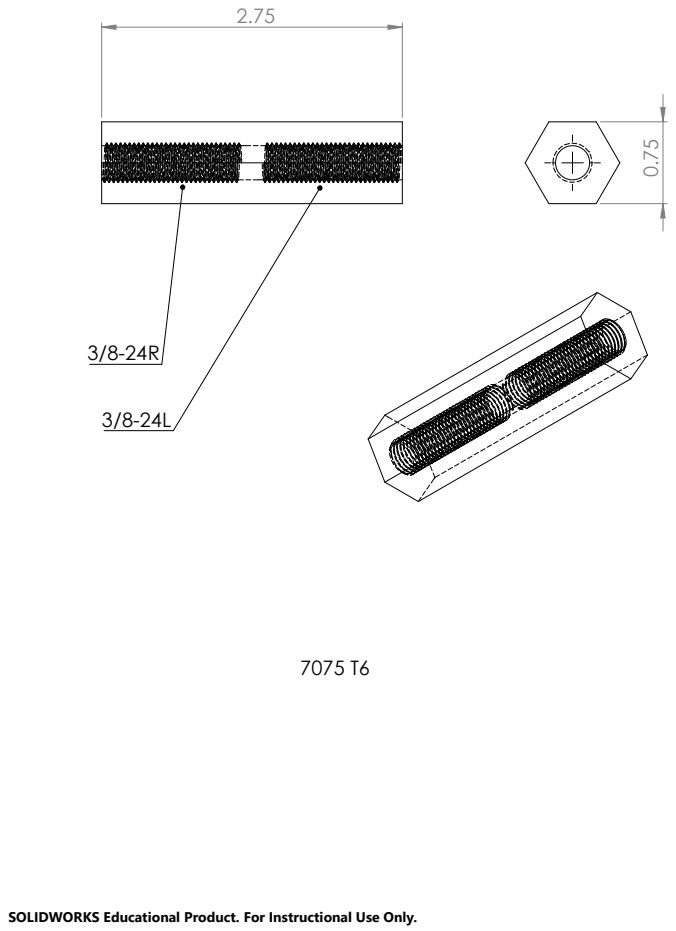
[picture p182: page 1]

SOLIDWORKS Educational Product. For Instructional Use Only.
