GET-RAHS/2022-2024_Sockeye/Solar Car 2022-2024/New Suspension/Front Suspension/Assy7/VericalRack.pdf

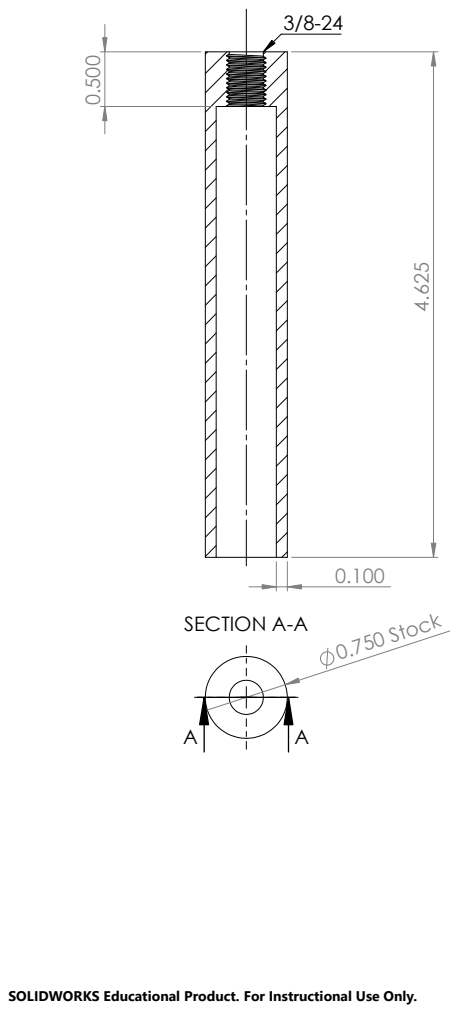
[picture p183: page 1]
SECTION A-A; 0.750 Stock

SOLIDWORKS Educational Product. For Instructional Use Only.
