GET-RAHS/2022-2024_Sockeye/(commit log)

2023-11-03 Solar cell foil tab design start
    [TapeSolarCells.dwg]
2023-11-06 Create tape holes.pdf
2023-11-08 Created an air filter mount to stop it from rubbing against the wheel.
    [air filter mount.SLDPRT]
2023-11-14 Changed file name to 2022-2024, updated solar panel tape
    [-5.SLDPRT, -5linearRJI-01-08.SLDPRT, -75.SLDPRT, -75linearRJI-01-12.SLDPRT, 0.25 Insert.SLDPRT, 0.375 Insert.SLDPRT, 03-8 98029A046_Black-Oxide Steel Oversized Washer.SLDPRT, 03-8-24 swivel.SLDPRT]
2023-12-18 made magnet mounts for wheel covers
    [magnet mountn for wheel covers.SLDPRT, magnet mountn for wheel covers.STL]
2024-01-04 wheel covers
    [magnet mountn for wheel covers.SLDPRT, magnet mountn for wheel covers.STL]
2024-01-16 added estop mount
    [Estop mount-hat v2.STL, Estop mount-hat.SLDPRT, Estop mount-hat.STL]
